davinciucberkeley-collab/DillonVTOL/cad/README.md

# CAD and simulation

Everything here is generated from `analysis/results.json` and `cad/hardware.json`. After changing the sizing or the hardware spec, re-run the build and the CAD follows. Nothing is modelled by hand.

## Files

| File | Purpose |
|---|---|
| `params.mjs` | Converts the sizing results and `hardware.json` into build parameters, fastener definitions, the fastener schedule, every component placement (position + rotation matrix) and the exploded layout → `params.txt` |
| `hardware.json` | Machine-readable twin of `docs/research/hardware-spec.md`: fasteners, nuts, washers, inserts, fits, general tolerances (same IDs as the spec and the drawings) |
| `BuildVtol.cs` | SOLIDWORKS API builder: 75 unique part files (`verification.txt` 2026-11-01), the 397-component `VTOL_Concept.SLDASM` (STEP, EASM), `VTOL_Exploded.SLDASM`, interference detection and mass roll-up → `verification.txt` |
| `build.ps1` | Runs `params.mjs`, then compiles and runs the builder, mesh export, drawings and renders (needs SOLIDWORKS 2025 + .NET Framework 4 `csc`) |
| `Drawings.cs` | Builds drawing DBF-DRW-001 rev G (nine ANSI B sheets, see below) with driven dimensions, tolerances and fits from `params.txt` (note text included: every size that follows the sizing is read from `params.txt`); zoned layout with a self-check of overlaps (`drawings/layout-check.txt`); exports `.SLDDRW`, a vector PDF and sheet PNGs to `drawings/`. `Drawings.exe model drawings params.txt 2,3` builds only the listed sheets as `probe_*` files for layout iteration |
| `Shared.cs` | Compiled into `BuildVtol.exe`, `Drawings.exe`, `Sim.exe` and `Thermal.exe`: `ParamsFile`, the one C# reader of `params.txt`, and `Geom`, the one C# implementation of the NACA 4-digit section and the pod profile (constants read back from `params.txt`, see "Single sources" below) |
| `SharedTest.cs` | Parity test of `Shared.cs` against the inline code it replaced (bit-exact sections, pod radii and parsed parameters; no SOLIDWORKS). `build.ps1` compiles and runs it before every build; by hand: `csc /nologo /out:%TEMP%\SharedTest.exe cad\Shared.cs cad\SharedTest.cs && %TEMP%\SharedTest.exe cad\params.txt` |
| `ExportMesh.cs` | Exports each part as a binary STL (metres, part frame) plus colour and description → `mesh/`; `review/mesh.mjs` packs them (one pre-rotated mesh per part orientation) for the interactive viewer in the review page |
| `Snap.cs` | Saves iso/top/side/front PNGs of the assembly → `images/` |
| `BuildFigs.cs` | Step figures for the build manual: per figure in `docs/build/figs.txt`, shows the parts a step fits (orange, with their fasteners in blue) among the parts already built, renders and crops → `docs/build/img/*.jpg` (assembly closed unsaved) |
| `Sim.cs` | SOLIDWORKS Simulation studies → `sim/results.txt`, plots, and `sim/*.SLDPRT` with the studies saved inside (re-run 2026-11-02 on the 2026-11-01 sizing, see below) |
| `ListDocs.cs` | Lists open SOLIDWORKS documents; `ListDocs.exe close` closes files under this folder, `close untitled` also discards unsaved new documents |
| `Inspect.cs` | Lists a part's feature tree, bodies, volume and box (debugging aid) |
| `TlbImp.cs`, `Probe.cs` | Tools used to inspect the Flow Simulation API and add-in availability |
| `model/` | Generated parts, `VTOL_Concept.SLDASM`, `.STEP`, `.EASM`, `VTOL_Exploded.SLDASM` |
| `verification.txt` | Interference report, component counts, cosmetic-thread count, mass roll-up (generated by each build) |

## Model content (CAD built 2026-11-01 21:38 from the 2026-11-01 sizing, `verification.txt`; hardware spec of 2026-10-21 with the 2026-11-01 BOM changes)

- **Sizing inputs (aero):** `analysis/sizing.mjs` uses the aerodynamic build-up in `analysis/aero/aero_results.json`: CL_max 1.115 (critical-section, trimmed; `analysis/results.json` base.CLmax, aero_results CL_max_3D.adopted), clean CD0 0.0266 (faired legs, base.CD0_clean), rotor-unit CdA 0.00222 m² (C0 params.CdA_rotor), boom CdA 0.00171 m² (base.CdA_boom) and a pod neutral-point shift of −4.93 % MAC (aero_results neutral_point.pod_shift_pct_MAC). Result (`analysis/results.json` generated 2026-11-01, C0 sized; sizing calibrated to the CAD mass roll-up): MTOW 7.44 kg (sized.m 7.4380), wing 0.774 m² (chord 322.3 mm, AR 7.45), hover 1132 W / 51.0 A, cruise at 18 m/s 296 W by the sizing (sized.P_cruise) and 258 W by the aero build-up (aero_results drag.cruise.P_elec_W), 12.0 min of cruise available (sized.t_cruise_avail_min), static margin 10.2 % by the sizing (NP 38.2 % MAC, cg.pct.np) and 10.4 % by AVL with the pod (NP 38.40 % MAC, aero_results neutral_point) at the 28 % MAC CG. **No payload and no ballast** (DESIGN-BASIS R12, revised 2026-11-01): the lengthened pod nose (`params.txt` fusL 1.000, podProfile noseX 0.6) puts the CG at 28 % MAC with the battery at x = +0.255 m (cg.xb 0.2550, `params.txt` battX); battery ± 30 mm gives 26.97–29.03 % MAC (cg.pctFwd / pctAft). History: rev D (2026-10-25) was chord 284.2 mm, MTOW 6.55 kg with a 0.5 kg ballast rule; rev C was chord 266.6 mm, MTOW 6.45 kg. GA sheet note 4 (`Drawings.cs`) prints the no-payload, no-ballast rule (R12); the title block reads rev F, 2026-11-03 (`Drawings.cs` REV, DATE).
- **Wing:** NACA 2415 panels, chord from the sizing. A 26 % chord aileron (2 % hinge gap) runs along the outer 55 % of span. The 25.4 mm spar socket sits 0.8 m deep in a Ø26.0 hot-wired channel at 30 % chord (FT05 hole, `params.txt` sparChanD; bonded). Pockets are cut for every bonded hardpoint: spar collar (front clamp inserts), rear hardpoint plate (80 % chord), aileron servo tray, root tongue, and (left) the pitot clamp; the ailerons carry a horn-hardpoint pocket.
- **Wing root and joiner:** the saddle carries the root section across the pod and has two 6 mm side tabs screwed to the pod (4 × M3 × 12 into inserts). The 0.76 m joiner is a **slip fit** in the saddle and the sockets (FT01/FT06): it slides out so the pod transport piece stays inside the R4 envelope, and with both panels bolted on it is captured between two printed stop discs bonded 300 mm inside the sockets. Each panel is held by one M5 × 25 button screw (F09; `params.txt` wingBoltL 0.025; DESIGN-BASIS rev 2026-11-01) through a printed bolt pillar in the saddle and a root tongue bonded into the panel, into an M5 nylock (J10). The pillar is the full section height at 70 % chord (29.5 mm, `params.txt` pillarH); `params.mjs` searches the ISO 7380 M5 length and the head spot-face depth so that the screw end stands 3.5 mm past the nylock with the nut pocket at or below the tongue-slot floor: spot-face Ø10.3 × 2.0 (pillarSpot), pocket 8.2 AF × 11.0 from the lower surface (pillarNutDepth) under an 11.3 mm slot floor (pillarSlotFloor); screw end 2.5 mm inside the lower surface *(calc: 29.5 − 2.0 − 25)*.
- **Tail:** NACA 0009 stabiliser seated on the tail-clamp tops (span = boom spacing + 50 mm to cover the fin-shoe flanges), separate 30 % chord elevator (4 mm from each fin), lofted fins (65 % tip chord) **with 30 % chord rudders** hinged with the same 2 % gap as the ailerons (BOM servos S5/S6; rudder sizing follows the elevator and aileron chord ratios, hardware-spec.md C6). Fins sit in printed root shoes whose flanges are screwed through crush sleeves in the stabiliser into the tail clamps (J09): four screws remove the tail.
- **Booms:** 6061-T6 1.000 × 0.035 in front booms (1046.0 mm, `params.txt` segF; `verification.txt` 2026-11-02 09:52 prints the same 1046.0) butt against the rear stubs (485.9 mm) at the rear motor centre, inside the rear motor mount, over a printed splice plug with two M3 × 40 cross-bolts (J04). The front and rear lengths are generated by `analysis/sizing.mjs geometry()` (no overlap).
- **Printed clamps (all 46 mm wide, bore 25.6, 1.2 mm split gap):** motor mounts (PA6-CF) split into an upper half with the 4.5 mm motor floor and a lower cap, so the motor screws go in from inside the bore; front and rear boom clamps (lower halves bolt through the upper halves into the wing hardpoint inserts); gear clamps with a blind leg socket and a leg cross-bolt; tail clamps. Every counterbore, insert hole and nut pocket is at the spec's size.
- **Propulsion:** X4110S motors with their real bolt patterns (base 4 × M3 on Ø25, max depth 3.3; hub 4 × M3 on Ø12), lift props with 4 mm bore and 2 × 3.2 holes on 12 mm, prop holding plates, the pusher's bolt-on M6 adapter, prop washer and bullet nut; PA6-CF pusher cup in the pod tail ring with four radial screws. The spinner of rev A is gone (the bullet nut is the real part).
- **Controls:** five EMAX ES3005HV servos on one printed L-tray design (aileron servos in wing pockets, elevator and rudder servos on the stabiliser top), kit nylon horns with backplates or bonded hardpoints, and 2-56 pushrods cut to the CAD lengths (ailerons 56 mm, elevator 56 mm, rudders 88 mm; `params.txt` rodAileron 56.0 / rodElevator 55.6 / rodRudder 88.4). Since 2026-11-03 the left rudder servo sits 19 mm (2 × shaft offset) aft of the right one so both rudder rods are the same 88.4 mm part (the right rod used to be built at the left rod's 107 mm and ran past its horn pin), and each clevis fork is turned to straddle its horn (`params.mjs` alongX).
- **Gear:** four 205 mm legs in the gear-clamp sockets with dome feet, each with a printed 3:1 teardrop fairing (chord 81.6, 170 mm long, vase-mode wall, taped at the clamp; aero drag build-up; `params.txt` fairChord / fairLen). Pusher prop ground clearance 44.8 mm (`verification.txt`).
- **Pod:** solid foam body 1.000 × 0.160 m (`params.txt` fusL, fusR; nose at x +0.60, lengthened 0.15 m in the 2026-11-01 iteration so the CG reaches 28 % MAC without ballast, DESIGN-BASIS rev 2026-11-01) with the wing-root slot, battery bay and tray, avionics bay with the FC tray and the CoreWing envelope, canopy pocket with a 2 mm hatch flange (2 screws) and front tongue, and the tail ring bore.
- **Disc clearance:** rear lift discs clear the pusher disc by 106.1 mm (`params.txt` discClear; `verification.txt` prints 105.0 mm from the parameters before the 22:15 update); `params.mjs` throws below 20 mm.

## Fastener modelling

Every screw, nut, washer and heat-set insert in `hardware.json` is a part generated at the vendor's maximum dimensions (`params.mjs` `fast=` lines → `BuildVtol.FastenerPart`): ISO 4762 socket heads with hex sockets, ISO 7380 button heads, the kit's M2 × 14 pan heads (head EST), DIN 985 nylocks (hex + collar), DIN 934 M2 nuts, DIN 125 washers, ruthex RX-M3x5.7 inserts (knurl shown as two bands), the motor-supplied M3 × 8 adapter screws (F13, length EST) and the M6 bullet nut. Each instance is placed at its joint by a rigid transform (rows of the 3 × 3 matrix in the `comp=` line are the images of the part axes), with holes in the parent parts at the spec's clearance/insert diameters (printed model value = ISO 273 normal + 0.2). Cosmetic threads (InsertCosmeticThread3) are on the shank of every screw, the bores of the nuts and the insert and the M6 adapter (17 of the 18 fastener part files; the washer has none). Two spec values changed because the model showed they cannot be built: F05 is M3 × 30 (its nut and head must clear the leg tube in the gear clamp) and the motor counterbores are Ø7.5 (the Ø7.0 washer does not fit Ø6.5); both are recorded in `hardware.json` and in the spec's CAD implementation notes. Counts per aircraft: 139 screws (F01 20, F02 36, F03 16, F04 8, F05 4, F06 4, F07 11, F08 4, F09 2, F10 20, F11 10, F13 4), 40 nuts (N01 8, N02 2, N03 30, N04 1), 28 washers, 67 inserts — the same as hardware-spec.md §6. Heat-set inserts sit in Ø4.0 holes with their 4.6 OD, so interference detection reports them as intended press fits (FT08); they are listed separately in `verification.txt`. Last run (`verification.txt`, 2026-11-03 14:38; rev G adds the battery access well, a 225 mm battery bay for the ± 30 mm CG slide, a 220 mm tray and moves the FC tray to x +0.4075, `docs/research/team-crosscheck.md` X1): 397 components, 263 interferences of which 189 are the insert press fits (1.42 cm³) and 74 are model artefacts totalling 244.0 mm³ (horn screws and backplates through surfaces drilled on assembly, nylock-pocket corners, screw tips, foam pockets cut to fit, numerical slivers on coincident faces; the largest is 18.3 mm³, Elevator × F11 horn screw). The 31 unexplained clashes of 2026-11-02 (393 mm³: canopy × pod, rudder clevis × horn, spar tube × foam, clamp × spar collar) were fixed on 2026-11-03: pod hatch slots lengthened to the canopy's 30 mm flange and tongue and the canopy dome made a true half-ellipse; rudder clevis and servo as in Controls; the spar channel cut at FT05 Ø26.0; component positions written at 6 decimals and the clamp tops taken from the rounded params so bonded faces coincide (`analysis/validation/checks_struct.json` MFG-INTF). One cut warning remains (tail ring radial hole bottom removed nothing). History: 2026-11-01 304 interferences (115 others, 0.65 cm³). Modelled mass 6.683 kg including the 0.82 kg pack (fasteners 229.1 g, printed parts 1418.6 g, tubes 1692.2 g, foam 1221.6 g without skins, vendor masses 2122.0 g) against the sizing MTOW 7.44 kg (`analysis/results.json` 2026-11-01 sized.m; the 7.408 kg printed in `verification.txt` is from an earlier sizing pass), which also carries wiring, ESCs, skins and avionics; there is no payload allowance (R12).

Mass: `verification.txt` rolls up every part as volume × density (6061 from the SOLIDWORKS library; A2 stainless, brass, PETG, PA6-CF and nylon densities EST; XPS 32 kg/m³ from the sizing) or the vendor mass (motors, battery, servos, props, FC). `analysis/sizing.mjs` does not track fastener mass as an item (it sits inside the clamp and mount allowances), so the fastener total is reported there for the team rather than added to the MTOW.

## Drawing set DBF-DRW-001 rev G (`drawings/`)

| Sheet | Content |
|---|---|
| 1 | General arrangement (1:20, isometric 1:30): span, length, height, boom pitch, motor spacing, prop diameters; revision table (A–F), breakdown and ground-clearance notes (note 4: no payload, no ballast, R12) |
| 2 | Exploded assembly (`VTOL_Exploded.SLDASM`, 1:20) with 24 balloons, one per major part type in two tidy columns; item numbers are those of sheet 3 (fasteners and small hardpoints are not ballooned) |
| 3 | Parts list: parts-only SOLIDWORKS BOM (75 items, fasteners one line per type with quantities) in three columns, 2.5 mm text, descriptions shortened to the first clause |
| 4 | Wing panel, saddle and wing-bolt pillar: spar socket, joiner bore with the FT06 slip-fit tolerance, M5 hole and nut pocket |
| 5 | Motor mount upper half and cap, splice plug: bore 25.6 ±0.2, floor 4.50 ±0.15, Ø25 pattern position Ø0.2, counterbores, insert holes, splice bolts |
| 6 | Boom clamps, gear clamp and tail clamp halves (six section + side pairs, front/rear boom lower on one pair) with hole callouts |
| 7 | Tube cut list with ISO 2768-m tolerances and cross-hole positions, landing leg, leg fairing, and the gear-clamp leg socket (FT03) with the F05 cross-bolt |
| 8 | Fastener schedule (ID, standard, size, qty, order, joints, torque, threadlocker, vendor) and torque / threadlocker / insert notes |
| 9 | Printed hardpoints and trays: fin shoe, spar collar, rear hardpoint, pusher cup, servo tray, root tongue |

Every sheet carries a general-tolerance table (bottom left) from `hardware.json general_tolerances` (printed parts ±0.5 % min ±0.5; controlled bores and insert holes per the fit table; hole position Ø0.4, motor pattern Ø0.2; cut tubes ISO 2768-m), a numbered notes block (2.5 mm text), and the release note with the current revision (first-article checks M1–M7 of the hardware spec apply). Rev C (2026-10-23) corrected the layout and ballooning of rev B: fixed view zones per sheet, dimensions stacked outside the geometry 8 mm apart with hole callouts as separate notes beyond the dimension (no extension line through text), view titles under the last dimension row, title-block text at 2.0 mm, nothing over the title block; `layout-check.txt` logs every registered item and any overlap. Rev D (2026-10-25) follows the R11 wing re-size (chord 266.6, S 0.640 m²) and reads every sizing-dependent size from `params.txt`, including the note text (aileron span, spar socket, boom station, root thickness, bolt-pillar bore and pitch, nut-pocket depth, joiner length and stop station, tube cut lengths and stock use, fairing chord and length, gear socket and leg cross-hole stations, fin-shoe floor and walls). Rev E (2026-10-25) follows the 11.75 m/s design-stall re-size (chord 284.2, S 0.682 m²; CAD rev D): the bolt-pillar spot-face depth is now read from `params.txt` (pillarSpot), sheet 4 views moved for the larger chord (saddle section 5 mm left and 7 mm down, bolt pillar 5 mm down, inside the border), the spar-station label moved onto the dimension value line and the aileron-span text moved off the spar-socket extension line (`Dim(..., along)`). Rev F (2026-11-03): the CAD clash fixes above (spar channel now dimensioned Ø26.0 ±0.5 FT05 on the root section), a hot-wired foam row in the general-tolerance table (±0.5 EST, `hardware.json` general_tolerances.hot_wired_foam; six rows at 2.2 mm text), joiner-bore coaxiality Ø0.4 to the spar sockets (sheet 4 note 7, EST from the FT01 + FT06 nominal clearances), front boom ±1.2 (ISO 2768-m over 1000 mm), and the 23 layout overlaps cleared (sheet 1 revision table and side elevation moved; sheet 4 sections at 1:2.5 and saddle plan at 1:10; sheet 7 landing leg at 1:5 above the gear socket; sheet 9 fin shoe at 1:2): `layout-check.txt` reports 0.

## Simulations (`sim/results.txt`)

| Study | Model | Result vs hand calc |
|---|---|---|
| Boom static | Arm 488.0 mm cantilevered at the spar clamp, tip block = lift-unit mass 0.3255 kg, full thrust 30.7 N | 38.6 MPa (1.5 mm mesh; 35.4 at the standard mesh) vs 37.0 MPa hand (+4.5 %); 3.16 vs 3.35 mm (−5.8 %); RF 7.8 on yield |
| Boom modal | Same, first bending mode | 27.73 vs 25.85 Hz (+7.2 %; hand includes 0.236 m_boom; rigid root) |
| Spar + joiner static | Half-span, fixed at the centreline, joiner idealised with OD = socket ID, 189.6 N uniform load scaled to the Schrenk root moment 91.0 N·m at 4.5 g (`params.txt` feaWingForce = feaRootMomentTarget / 0.48 m; rev 2026-11-02, was the elliptic 83.6 N·m) | 191.2 MPa (2 mm mesh; 181.2 at the standard mesh) vs 194.7 MPa hand (−1.8 %); tip 28.7 mm; FEA RF 1.52, the hand calc on the true joiner governs (RF 1.41 = 275 / 194.7) |
| Motor thermal | Steady state, 56.6 W heat (EST, `params.txt` thermQ), h = 44.6 W/m²K (EST, thermH), **35 °C ambient** (the `Sim.cs` input, `params.txt` thermAmbK 308.15 K, not the 25 °C design ambient of DESIGN-BASIS R21) | `motor_T_steady` 185.7 vs 185.1 °C hand: a steady-state upper bound that a 60–90 s hover never reaches. The design-ambient transients are in `sim/thermal/results.txt` (2026-11-02, 25 °C): lift motor 59 °C after 60 s hover, 73 °C after 90 s, mission peak 75 °C (limit 80 °C EST) |

Last run: `sim/results.txt` generated 2026-11-02 13:19 (`Sim.exe params.txt sim`) on the 2026-11-02 inputs in `params.txt` (MTOW 7.44 kg; boom arm 488.0 mm, tip force 30.7 N, tip mass 0.3255 kg, `analysis/results.json` C0 struct.Lb / Tmax / mTip; root moment 91.0 N·m Schrenk, struct.Mroot; heat 56.6 W, thermQ). Every geometric and load input is read from `params.txt`; the studies build their own simplified parts and do not open `model/`. Every FEA–hand pair above is within 15 % (largest: boom f1 +7.2 % *(calc from `sim/results.txt`)*; `analysis/verify.py` not re-run for this note, —). History: the 2026-11-02 01:10 run (elliptic root moment 83.6 N·m) gave spar 175.5 MPa, tip 26.3 mm; the 2026-10-25 run (CAD rev D, MTOW 6.55 kg, arm 462.0 mm) gave boom 36.8 MPa, f1 34.4 Hz, spar 155 MPa, motor 143.9 °C.

**Not run:**
- **Transient thermal in `Sim.cs`.** The transient studies now run in `Thermal.cs` (`sim/thermal/results.txt`, 2026-11-02: 18 saved steps; motor-only 90 s 88.4 °C FEA vs 88.2 °C lumped at the `Sim.cs` 35 °C inputs; lift unit, pod and pusher at the 25 °C design ambient).
- **Flow Simulation (CFD).** The add-in would not load on this licence (only the base SOLIDWORKS serial is listed).

Material for all structural studies: SOLIDWORKS library `6061-T6 (SS)` (E 69 GPa, yield 275 MPa). Results are from the SOLIDWORKS Educational edition, and the plots carry its watermark.

## Single sources (code review 2026-10-25, "one geometry described in several places")

The wing/tail section family and the fuselage-pod profile used to be re-typed in six places (two different trailing-edge coefficients, `cad/params.mjs`, `BuildVtol.cs`, `Drawings.cs`, `analysis/aero/common.py`, `docs/build/templates/make_templates.py`) and `params.txt` was parsed by six different readers. They are now defined once and read through one module per language; the refactor changed no output (all regenerated outputs byte-identical, see `SharedTest.cs` and the parity notes in `analysis/README.md`).

| What | Single source | Readers |
|---|---|---|
| Section family: NACA 24xx camber (`m` 0.02, `p` 0.4; `t` = sizing `tc`), NACA 0009 tail, TE coefficients `teCad` −0.1015 / `teAero` −0.1036, pod profile (`noseX` 0.6, `L` 1.0, `R` 0.08, `tailR` 0.03, `noseA` 0.22, `parallelTo` 0.65; `params.txt` podProfile, fusL) and the reference formulas | `analysis/geometry.mjs` (a leaf module: imported by `analysis/sizing.mjs`, `analysis/tradestudy.mjs` and `cad/params.mjs`; the sizing never reads `params.txt`, which is generated from it) | — |
| The same constants as data | `params.txt` keys `foilWing`, `foilTail`, `foilTE`, `podProfile` (text records `label\|name=value...`, written by `params.mjs`; `fusL`, `fusR`, `tailR`, `tc` stay numeric keys) | `analysis/geom.py` (Python: `read_params`, `naca4_surfaces`/`naca4_outline`, `pod_radius`; used by `analysis/aero/common.py` and so every aero script, and by `make_templates.py`), `cad/Shared.cs` (C#: `ParamsFile.Load`, `Geom.WingSection`/`TailSection`/`Naca`/`NacaYt`/`NacaYc`/`PodRadius`; used by `BuildVtol.cs`, `Drawings.cs`, `Sim.cs`, `Thermal.cs`) |
| `params.txt` parsing rules | documented in `analysis/geom.py` and `cad/Shared.cs` (trim; blank lines ignored; a line without `=` or a repeated key is an error; `comp=`/`xcomp=` are records, everything else a scalar) | the two readers above; `review/build.mjs` keeps its own numeric-only reader and skips the text records |

**Trailing edge.** Two coefficients remain in use on purpose: the CAD, drawings and `params.txt` stations use the original open-TE polynomial (−0.1015, TE thickness 0.0021 c = 0.7 mm at the 322.3 mm chord *(calc)* — the better model of a hot-wired XPS core with a tape skin), while the aero package (SU2 meshes, NeuralFoil) and the hot-wire templates use the closed-TE value (−0.1036; a closed contour for meshing and a clean wire exit). Forward of 70 % chord the two differ by < 0.05 mm. Unifying them would change either the CAD coordinates or the aero/template outputs, so both are named at the single source (`FOIL.teCad`, `FOIL.teAero`) and the choice per consumer is explicit. Recommendation for the next template revision: move `make_templates.py` onto `teCad` so the templates match the drawn section (changes the SVG/CSV by ≤ 0.7 mm at the TE only).

`Sim.cs` and `Thermal.cs` are built by hand with `Shared.cs` on the command line, e.g. `csc /nologo /platform:x64 /out:cad\Sim.exe /r:"<redist>\SolidWorks.Interop.sldworks.dll" /r:"<redist>\SolidWorks.Interop.swconst.dll" /r:cad\SolidWorks.Interop.cosworks.dll cad\Sim.cs cad\Shared.cs`.
