davinciucberkeley-collab/DillonVTOL/analysis/aero/plots/aircraft_polar.png

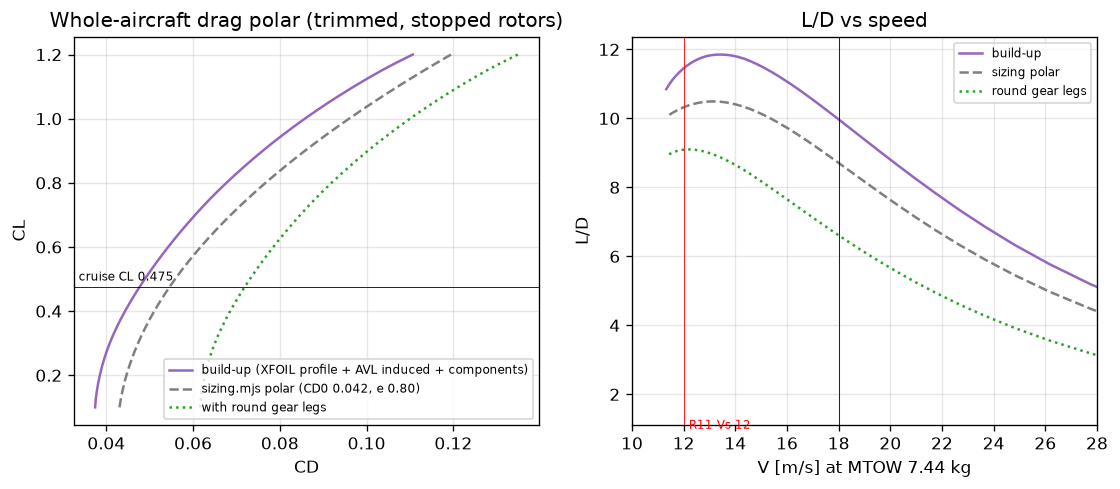
analysis/aero/plots/aircraft_polar.png
