davinciucberkeley-collab/DillonVTOL/analysis/aero/plots/cg_np.png

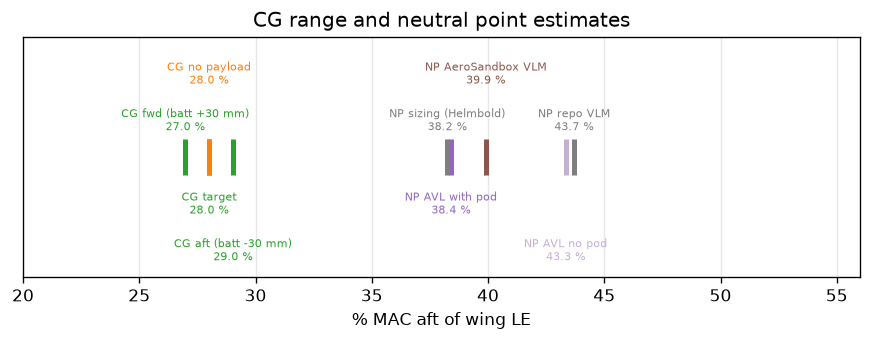
analysis/aero/plots/cg_np.png
