davinciucberkeley-collab/DillonVTOL/analysis/aero/plots/cp_distributions.png

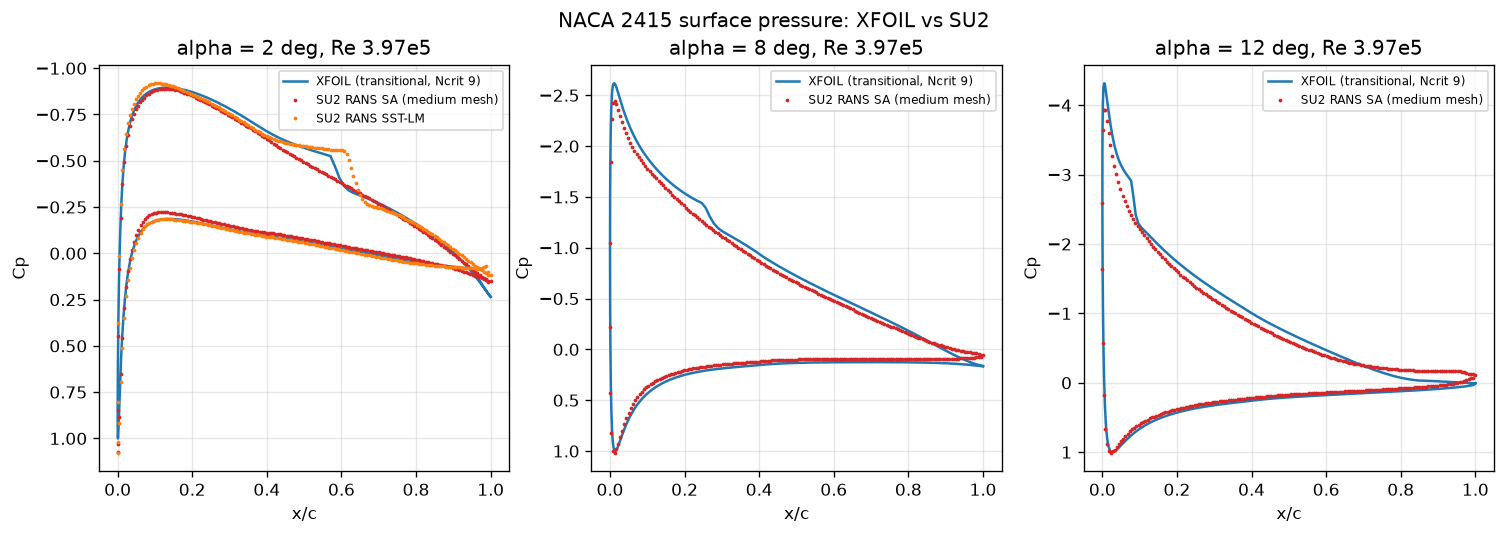
analysis/aero/plots/cp_distributions.png
