davinciucberkeley-collab/DillonVTOL/analysis/aero/plots/drag_breakdown.png

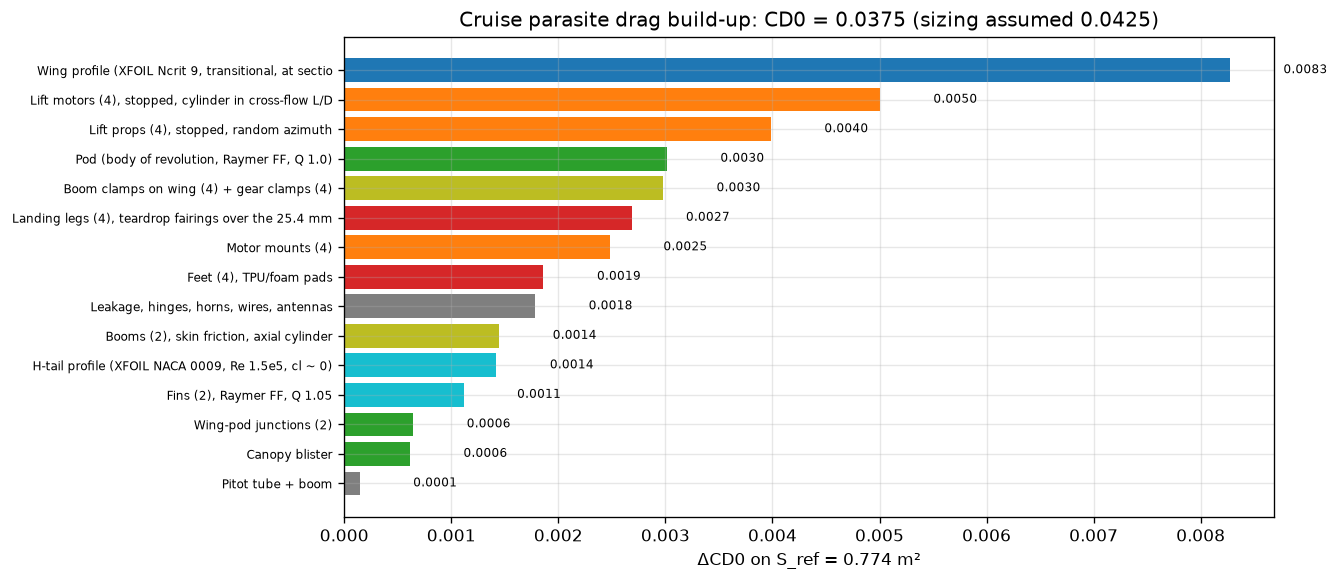
analysis/aero/plots/drag_breakdown.png
