davinciucberkeley-collab/DillonVTOL/analysis/aero/plots/drag_pie.png

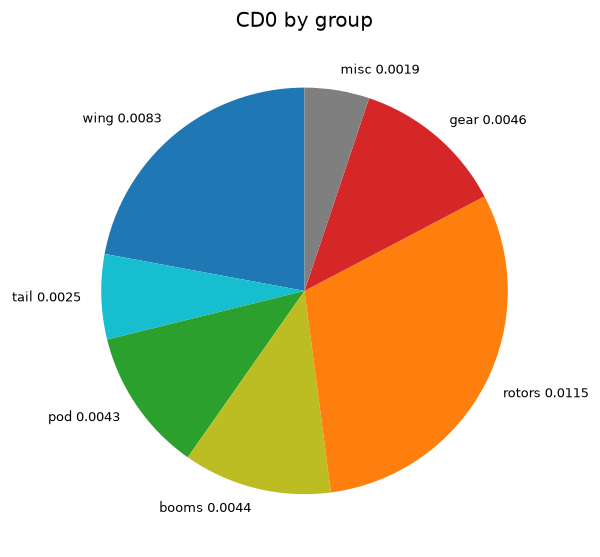
analysis/aero/plots/drag_pie.png
