davinciucberkeley-collab/DillonVTOL/analysis/aero/plots/flow_0.png

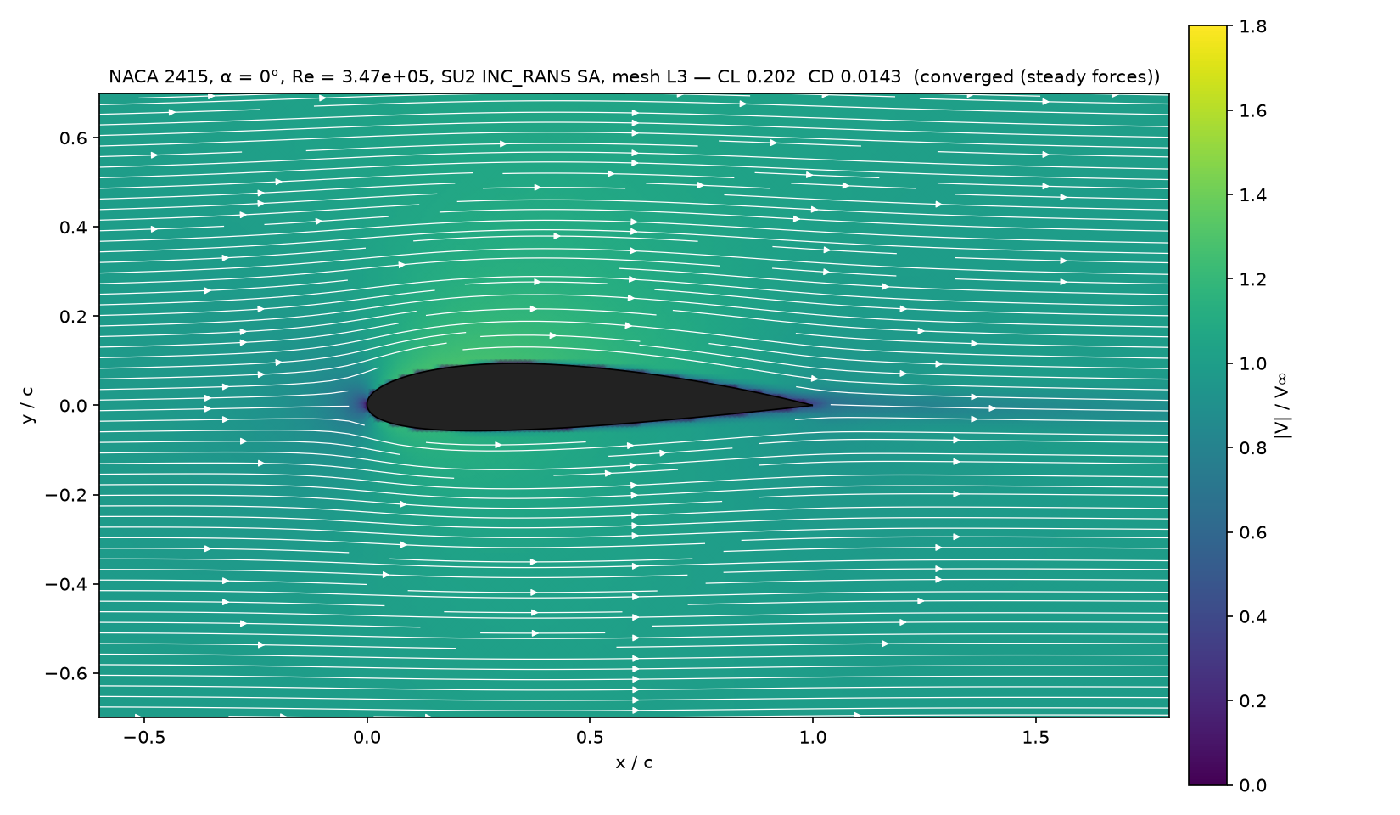
analysis/aero/plots/flow_0.png
