davinciucberkeley-collab/DillonVTOL/analysis/aero/plots/flow_3d.png

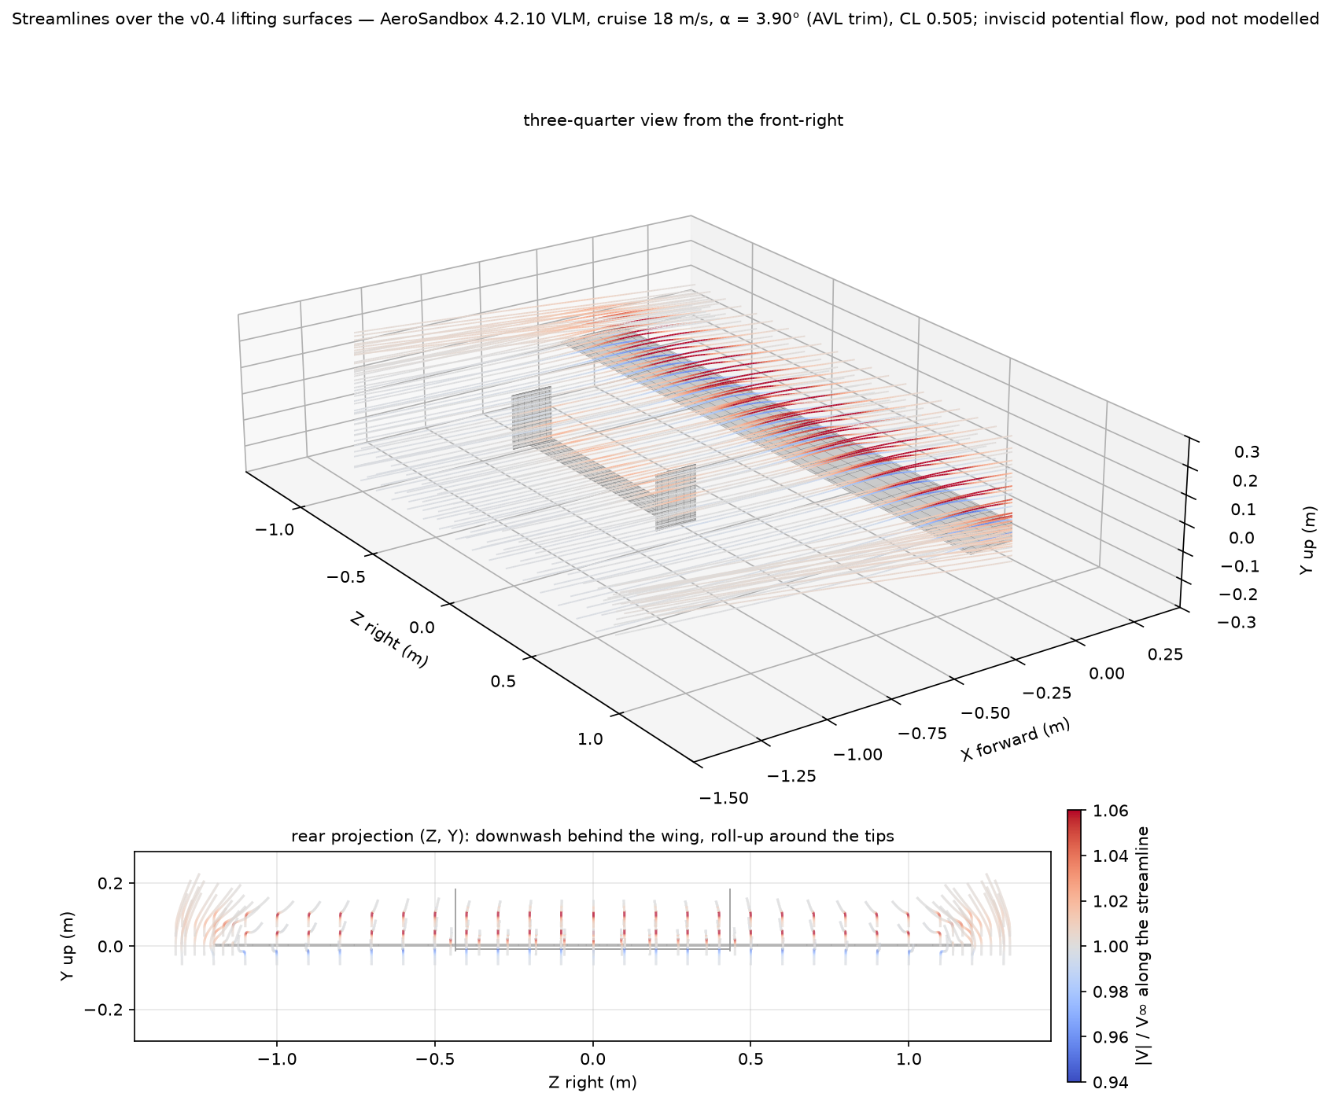
analysis/aero/plots/flow_3d.png
