davinciucberkeley-collab/DillonVTOL/analysis/aero/plots/flow_8.png

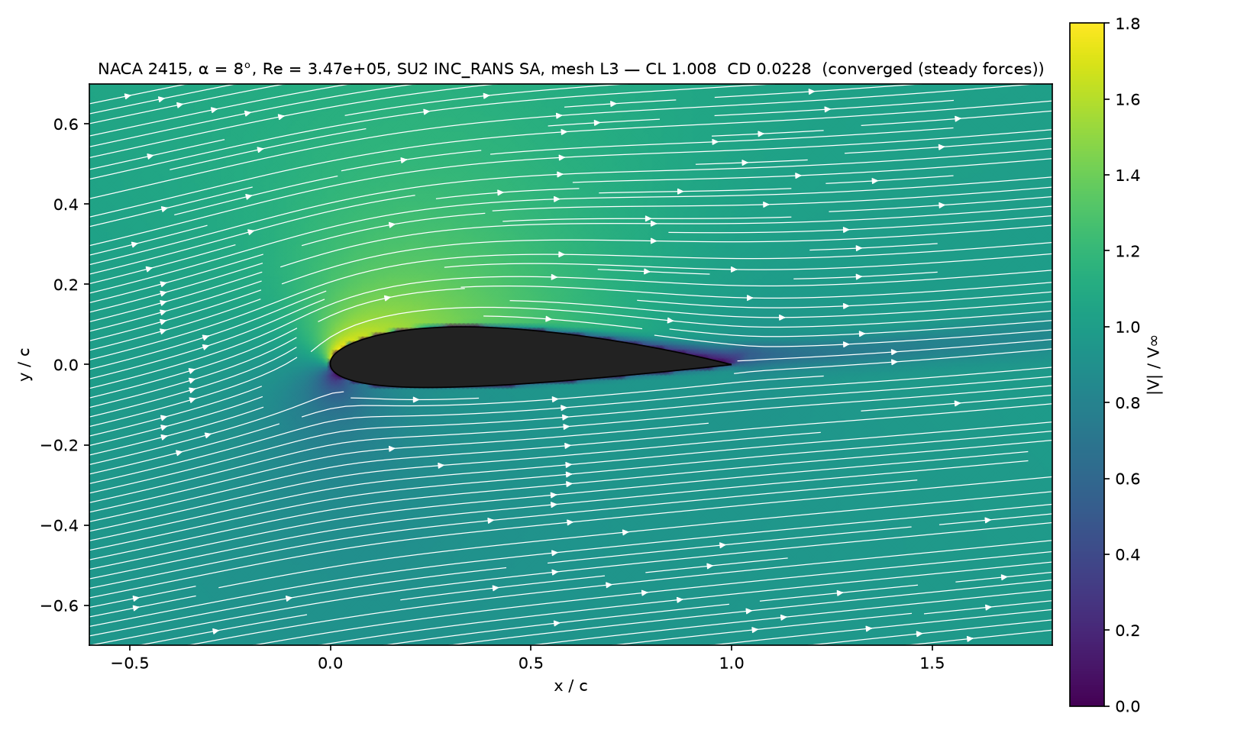
analysis/aero/plots/flow_8.png
