davinciucberkeley-collab/DillonVTOL/analysis/aero/plots/flow_15.png

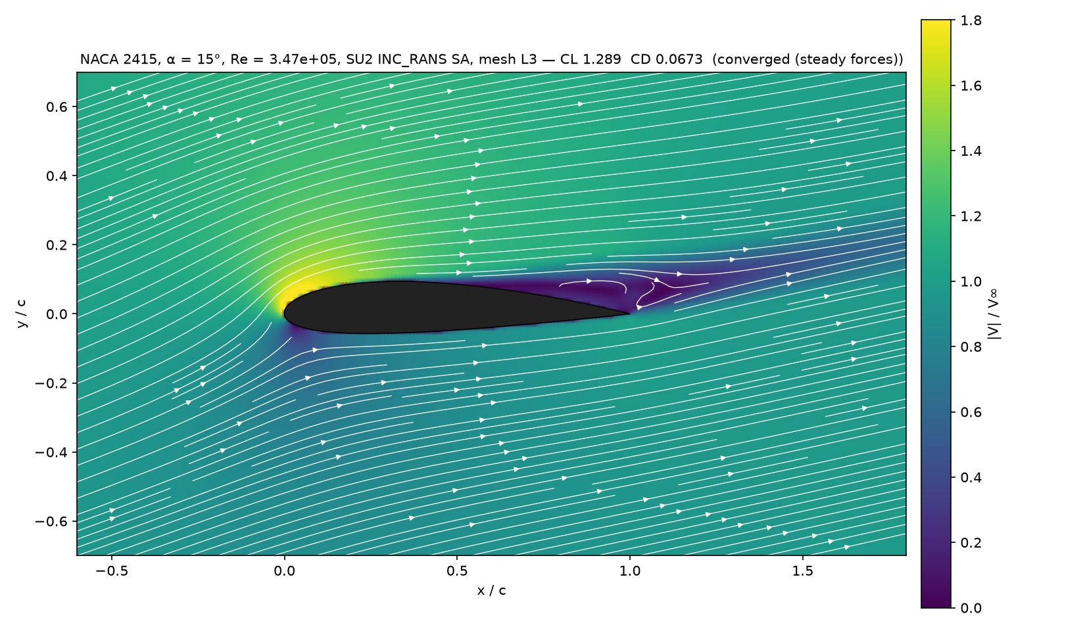
analysis/aero/plots/flow_15.png
