davinciucberkeley-collab/DillonVTOL/analysis/aero/plots/flow_cp_8.png

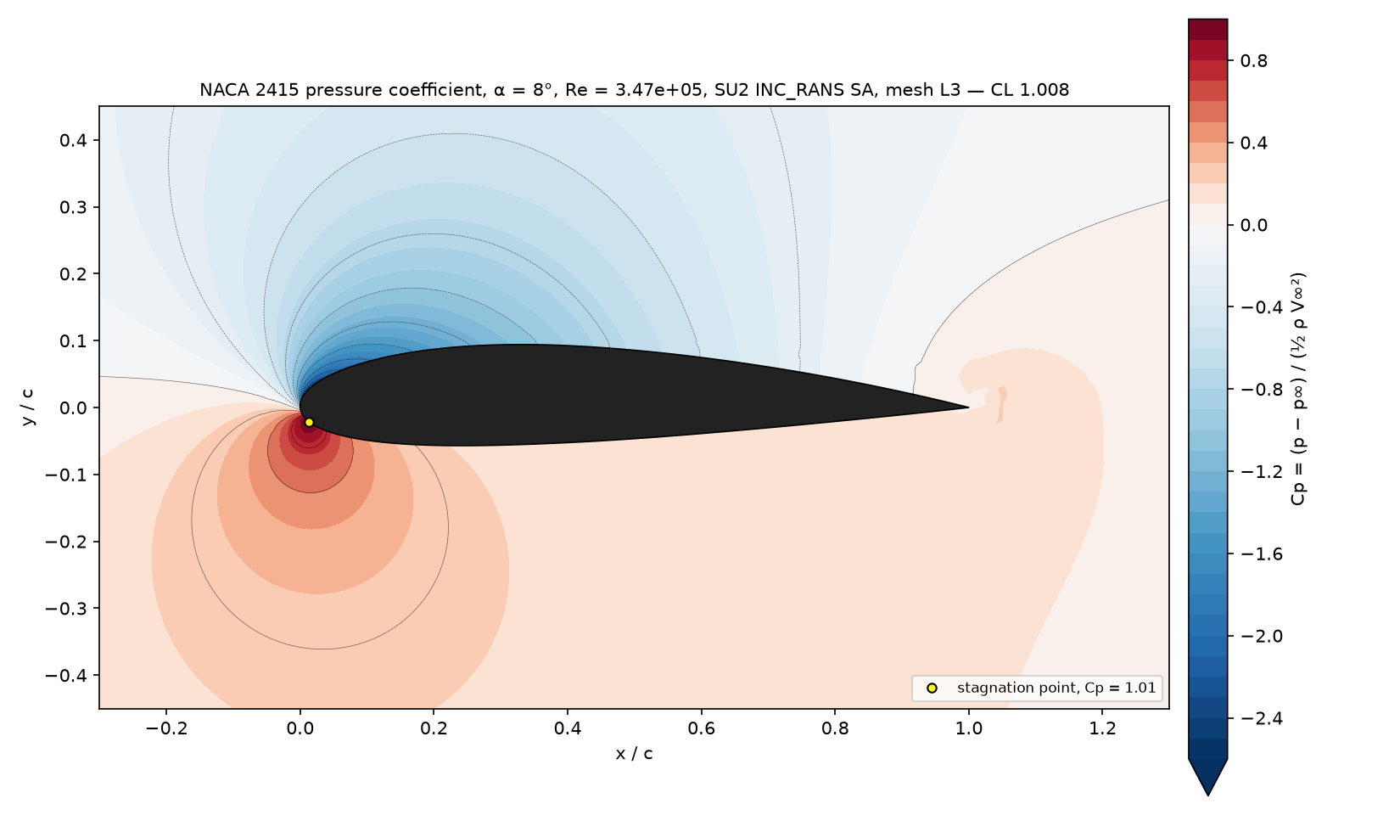
analysis/aero/plots/flow_cp_8.png
