davinciucberkeley-collab/DillonVTOL/analysis/aero/plots/section_polars.png

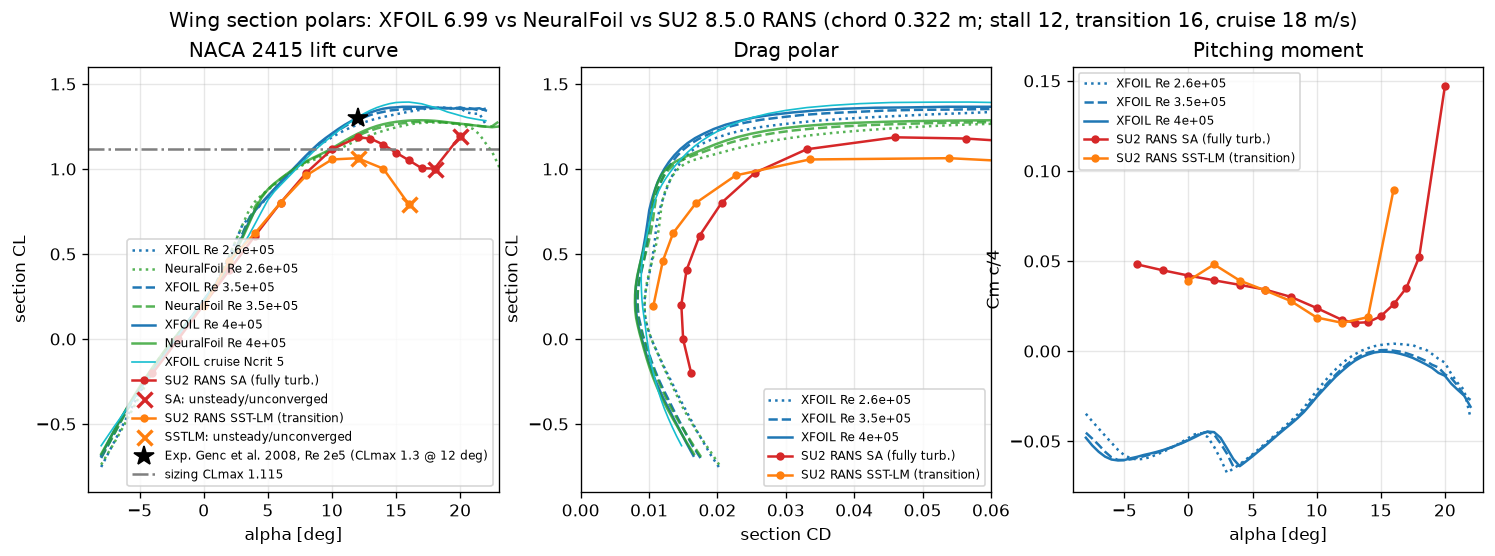
analysis/aero/plots/section_polars.png
