davinciucberkeley-collab/DillonVTOL/analysis/aero/plots/span_loading.png

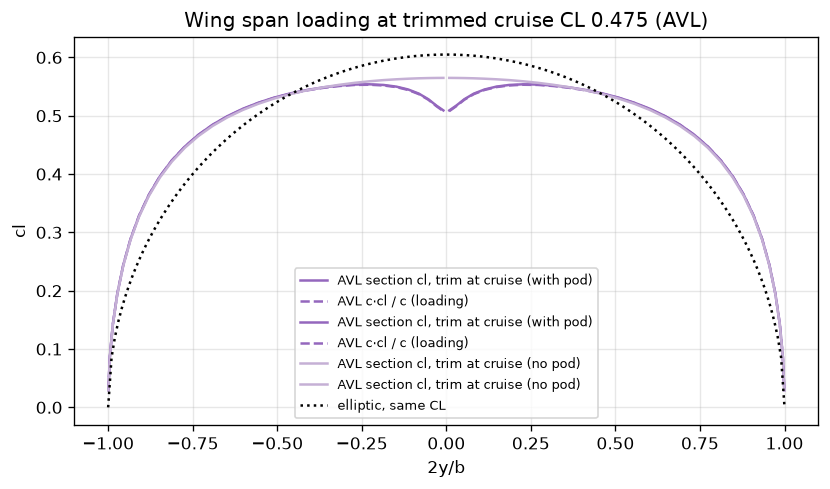
analysis/aero/plots/span_loading.png
