davinciucberkeley-collab/DillonVTOL/analysis/aero/plots/stability.png

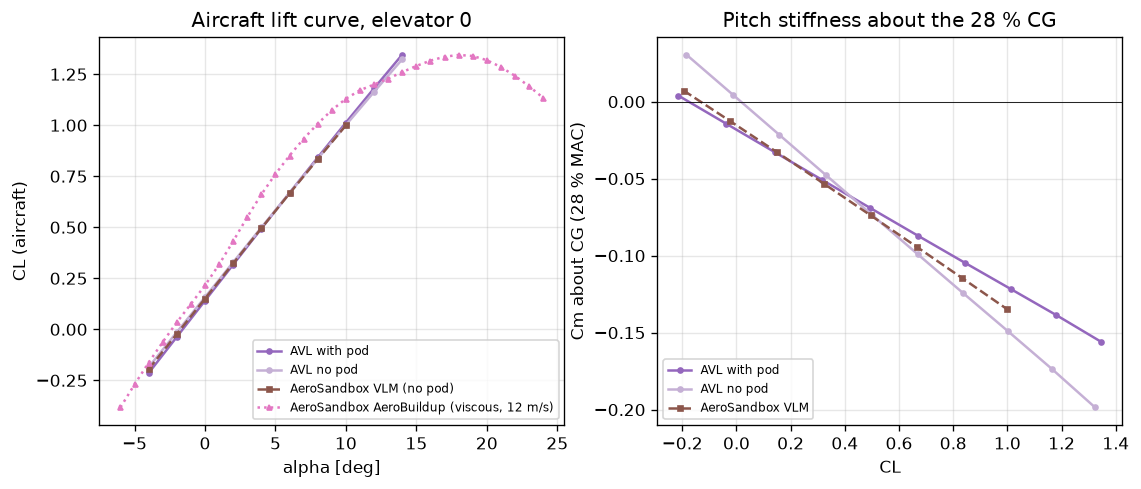
analysis/aero/plots/stability.png
