davinciucberkeley-collab/DillonVTOL/analysis/aero/plots/su2_convergence.png

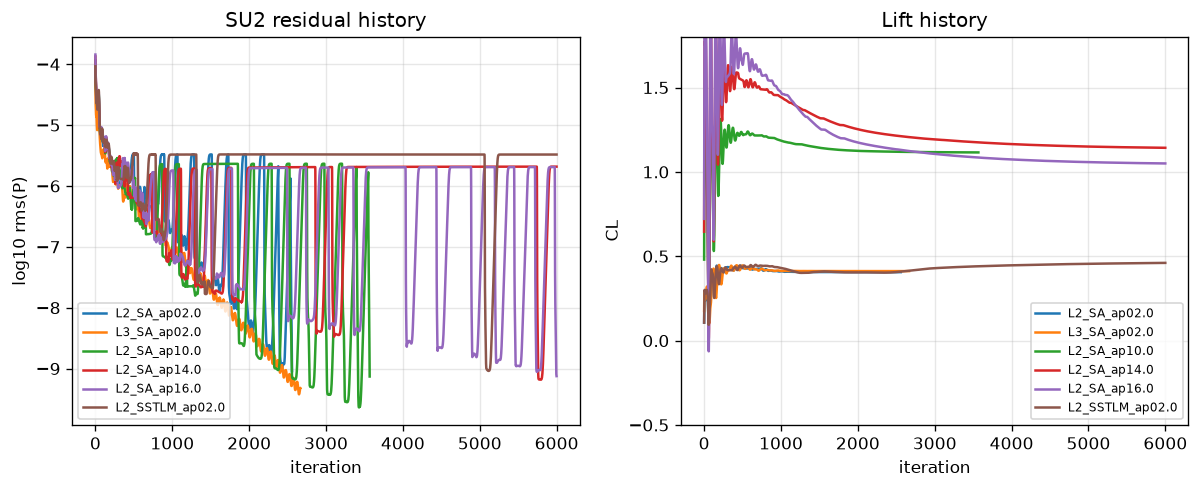
analysis/aero/plots/su2_convergence.png
