davinciucberkeley-collab/DillonVTOL/analysis/thermal/img/lift_unit_mission.png

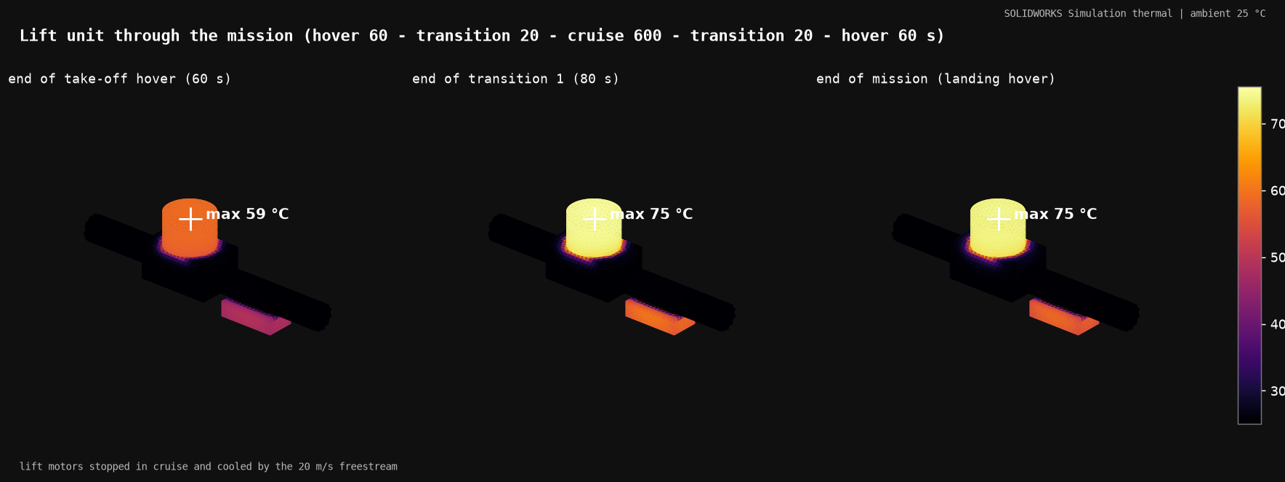
analysis/thermal/img/lift_unit_mission.png
