davinciucberkeley-collab/DillonVTOL/analysis/thermal/img/lift_unit_steady.png

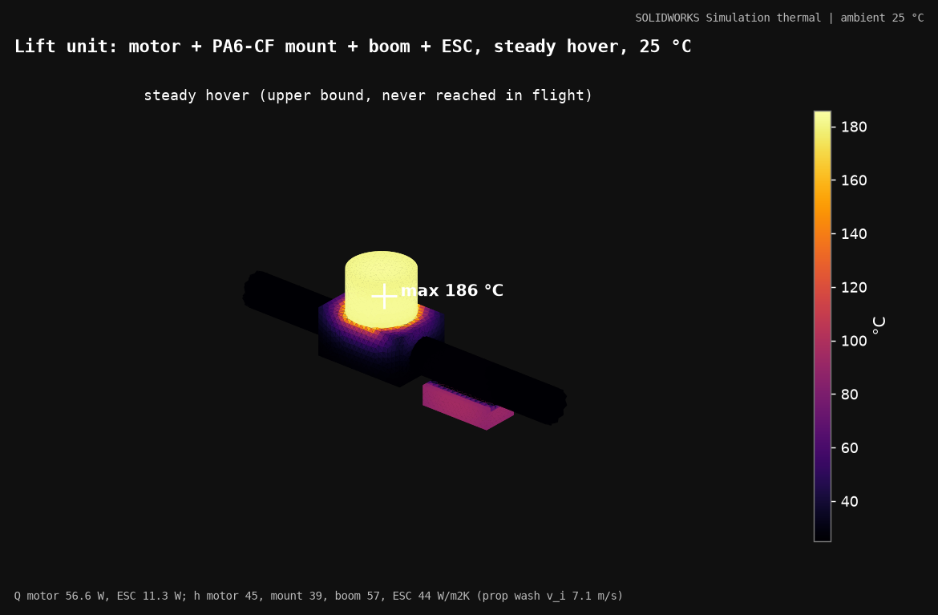
analysis/thermal/img/lift_unit_steady.png
