davinciucberkeley-collab/DillonVTOL/analysis/thermal/img/pod_end_cruise.png

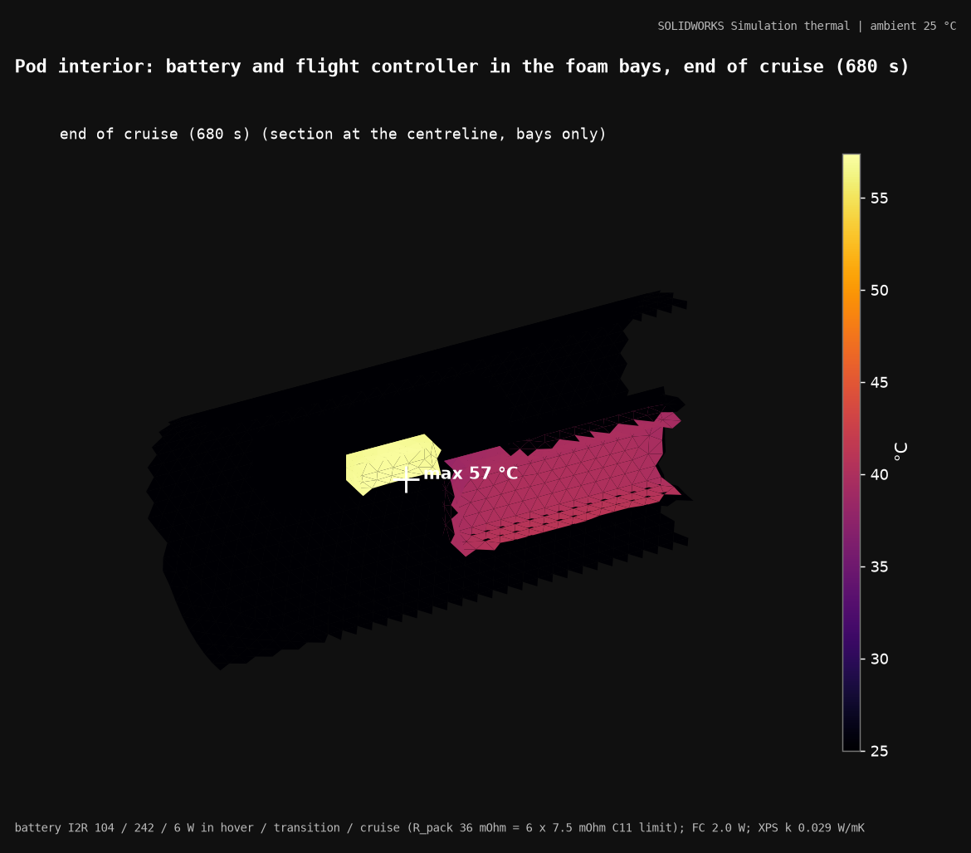
analysis/thermal/img/pod_end_cruise.png
