davinciucberkeley-collab/DillonVTOL/analysis/thermal/img/pusher_cruise.png

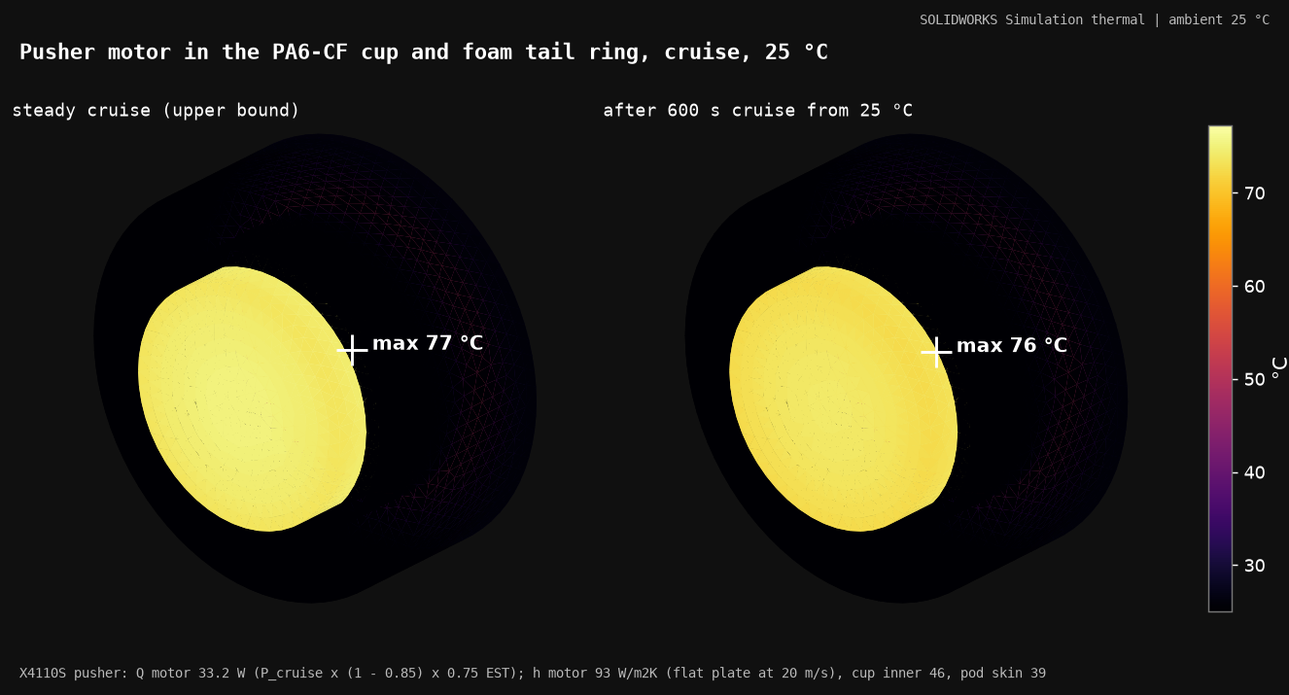
analysis/thermal/img/pusher_cruise.png
