davinciucberkeley-collab/DillonVTOL/cad/drawings/DBF-DRW-001_sheet3.png

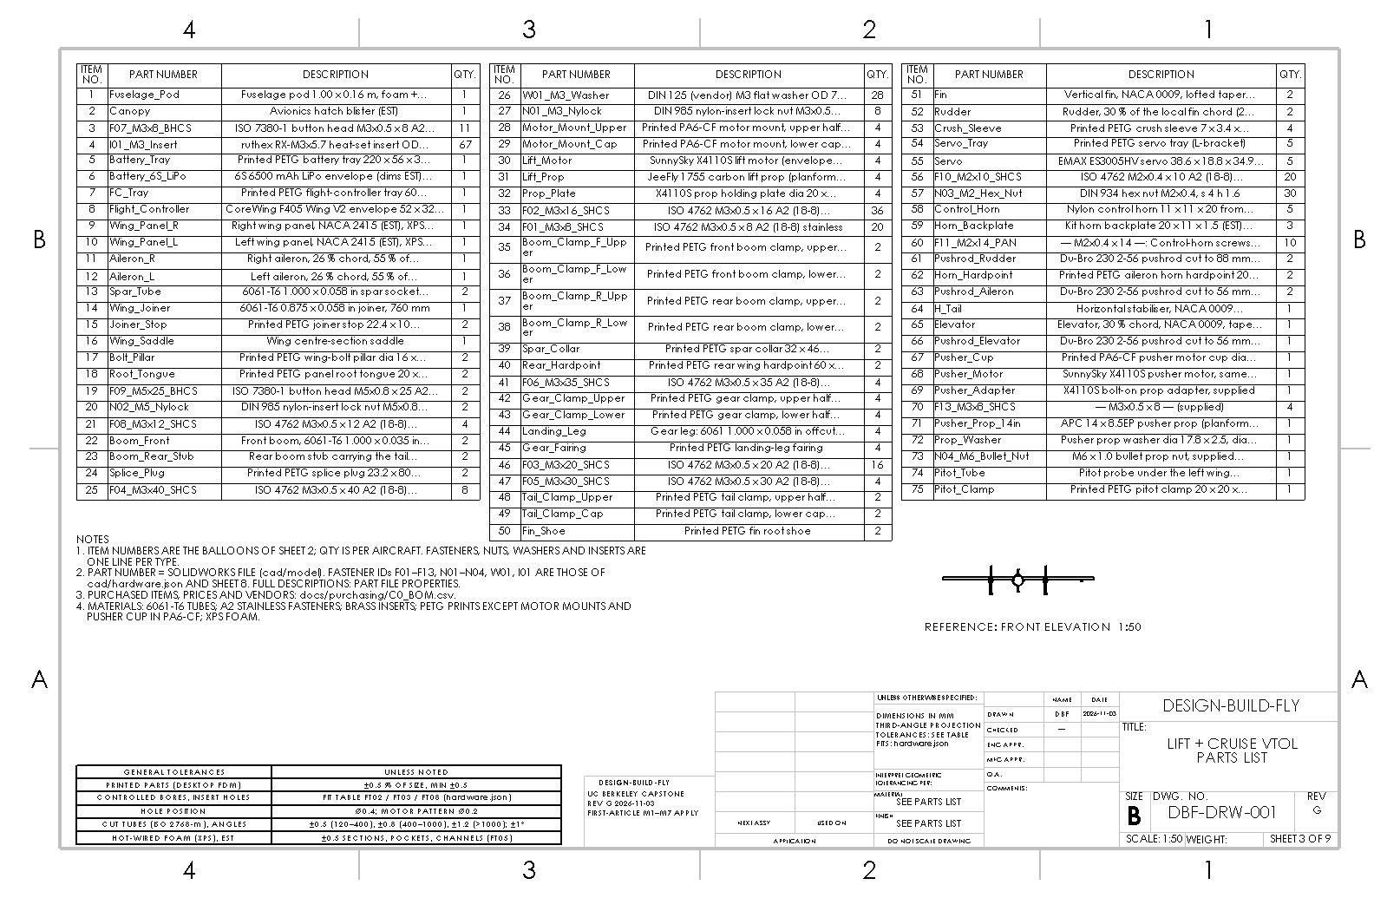
cad/drawings/DBF-DRW-001_sheet3.png
