davinciucberkeley-collab/DillonVTOL/cad/drawings/DBF-DRW-001_sheet9.png

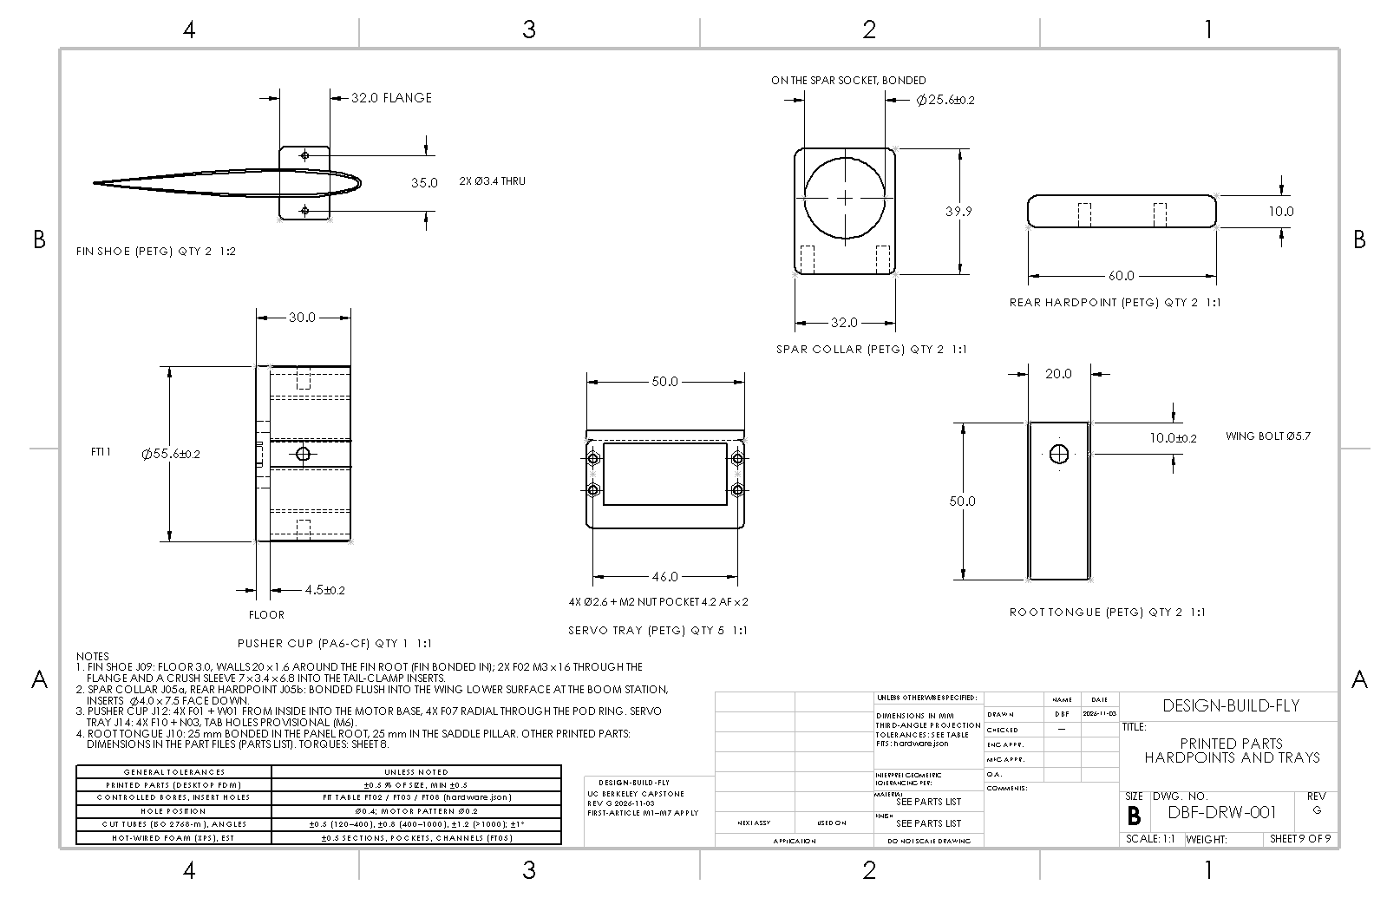
cad/drawings/DBF-DRW-001_sheet9.png
