davinciucberkeley-collab/DillonVTOL/cad/images/VTOL_Concept_front.png

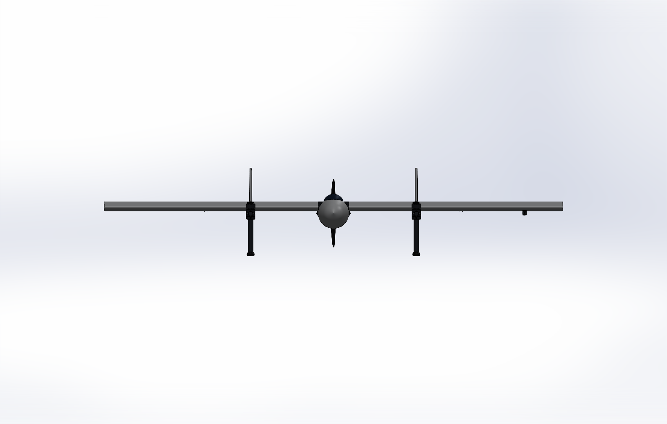
cad/images/VTOL_Concept_front.png
