davinciucberkeley-collab/DillonVTOL/cad/images/VTOL_Concept_iso.png

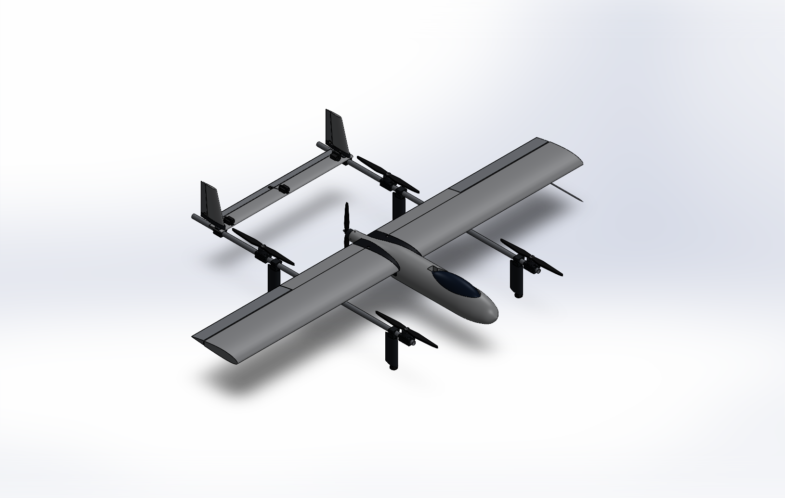
cad/images/VTOL_Concept_iso.png
