davinciucberkeley-collab/DillonVTOL/cad/images/VTOL_Concept_side.png

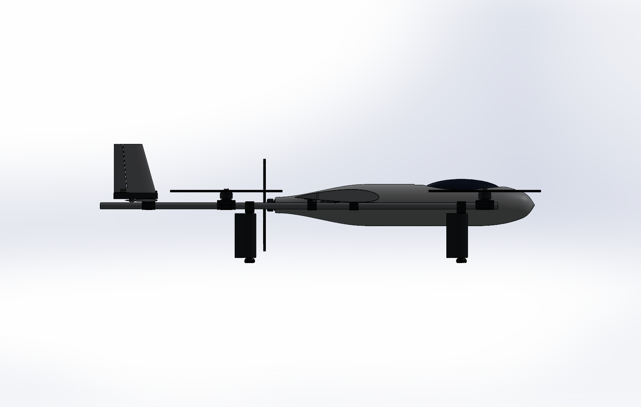
cad/images/VTOL_Concept_side.png
