davinciucberkeley-collab/DillonVTOL/cad/images/VTOL_Concept_top.png

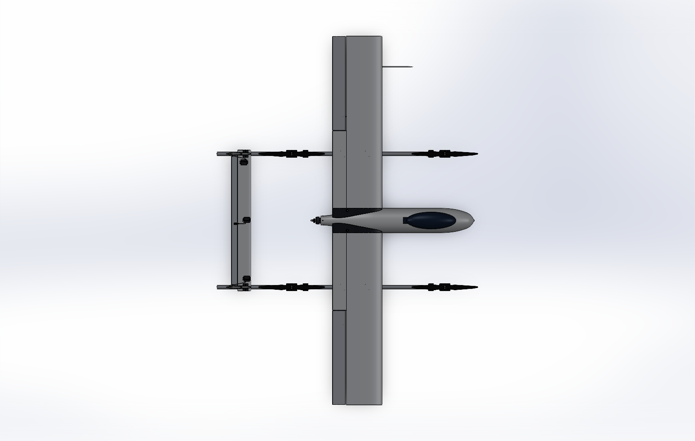
cad/images/VTOL_Concept_top.png
