davinciucberkeley-collab/DillonVTOL/cad/sim/FEA_Boom_vonMises.png

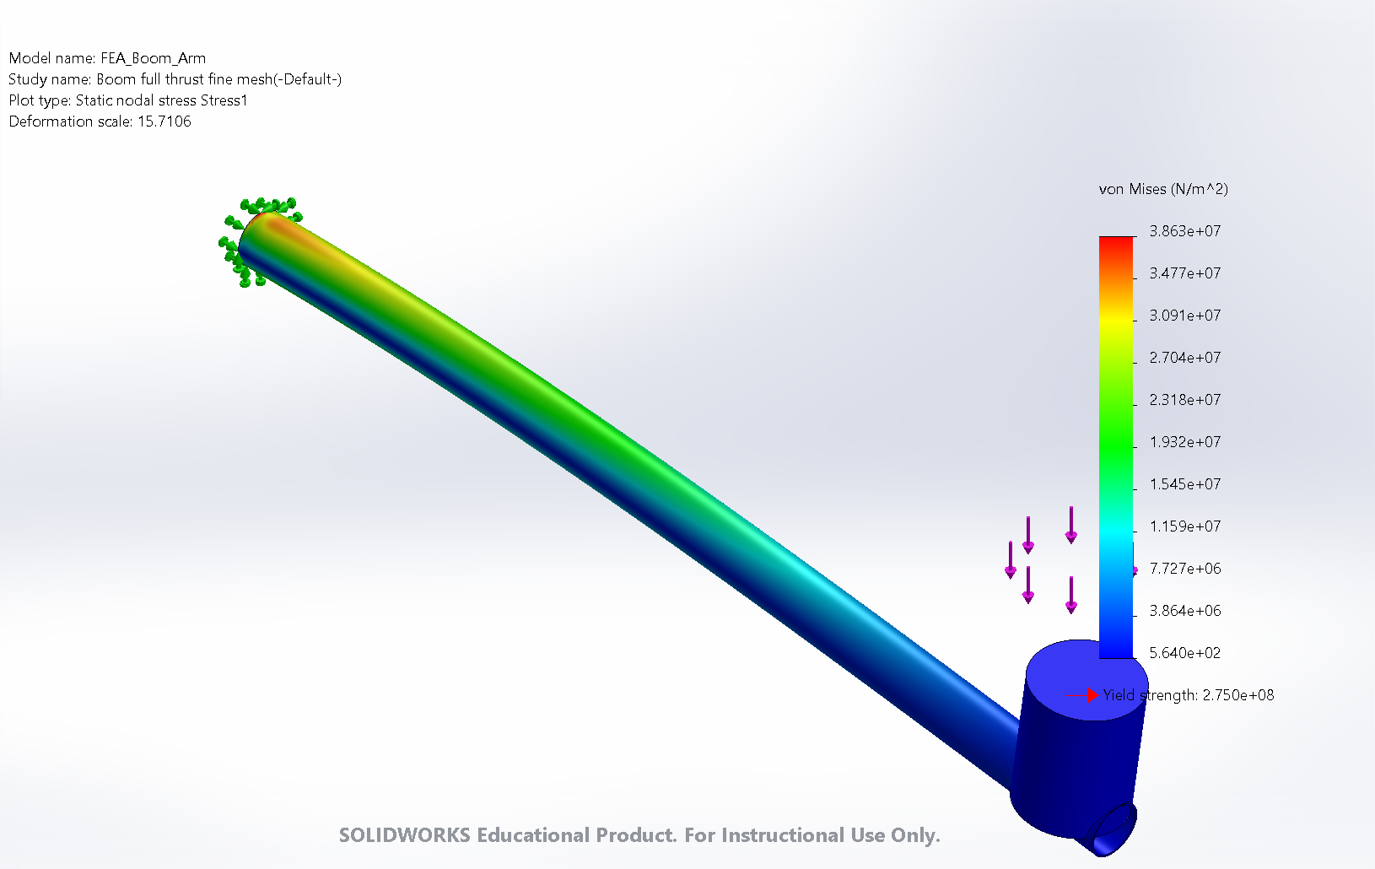
cad/sim/FEA_Boom_vonMises.png
