davinciucberkeley-collab/DillonVTOL/cad/sim/FEA_Spar_vonMises.png

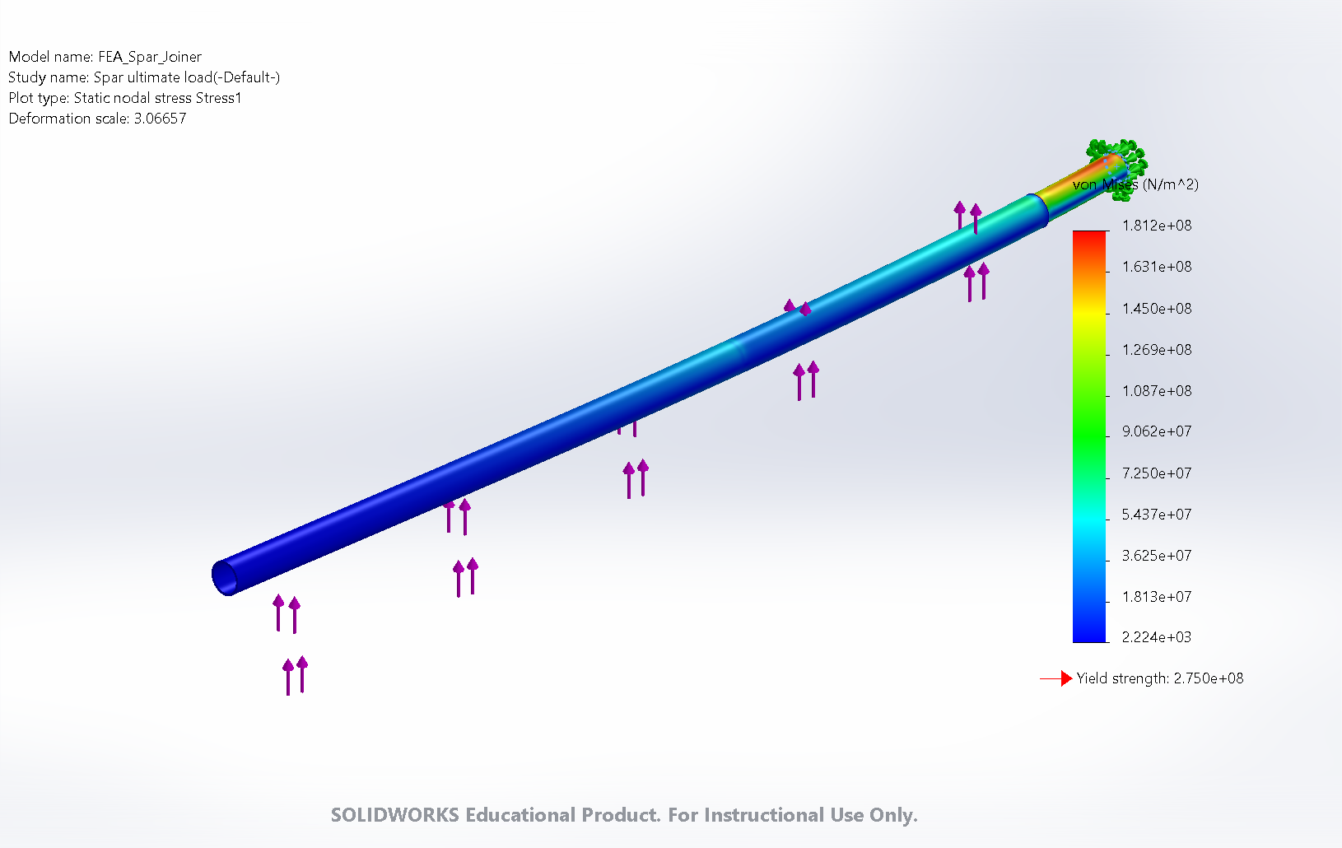
cad/sim/FEA_Spar_vonMises.png
