davinciucberkeley-collab/DillonVTOL/cad/sim/THERM_Motor_steady.png

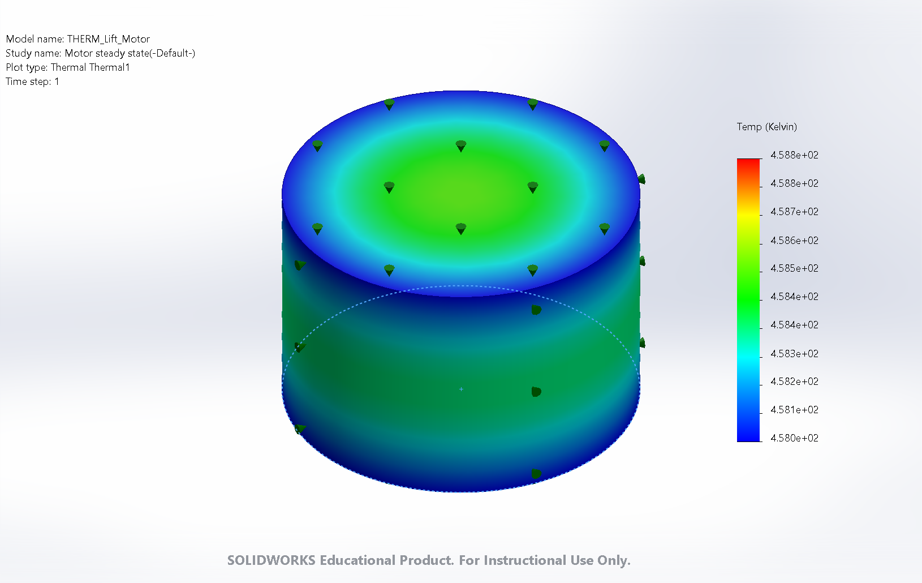
cad/sim/THERM_Motor_steady.png
