davinciucberkeley-collab/DillonVTOL/cad/sim/thermal/THERM_Lift_Unit_steady.png

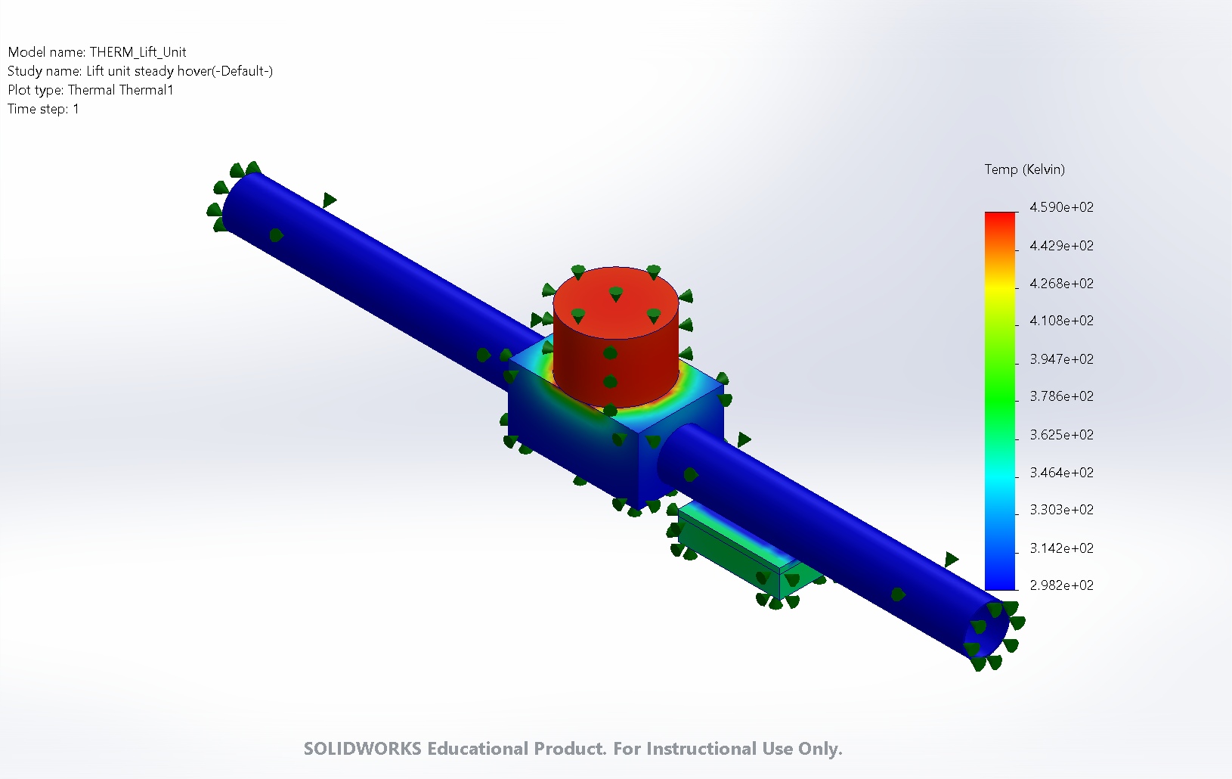
cad/sim/thermal/THERM_Lift_Unit_steady.png
