davinciucberkeley-collab/DillonVTOL/cad/sim/thermal/THERM_Pod_mission.png

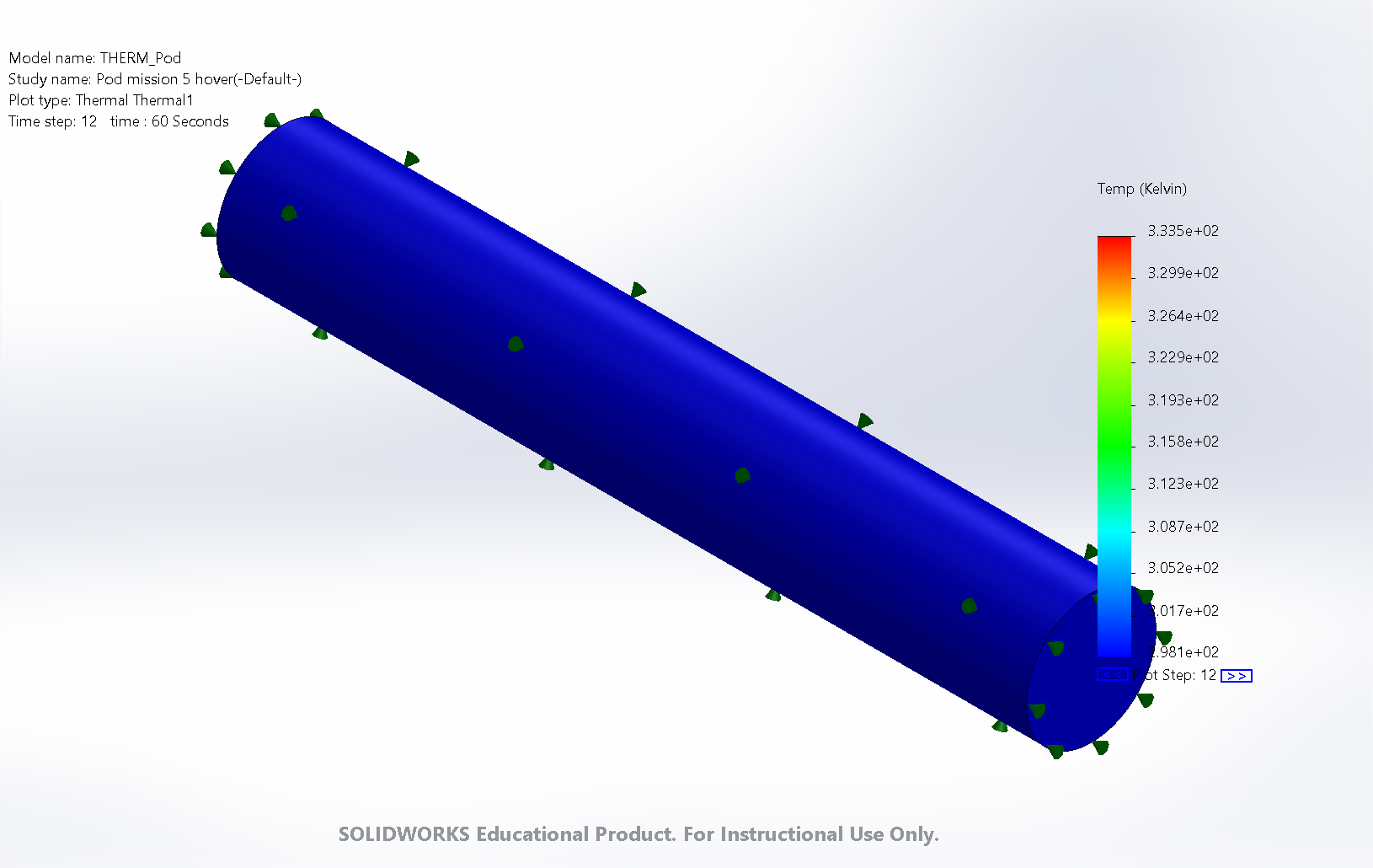
cad/sim/thermal/THERM_Pod_mission.png
