davinciucberkeley-collab/DillonVTOL/cad/sim/thermal/THERM_Pusher_steady.png

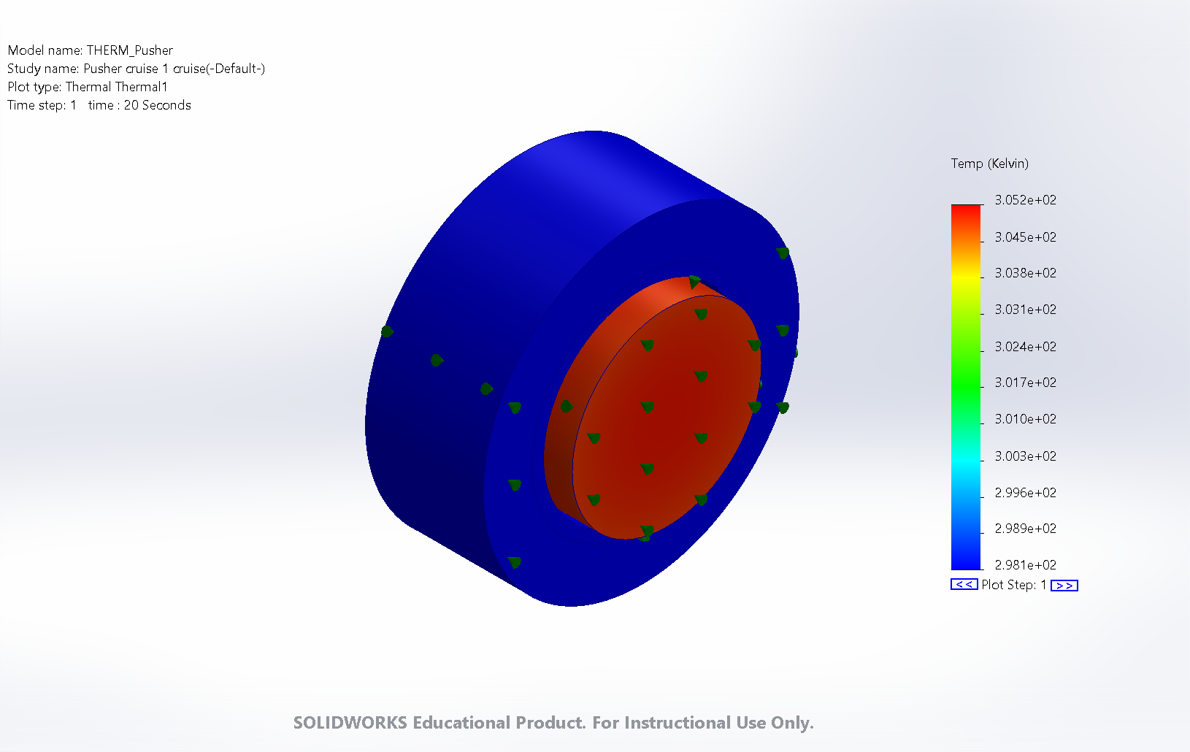
cad/sim/thermal/THERM_Pusher_steady.png
