davinciucberkeley-collab/DillonVTOL/docs/purchasing/C0_BOM.csv

Vendor | Category | Item | Qty | Unit USD | Ext USD | Source (research file §) | Note | Ordered (Y/N) | Order date | Actual USD
— | Airframe | Amass AS150U connector set (1 male + 1 female), Neu Racing | 2 | 17.26 | 34.52 | neuracing.us/product/as150u (checked 2026-11-01) | aircraft male + 2 pack females; anti-spark contact to be confirmed on receipt (M-item)
— | Airframe | Polymaker PA6-CF20 500 g (motor mounts: HDT 173 °C) | 1 | 39.99 | 39.99 | AM §2d | PETG too close to motor heat (sec. 12)
— | Avionics | CoreWing F405 Wing APP V2, unsoldered pins (12 out, 90 A sensor, 8 A servo BEC) | 1 | 67.18 | 67.18 | ReadyMadeRC one order (free shipping under the 5 % rule; docs/research/bom-savings.md consolidation, checked 2026-11-01) | same board as the soldered version (unavailable): output map unchanged; backorder Nov 2026; in-stock fallback Holybro Kakute H743-Wing $107.42 (remap)
— | Avionics | RMRC GPS + compass SAM-M10Q-5883 | 1 | 24.99 | 24.99 | ReadyMadeRC one order (free shipping under the 5 % rule; docs/research/bom-savings.md consolidation, checked 2026-11-01) | u-blox M10 + 5883 compass, replaces the HGLRC M100 to keep one order
— | Avionics | NewBeeDrone BeeID v1.1 Remote ID (FAA DoC RID000001995) | 1 | 39.99 | 39.99 | ReadyMadeRC one order (free shipping under the 5 % rule; docs/research/bom-savings.md consolidation, checked 2026-11-01) | out of stock at RaceDayQuads; only 2 left at RMRC
— | Avionics | RadioMaster Pocket Crush ELRS | 1 | 76.99 | 76.99 | ReadyMadeRC one order (free shipping under the 5 % rule; docs/research/bom-savings.md consolidation, checked 2026-11-01) | US stock instead of radiomasterrc.com (CN, $30 shipping)
— | Avionics | RadioMaster RP3 V2 ELRS receiver | 1 | 22.96 | 22.96 | ReadyMadeRC one order (free shipping under the 5 % rule; docs/research/bom-savings.md consolidation, checked 2026-11-01) | backorder at RMRC; in stock at ProgressiveRC $21.99
— | Avionics | RMRC digital airspeed sensor MS4525DO + pitot | 1 | 59.99 | 59.99 | ReadyMadeRC one order (free shipping under the 5 % rule; docs/research/bom-savings.md consolidation, checked 2026-11-01) | replaces the Holybro MS5525DSO (ships CN, $37.47 shipping); ArduPilot ARSPD_TYPE 1
— | Controls | EMAX ES3005HV servo | 5 | 19.99 | 99.95 | ReadyMadeRC one order (free shipping under the 5 % rule; docs/research/bom-savings.md consolidation, checked 2026-11-01) | 2 ailerons, elevator, 2 rudders
Amazon | Airframe | Scotch heavy-duty packing tape, 6 rolls (skin) | 1 | 19.98 | 19.98 | BF §2 amazon.com
Amazon | Airframe | 10 AWG silicone wire 5 ft red + 5 ft black (B0D968WN4W) | 1 | 8.98 | 8.98 | BF §3a item 2 amazon.com
Amazon | Airframe | BNTECHGO 12 AWG silicone wire 10+10 ft (B01ABOPMEI) | 1 | 14.98 | 14.98 | BF §3a item 3 amazon.com
Amazon | Airframe | 300 mm servo extension leads, 10 (B0FYCJLY1V) | 1 | 6.99 | 6.99 | BF §3a item 4 amazon.com
Amazon | Airframe | Nylon control horns 12 sets, M2x14 screws (B0B58ZSC8J) | 1 | 8.98 | 8.98 | BF §3a item 7 amazon.com | HS J17
Amazon | Airframe | Du-Bro 230 Kwik-Link 2-56 pushrods, 5 (B0006O8TAI) | 1 | 12.48 | 12.48 | BF §3a item 8 amazon.com
Amazon | Airframe | Heat-shrink kit 2:1, 900 pcs (B0BG6V4HV4) | 1 | 6.99 | 6.99 | BF §3a item 10 amazon.com
Amazon | Airframe | Zip ties 4/6/8/12 in, 200 (B0CSXGZXM8) | 1 | 3.99 | 3.99 | BF §3a item 11 amazon.com
Amazon | Airframe | ZORZA UBEC 5 V 5 A, 2 pcs (B0CQ1R55BV) | 1 | 9.99 | 9.99 | BF §3a item 12 amazon.com
Amazon | Airframe | Gorilla 5-min epoxy 0.85 oz (B001Z3C3AG) | 1 | 5.97 | 5.97 | BF §3a item 13 amazon.com
Amazon | Airframe | ruthex RX-M3x5.7 heat-set inserts, 100 (B08BCRZZS3) | 1 | 9.99 | 9.99 | HS §2c amazon.com | replaces generic M3 inserts
Amazon | Airframe | Loctite 242 threadlocker 6 ml (B000I1RSNS) | 1 | 7.03 | 7.03 | HS §2d amazon.com | metal-to-metal threads only
Amazon | Airframe | 300 mm servo extension leads, 10 (B0FYCJLY1V), 2 more packs for the 11.8 m harness | 2 | 6.99 | 13.98 | BF §3a item 4 amazon.com | BUILD-MANUAL G2: price of 2026-10-13
Amazon | Airframe | ELEGOO PETG 1 kg (clamps, pod frames, gear clamps) | 2 | 12.99 | 25.98 | BF §5
Amazon | Airframe | BNTECHGO 12 AWG silicone wire, 2nd pack (ESC feeds) | 1 | 14.98 | 14.98 | BF §3a item 3 amazon.com
Amazon | Airframe | 14 AWG silicone wire (pusher / BEC feeds) | 1 | 9.99 | 9.99 | BF §3b amazon.com
Amazon | Airframe | XT60H connectors 12 pairs (one per ESC at the boom disconnects) | 1 | 6.99 | 6.99 | BF §3b amazon.com | one per ESC: Amass XT60H 30 A continuous vs ~12 A hover / 28 A peak per lift ESC (propulsion-margin-data.md F9-F10)
Amazon | Airframe | 300 mm servo extension leads, 2nd pack | 1 | 6.99 | 6.99 | BF §3a item 4 amazon.com
Amazon | Airframe | Foam-safe glue 4 oz | 1 | 12.99 | 12.99 | BF §3b amazon.com
Amazon | Airframe | ShareGoo LiPo battery straps (10) | 1 | 7.99 | 7.99 | BF §3b amazon.com
Amazon | Airframe | Hot-wire cutter: NICE-POWER 0-30 V 0-10 A bench supply (B0CRSS744F) + Ni80 24 AWG nichrome 50 ft (B0CP9V3DBX) | 1 | 41.73 | 41.73 | amazon.com (docs/research/bom-savings.md, checked 2026-11-01) | borrow if a makerspace has one
Amazon | Energy | Ovonic 6S 6500 100C — 2-pack listing (2 packs) | 1 | 138.99 | 138.99 | BE §1 amazon.com | second pack per R7; EC5 leads: re-terminate to AS150U
Amazon | Energy | HTRC C150 charger (150 W, ~6 A on 6S) | 1 | 56.99 | 56.99 | BE §2 amazon.com/dp/B0H4QLJYHY
Amazon | Lift propulsion | JeeFly 1755 carbon prop (pair) | 2 | 18.60 | 37.20 | BL props amazon.com/dp/B0FJ21V736 | $4.99 delivery, likely CN
Amazon | Lift propulsion | LANRC BLHeli_S 45A ESC (4-pack) | 2 | 30.00 | 60.00 | amazon.com/dp/B0D2HS4Y4J (docs/research/bom-savings.md, checked 2026-11-01) | 4 lift + pusher + 3 spare; $1.50 delivery per pack in the shipping allowance
Amazon | Spares | JeeFly 1755 spare pair (amazon.com) | 1 | 18.60 | 18.60 | BL
Amazon | Test & safety | Tenergy LiPo bag | 1 | 8.99 | 8.99 | BE §3
Amazon | Test & safety | Watt meter 150 A / 60 V | 1 | 12.99 | 12.99 | BE §3
Amazon | Test & safety | IR thermometer | 1 | 8.98 | 8.98 | BE §3
Amazon | Test & safety | 20 kg load cell + HX711 kit (thrust stand) | 1 | 8.98 | 8.98 | BE §4
Amazon | Test & safety | Arduino Nano clone (thrust stand) | 1 | 8.99 | 8.99 | BE §4
APC Propellers | Cruise propulsion | APC 14x8.5EP pusher prop | 3 | 6.79 | 20.37 | PB 1c
Bolt Depot | Airframe | A2 metric fasteners per HS §6 (14 lines: M2/M3/M5 screws, nylocks, nuts, washers) | 1 | 22.38 | 22.38 | HS §6 boltdepot.com (BD-9 M5 x 25, BD-5 M3 x 30, rev 2026-11-02) | replaces Mywish kit B0CQWYFTXC
Harbor Freight | Test & safety | Harbor Freight 0.50 cal ammo can (pack storage) | 1 | 19.99 | 19.99 | BE §3
Home Depot | Airframe | FOAMULAR NGX F-250 2 in x 4 x 8 ft (wing cores) | 1 | 59.97 | 59.97 | BF §2 homedepot.com
Home Depot | Airframe | FOAMULAR 150 1 in x 4 x 8 ft (tail, pod) | 1 | 30.97 | 30.97 | BF §2 homedepot.com
OnlineMetals | Airframe | 6061-T6 tube 1.000 x 0.035 in x 72 in (booms) | 2 | 26.20 | 52.40 | BF §1 onlinemetals.com | cut list 1.046 + 0.4859 + 1.046 + 0.4859 m
OnlineMetals | Airframe | 6061-T6 tube 1.000 x 0.058 in x 96 in (spar sockets + gear legs) | 1 | 53.97 | 53.97 | BF §1 | 2 x 0.8 m sockets + 4 x 0.205 m legs + kerf
OnlineMetals | Airframe | 6061-T6 tube 0.875 x 0.058 in x 36 in (joiner) | 1 | 18.45 | 18.45 | BF §1 | 0.76 m joiner, 0.30 m engagement per side; 0.23 mm clearance
SunnySky USA | Cruise propulsion | SunnySky X4110S 400KV (pusher) | 1 | 46.99 | 46.99 | BL A3 | same motor as lift: one spare covers both
SunnySky USA | Lift propulsion | SunnySky X4110S 400KV | 4 | 46.99 | 187.96 | BL A3 sunnyskyusa.com
Goods subtotal |  |  |  |  | 1598.69
Sales/use tax 10.25 % (Berkeley, CDTFA 2026-10-01) |  |  |  |  | 163.87
Shipping allowance (estimate) |  |  |  |  | 91.99
Committed spend |  |  |  |  | 1854.55
Crash reserve left under $2,000 |  |  |  |  | 145.45
Fee outside the hardware cap: FAA registration |  |  |  |  | 5.00
Fee outside the hardware cap: AMA Full membership (1 pilot; $2.5M liability covers UC $1M rule) |  |  |  |  | 89.00
Prices checked 2026-10-13; re-check before ordering. Generated by analysis/export_bom.mjs from analysis/results.json.
