davinciucberkeley-collab/DillonVTOL/docs/build/cut-list.csv

id | part | qty | material | stock | stock_len_mm | cut_len_mm | tol_mm | width_mm | thick_mm | holes | hole_dia_mm | hole_from_end_mm | hole_tol_mm | notes | source
T01 | Boom front | 2 | 6061-T6 tube 1.000 x 0.035 in | OnlineMetals pid 1211 72 in | 1828.8 | 1046.0 | 0.8 | — | — | 2 cross holes through both walls on the horizontal neutral axis (splice F04) | 3.4 | 18.0 from the AFT end | 0.3 | One front boom + one stub from each 72 in tube: 1046.0 + 485.9 + 1.5 kerf = 1533.4 mm (calc); 295.4 mm offcut for coupons and the thrust-stand arm (calc: 1828.8 - 1533.4). cad/verification.txt (2026-11-02 09:52) prints 1046.0, matching params.txt segF 1046.0. Length = x1 - xRear (results.json geo; sizing.mjs geometry); DBF-DRW-001 rev E sheet 7 | cad/params.txt segF; cad/verification.txt; C0_BOM.csv
T02 | Boom rear stub | 2 | 6061-T6 tube 1.000 x 0.035 in | same tube as T01 | — | 485.9 | 0.8 | — | — | 2 cross holes as T01 (splice F04) | 3.4 | 18.0 from the FORWARD end | 0.3 | Butts against the front boom inside the rear motor mount over the splice plug (J04); sheet 7 | cad/params.txt segR; hardware-spec.md J04
T03 | Spar socket | 2 | 6061-T6 tube 1.000 x 0.058 in | OnlineMetals pid 4342 96 in | 2438.4 | 800.0 | 0.8 | — | — | none | — | — | — | 2 x 800 + 4 x 205 = 2420 mm + 5 kerfs x 1.5 = 2427.5 < 2438.4 (calc): 11 mm total slack, cut the legs last | cad/params.txt sparLen; C0_BOM.csv
T04 | Landing leg | 4 | 6061-T6 tube 1.000 x 0.058 in | same tube as T03 | — | 205.0 | 0.5 | — | — | 1 cross hole through both walls (F05 M3 x 30) | 3.4 | per DBF-DRW-001 rev E sheet 7 (7.0 from the TOP end: socket 14.0 deep less 2.0 wall above the bore then 21.7 - 12.7 - 2.0 = 7.0 calc from hardware-spec J07; confirm on the sheet) | 0.3 | Drill through the gear clamp as the jig with the leg seated (WP8 8.7); printed teardrop fairing P25 slips over the leg | hardware-spec.md J07/FT03; cad/hardware.json F05; cad/params.txt legLen
T05 | Wing joiner | 1 | 6061-T6 tube 0.875 x 0.058 in | OnlineMetals pid 6891 36 in | 914.4 | 760.0 | 0.8 | — | — | none | — | — | — | SLIP FIT, not bonded (FT06 rev B): captured between the two joiner stops 300 mm inside each socket. 154 mm offcut = FT01 fit coupon. Chamfer both ends 1 x 45 deg | cad/params.txt joinLen; hardware-spec.md CAD implementation notes J11/FT06
F01 | Wing core block | 2 | XPS FOAMULAR NGX F-250 2 in | Home Depot 52DDNGX 4 x 8 ft x 2 in | 2438 x 1219 | 1140 | 2 | 342.3 | 50.8 | hot-wire NACA 2415 + spar channel dia 26.0 at 30 % c (96.70 mm aft of LE; +6.04 above the chord line) | 26.0 | root end 0 to 800 along span | 0.5 | Block oversize 10 mm each end and 10 mm at LE/TE for the wire lead-in; finished panel 1120 x 322.3 x 48.4 (params chord 0.322333, thick30 48.36); block width 342.3 = 322.3 + 2 x 10 (calc); 2 strips x 342.3 = 684.6 < 1219 sheet (calc; at most 3 strips fit); pockets afterwards for the spar collar, rear hardpoint, servo tray, root tongue, (L) pitot clamp | cad/params.txt panelLen chord sparX sparY; hardware-spec.md FT05; cad/mesh/meta.json Wing_Panel
F02 | Wing saddle block | 1 | XPS FOAMULAR NGX F-250 2 in | offcut of F01 sheet | — | 160 | 1 | 342.3 | 50.8 | hot-wire NACA 2415; joiner bore dia 22.455 through (drill; slip fit FT06); 2 pillar bores dia 16.2 at 70 % c z +-65; 2 tongue slots | 22.455 | — | 0.2 | CAD Wing_Saddle 320.8 x 70.2 x 172 (cad/mesh/Wing_Saddle.STL bbox 2026-11-01) incl. the 6 mm side tabs (printed, P13); sheet 4 | cad/mesh/meta.json Wing_Saddle; hardware-spec.md CAD notes J11
F03 | Stabiliser blank | 1 | XPS FOAMULAR NGX F-150 1 in | Home Depot 20WENGX 4 x 8 ft x 1 in | 2438 x 1219 | 935 | 2 | 145 | 25.4 | hot-wire NACA 0009 chord 125.02; cut at 68 % c; 4 x dia 7.2 holes for the crush sleeves at z +-416.2 and +-451.2 (x -888.0) | 7.2 | — | 0.3 | Finished 917.4 span x 125.02 chord x 11.3 thick (params hSpan hC tailT); blank width 145 = 125.0 + 2 x 10 (calc); elevator F04 from the same blank | cad/params.txt hSpan hC tailT; comp Crush_Sleeve
F04 | Elevator | 1 | XPS F-150 (from F03) | — | — | 845.8 | 1 | 37.5 | 6.9 | hot-wire 70-100 % c of the NACA 0009; horn through-bolt M2 x 14 (F11) + kit backplate at z +21 on the TOP surface | 2.4 | — | — | 6.9 mm thick at the hinge (calc: 0.0551 x 125.0); chord 37.5 (calc: 0.3 x 125.02); 4 mm gap to each fin (CAD README) | cad/params.txt elevSpan; cad/mesh/meta.json Elevator
F05 | Fin blank | 2 | XPS FOAMULAR NGX F-150 1 in | same sheet as F03 | — | 220 | 2 | 180 | 25.4 | hot-wire NACA 0009 root 166.38 / tip 108.15 chord; cut at 68 % c (rudder hinge 70 %) | — | — | — | Finished height 208.0 (params vH); blank 220 x 180 = height and root chord + 10 lead-in, rounded up (calc, EST); root 21 mm sits in the printed shoe; tip chord 65 % of root; TE straight, LE swept (BuildVtol.cs Fin) | cad/params.txt vC vH; cad/mesh/meta.json Fin
F06 | Rudder | 2 | XPS F-150 (from F05) | — | — | 186.0 | 1 | 48.1 root / 32.4 tip | 8.8 root | hot-wire 70-100 % c; horn through-bolt M2 x 14 (F11) + kit backplate on the inboard face at 29 mm above the fin root | 2.4 | — | — | Rudder from 22 mm above the fin root (clears the shoe wall) to the tip; 30 % of the local chord, 2 % gap (calc: height 208.0 - 22; local chord at 22 mm 160.2 = 166.38 - 58.23 x 22 / 207.98; thickness 0.0550 x 160.2) | cad/mesh/meta.json Rudder; hardware-spec.md CAD notes C6
F07 | Pod core laminate | 1 | XPS FOAMULAR NGX F-150 1 in | same sheet as F03 | — | 1000 | 3 | 170 | 7 x 25.4 = 177.8 stacked | hot-wire 8-sided body of revolution to the pod profile then sand round; battery bay around x +0.255 (tray 165 x 56) with a 15 x 30 EST ram-air inlet from the nose and a 15 x 30 EST exit slot at the bay's aft end (BUILD-MANUAL 8.2a; thermal.md 6.4 item 1); avionics bay floor at y -20 from x +0.30 to +0.45 for the FC tray at x +0.375; wing-root slot 322 x 71; canopy pocket x +0.158 to +0.480; tail ring bore dia 56 x 30 | 56.0 | — | 0.2 | Pod 1000 long x 160 dia (params fusL fusR; nose at x +0.60); the CAD pod is one solid; frames/rails printed (P20) are this manual's method EST | cad/params.txt fusL fusR battX bayX0 bayX1 canopyX0 canopyX1 tailR; cad/mesh/meta.json Fuselage_Pod
F08 | Canopy blister core | 1 | XPS F-150 1 in (2 layers) | same sheet as F03 | — | 352 | 3 | 110 | 50.8 | hand-shaped blister 352 x 55 x 110 (cad/mesh/Canopy.STL bbox 351.5 x 55.0 x 110.0 of 2026-11-01) hollowed to a 4 mm wall EST | — | — | — | Printed 2 mm rear flange + front tongue P22 (J13) | cad/mesh Canopy.STL bbox; hardware-spec.md CAD notes J13
W01 | Skin tape wing | 2 panels | Scotch Heavy Duty packing tape 1.88 in | B000087KUA 6 rolls x 54.6 yd | 49.9 m/roll | ~1400 strips | — | 47.8 | — | — | — | — | — | Chordwise strips 25 % overlap (EST): 1120 / (47.8 x 0.75) = 32 strips per face per panel, 2 faces x 2 panels = 128 strips x 0.60 m = 77 m (calc); hinges are the same tape (hardware-spec 7, hinge tape dropped from the BOM) | budget-airframe.md 2a; C0_BOM.csv
