davinciucberkeley-collab/DillonVTOL/cad/mesh/Fuselage_Pod.STL

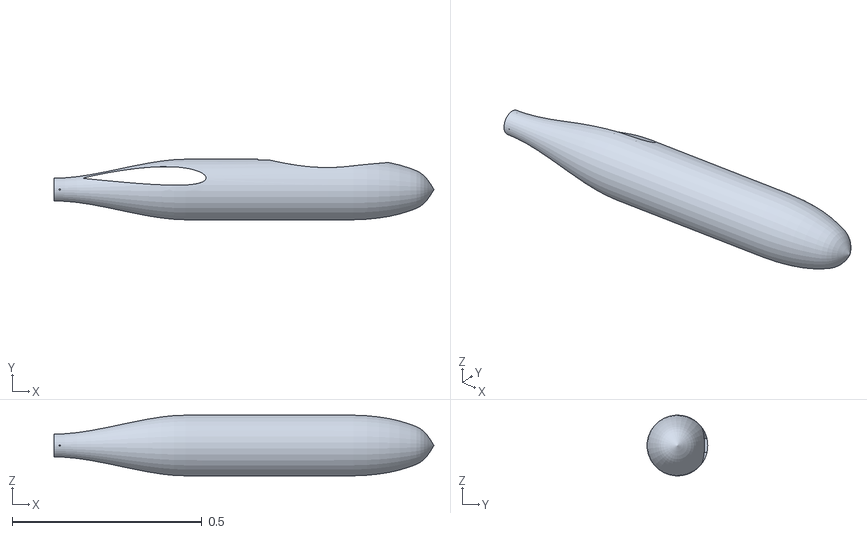
[picture p43: CAD file, 2026-11-04]
cad/mesh/Fuselage_Pod.STL
1.00 x 0.16 x 0.16
