davinciucberkeley-collab/DillonVTOL/cad/model/FC_Tray.SLDPRT

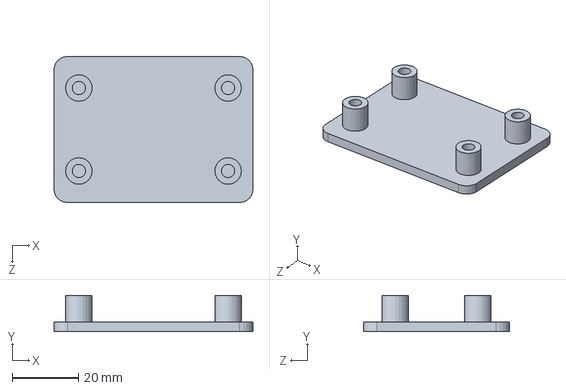
[picture p44: CAD file, 2026-11-04]
cad/model/FC_Tray.SLDPRT
60.0 x 11.0 x 44.0 mm
