davinciucberkeley-collab/DillonVTOL/cad/sim/THERM_Lift_Motor.SLDPRT

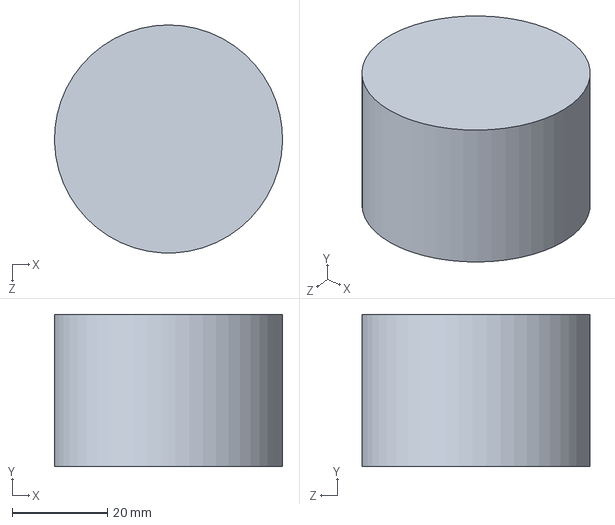
[picture p45: CAD file, 2026-11-03]
cad/sim/THERM_Lift_Motor.SLDPRT
48.0 x 32.0 x 48.0 mm
