davinciucberkeley-collab/DillonVTOL/cad/sim/thermal/THERM_Pusher.SLDPRT

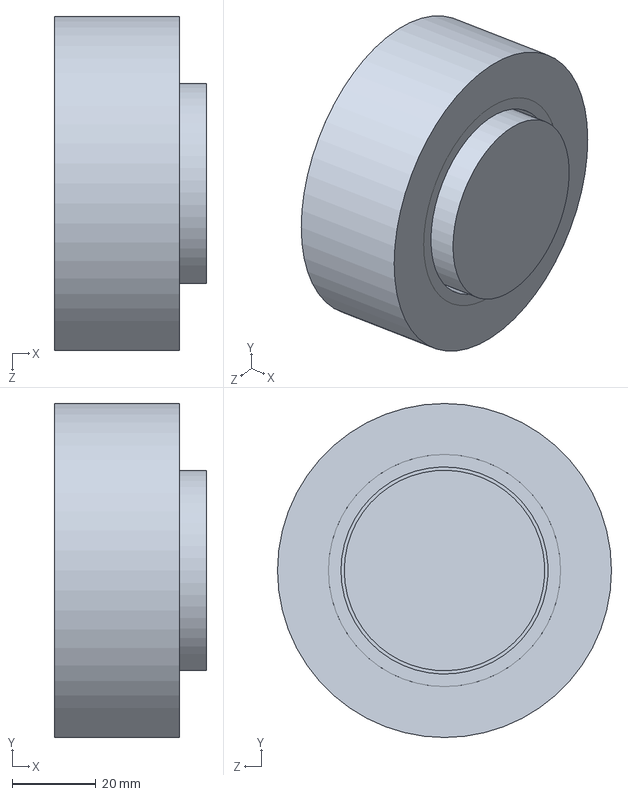
[picture p46: CAD file, 2026-11-02]
cad/sim/thermal/THERM_Pusher.SLDPRT
36.5 x 80.0 x 80.0 mm
