davinciucberkeley-collab/DillonVTOL/cad/mesh/Battery_Tray.STL

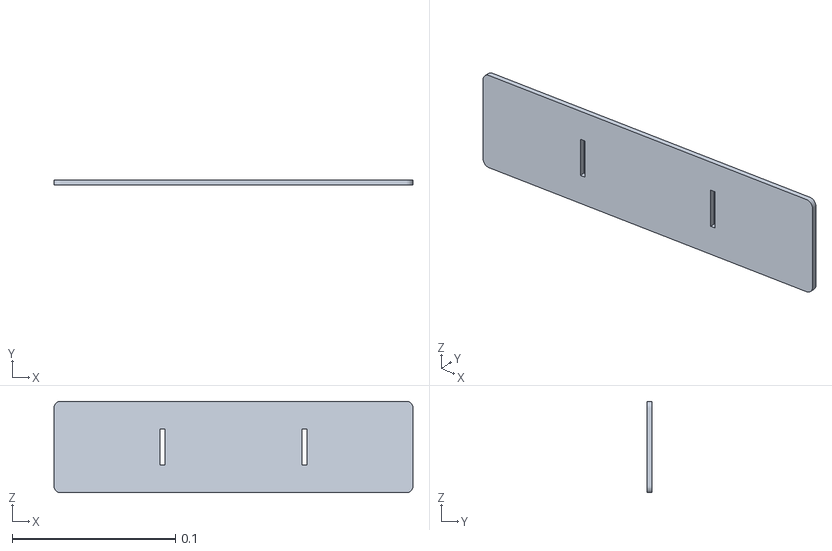
[picture p47: CAD file, 2026-11-04]
cad/mesh/Battery_Tray.STL
0.22 x 0.003 x 0.056
