davinciucberkeley-collab/DillonVTOL/cad/model/Pushrod_Rudder.SLDPRT

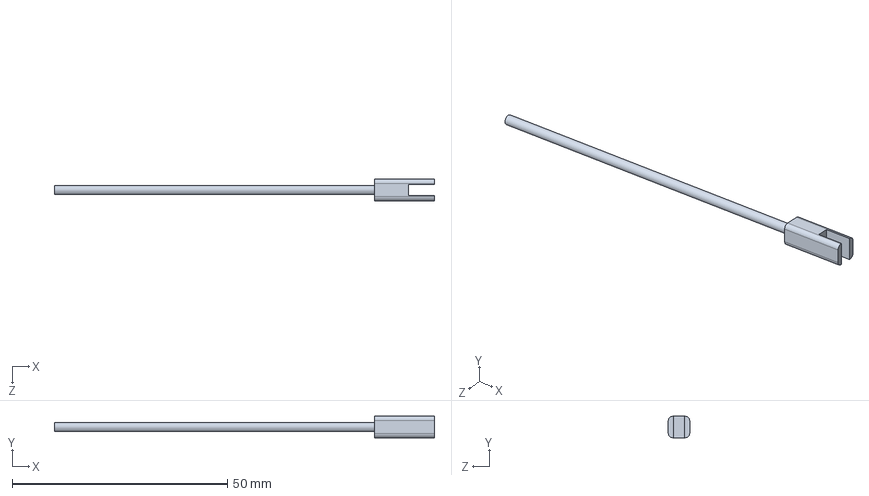
[picture p48: CAD file, 2026-11-04]
cad/model/Pushrod_Rudder.SLDPRT
88.4 x 5.00 x 5.00 mm
