davinciucberkeley-collab/DillonVTOL/cad/sim/FEA_Boom_Arm.SLDPRT

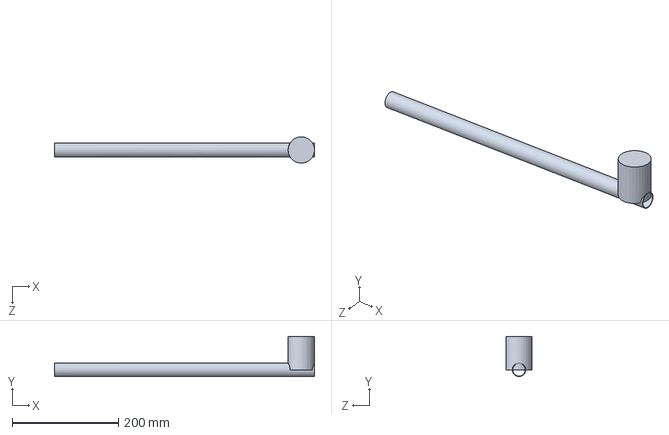
[picture p49: CAD file, 2026-11-03]
cad/sim/FEA_Boom_Arm.SLDPRT
488.3 x 75.4 x 49.5 mm
