davinciucberkeley-collab/DillonVTOL/cad/sim/thermal/THERM_Pod.SLDPRT

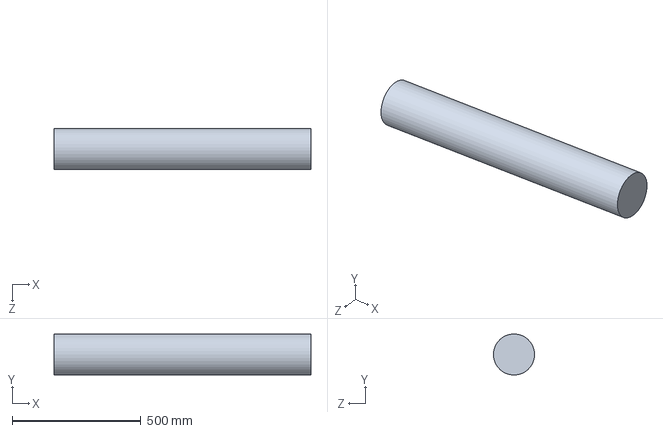
[picture p50: CAD file, 2026-11-02]
cad/sim/thermal/THERM_Pod.SLDPRT
1000.0 x 159.5 x 160.0 mm
