davinciucberkeley-collab/DillonVTOL/cad/mesh/Boom_Clamp_R_Upper.STL

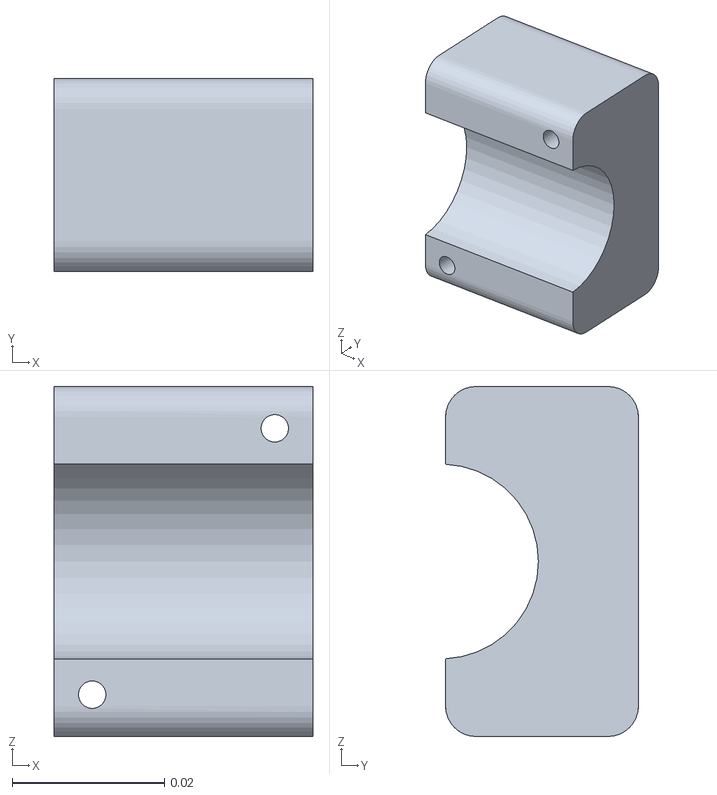
[picture p51: CAD file, 2026-11-03]
cad/mesh/Boom_Clamp_R_Upper.STL
0.034 x 0.0254 x 0.046
