davinciucberkeley-collab/DillonVTOL/cad/model/Pusher_Motor.SLDPRT

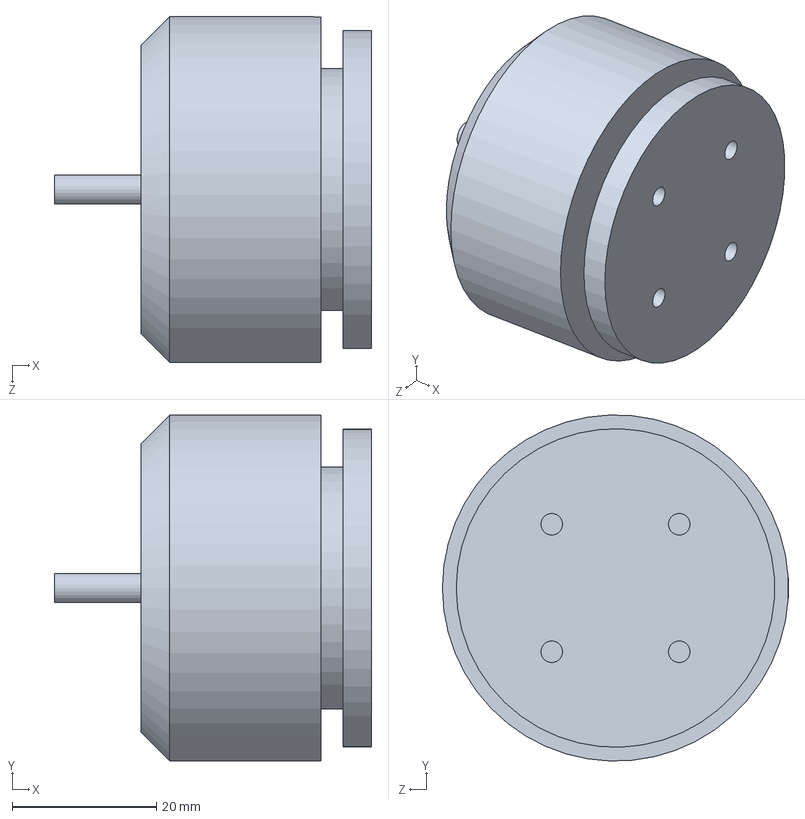
[picture p52: CAD file, 2026-11-04]
cad/model/Pusher_Motor.SLDPRT
44.0 x 48.0 x 48.0 mm
