davinciucberkeley-collab/DillonVTOL/cad/sim/FEA_Spar_Joiner.SLDPRT

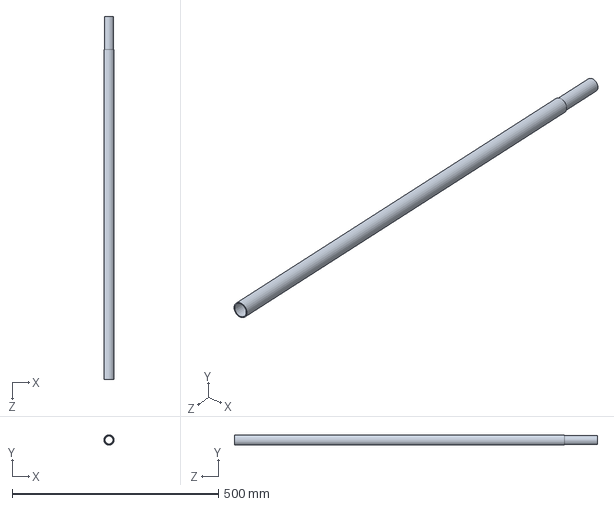
[picture p53: CAD file, 2026-11-03]
cad/sim/FEA_Spar_Joiner.SLDPRT
25.4 x 25.2 x 880.0 mm
