davinciucberkeley-collab/DillonVTOL/cad/sim/thermal/THERM_Lift_Unit.SLDPRT

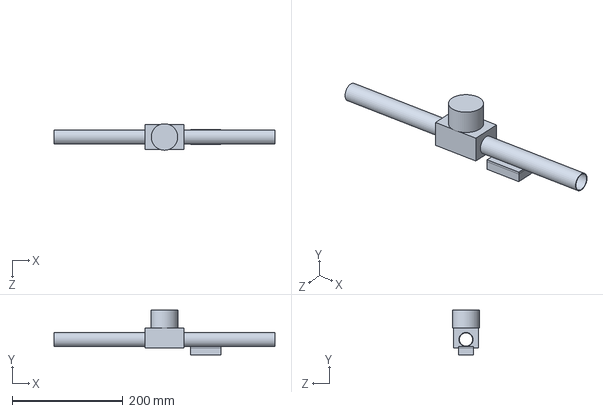
[picture p54: CAD file, 2026-11-02]
cad/sim/thermal/THERM_Lift_Unit.SLDPRT
400.0 x 80.7 x 48.0 mm
