davinciucberkeley-collab/DillonVTOL/cad/mesh/Pushrod_Rudder.STL

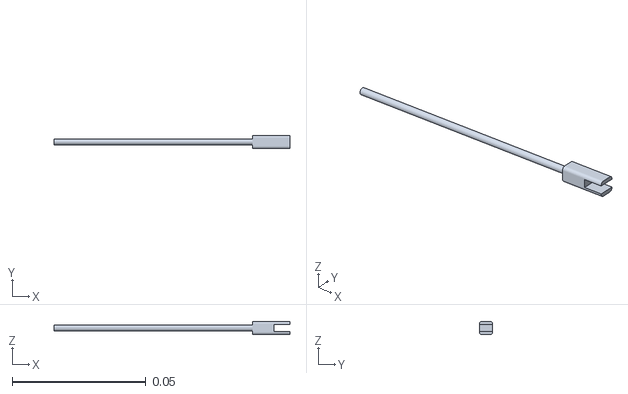
[picture p55: CAD file, 2026-11-03]
cad/mesh/Pushrod_Rudder.STL
0.0884 x 0.005 x 0.005
