davinciucberkeley-collab/DillonVTOL/cad/model/Fin_Shoe.SLDPRT

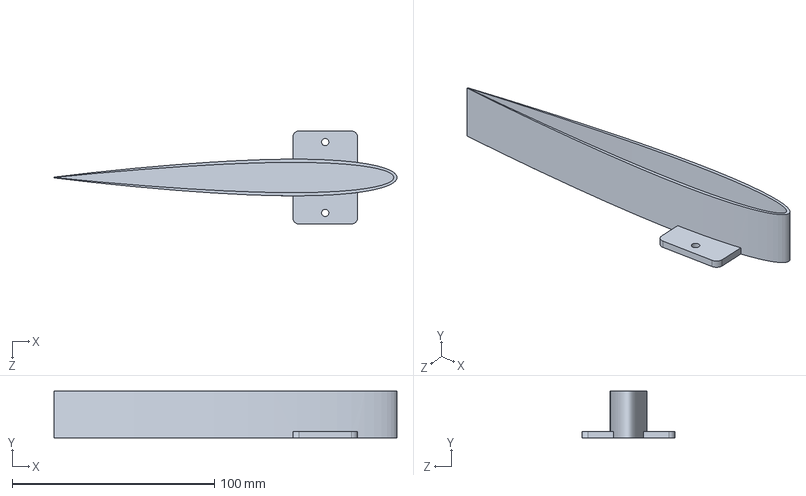
[picture p56: CAD file, 2026-11-04]
cad/model/Fin_Shoe.SLDPRT
169.6 x 23.0 x 46.0 mm
