davinciucberkeley-collab/DillonVTOL/cad/mesh/Wing_Panel_L.STL

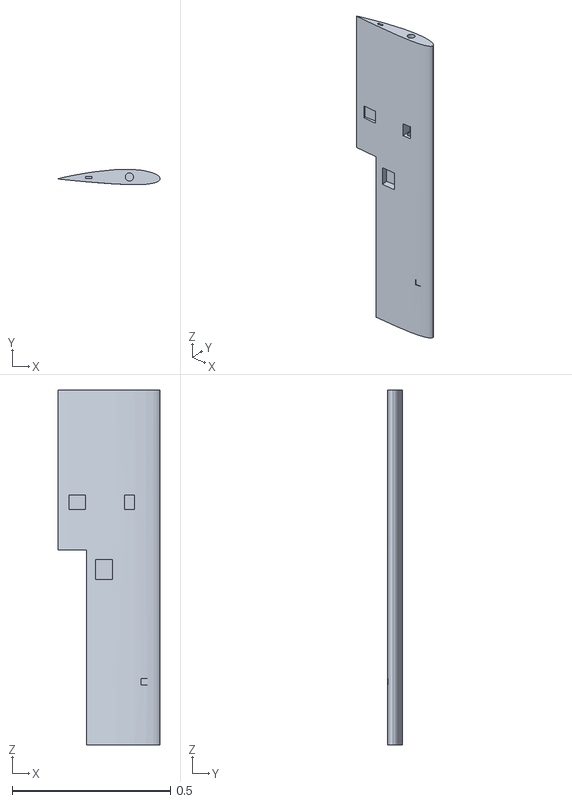
[picture p57: CAD file, 2026-11-03]
cad/mesh/Wing_Panel_L.STL
0.322 x 0.0486 x 1.12
