davinciucberkeley-collab/DillonVTOL/cad/mesh/Canopy.STL

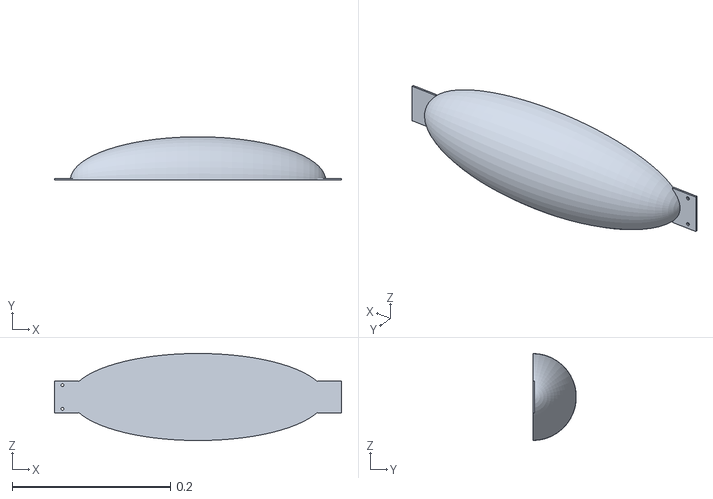
[picture p59: CAD file, 2026-11-03]
cad/mesh/Canopy.STL
0.363 x 0.0548 x 0.11
