davinciucberkeley-collab/DillonVTOL/cad/model/Tail_Clamp_Cap.SLDPRT

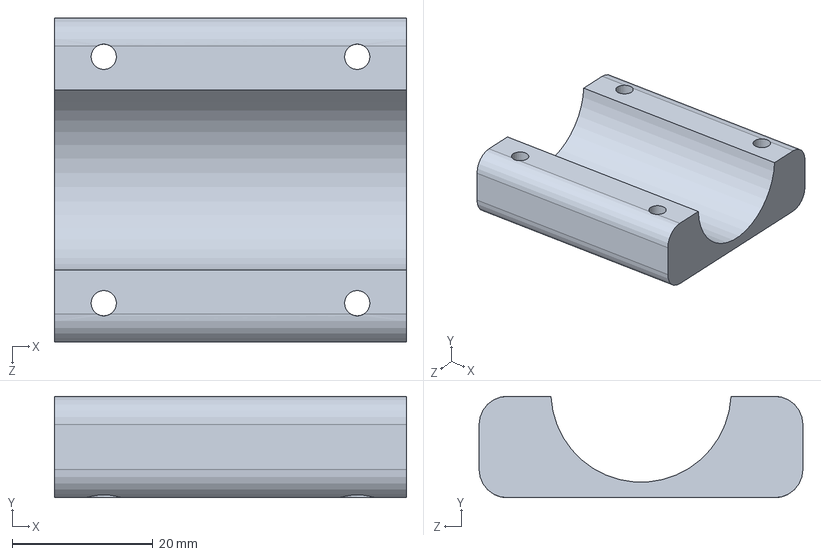
[picture p60: CAD file, 2026-11-04]
cad/model/Tail_Clamp_Cap.SLDPRT
50.0 x 14.4 x 46.0 mm
