davinciucberkeley-collab/DillonVTOL/cad/mesh/Spar_Collar.STL

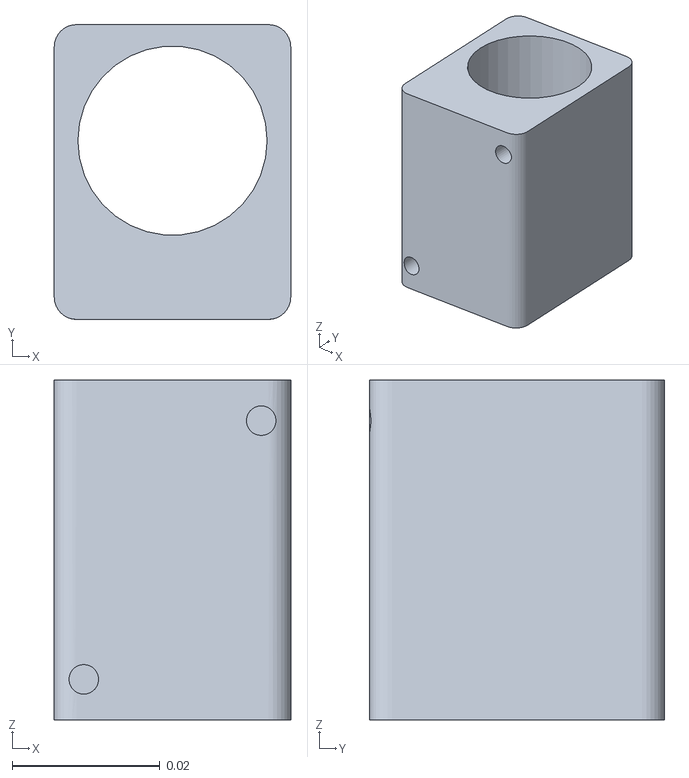
[picture p62: CAD file, 2026-11-03]
cad/mesh/Spar_Collar.STL
0.032 x 0.0399 x 0.046
