davinciucberkeley-collab/DillonVTOL/cad/model/Horn_Backplate.SLDPRT

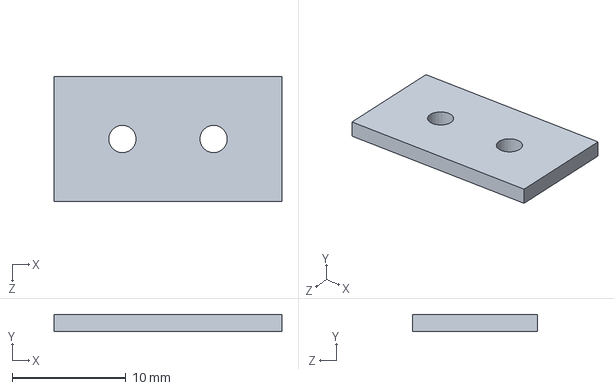
[picture p63: CAD file, 2026-11-04]
cad/model/Horn_Backplate.SLDPRT
20.0 x 1.50 x 11.0 mm
