davinciucberkeley-collab/DillonVTOL/cad/mesh/Pushrod_Aileron.STL

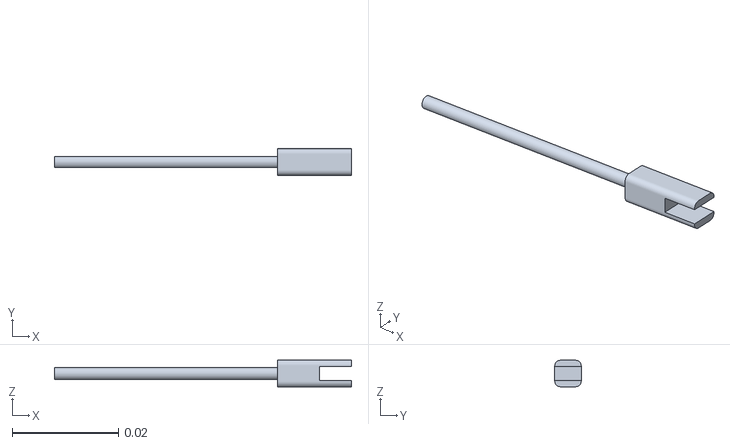
[picture p64: CAD file, 2026-11-03]
cad/mesh/Pushrod_Aileron.STL
0.056 x 0.005 x 0.005
