davinciucberkeley-collab/DillonVTOL/cad/model/Pushrod_Aileron.SLDPRT

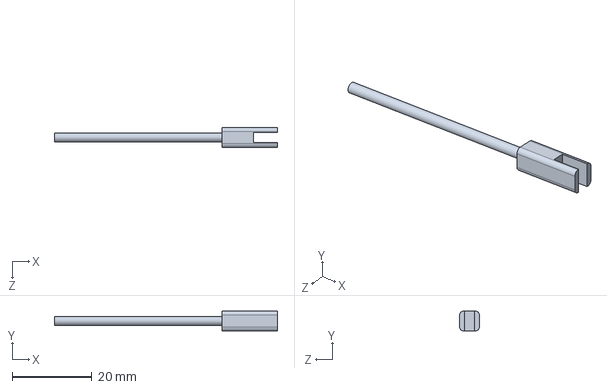
[picture p65: CAD file, 2026-11-04]
cad/model/Pushrod_Aileron.SLDPRT
56.0 x 5.00 x 5.00 mm
