davinciucberkeley-collab/DillonVTOL/cad/mesh/H_Tail.STL

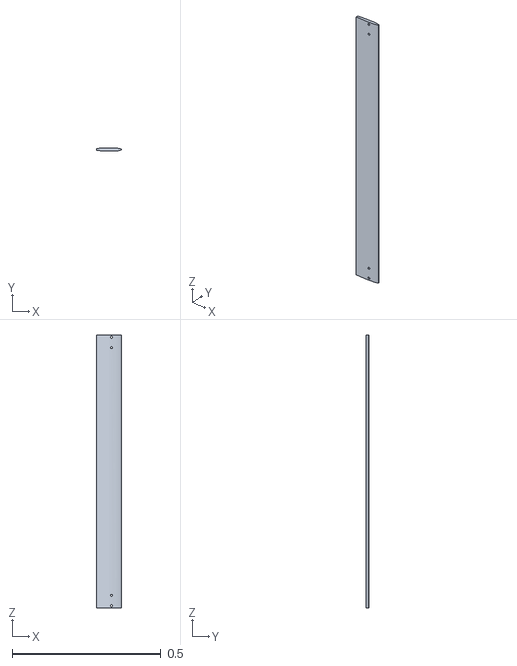
[picture p66: CAD file, 2026-11-03]
cad/mesh/H_Tail.STL
0.085 x 0.0113 x 0.917
