davinciucberkeley-collab/DillonVTOL/cad/model/Lift_Prop.SLDPRT

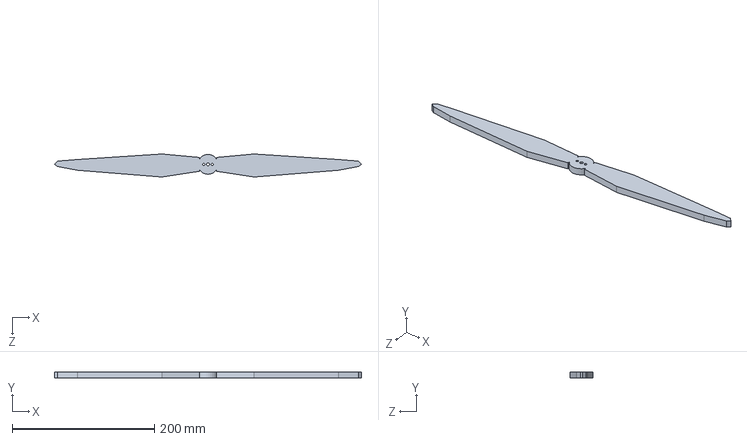
[picture p67: CAD file, 2026-11-04]
cad/model/Lift_Prop.SLDPRT
431.8 x 8.00 x 32.4 mm
