davinciucberkeley-collab/DillonVTOL/cad/mesh/Fin_Shoe.STL

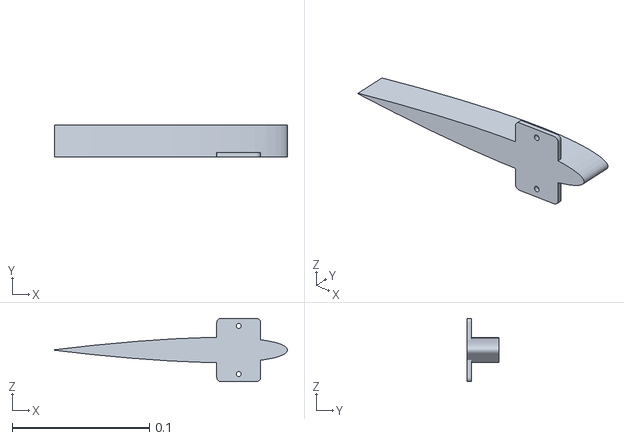
[picture p68: CAD file, 2026-11-03]
cad/mesh/Fin_Shoe.STL
0.17 x 0.023 x 0.046
