davinciucberkeley-collab/DillonVTOL/cad/mesh/Fin.STL

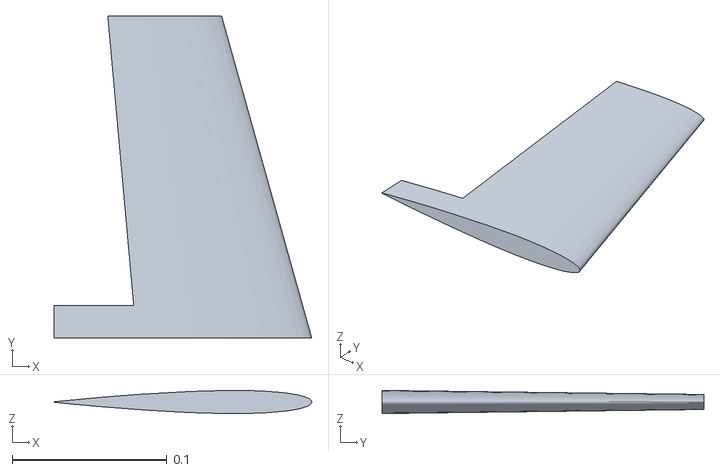
[picture p70: CAD file, 2026-11-03]
cad/mesh/Fin.STL
0.166 x 0.208 x 0.015
