davinciucberkeley-collab/DillonVTOL/cad/model/I01_M3_Insert.SLDPRT

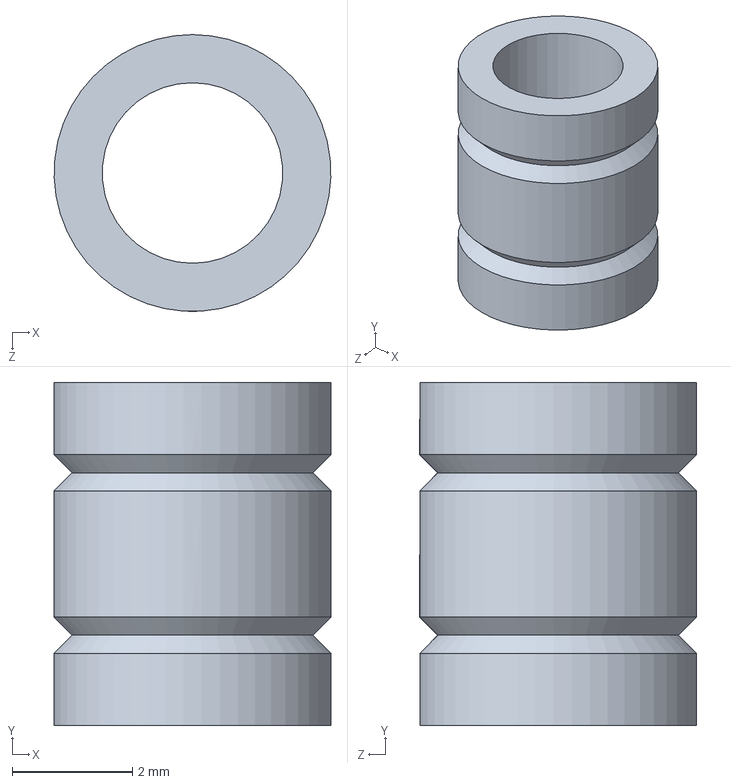
[picture p71: CAD file, 2026-11-04]
cad/model/I01_M3_Insert.SLDPRT
4.60 x 5.70 x 4.60 mm
