davinciucberkeley-collab/DillonVTOL/cad/mesh/Boom_Front.STL

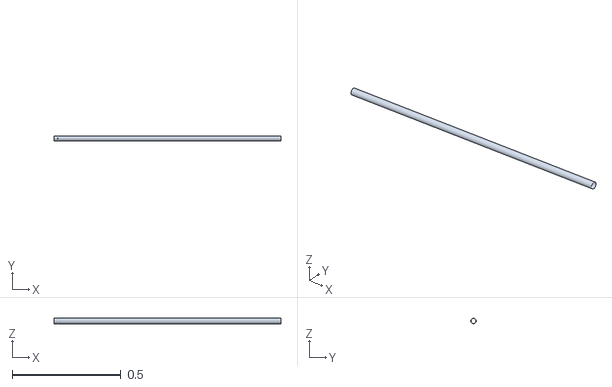
[picture p72: CAD file, 2026-11-03]
cad/mesh/Boom_Front.STL
1.05 x 0.0253 x 0.0254
