davinciucberkeley-collab/DillonVTOL/cad/mesh/Aileron_R.STL

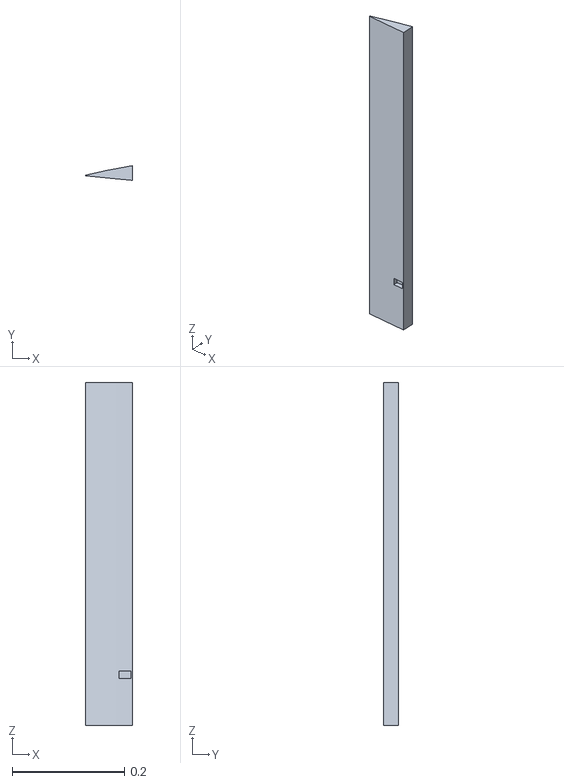
[picture p73: CAD file, 2026-11-03]
cad/mesh/Aileron_R.STL
0.0838 x 0.0263 x 0.612
