davinciucberkeley-collab/DillonVTOL/cad/model/Crush_Sleeve.SLDPRT

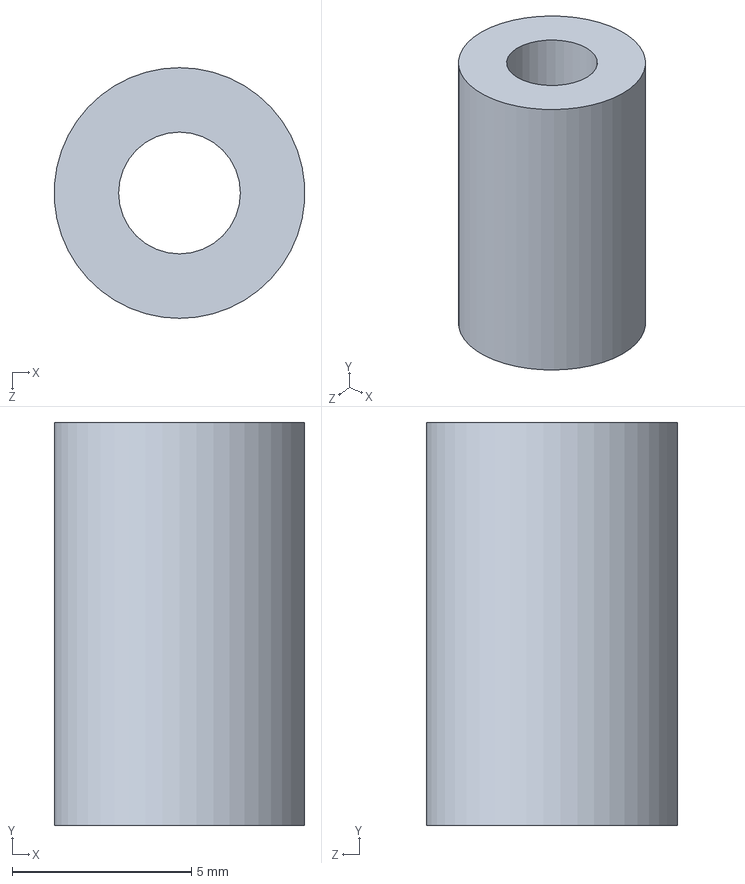
[picture p74: CAD file, 2026-11-04]
cad/model/Crush_Sleeve.SLDPRT
6.98 x 11.3 x 7.00 mm
