davinciucberkeley-collab/DillonVTOL/cad/mesh/Rudder.STL

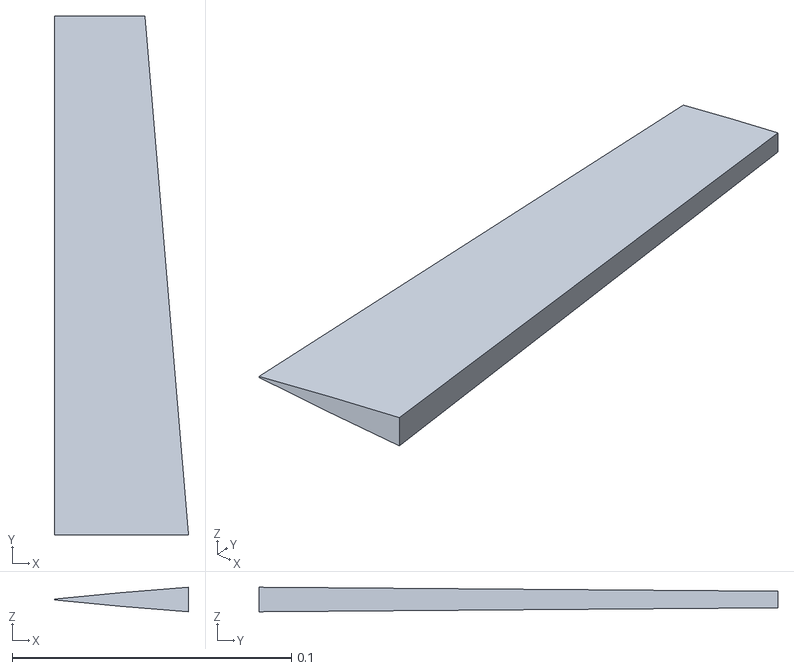
[picture p75: CAD file, 2026-11-03]
cad/mesh/Rudder.STL
0.0481 x 0.186 x 0.0088
