davinciucberkeley-collab/DillonVTOL/cad/mesh/Crush_Sleeve.STL

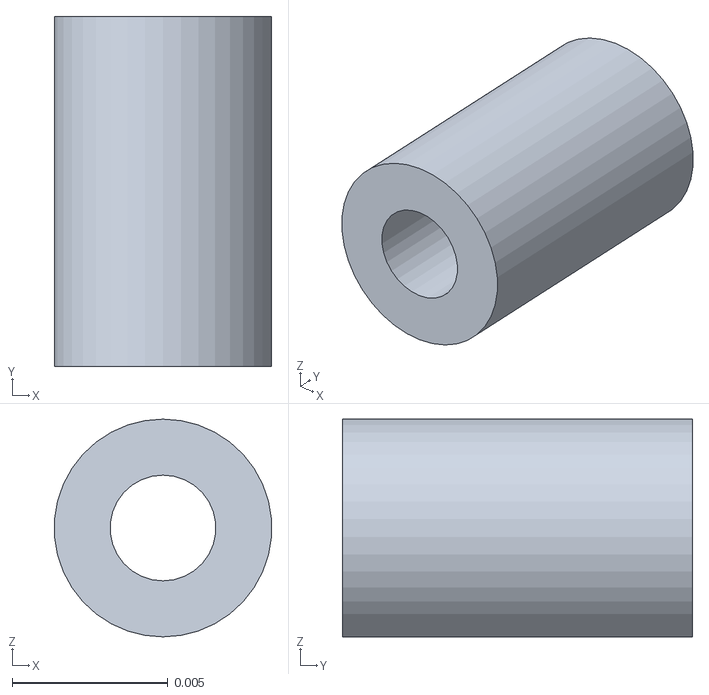
[picture p76: CAD file, 2026-11-03]
cad/mesh/Crush_Sleeve.STL
0.00698 x 0.0113 x 0.007
