davinciucberkeley-collab/DillonVTOL/cad/model/Wing_Panel_R.SLDPRT

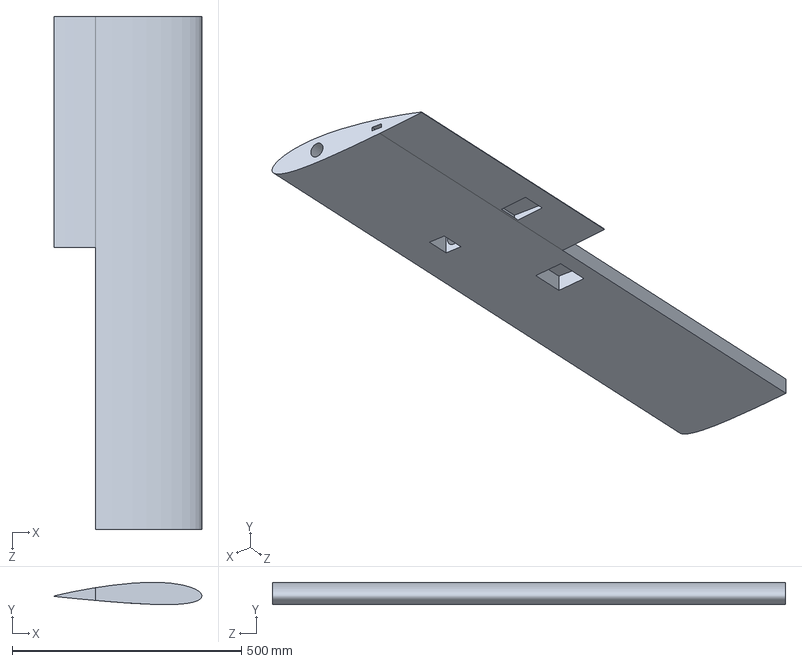
[picture p77: CAD file, 2026-11-04]
cad/model/Wing_Panel_R.SLDPRT
322.4 x 48.5 x 1120.0 mm
