davinciucberkeley-collab/DillonVTOL/cad/mesh/Elevator.STL

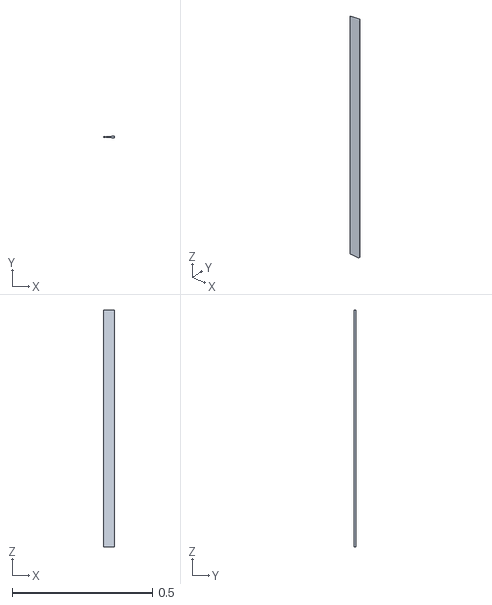
[picture p78: CAD file, 2026-11-03]
cad/mesh/Elevator.STL
0.0375 x 0.00687 x 0.846
