davinciucberkeley-collab/DillonVTOL/cad/model/N01_M3_Nylock.SLDPRT

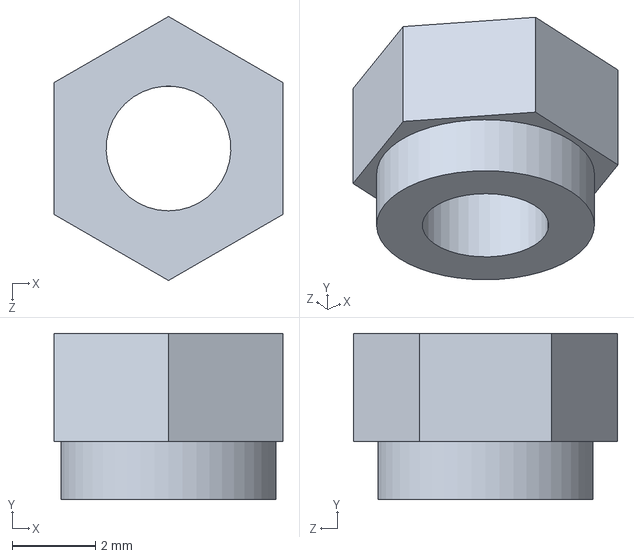
[picture p79: CAD file, 2026-11-04]
cad/model/N01_M3_Nylock.SLDPRT
5.50 x 4.00 x 6.35 mm
