davinciucberkeley-collab/DillonVTOL/cad/mesh/Wing_Saddle.STL

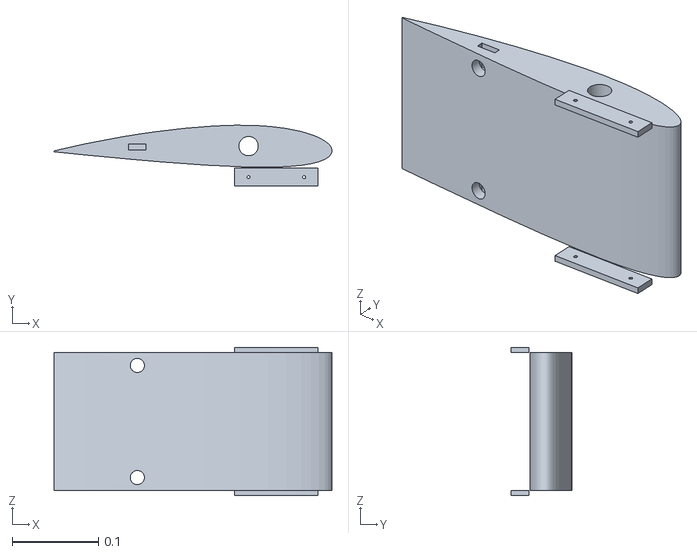
[picture p80: CAD file, 2026-11-03]
cad/mesh/Wing_Saddle.STL
0.322 x 0.0703 x 0.172
