davinciucberkeley-collab/DillonVTOL/cad/model/Battery_6S_LiPo.SLDPRT

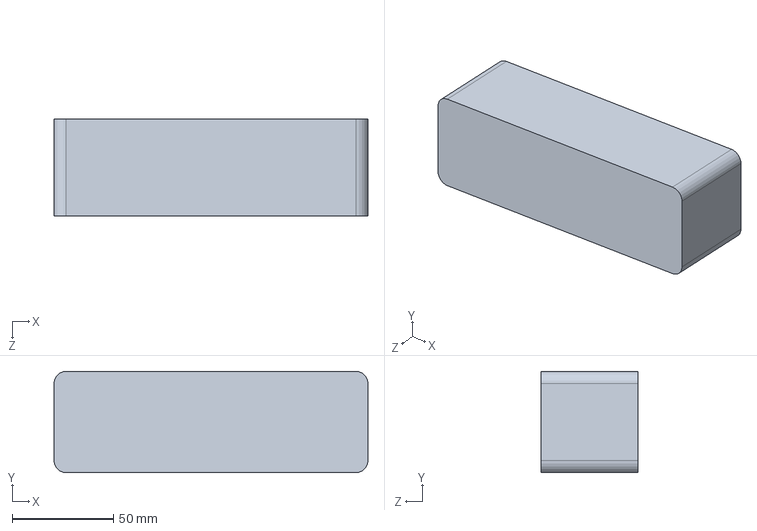
[picture p81: CAD file, 2026-11-04]
cad/model/Battery_6S_LiPo.SLDPRT
155.0 x 50.0 x 48.0 mm
