davinciucberkeley-collab/DillonVTOL/cad/model/Rear_Hardpoint.SLDPRT

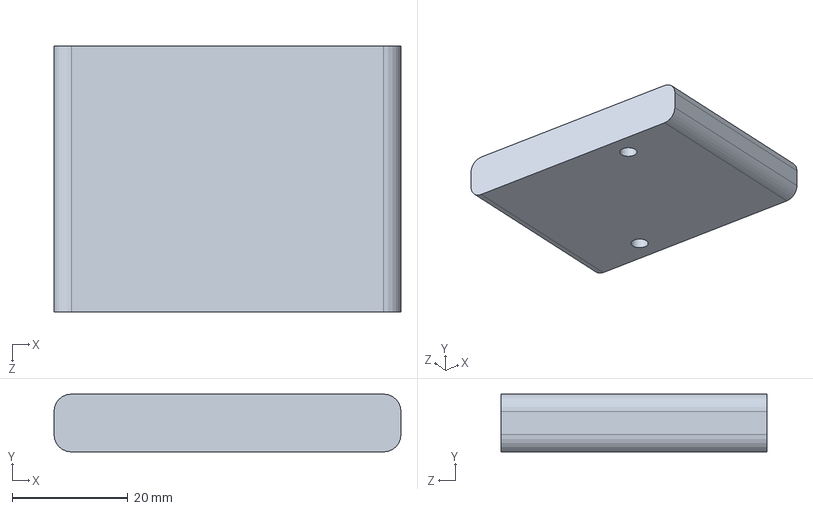
[picture p82: CAD file, 2026-11-04]
cad/model/Rear_Hardpoint.SLDPRT
60.0 x 10.0 x 46.0 mm
