davinciucberkeley-collab/DillonVTOL/cad/model/Tail_Clamp_Upper.SLDPRT

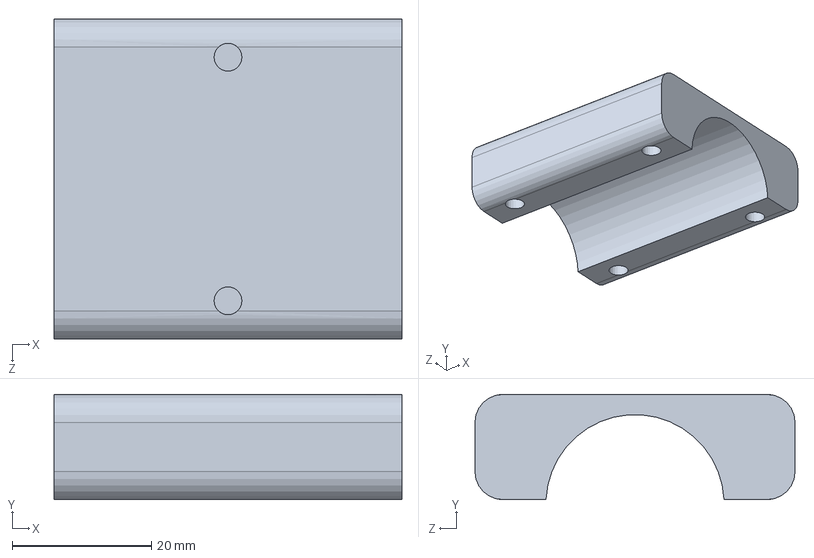
[picture p83: CAD file, 2026-11-04]
cad/model/Tail_Clamp_Upper.SLDPRT
50.0 x 15.1 x 46.0 mm
