davinciucberkeley-collab/DillonVTOL/cad/model/Motor_Mount_Cap.SLDPRT

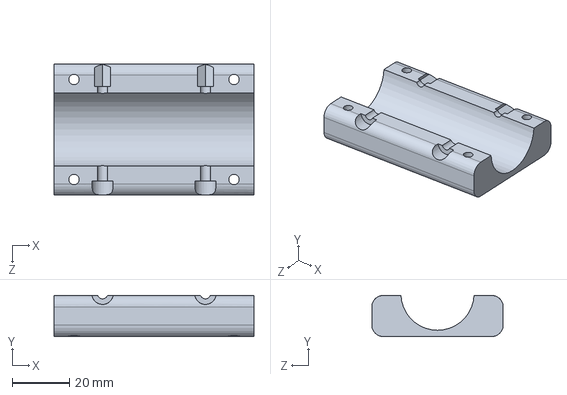
[picture p84: CAD file, 2026-11-04]
cad/model/Motor_Mount_Cap.SLDPRT
70.0 x 14.4 x 46.0 mm
