davinciucberkeley-collab/DillonVTOL/cad/mesh/Part5.STL

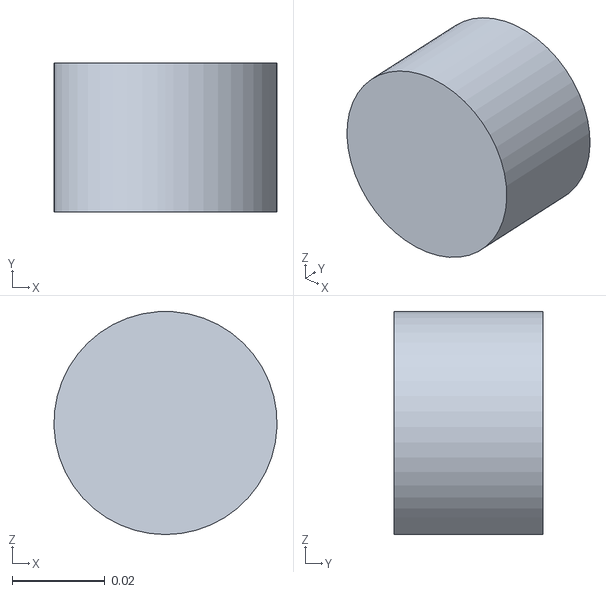
[picture p85: CAD file, 2026-11-02]
cad/mesh/Part5.STL
0.048 x 0.032 x 0.048
