davinciucberkeley-collab/DillonVTOL/cad/model/F05_M3x30_SHCS.SLDPRT

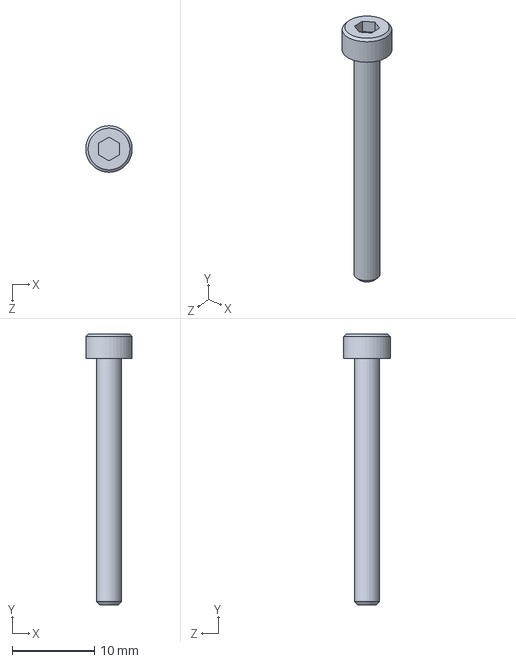
[picture p86: CAD file, 2026-11-04]
cad/model/F05_M3x30_SHCS.SLDPRT
5.66 x 33.0 x 5.68 mm
