davinciucberkeley-collab/DillonVTOL/cad/model/Servo_Tray.SLDPRT

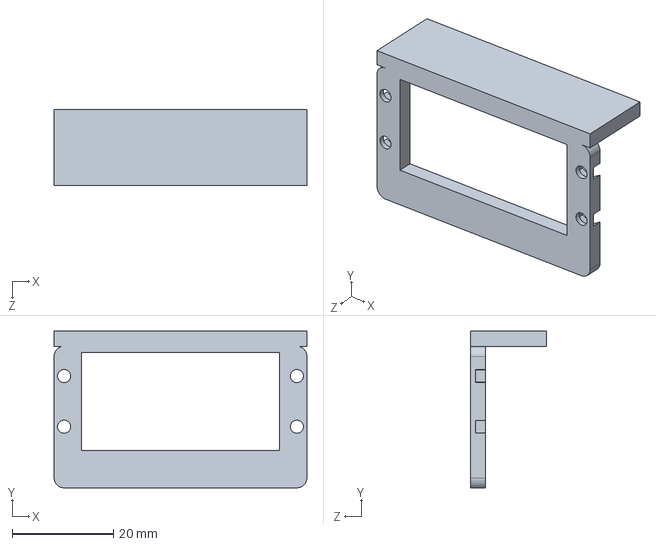
[picture p87: CAD file, 2026-11-04]
cad/model/Servo_Tray.SLDPRT
50.0 x 31.0 x 15.0 mm
