davinciucberkeley-collab/DillonVTOL/cad/mesh/Boom_Clamp_F_Upper.STL

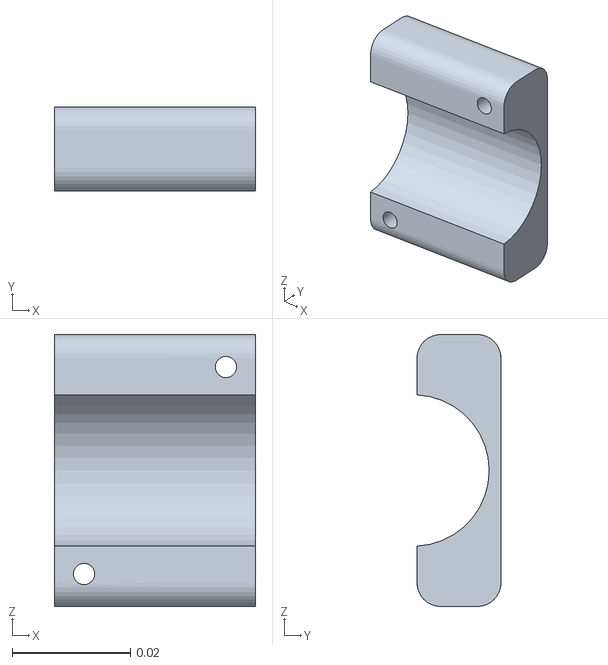
[picture p88: CAD file, 2026-11-02]
cad/mesh/Boom_Clamp_F_Upper.STL
0.034 x 0.0142 x 0.046
