davinciucberkeley-collab/DillonVTOL/cad/model/Aileron_R.SLDPRT

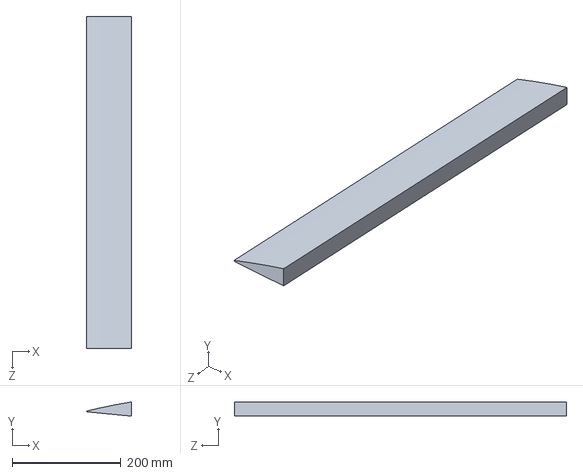
[picture p89: CAD file, 2026-11-04]
cad/model/Aileron_R.SLDPRT
83.8 x 26.3 x 612.0 mm
