davinciucberkeley-collab/DillonVTOL/cad/mesh/F09_M5x25_BHCS.STL

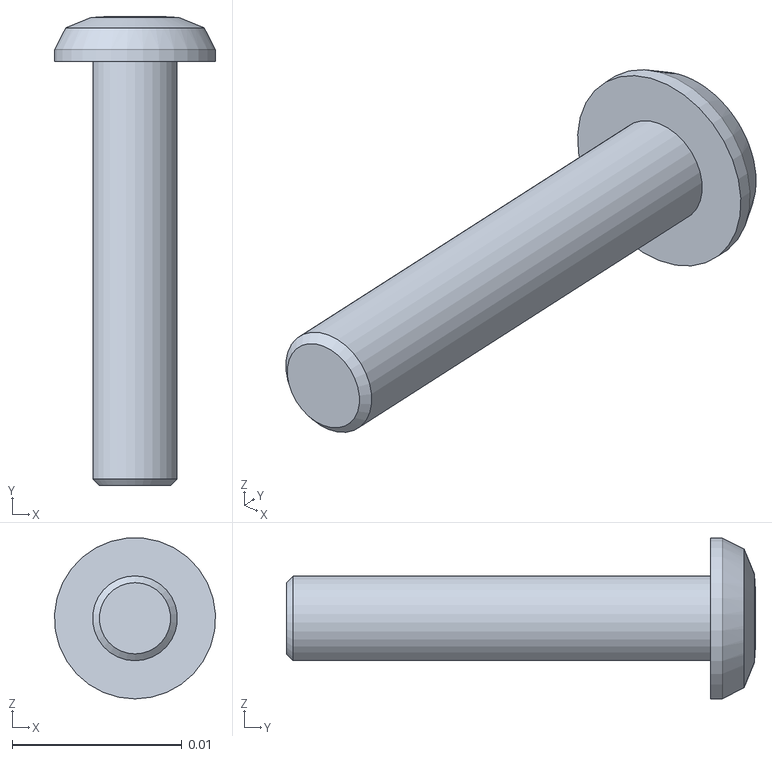
[picture p90: CAD file, 2026-11-02]
cad/mesh/F09_M5x25_BHCS.STL
0.00949 x 0.0277 x 0.00948
