davinciucberkeley-collab/DillonVTOL/cad/model/Root_Tongue.SLDPRT

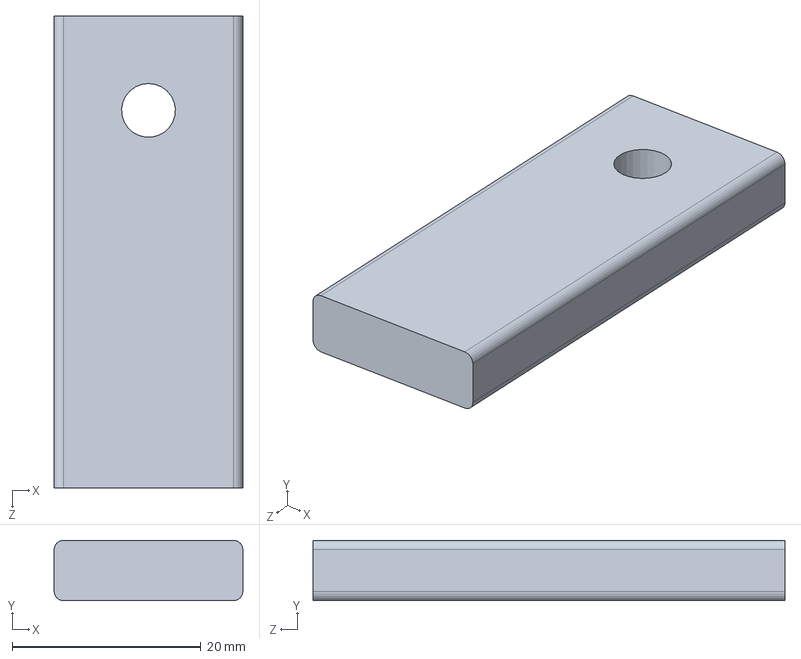
[picture p91: CAD file, 2026-11-04]
cad/model/Root_Tongue.SLDPRT
20.0 x 6.40 x 50.0 mm
