davinciucberkeley-collab/DillonVTOL/cad/model/Landing_Leg.SLDPRT

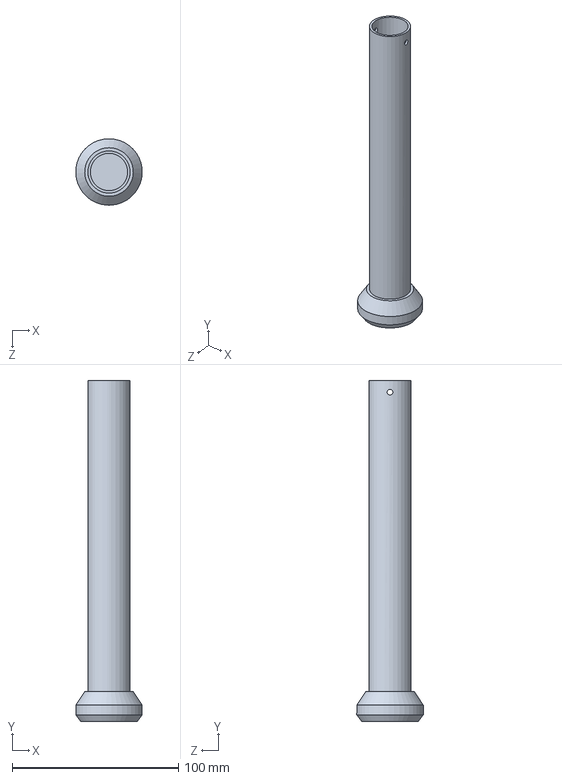
[picture p92: CAD file, 2026-11-04]
cad/model/Landing_Leg.SLDPRT
40.0 x 205.0 x 40.0 mm
