davinciucberkeley-collab/DillonVTOL/cad/model/Control_Horn.SLDPRT

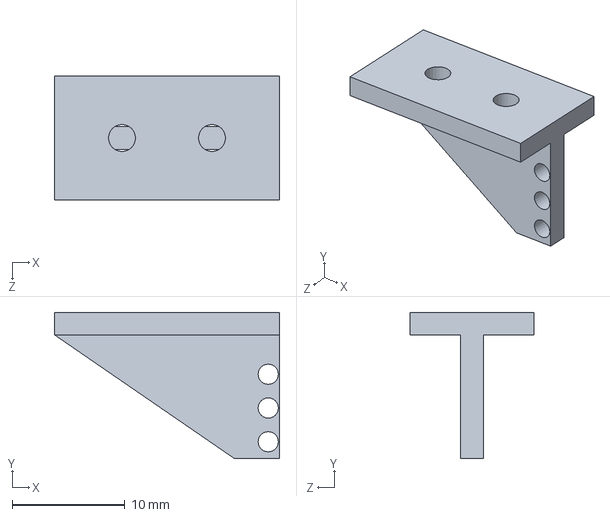
[picture p93: CAD file, 2026-11-04]
cad/model/Control_Horn.SLDPRT
20.0 x 13.0 x 11.0 mm
