davinciucberkeley-collab/DillonVTOL/cad/model/F09_M5x25_BHCS.SLDPRT

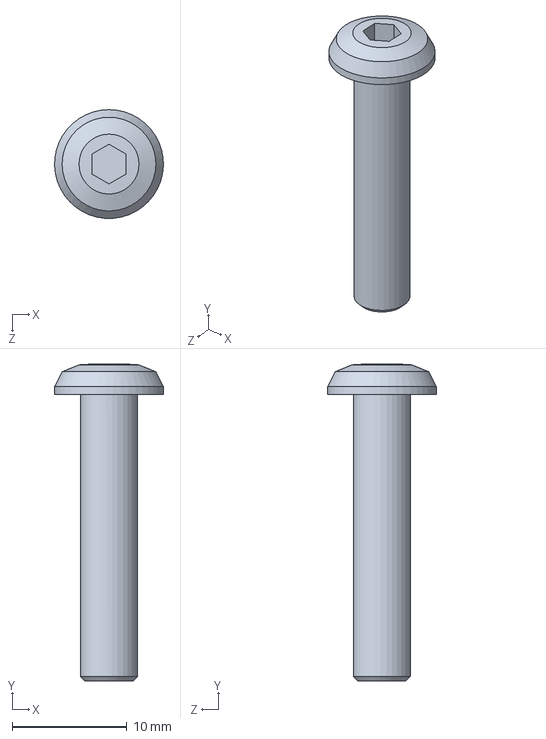
[picture p94: CAD file, 2026-11-04]
cad/model/F09_M5x25_BHCS.SLDPRT
9.49 x 27.7 x 9.49 mm
