davinciucberkeley-collab/DillonVTOL/cad/model/Gear_Fairing.SLDPRT

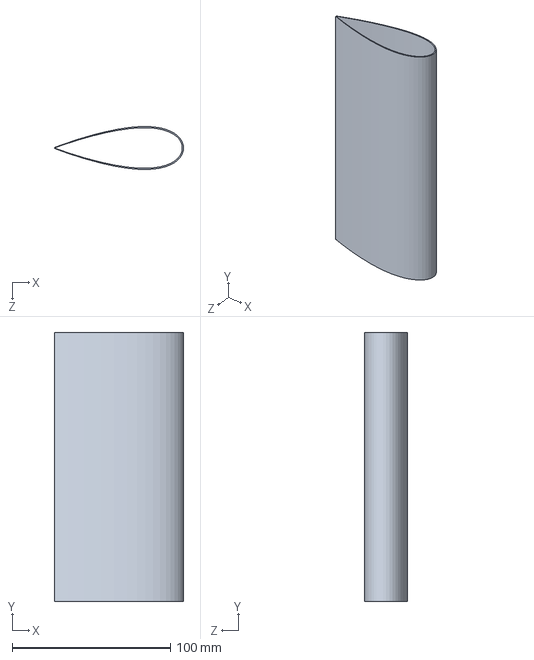
[picture p95: CAD file, 2026-11-04]
cad/model/Gear_Fairing.SLDPRT
81.6 x 170.0 x 27.2 mm
