davinciucberkeley-collab/DillonVTOL/cad/model/F11_M2x14_PAN.SLDPRT

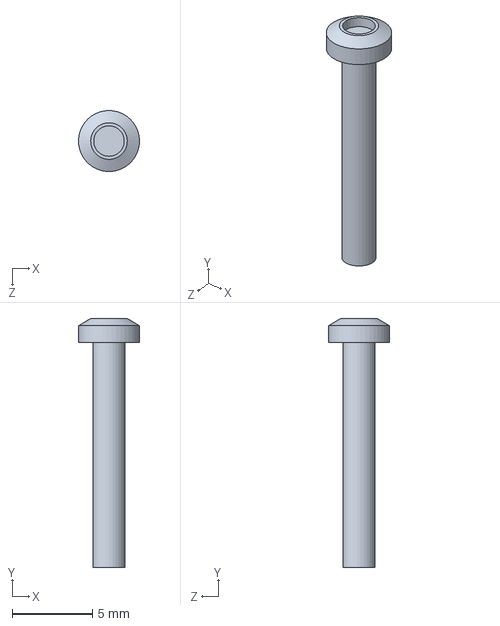
[picture p96: CAD file, 2026-11-04]
cad/model/F11_M2x14_PAN.SLDPRT
3.80 x 15.5 x 3.79 mm
