davinciucberkeley-collab/DillonVTOL/cad/model/Flight_Controller.SLDPRT

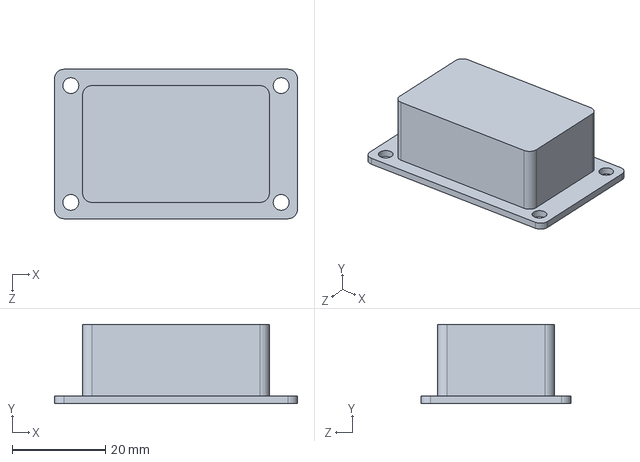
[picture p97: CAD file, 2026-11-04]
cad/model/Flight_Controller.SLDPRT
52.0 x 17.0 x 32.0 mm
