davinciucberkeley-collab/DillonVTOL/cad/model/Pusher_Cup.SLDPRT

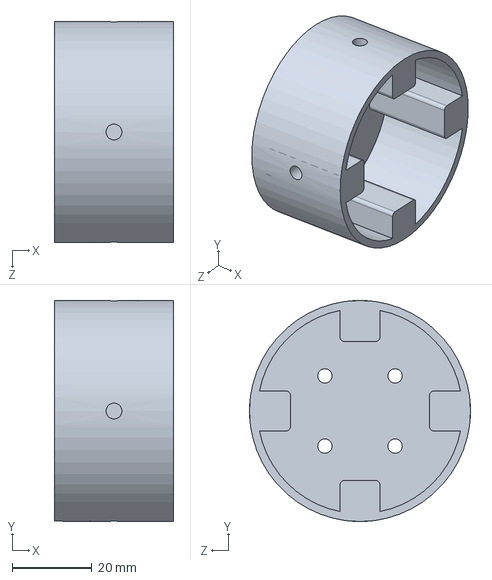
[picture p98: CAD file, 2026-11-04]
cad/model/Pusher_Cup.SLDPRT
30.0 x 55.6 x 55.6 mm
