davinciucberkeley-collab/DillonVTOL/cad/model/Boom_Clamp_F_Lower.SLDPRT

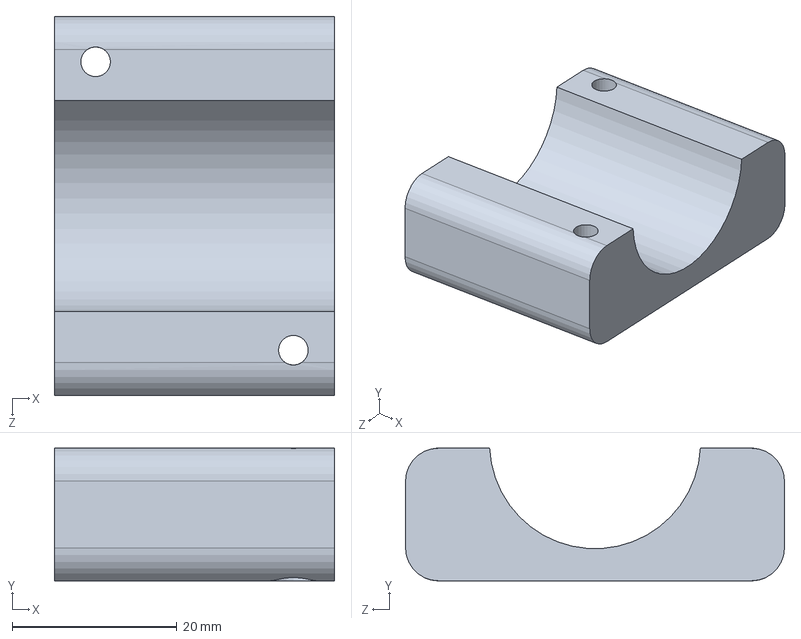
[picture p99: CAD file, 2026-11-04]
cad/model/Boom_Clamp_F_Lower.SLDPRT
34.0 x 16.1 x 46.0 mm
