davinciucberkeley-collab/DillonVTOL/cad/model/Pitot_Clamp.SLDPRT

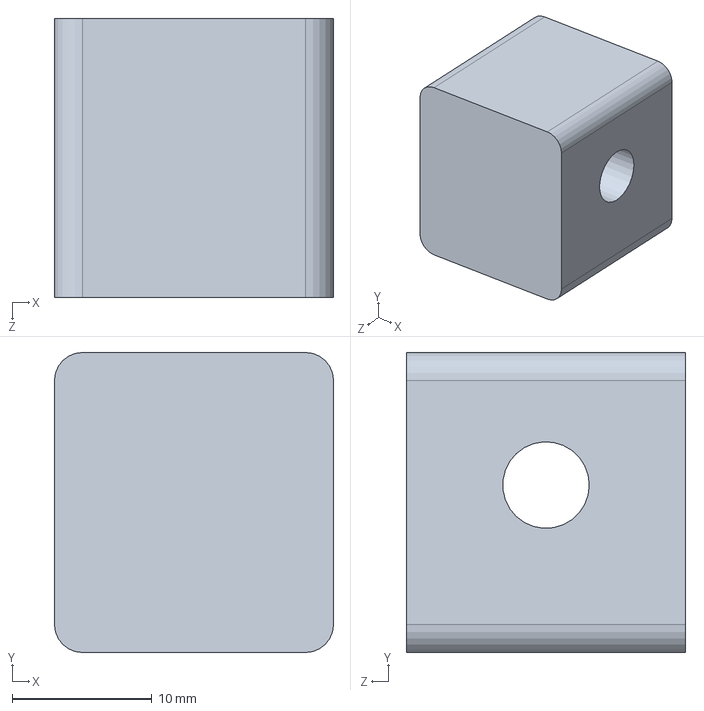
[picture p100: CAD file, 2026-11-04]
cad/model/Pitot_Clamp.SLDPRT
20.0 x 21.5 x 20.0 mm
