davinciucberkeley-collab/DillonVTOL/cad/model/F01_M3x8_SHCS.SLDPRT

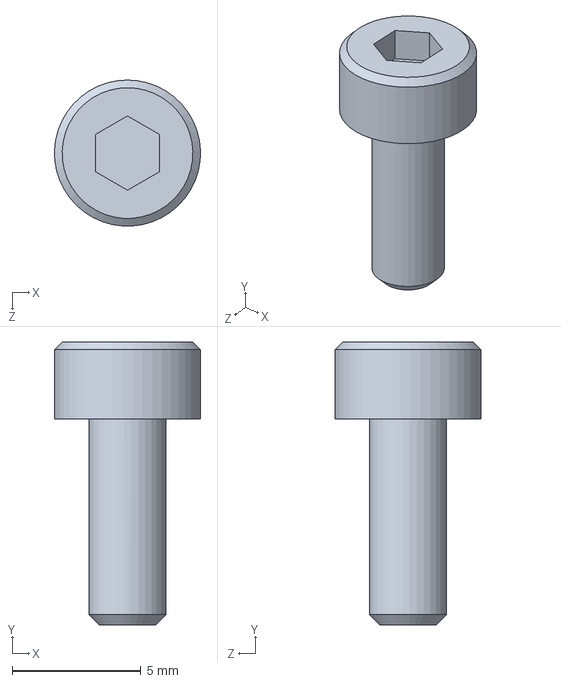
[picture p101: CAD file, 2026-11-04]
cad/model/F01_M3x8_SHCS.SLDPRT
5.68 x 11.0 x 5.67 mm
