davinciucberkeley-collab/DillonVTOL/cad/model/Joiner_Stop.SLDPRT

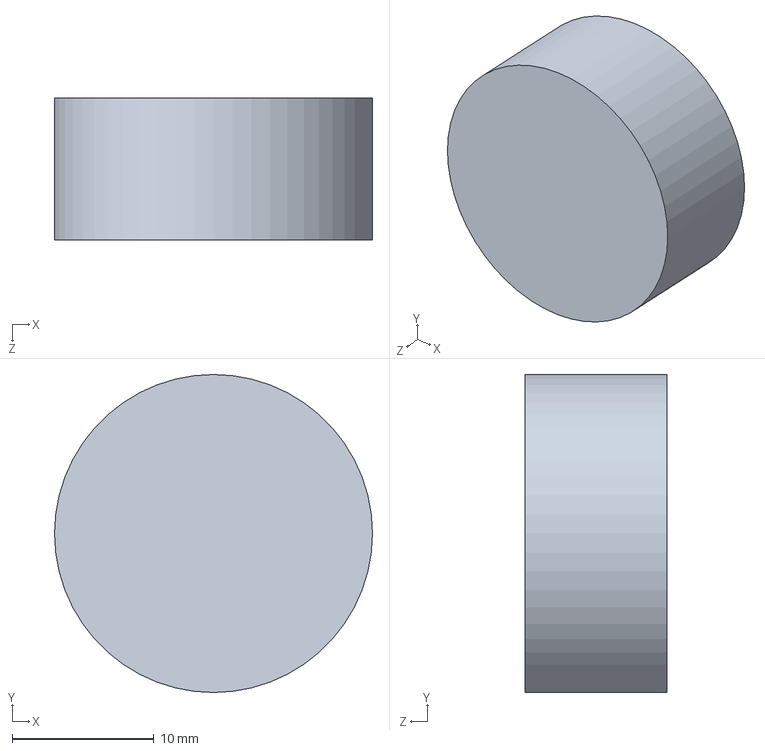
[picture p102: CAD file, 2026-11-04]
cad/model/Joiner_Stop.SLDPRT
22.4 x 22.4 x 10.0 mm
