davinciucberkeley-collab/DillonVTOL/cad/model/Pusher_Adapter.SLDPRT

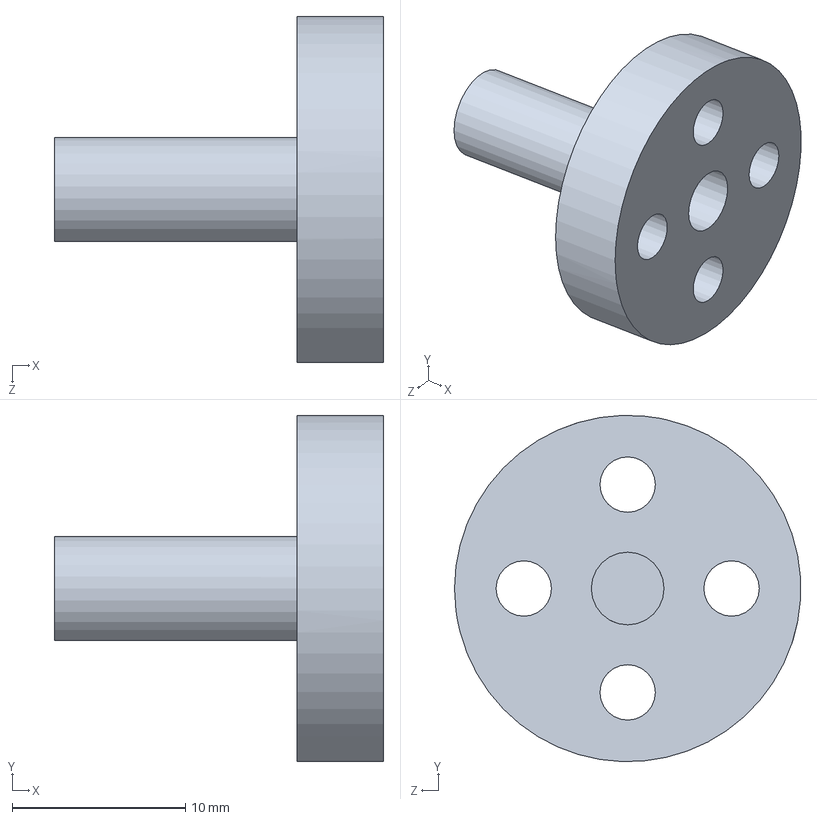
[picture p103: CAD file, 2026-11-04]
cad/model/Pusher_Adapter.SLDPRT
19.0 x 20.0 x 20.0 mm
