davinciucberkeley-collab/DillonVTOL/cad/model/F06_M3x35_SHCS.SLDPRT

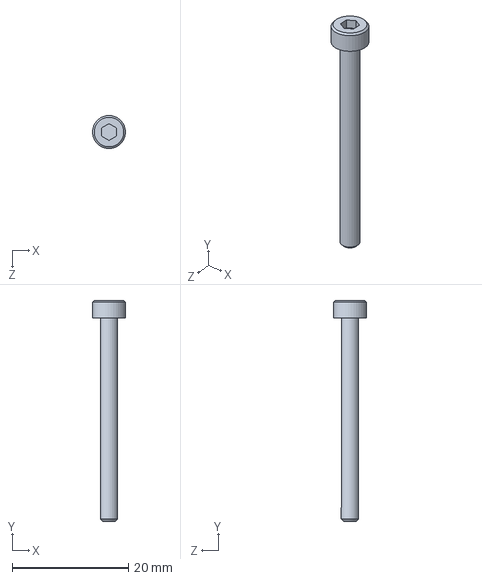
[picture p105: CAD file, 2026-11-04]
cad/model/F06_M3x35_SHCS.SLDPRT
5.67 x 38.0 x 5.67 mm
