davinciucberkeley-collab/DillonVTOL/cad/model/Pitot_Tube.SLDPRT

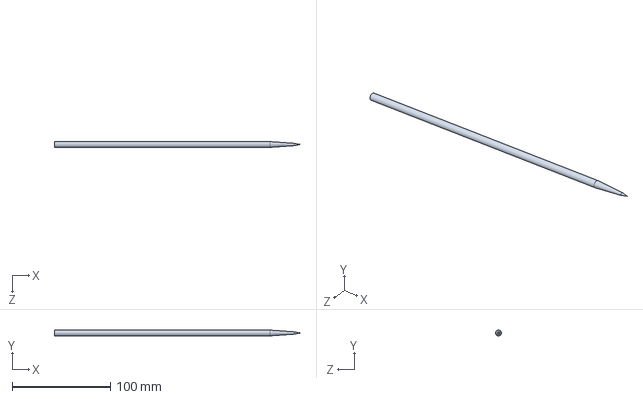
[picture p106: CAD file, 2026-11-04]
cad/model/Pitot_Tube.SLDPRT
250.0 x 5.99 x 5.98 mm
