davinciucberkeley-collab/DillonVTOL/cad/model/F04_M3x40_SHCS.SLDPRT

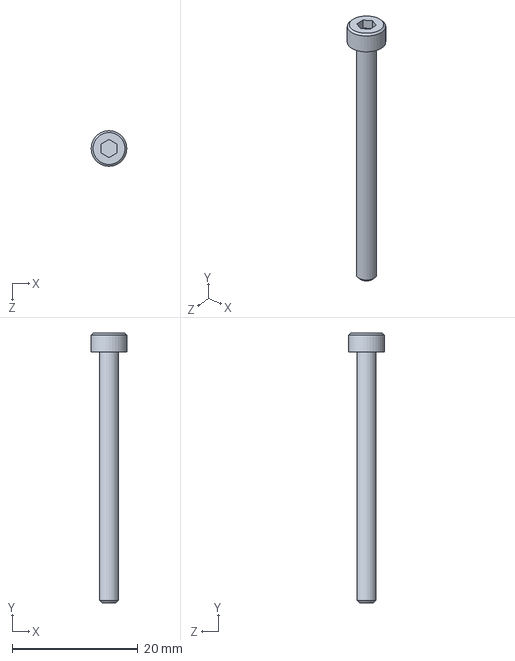
[picture p107: CAD file, 2026-11-04]
cad/model/F04_M3x40_SHCS.SLDPRT
5.68 x 43.0 x 5.68 mm
