davinciucberkeley-collab/DillonVTOL/cad/model/F03_M3x20_SHCS.SLDPRT

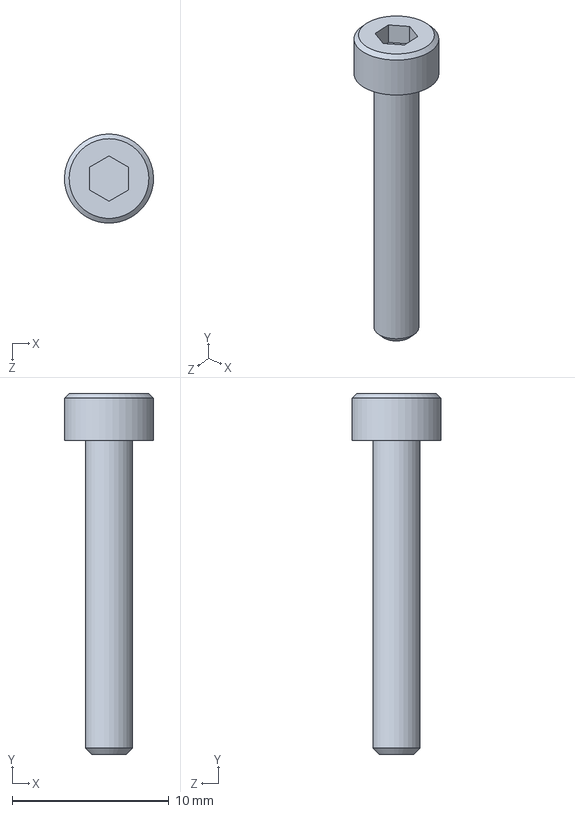
[picture p108: CAD file, 2026-11-04]
cad/model/F03_M3x20_SHCS.SLDPRT
5.68 x 23.0 x 5.67 mm
