davinciucberkeley-collab/DillonVTOL/cad/model/Fin.SLDPRT

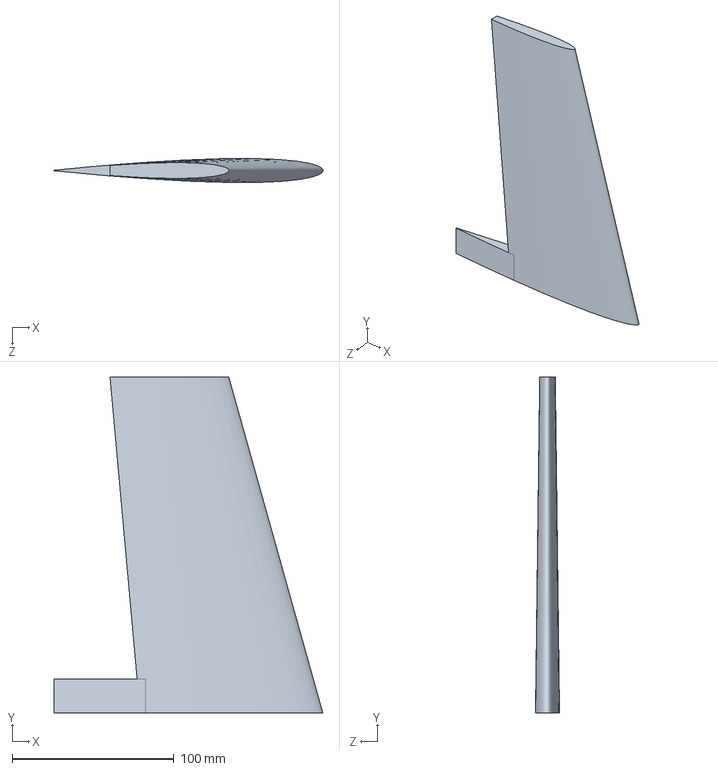
[picture p109: CAD file, 2026-11-04]
cad/model/Fin.SLDPRT
166.4 x 208.0 x 14.9 mm
