davinciucberkeley-collab/DillonVTOL/cad/model/F10_M2x10_SHCS.SLDPRT

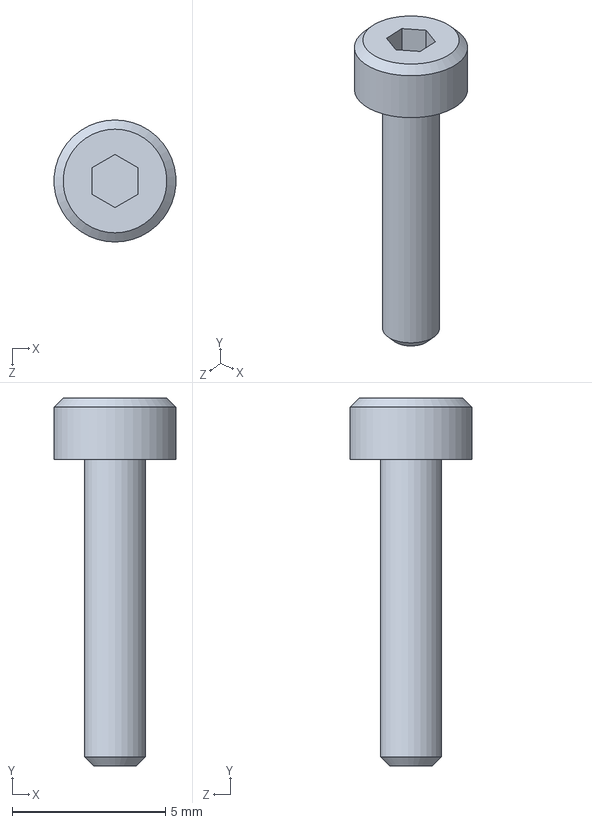
[picture p110: CAD file, 2026-11-04]
cad/model/F10_M2x10_SHCS.SLDPRT
3.97 x 12.0 x 3.98 mm
