davinciucberkeley-collab/DillonVTOL/cad/model/F07_M3x8_BHCS.SLDPRT

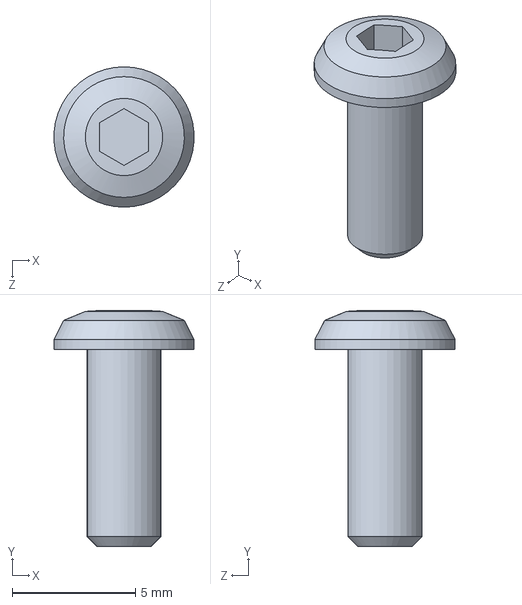
[picture p111: CAD file, 2026-11-04]
cad/model/F07_M3x8_BHCS.SLDPRT
5.69 x 9.59 x 5.70 mm
