davinciucberkeley-collab/DillonVTOL/cad/model/Boom_Clamp_F_Upper.SLDPRT

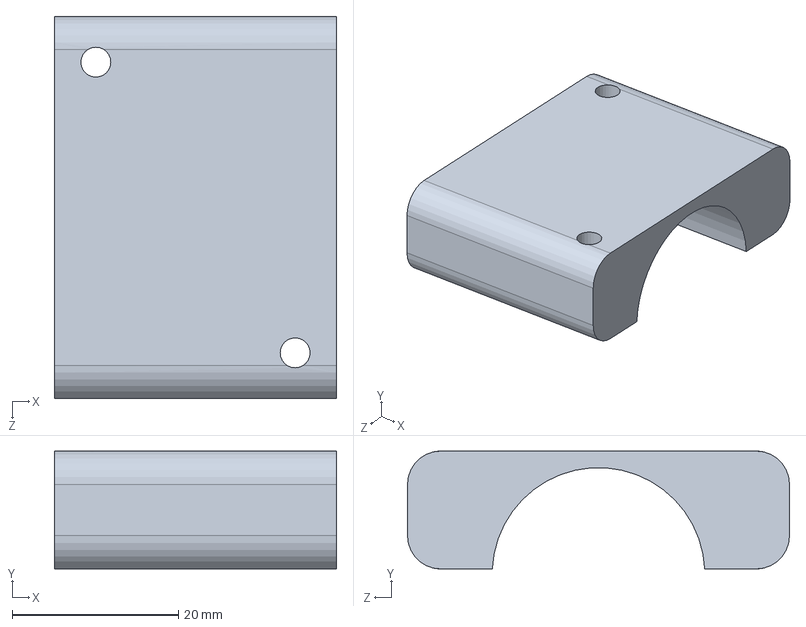
[picture p112: CAD file, 2026-11-04]
cad/model/Boom_Clamp_F_Upper.SLDPRT
34.0 x 14.2 x 46.0 mm
