davinciucberkeley-collab/DillonVTOL/cad/model/Canopy.SLDPRT

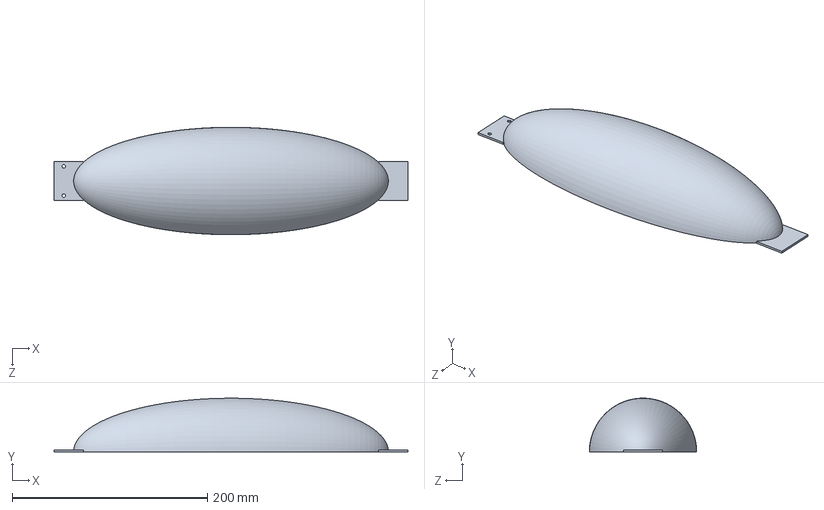
[picture p113: CAD file, 2026-11-04]
cad/model/Canopy.SLDPRT
362.5 x 54.9 x 110.0 mm
