davinciucberkeley-collab/DillonVTOL/cad/model/Pusher_Prop_14in.SLDPRT

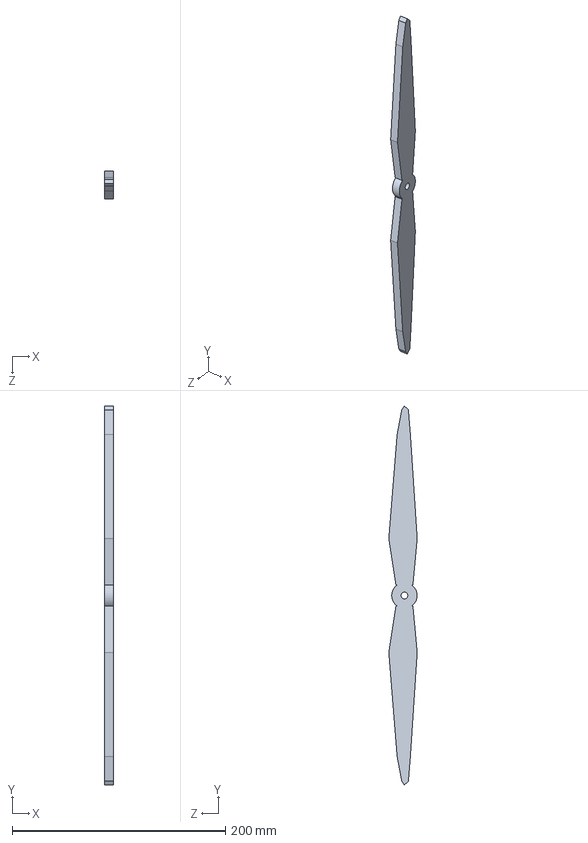
[picture p114: CAD file, 2026-11-04]
cad/model/Pusher_Prop_14in.SLDPRT
8.00 x 355.6 x 26.7 mm
