davinciucberkeley-collab/DillonVTOL/cad/model/Elevator.SLDPRT

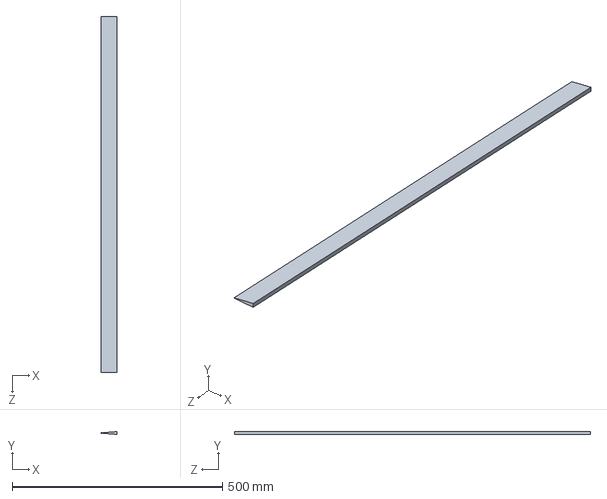
[picture p115: CAD file, 2026-11-04]
cad/model/Elevator.SLDPRT
37.5 x 6.87 x 845.8 mm
