davinciucberkeley-collab/DillonVTOL/cad/model/Boom_Front.SLDPRT

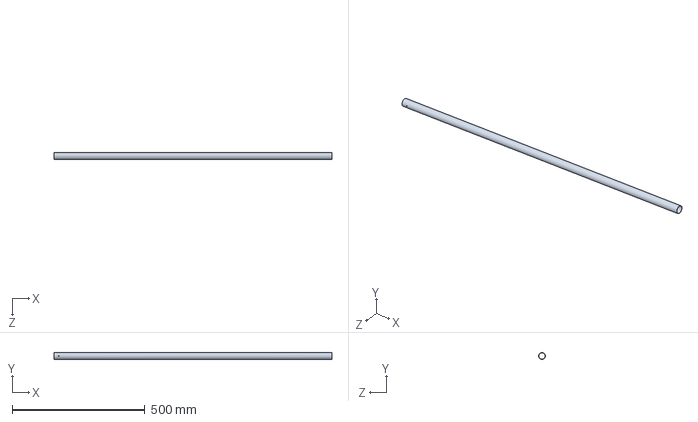
[picture p116: CAD file, 2026-11-04]
cad/model/Boom_Front.SLDPRT
1046.0 x 25.3 x 25.4 mm
