davinciucberkeley-collab/DillonVTOL/cad/model/Fuselage_Pod.SLDPRT

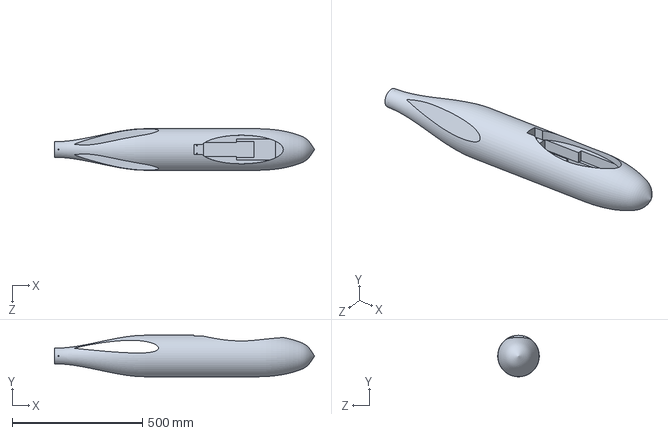
[picture p117: CAD file, 2026-11-04]
cad/model/Fuselage_Pod.SLDPRT
1000.0 x 159.9 x 160.0 mm
