davinciucberkeley-collab/DillonVTOL/cad/model/Prop_Plate.SLDPRT

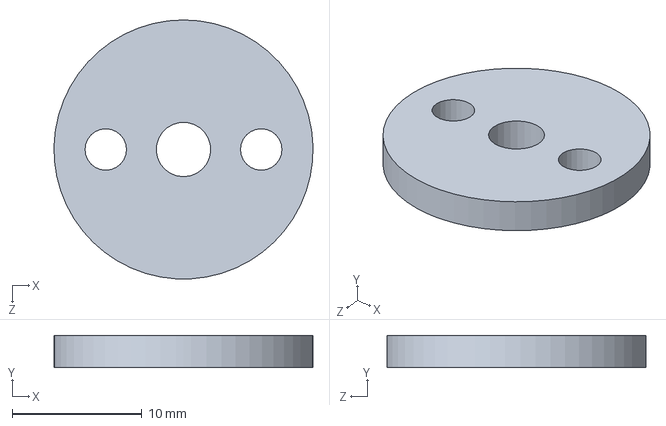
[picture p118: CAD file, 2026-11-04]
cad/model/Prop_Plate.SLDPRT
20.0 x 2.50 x 20.0 mm
