davinciucberkeley-collab/DillonVTOL/cad/model/Spar_Tube.SLDPRT

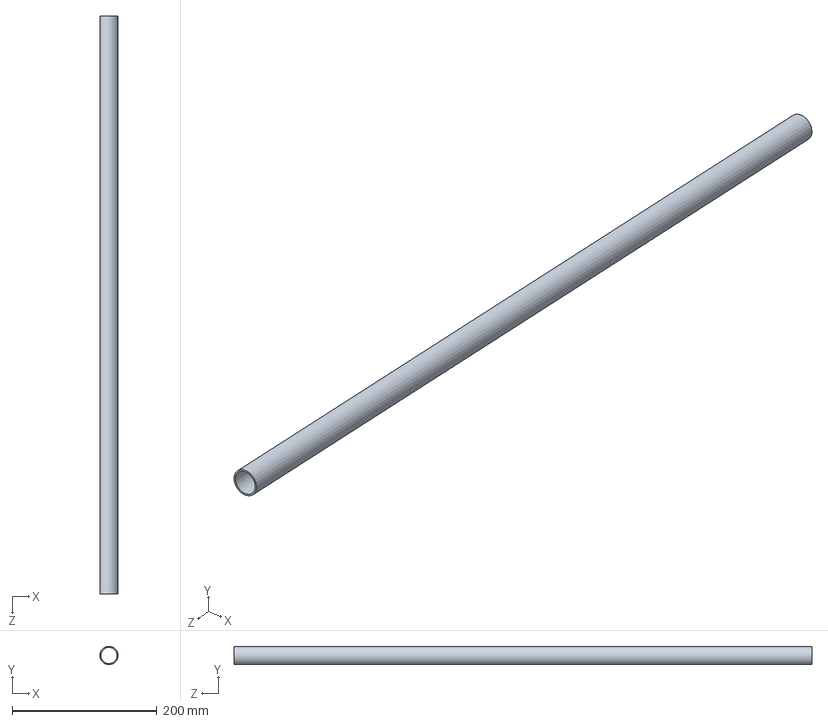
[picture p119: CAD file, 2026-11-04]
cad/model/Spar_Tube.SLDPRT
25.4 x 25.4 x 800.0 mm
