davinciucberkeley-collab/DillonVTOL/cad/model/Gear_Clamp_Lower.SLDPRT

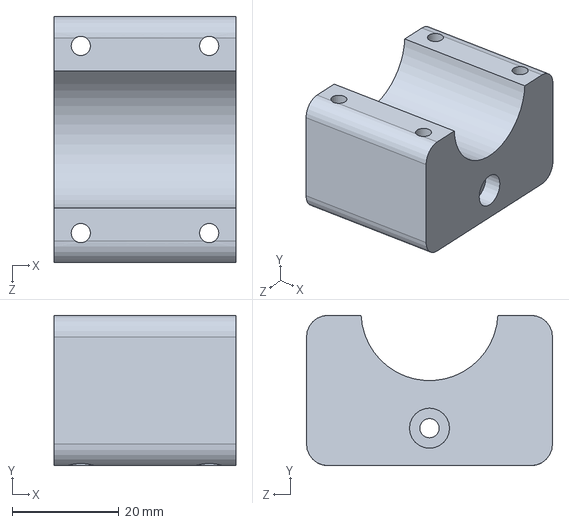
[picture p120: CAD file, 2026-11-04]
cad/model/Gear_Clamp_Lower.SLDPRT
34.0 x 28.1 x 46.0 mm
