davinciucberkeley-collab/DillonVTOL/cad/model/Horn_Hardpoint.SLDPRT

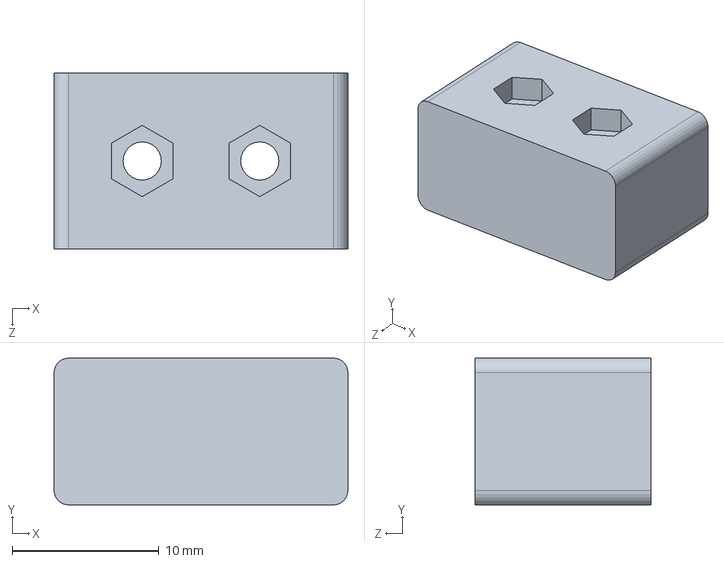
[picture p121: CAD file, 2026-11-04]
cad/model/Horn_Hardpoint.SLDPRT
20.0 x 10.0 x 12.0 mm
