davinciucberkeley-collab/DillonVTOL/cad/model/Splice_Plug.SLDPRT

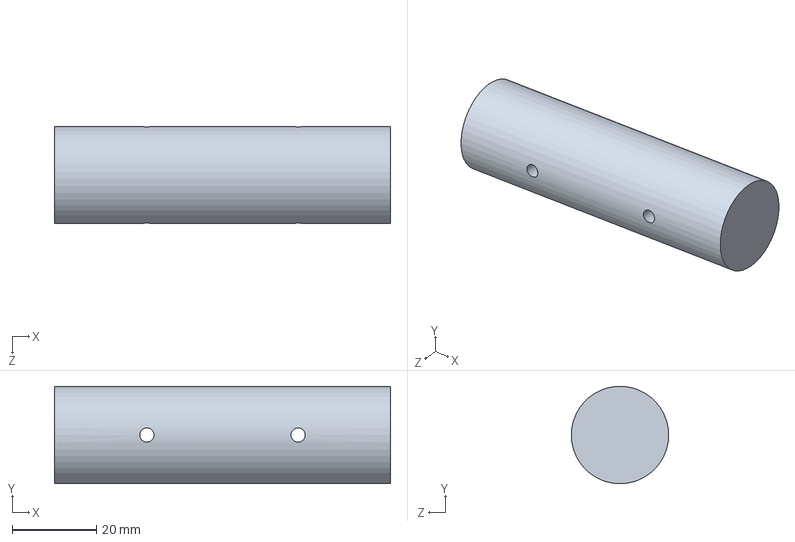
[picture p122: CAD file, 2026-11-04]
cad/model/Splice_Plug.SLDPRT
80.0 x 23.1 x 23.2 mm
