davinciucberkeley-collab/DillonVTOL/cad/model/N02_M5_Nylock.SLDPRT

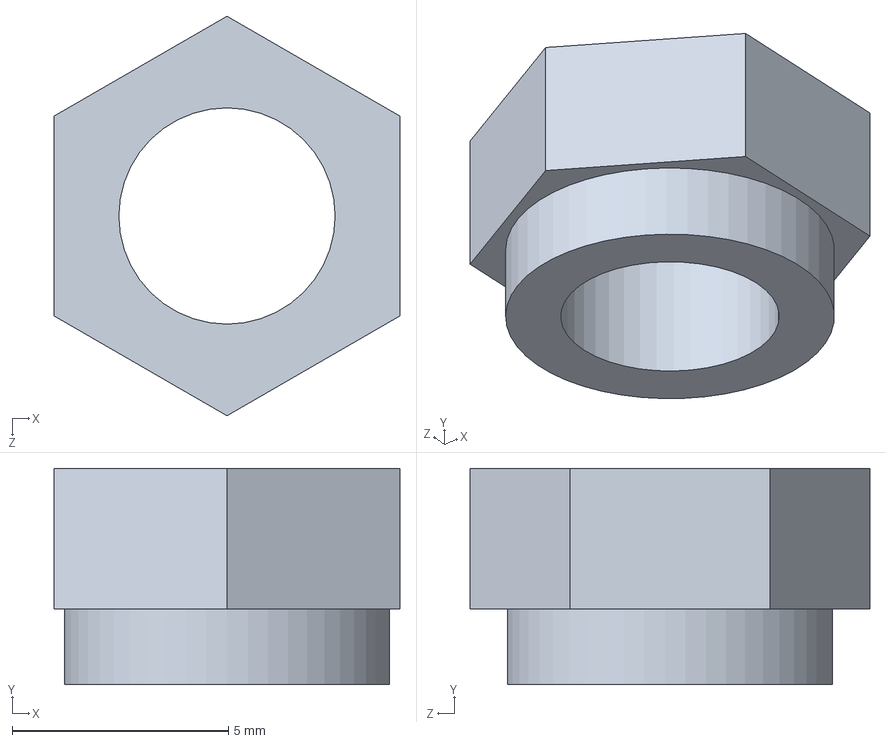
[picture p123: CAD file, 2026-11-04]
cad/model/N02_M5_Nylock.SLDPRT
8.00 x 5.00 x 9.24 mm
