davinciucberkeley-collab/DillonVTOL/cad/model/H_Tail.SLDPRT

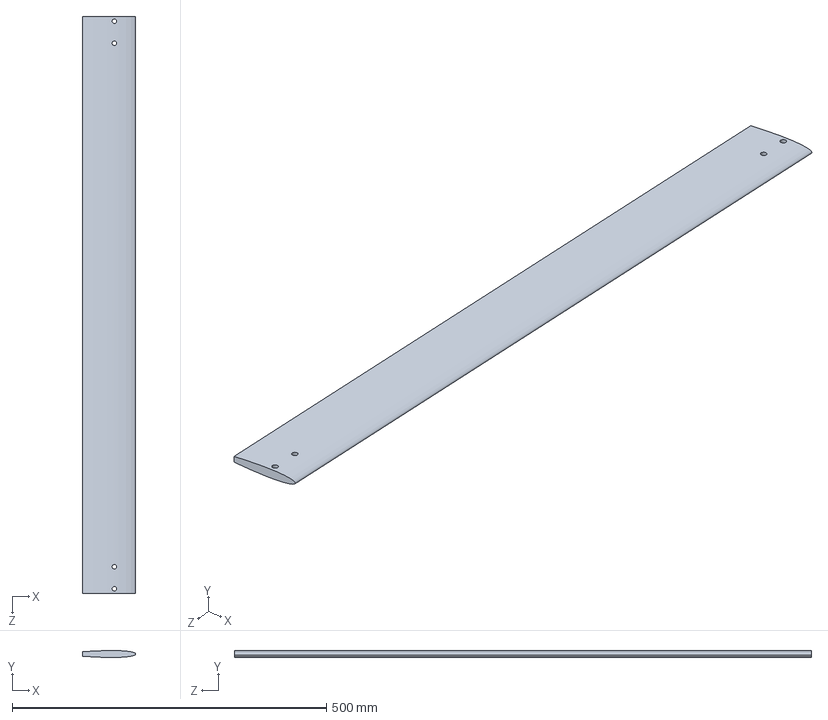
[picture p124: CAD file, 2026-11-04]
cad/model/H_Tail.SLDPRT
85.0 x 11.3 x 917.4 mm
