davinciucberkeley-collab/DillonVTOL/cad/model/Servo.SLDPRT

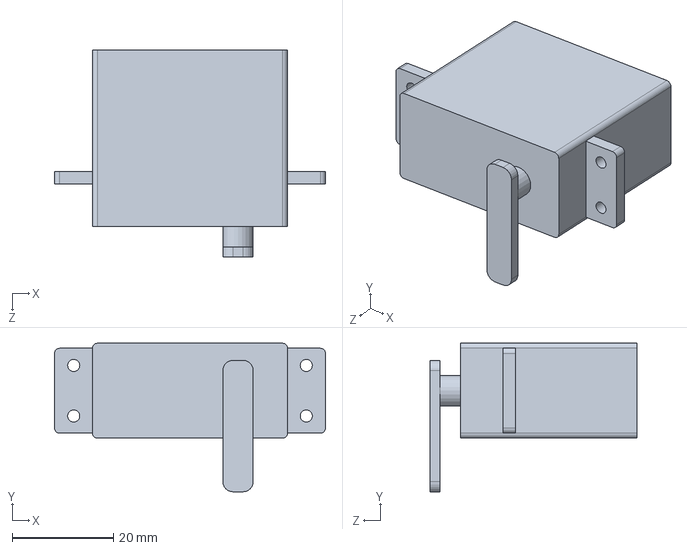
[picture p125: CAD file, 2026-11-04]
cad/model/Servo.SLDPRT
53.6 x 29.4 x 40.9 mm
