davinciucberkeley-collab/DillonVTOL/cad/model/Spar_Collar.SLDPRT

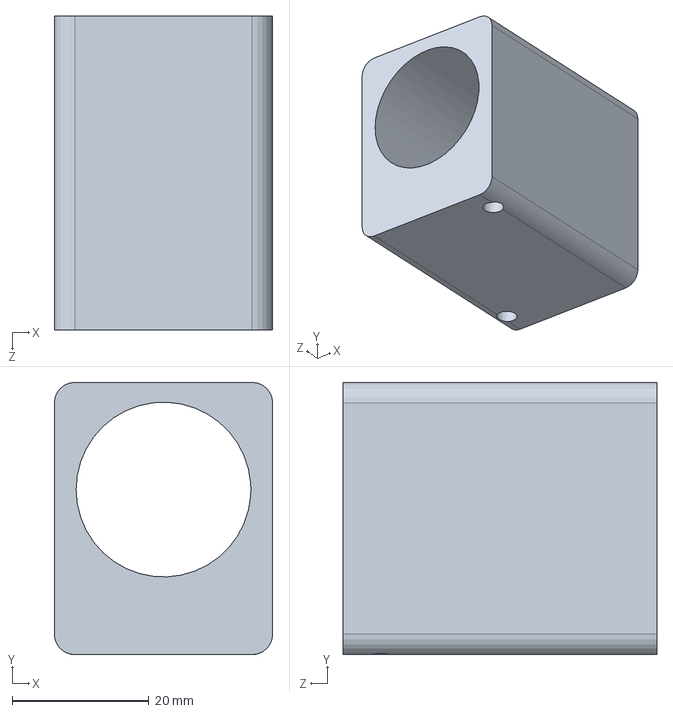
[picture p126: CAD file, 2026-11-04]
cad/model/Spar_Collar.SLDPRT
32.0 x 39.9 x 46.0 mm
