davinciucberkeley-collab/DillonVTOL/cad/model/Boom_Clamp_R_Upper.SLDPRT

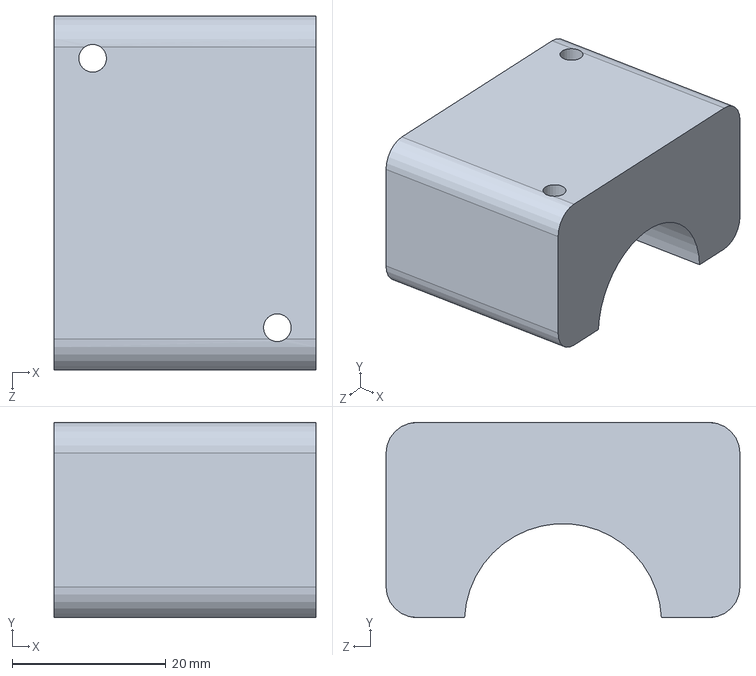
[picture p127: CAD file, 2026-11-04]
cad/model/Boom_Clamp_R_Upper.SLDPRT
34.0 x 25.4 x 46.0 mm
