davinciucberkeley-collab/DillonVTOL/cad/model/F02_M3x16_SHCS.SLDPRT

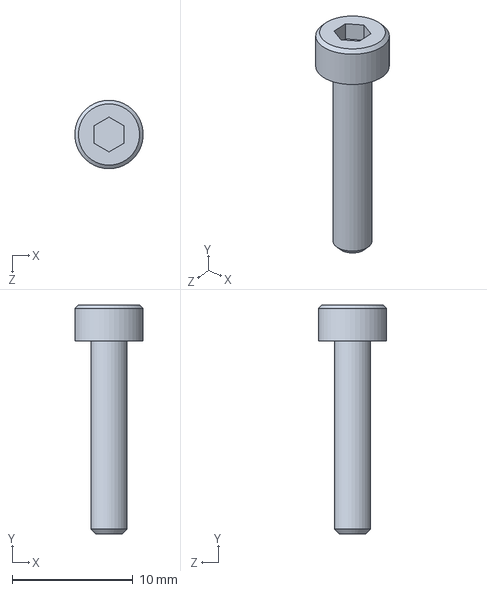
[picture p128: CAD file, 2026-11-04]
cad/model/F02_M3x16_SHCS.SLDPRT
5.66 x 19.0 x 5.68 mm
