davinciucberkeley-collab/DillonVTOL/cad/model/Wing_Saddle.SLDPRT

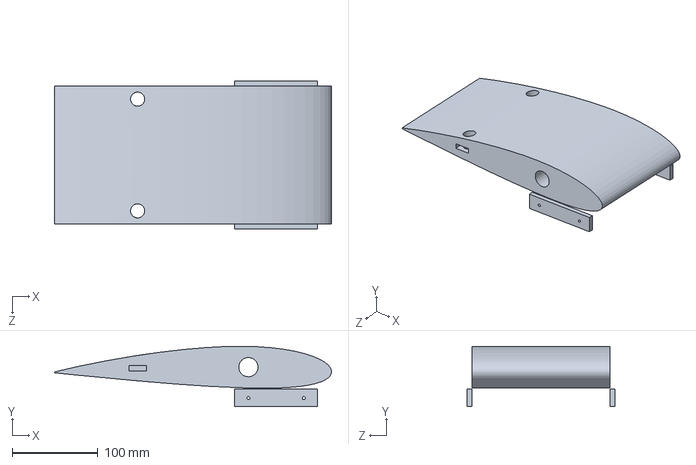
[picture p129: CAD file, 2026-11-04]
cad/model/Wing_Saddle.SLDPRT
322.3 x 70.3 x 172.0 mm
