davinciucberkeley-collab/DillonVTOL/cad/model/Rudder.SLDPRT

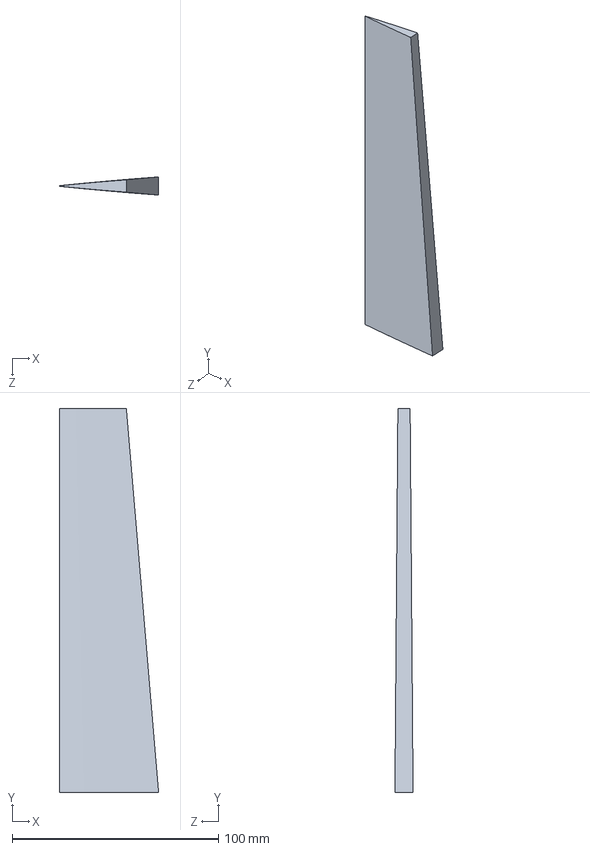
[picture p130: CAD file, 2026-11-04]
cad/model/Rudder.SLDPRT
48.1 x 186.0 x 8.80 mm
