davinciucberkeley-collab/DillonVTOL/cad/model/Motor_Mount_Upper.SLDPRT

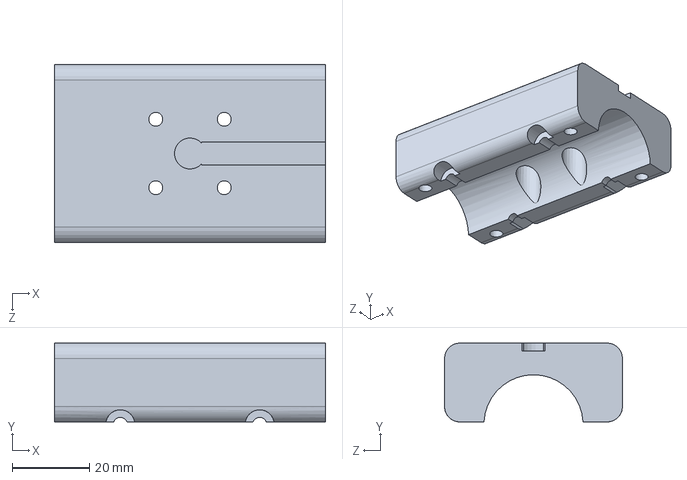
[picture p131: CAD file, 2026-11-04]
cad/model/Motor_Mount_Upper.SLDPRT
70.0 x 20.4 x 46.0 mm
