davinciucberkeley-collab/DillonVTOL/cad/model/F08_M3x12_SHCS.SLDPRT

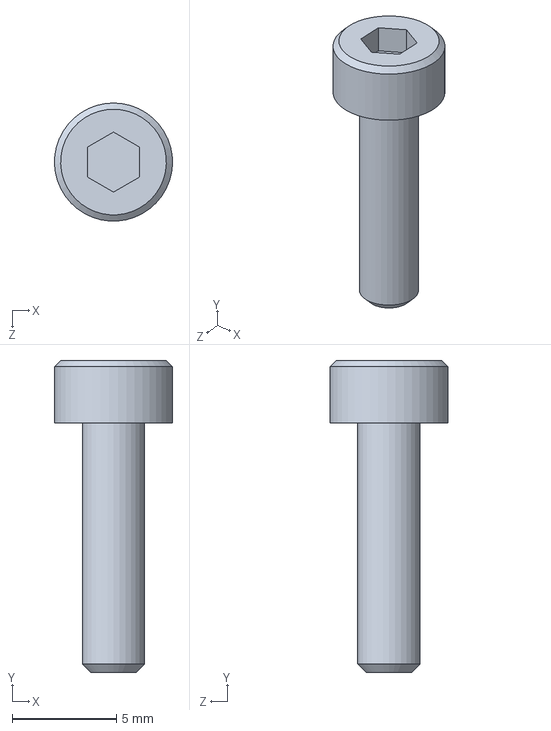
[picture p133: CAD file, 2026-11-04]
cad/model/F08_M3x12_SHCS.SLDPRT
5.68 x 15.0 x 5.67 mm
