davinciucberkeley-collab/DillonVTOL/review/build-manual.html

Skip to content

← Design review DBF-RPT-001DBF-MAN-001 Full document

# Build manual, C0 lift + cruise VTOL

DBF-MAN-001Contents

Section

Field | Value
Document | DBF-MAN-001

Revision

B, 2026-10-21 (Rev A same day; Rev B folds in design v0.4 / drawing DBF-DRW-001 rev B: wing 0.632 m², chord 263 mm; booms 960.8 + 485.9 mm; slip-fit joiner with stops; leg fairings; rudders; F05 M3 × 30; Ø7.5 motor counterbores; BOM v0.4; firmware output map; ballast rule). 2026-10-25: values re-based on the R11 wing re-size, chord 266.6 mm, MTOW 6.45 kg (wing 0.640 m², front boom 965.7 mm; CAD model rev C, drawing DBF-DRW-001 rev D). 2026-10-25: re-based on the 11.75 m/s design stall target, chord 284.2 mm, MTOW 6.55 kg, CAD model rev D, drawing DBF-DRW-001 rev E (docs/research/stall-margin.md; wing 0.682 m², front boom 991.0 mm; thermal build steps from docs/research/thermal.md §6.4 added in WP2 2.7, WP7 7.8, WP8 8.2a/8.3 and WP10 10.1); the Rev B history in §8 keeps its old numbers. 2026-10-26: 27 step figures added to §4, rendered from the CAD model (cad/BuildFigs.cs, docs/build/figs.txt, docs/build/img/); print list P03 no longer calls for vent slots (step 2.7). 2026-11-02: re-based on the frozen 2026-11-01 design (analysis/results.json generated 2026-11-01: MTOW 7.44 kg, chord 322.3 mm, wing 0.774 m²; front boom 1046.0 mm, pod 1.000 m; no payload and no ballast, DESIGN-BASIS R12 revised 2026-11-01; BOM rev 2026-11-01 parts: LANRC BLHeli_S 45A ESCs, RMRC SAM-M10Q-5883 GPS, RMRC MS4525DO airspeed, Amass AS150U battery plug, M5 × 25 wing bolts; 25 °C design ambient, DESIGN-BASIS R21; thermal re-run 2026-11-02, cad/sim/thermal/results.txt). 2026-11-03: CAD clash fixes and drawing rev F (rudder rods 88 mm, left rudder servo 19 mm aft, pod hatch slots 30 mm, joiner coaxiality check in 4.7; cad/verification.txt 0 unexplained interferences). 2026-11-03 (later): team cross-check with DBF-VTOL, drawing rev G (battery access well, 225 mm bay and 220 mm tray for the ± 30 mm CG slide, FC tray at x +0.4075; servo stall current, per-motor current cap, clamp re-torque; §8.2 items 18–21, docs/research/team-crosscheck.md). Dated history entries keep their old numbers.
Design baseline | C0 4-lift twin boom, 2026-11-01 sizing (analysis/results.json, cad/README.md "Model content"; CAD rebuilt 2026-11-03 with the clash fixes, cad/verification.txt: 0 unexplained interferences), hardware rev B (cad/hardware.json, docs/research/hardware-spec.md incl. "CAD implementation notes (rev B)"), drawing set DBF-DRW-001 rev F, 9 sheets (cad/drawings/, regenerated 2026-11-03 from the current params.txt; GA note 4 reads no payload, no ballast, R12; cad/drawings/layout-check.txt 0 overlaps), aero inputs docs/research/aerodynamics.md, firmware package firmware/ (README.md, vtol_c0.param).
Scope | Everything from opening the boxes to a flight-ready aircraft on the bench: receiving, printing, tube work, foam cores, skins and control surfaces, tail, booms, pod, electrical, avionics, firmware hand-off, weight and balance, final inspection, transport breakdown. Flight testing is in review §[flighttest] and firmware/checklists.md and is not repeated.
Companion files | docs/build/cut-list.csv, docs/build/print-list.csv, docs/build/wiring.csv, docs/build/templates/*.svg (1:1 hot-wire templates from docs/build/templates/make_templates.py, which reads cad/params.txt), cad/hardware.json (fastener IDs F01–F13, N01–N04, W01, I01, fits FT01–FT11), cad/verification.txt (part masses).
Drawing sheets (rev G) | 1 general arrangement (breakdown notes; note 4 no payload, no ballast, R12) · 2 exploded assembly · 3 parts list · 4 wing panel, saddle, wing-bolt pillar · 5 motor mount and boom splice · 6 boom, gear and tail clamps · 7 tube cut list, landing leg, leg fairing · 8 fastener schedule and torques · 9 printed hardpoints and trays (cad/README.md "Drawing set").
Conventions | Every number cites a repo file, a formula (calc) or a URL with the date checked. EST = engineering estimate. — = not published / not yet measured. Fastener IDs from cad/hardware.json. Aircraft frame: X forward from the wing leading edge, Y up, Z right (cad/params.txt); "aft of the LE" = −X. Part-local clamp frame: boom axis = local x, split plane = local y 0. Torques in N·m. Time estimates are for the people stated unless marked "machine".
Step format | Bold "N.N Title." then the fields Parts / Fasteners / Tools / Procedure / Check / Time. Procedure actions are separated by "; ".
Prepared by | Manufacturing engineer (student capstone team, UC Berkeley)

## 1. Safety

Read before the first work session. Initial the WP1 traveler to confirm.

### 1.1 LiPo batteries (Ovonic 6S 6500 mAh, 144 Wh each; analysis/results.json packs)

- Charge only inside the LiPo bag (BOM "Tenergy LiPo bag"), inside the Harbor Freight ammo can with its gasket slit so a venting cell cannot pressurise the can (practice noted in docs/research/budget-energy-test.md §3, "confirm against EH&S"), never unattended, on a non-flammable surface, with the IR thermometer at hand. Charger: HTRC C150 at ≤ 6 A (150 W / 25.2 V = 5.95 A (calc), budget-energy-test §2).
- Storage: 3.80–3.85 V per cell. Never store full.
- Inspect before every charge and every flight: swelling, dents, cut insulation, warm after rest. Any of these: isolate outdoors in the ammo can, do not use. A crashed pack goes outdoors for 30 min before it is touched (review §[flighttest]).
- The Amass AS150U battery plug is the physical disconnect (R20, rev 2026-11-01: 70 A continuous / 140 A for 1 min on 10 AWG; the XT90-S it replaces is rated 40 A continuous, below the hover current): it is the last connector made and the first broken, always with props clear.
- Firmware floor voltages: BATT_CRT_VOLT 19.8 (3.3 V/cell), BATT_LOW_VOLT 21.0 (firmware/vtol_c0.param). Do not bench-run a pack below 21.0 V.
- Never solder on a pack lead with the other lead bare: tape the free lead. Re-terminate one wire at a time (WP9 9.2).

### 1.2 Props and motors

- No prop on any motor during any bench test that is not on the thrust stand or the tie-down (firmware/README.md §7: motor test props OFF). Prop-on tests (T2–T6) only on the stand or with the airframe tied down, everyone behind the plane of the disc, eye protection on.
- Before every powered test: Motor Emergency Stop on CH7 (RC7_OPTION 31) tested, arming switch CH5 known, transmitter in hand.
- Lift props are 17 in (431.8 mm, cad/params.txt liftProp) carbon: treat the disc edge as a blade. Cover prop tips with foam when the aircraft is handled in the shop.
- Max thread depth into the X4110S base is 3.3 mm (SunnySky drawing, hardware-spec §1). A longer screw reaches the windings. Measure every motor screw (hardware-spec M4; WP7 7.1).

### 1.3 Hot-wire foam cutting (XPS FOAMULAR)

- Cut only XPS or EPS. Never polyiso (R-Matte) or any foil-faced board: toxic fumes and melt (Harvard GSD FabLab SOP, fablab.gsd.harvard.edu/health-and-safety/standard-operating-procedure-sop/hot-wire-foam-cutting-eps-and-xps, checked 2026-10-21).
- Local exhaust (snorkel) within 150 mm of the wire, or outdoors with the wind across the table. Styrene fumes from heated XPS are the hazard (same SOP). Without exhaust, wear an organic-vapour respirator.
- Safety glasses and heat-resistant gloves. Keep the wire at the minimum power that cuts; switch off between cuts.
- Bench supply with current limit; no mains-voltage wire bows. Bow and supply are the BOM's $40 EST allowance (C0_BOM "Hot-wire bow").

### 1.4 3D printing PA6-CF (Polymaker Fiberon PA6-CF20)

- Prints at 280–300 °C with the fan off (TDS v1.1, fiberon.polymaker.com/wp-content/uploads/TDS_FIBERON-PA6-CF20_V1.1_EN.pdf, read 2026-10-21). Nylon fumes: ventilated room.
- Hardened-steel nozzle mandatory: brass lasts about 9 h on this filament (TDS). Carbon-fibre dust when sanding or drilling PA6-CF: dust mask, vacuum, no compressed air.
- Dry 100 °C / 10 h before printing and keep the spool under 20 % RH (TDS). The motor mount is the hottest, highest-load printed part on the aircraft: a wet spool prints it weak.
- Hot end at 300 °C and the insert iron at ≈ 300 °C: burns. Insert installation only on a heat-proof mat.

### 1.5 Soldering

- 10 AWG battery leads and the AS150U need a ≥ 60 W iron with a chisel tip (makerspace, §2.1). Fume extraction or a fan; wash hands after.
- Never solder a connector while the other half is on a live pack. Heat-shrink every joint before the next one.
- Tin, then join: a cold joint on an 82.1 A transition lead (analysis/results.json C0.sized.I_trans 82.1 A, EST, 20 s) is a fire.

### 1.6 Hand and power tools

- Deburr every tube end immediately (WP3). Drill press: no gloves, clamp the work (printed clamp as the jig), eye protection. Carbon prop balancing and sanding: mask.

### 1.7 Adhesives

- Gorilla 5-min epoxy (kit item 13): gloves, ventilation, 5 min pot life; small joints only on XPS (exotherm melts foam). Foam-safe glue (BOM 4 oz) for every foam bond. Loctite 242 only on metal-to-metal threads (F01 motor screws, F12 prop screws, F13 adapter screws); it cracks PA6-CF and PETG (Henkel TDS, hardware-spec §2d). Never on nylocks.

## 2. Tools, machines, consumables, shop setup, roles

### 2.1 Tools and machines

"On hand" per R6 is an FDM printer and hand tools only (docs/DESIGN-BASIS.md R6). Everything else is makerspace (assumed) at $0 with the fallback shown. Nothing in this table is added to the BOM.

# | Tool / machine | Needed for | Status | $0 fallback

K1 | FDM printer, 0.4 mm nozzle, 300 °C hot end. Bed for the saddle root plate P13 (322.3 mm long = cad/params.txt chord 0.322333; footprint 320.8 × 70.2 mm, cad/mesh/Wing_Saddle.STL bounding box, 2026-11-01): flat needs ≥ 324 × 200 mm (calc: c + 1.4 = 323.7 mm, docs/research/stall-margin.md §2 P13 rule); diagonal needs a bed ≥ 279 × 279 mm (calc: (c + 70.2)/√2 + 1.4 = 279.0 mm, same rule). Fairing P25 is 170 mm tall | WP2 | on hand (R6); model and bed size — (M8) | bed too small for either: print P13 in two halves split across the chord with a 20 mm half-lap (each half 171.2 mm long (calc: 322.3 / 2 + 10), the lap at 46–54 % c, clear of the joiner bore at 30 % c and the tab holes at 10 % and 30 % c; lap 3 mm deep in the 6 mm plate, EST); bond the lap with 5-min epoxy on the flat table, profile against the wing_saddle template, before 5.6; print P25 lying on its side with supports
K2 | Hardened-steel 0.4 mm nozzle | PA6-CF (TDS) | makerspace (assumed) or team-owned (—) | none; brass fails in ≈ 9 h (TDS). If none: print the mounts in PETG and measure the motor case temperature (budget-airframe M3: PETG fails above ≈ 60 °C)
K3 | Filament dryer or oven that holds 100 °C | PA6-CF drying 100 °C/10 h, anneal 100 °C/16 h (TDS) | makerspace (assumed) | kitchen oven at its lowest setting with an oven thermometer
K4 | Soldering station ≥ 60 W, chisel tip 3–5 mm, + conical tip for inserts | WP2 inserts, WP9 | makerspace (assumed) | no $0 fallback exists
K5 | Drill press with vice, bits Ø2.5 / 3.4 / 4.0 / 5.7 / 7.2 mm, Ø22.6 (or step bit) | WP3 cross holes, WP2 counterbores, saddle bore, stabiliser sleeve holes | makerspace (assumed) | hand drill through the printed jig P28 or the clamp itself
K6 | Hacksaw 32 TPI or tube cutter for 25.4 mm | WP3 | hand tool | —
K7 | Mitre box or square-cut jig | tube end squareness 0.5 mm (hardware-spec 5c) | makerspace (assumed) | printed saddle jig (square face on P28)
K8 | Digital calipers 150 mm, 0.01 mm | every "Check" | hand tool (confirm) | —
K9 | Steel rule 1 m, tape 3 m, square, scriber | WP3, WP4, WP12 | hand tool | —
K10 | Kitchen scale 5 kg × 1 g and a luggage/spring scale 20 kg | WP1, WP12, proof loads | on hand (assumed) | borrow
K11 | Torque screwdriver 0.2–2 N·m | all torqued joints | makerspace (assumed) | hanging mass: T = m g L; 0.5 N·m = 0.85 kg at 60 mm, 0.6 = 1.02 kg, 0.8 = 1.36 kg, 1.0 = 1.70 kg at 60 mm (calc, hardware-spec §2d)
K12 | Hex keys 1.5 / 2.0 / 2.5 / 3.0 mm (long-arm), 5.5 mm and 8 mm nut spinners, 10 mm spanner (bullet nut AF EST) | F10 / F07 / F01–F08, F13 / F09; N01 / N02 / N04 | hand tool | —
K13 | Hot-wire bow 1.3 m with 0.5 mm nichrome, bench supply | WP4, WP6, WP8 | BOM line "Hot-wire cutter": NICE-POWER 0–30 V / 0–10 A supply + Ni80 24 AWG (0.51 mm) nichrome 50 ft, $41.73 (C0_BOM.csv; docs/research/bom-savings.md, checked 2026-11-01); bow frame from shop stock (—) | makerspace bow
K14 | Multimeter | WP9, WP10 | hand tool (confirm) | —
K15 | Watt meter 150 A / 60 V, IR thermometer, 20 kg load cell + HX711 + Nano (thrust stand) | T1–T6, calibration | BOM "Test & safety" lines | —
K16 | Heat gun or lighter for heat shrink; the heat gun also shrinks the tape skin | WP5, WP9 | hand tool | soldering-iron barrel (slow)
K17 | Sanding block, 120 / 240 / 400 grit, 600 mm sanding board for foam | WP4–WP8, joiner lapping | hand tool; grit from the makerspace (assumed) | —
K18 | Laptop with Mission Planner, STM32CubeProgrammer, ESC-Configurator (browser), ExpressLRS Configurator; USB-C cable | WP11 (firmware/README.md §1) | team laptop | —
K19 | Phone spectrum app (boom frequency, review M5.2) and a phone Remote ID app | WP7, WP10 | phone | —

### 2.2 Consumables (all in the BOM unless marked Gap; docs/purchasing/C0_BOM.csv rev 2026-11-01, committed $1,854.17, reserve $145.83)

Item | BOM line / research | Used in
ELEGOO PETG 1 kg × 2 | C0_BOM | WP2: ≈ 1.0 kg EST (print-list sum, incl. 4 fairings)
Polymaker PA6-CF20 500 g | C0_BOM | WP2: ≈ 0.40 kg EST (P01–P03 + coupon; cad/verification.txt masses). Tight: no spare motor mount from one spool.
ruthex RX-M3x5.7 × 100 (67 needed) | C0_BOM (replaces generic inserts) | WP2
Bolt Depot A2 fasteners (14 lines, hardware-spec §6; BD-5 is now M3 × 30, Bolt Depot 6385, $0.10 EST, hardware-spec CAD notes J07) | C0_BOM "A2 metric fasteners per HS §6" | WP5–WP10
Loctite 242, 6 ml | C0_BOM | F01, F12, F13 only
Gorilla 5-min epoxy 0.85 oz | C0_BOM | dome feet, joiner stops (tube side), prop balance
Foam-safe glue 4 oz | C0_BOM | all foam bonds, spar sockets (38.8 cm³ bond line, hardware-spec J20)
Scotch heavy-duty packing tape 6 rolls | C0_BOM | skins and all control-surface hinges (hinge tape removed from BOM v0.4; hardware-spec §7)
10 / 12 / 14 AWG silicone wire; Amass AS150U × 2 sets (aircraft male + 2 pack females, Neu Racing); XT60H × 12 pr (one per ESC at the boom disconnects); heat shrink; zip ties; 300 mm servo leads × 40 (4 packs: lines "300 mm servo extension leads" ×1, "2nd pack" ×1, "2 more packs" ×2) | C0_BOM | WP9 (needs ≈ 11.8 m = 39 leads (calc, WP9 9.8))
Nylon horns 12 sets + M2 × 14 screws + backplates; Du-Bro 230 pushrods × 5 (no spares in v0.4) | C0_BOM | WP5, WP6 — cut each rod once, to the CAD length
EMAX ES3005HV × 5 (no spare in v0.4) | C0_BOM | WP5, WP6
LiPo straps × 10 | C0_BOM | WP8
FOAMULAR NGX F-250 2 in (wing, saddle) and F-150 1 in (tail, pod, canopy) | C0_BOM | WP4, WP6, WP8
Sandpaper, masking tape, paint pen, isopropyl, template backing (ply/aluminium or printed P29) | Gap (§6 G1) | WP3–WP8

### 2.3 Shop setup

- One 2.4 × 0.9 m flat table (wing panel 1.12 m, stabiliser 0.92 m): a door on trestles; check flat with the 1 m rule, gap ≤ 1 mm.
- Hot-wire station: outdoors or by the snorkel, foam block on two 50 mm risers, bow hung level, supply switch within the operator's reach.
- Printer on a hard surface away from drafts (PA6-CF fan off), dryer beside it.
- Battery corner: ammo can on concrete or tile, extinguisher (makerspace), nothing flammable within 1 m.
- Fastener organiser: 14 bins labelled BD-1…BD-14 with the F-IDs they serve (hardware-spec §6; drawing sheet 8).

### 2.4 Team roles (4 people; names —)

Role | Owns | Work packages
Structures lead | tubes, clamps, foam, skins, proof loads | WP3, WP4, WP5, WP6, WP7, WP12
Print lead | all printing, coupons, inserts, print log | WP2 (parallel with WP3–WP6)
Electrical / avionics lead | harness, avionics, firmware hand-off, thrust stand | WP9, WP10, WP11
Integration lead + safety officer | receiving, pod, final inspection, transport, batteries, travelers | WP1, WP8, WP13, WP14

Every traveler is signed by the person who did the work and counter-signed by a second person who repeated the Check.

### 2.5 Open items the build depends on

ID | Item | Blocks
M1 | Tube OD/ID/wall on receipt; joiner fit FT01 (now also FT06, same band) | WP3, WP5
M2 | Hole and bore coupon in PETG and PA6-CF | all of WP2
M3 | Insert torque-out and PA6-CF floor crush | torque values F02–F08
M4 | Motor screw tip ≤ 3.2 mm proud of the floor | WP7, WP8
M5 | JeeFly 1755 hub thickness → F12 length; APC hub 11.2 mm measured by APC (0.44 in, apcprop.com 14x8-5ep, checked 2026-10-21; CAD uses 8 EST) | WP7, WP8
M6 | ES3005HV tab hole size/spacing (CAD 46 × 10 EST); CoreWing hole pattern (CAD 45 × 25 EST) | P17, P18
M7 | Splice and clamp slip test (2 kg on 0.25 m) | WP7 sign-off
M8 | Printer: model —; hot end rated 300 °C? bed ≥ 324 × 200 mm (P13 flat) or ≥ 279 × 279 mm (P13 diagonal), else the K1 two-halves lap-joint split? hardened nozzle available? | WP2
M9 | Airspeed sensor (closed by the BOM rev 2026-11-01). The RMRC MS4525DO sits at I²C 0x28, clear of the board barometer at 0x76 on the only bus, so no address-strap step is needed; firmware/vtol_c0.param already sets ARSPD_TYPE 1 (docs/research/bom-savings.md). On arrival only confirm the part is the MS4525DO and that it is found at boot (WP10 10.5). | WP10, WP11
M10 | Pitot tube OD (CAD 6.0 EST) and the kit's tubing length (RMRC kit) | P19, A05
M11 | Car load space (R4): measure the actual car against the longest pieces, the 1.53 m boom units (31 mm over the 1.5 m R4 estimate, §8.2 item 13), the 1.12 m wing panels and the 1.00 m pod; the joiner always travels loose (WP14) | WP14

## 3. Build sequence and schedule

WP1 receive ──► WP2 print (parallel, ~170 h machine) ──┐
      │                                                 │
      ├─► WP3 tubes ─► WP7 booms + motors ──────────────┤
      │                                                 ├─► WP9 electrical ─► WP10 avionics ─► WP11 firmware
      ├─► WP4 cores ─► WP5 skins + surfaces ─► WP8 pod ─┤        (bench: T1–T6 thrust stand, review Test plan)
      │                                                 │
      └─► WP6 tail ─────────────────────────────────────┘
                                   WP12 CG + W&B ───► WP13 final inspection ─► WP14 transport drill ─► F1 (review Flight test)

WP | Title | Labour EST (person-h) | Machine EST (h) | Depends on
1 | Receiving inspection and measurements | 6 | — | parts delivered
2 | 3D printing, inserts, coupons | 15 | 171 (+15 optional template backs) | M8
3 | Tube cutting and drilling | 8 | — | WP1 M1; P02/P07/P28 printed
4 | Foam wing cores, spar sockets, joiner stops, hardpoint pockets | 15 | — | templates; WP3 sockets
5 | Wing skin, ailerons (tape hinges), servos, saddle, wing bolts, pitot clamp | 22 | — | WP4; P11–P19, P26
6 | Tail: stabiliser, elevator, fins, rudders, shoes, tail servos | 13 | — | WP4 hot-wire station; P08–P10, P17
7 | Booms, motor mounts, motors, props, gear clamps, splice | 15 | 16 anneal | WP2 P01–P04, WP3
8 | Pod, saddle-to-pod, battery/FC trays, pusher, legs + fairings | 17 | — | WP2 P20–P25, WP5 saddle
9 | Electrical harness | 16 | — | WP7, WP8
10 | Avionics install | 9 | — | WP9
11 | Firmware and configuration (firmware/README.md) | 10 + SITL | — | WP10
12 | CG and weight-and-balance record | 4 | — | WP11
13 | Final inspection and proof loads | 6 | — | WP12
14 | Transport breakdown / assembly drill (R5 ≤ 15 min) | 4 | — | WP13
| Total | 160 person-h EST | ≈ 171 h machine EST

The critical path is the printer (≈ 7 days continuous; in practice 3–4 weeks of evenings) and the PA6-CF dry/anneal cycles (26 h per batch). Print order: P27 coupons → P28 jig → P02/P07 caps (drill jigs) → P01/P03 PA6-CF → P25 fairings and the rest. Review §[schedule] plans design freeze 2026-12-04 and first hover 2027-03-13.

## 4. Work packages

Figures in this section are renders of the CAD model (cad/model/VTOL_Concept.SLDASM; the jpg figures were re-rendered from the 2026-11-01 build, the svg step sketches are older and illustrative), not photographs: the aircraft is not built yet. In each, orange marks the parts that step fits, blue their screws, nuts and inserts, and the other parts shown were fitted in earlier steps; translucent parts are drawn see-through so the parts inside them show. They are generated by cad/BuildFigs.cs from the list in docs/build/figs.txt; replace them with build photos as the work is done.

Figure 4.0. The finished aircraft, for orientation: wing, pod and pusher forward, twin booms with four lift units, tail on the boom stubs (Blender render of the CAD meshes, docs/figures/render_scenes.py).

Figure 4.0. The finished aircraft, for orientation: wing, pod and pusher forward, twin booms with four lift units, tail on the boom stubs (Blender render of the CAD meshes, docs/figures/render_scenes.py).

1. WP1: Receiving inspection and measurements
2. WP2: 3D printing
3. WP3: Tube cutting and drilling
4. WP4: Foam wing cores, spar sockets, joiner stops, hardpoint pockets
5. WP5: Wing skin, ailerons, servos, saddle, wing bolts, pitot clamp
6. WP6: Tail: stabiliser, elevator, fins, rudders, shoes, tail servos
7. WP7: Booms, motor mounts, lift motors, props, gear clamps, splice
8. WP8: Pod, saddle-to-pod, battery and FC trays, pusher, landing legs and fairings
9. WP9: Electrical
10. WP10: Avionics install
11. WP11: Firmware and configuration
12. WP12: CG and the weight-and-balance record
13. WP13: Final inspection and proof loads
14. WP14: Transport breakdown and field assembly (R4, R5)

### WP1: Receiving inspection and measurements

Owner: integration lead. Purpose: find wrong parts and bad fits before anything is cut or printed. Record every value on the WP1 traveler.

#### WP1.1 Unpack and count against the BOM

Parts

every BOM line (docs/purchasing/C0_BOM.csv rev 2026-11-01, 51 goods lines).

Fasteners

Bolt Depot order checked against drawing sheet 8 / hardware-spec §6: 139 screws (F01 20, F02 36, F03 16, F04 8, F05 4 M3 × 30, F06 4, F07 11, F08 4, F09 2, F10 20, F11 10 in the horn kit, F13 4 in the motor box), 40 nuts (N01 8, N02 2, N03 30, N04 1), 28 washers, 67 inserts (cad/hardware.json).

Tools

BOM printout, pen.

Procedure

1. open every box
2. tick each line
3. fill "Actual USD" from the invoices
4. sum

Check

every line present, quantity matches; running total ≤ $2,000 incl. tax and shipping (R6; BOM committed $1,854.17).

Time

1 person × 1 h.

Figure 1.1. Unpack and count against the BOM: render from the CAD model (tools and shop items illustrative).

#### WP1.2 Photograph and label

Parts

motors, ESCs, servos, packs.

Tools

phone, masking tape, marker.

Procedure

1. label motors M1–M4 and P (pusher
2. no spare motor is bought, DESIGN-BASIS assumption 4)
3. ESCs 1–5 and the 3 spares
4. servos AL, AR, E, RL, RR
5. packs A/B

Check

every item labelled; photos filed.

Time

1 × 0.3 h.

#### WP1.3 Measure the tubes (hardware-spec M1)

Parts

2 × 1.000 × 0.035 in × 72 in, 1 × 1.000 × 0.058 in × 96 in, 1 × 0.875 × 0.058 in × 36 in.

Tools

calipers, kitchen scale, 1 m rule.

Procedure

1. OD at 3 points per tube
2. wall at both ends
3. weigh
4. roll on the flat table

Check

OD 25.40 ± 0.10 (1.000 in) and 22.23 ± 0.10 (0.875 in); wall 0.89 ± 0.05 (0.035 in), 1.47 ± 0.05 (0.058 in) (hardware-spec §5a); mass within +10 % of 185 / 299 / 259 g/m (budget-airframe §1a); no gap > 1 mm over 1 m. Reject outside these.

Time

1 × 0.5 h.

Figure 1.3. Measure the tubes: render from the CAD model (tools and shop items illustrative).

#### WP1.4 Joiner fit FT01 / FT06 (slip fit)

Parts

joiner tube, 96 in socket tube (uncut).

Tools

hands, 0.1 mm tape for shimming.

Procedure

slide the joiner 300 mm into the socket tube by hand; waggle the tip.

Check

enters by hand; tip movement at 1 m from the socket end ≤ 5 mm (budget-airframe M4). Tight → note "lap" (WP3 3.6). Loose → note "one wrap of packing tape" (hardware-spec FT01). The same band applies to the saddle bores (FT06 rev B).

Time

1 × 0.2 h.

Figure 1.4. Joiner fit FT01 / FT06 (slip fit): render from the CAD model (tools and shop items illustrative).

#### WP1.5 Motors

Parts

5 × SunnySky X4110S 400KV (4 lift + pusher; C0_BOM.csv).

Tools

calipers, scale, multimeter.

Procedure

1. weigh
2. slide a 1755 prop on the shaft
3. measure the base and hub patterns
4. spin the bell
5. measure phase resistances
6. list and measure the box contents (prop plates, M6 adapter, washer, bullet nut, screws: lengths of the 4 adapter screws = F13, CAD assumes 8 mm EST)

Check

mass 165 ± 10 g (sunnyskyusa.com X4110S page, checked 2026-10-21); shaft Ø4.00 (0/−0.03), prop slides by hand (FT09); base 4 × M3 on Ø25 ± 0.2, hub 4 × M3 on Ø12; bell free; phase resistances equal within 10 %; adapter + washer + bullet nut present (N04).

Time

1 × 0.5 h.

Figure 1.5. Motors: render from the CAD model (tools and shop items illustrative).

#### WP1.6 Props (M5)

Parts

3 pairs JeeFly 1755, 3 × APC 14 × 8.5EP.

Tools

calipers, scale.

Procedure

1. measure the 1755 hub thickness t and holes
2. weigh each blade
3. measure the APC hub and pick the adapter ring for Ø6

Check

F12 length = 2.5 + t + 5.0 rounded to 12/16/20, engagement 4.5–8.0 mm (hardware-spec M5); 1755 centre Ø4.0 and 2 × Ø3 on 12 mm; blade pairs within 2 g; APC hub 11.2 mm, Ø20.3, bore 6.35, LPAR06E rings included (apcprop.com, checked 2026-10-21).

Time

1 × 0.3 h.

Figure 1.6. Props (M5): render from the CAD model (tools and shop items illustrative).

#### WP1.7 ESCs, servos, avionics (M6, M9, M10)

Parts

8 × LANRC BLHeli_S 45A (45 A cont / 55 A 10 s, DShot600; docs/research/bom-savings.md), 5 × ES3005HV, CoreWing F405 Wing V2 (+ its 470 µF capacitor and BLE/WiFi module), RMRC SAM-M10Q-5883 GPS/compass, BeeID, RP3 V2, RMRC MS4525DO airspeed + pitot kit, Pocket Crush, 2 × Amass AS150U sets.

Tools

calipers, scale, phone camera.

Procedure

1. record ESC size and mass (—)
2. servo tab hole Ø and spacing (CAD 46 × 10 EST) and whether screws are supplied
3. CoreWing hole pattern (RMRC "30 × 30, custom", checked 2026-10-21
4. CAD 45 × 25 EST) and photograph both board faces
5. pitot tube OD and length, tubing length
6. confirm the airspeed board is the MS4525DO (I²C 0x28, ARSPD_TYPE 1
7. no strap step)
8. pack dimensions and mass (CAD 155 × 50 × 48 EST
9. 820 g per Amazon)

Check

values recorded on the traveler; they go into P17, P18, P19, P21 before printing.

Time

2 × 1 h.

Figure 1.7. ESCs, servos, avionics (M6, M9, M10): render from the CAD model (tools and shop items illustrative).

#### WP1.8 Battery intake

Parts

2 × Ovonic 6S 6500.

Tools

charger, multimeter.

Procedure

1. read every cell
2. inspect
3. set storage charge
4. log

Check

cells 3.75–3.90 V, spread ≤ 0.05 V; no swelling; EC5 connector present (re-terminated to AS150U in WP9 9.2).

Time

1 × 0.5 h + charger time.

Figure 1.8. Battery intake: render from the CAD model (tools and shop items illustrative).

#### WP1.9 Foam and tape

Procedure

inspect every sheet and roll; measure the sheet thickness at four corners.

Check

FOAMULAR sheets flat, thickness 50.8 ± 1.5 and 25.4 ± 1.0 mm; tape 6 × 1.88 in × 54.6 yd (Amazon B000087KUA, checked 2026-10-21).

Time

1 × 0.2 h.

Figure 1.9. Foam and tape: render from the CAD model (tools and shop items illustrative).

WP1 traveler

# | Step | Result / value | Pass | Done by | Checked by | Date

1.1 | BOM count; 139 screws / 40 nuts / 28 washers / 67 inserts; spend $ ___ ≤ 2,000 | | ☐
1.3 | Tube OD / wall / g·m⁻¹ (4 tubes) | | ☐
1.4 | Joiner play ___ mm at 1 m (≤ 5) | | ☐
1.5 | Motor mass ___ g, PCD ___ mm, shaft fit; F13 length ___ | | ☐
1.6 | 1755 hub t ___ mm → F12 length ___ ; APC ring ___ | | ☐
1.7 | Servo tabs ___ ; FC pattern ___ ; pitot OD ___ ; tubing ___ m; airspeed = MS4525DO ☐; pack ___ × ___ × ___ mm, ___ g | | ☐
1.8 | Pack cell voltages, storage set | | ☐
1.9 | Foam / tape | | ☐
— | Safety section read and initialled by all four | | ☐

### WP2: 3D printing

Owner: print lead. Full list: docs/build/print-list.csv (29 part types, 75 printed pieces + optional template backs). Drawing sheets 5 (motor mount, splice plug), 6 (clamps), 7 (fairing), 9 (hardpoints, trays). Settings:

Material | Nozzle | Hot end °C | Bed °C | Fan | Layer | Walls | Infill | Drying | Post | Source
ELEGOO PETG (BOM) | 0.4 brass | 250 ± 10 | 80 ± 10 | 50 % | 0.2 | 4 (clamps); 100 % walls (small hardpoints, pillars, tongues, stops) | 40 % gyroid clamps; 100 % hardpoints; vase mode fairings | 65 °C / 4 h if stringing (EST) | none | Prusament PETG TDS v1.1 as the PETG reference (ELEGOO publishes no TDS): nozzle 250 ± 10, bed 80 ± 10, fan 50 %, density 1.27, HDT 68 °C; PDF read 2026-10-21
Polymaker Fiberon PA6-CF20 (BOM) | 0.4 hardened steel | 280–300 | 40–50 | off | 0.2 | 5 | 100 % | 100 °C / 10 h, RH < 20 % | anneal 100 °C / 16 h | Fiberon PA6-CF20 TDS v1.1 (read 2026-10-21): density 1.17, HDT 173 °C at 1.8 MPa, up to 300 mm/s, brass nozzle life ≈ 9 h

Mass EST = CAD volume (cad/verification.txt, PETG 1.27 / PA6-CF 1.23 g/cm³) × fill factor; print time EST = volume ÷ 10 cm³/h (PETG) or ÷ 7 cm³/h (PA6-CF) — rates EST for a 0.4 mm nozzle at 0.2 mm layers. Totals EST: PETG ≈ 1.0 kg / 98 h; PA6-CF ≈ 0.40 kg / 47 h + 26 h dry/anneal.

#### WP2.1 Printer check (M8)

Tools

printer, thermometer.

Procedure

1. hold 295 °C for 10 min
2. bed to 80 °C
3. measure the usable bed
4. fit the hardened nozzle for PA6-CF runs and log its hours

Check

no thermal-runaway fault; usable bed recorded; P13 plan chosen: flat (bed ≥ 324 × 200 mm), diagonal (bed ≥ 279 × 279 mm) or the K1 two-halves 20 mm lap-joint split; P25 standing (≥ 170 mm height) or on its side.

Time

1 × 1 h.

Figure 2.1. Printer check (M8): render from the CAD model (tools and shop items illustrative).

#### WP2.2 Coupons P27 — first article (hardware-spec M2)

Parts

P27 in PETG, then in PA6-CF.

Tools

calipers, an M3 screw shank and an insert as pins, a 25.4 tube offcut.

Procedure

1. print
2. measure every hole and ring
3. choose the modelled values that give the target as-printed sizes
4. record the offset per material
5. apply it to every file before slicing

Check

as-printed M3 clearance 3.4 ± 0.1, insert hole 4.0 ± 0.1, bore 25.6 ± 0.1 (FT07, FT08, FT02).

Time

1 × 1.5 h + 3 h machine.

Figure 2.2. Coupons P27 — first article: render from the CAD model (tools and shop items illustrative).

#### WP2.3 Insert and crush test (M3)

Parts

3 × I01 per material in P27; M3 × 8 + W01; a 4.5 mm PA6-CF pad over an aluminium nut on the tube offcut.

Tools

soldering iron with conical tip at print temperature + 10–20 °C (CNC Kitchen, cnckitchen.com/blog/how-to-use-our-threaded-insert-removal-tool, checked 2026-10-21): PETG ≈ 260–270 °C, PA6-CF ≈ 300 °C (EST); hanging-mass torque rig.

Procedure

1. push each insert in square until 0.1–0.3 mm below the surface
2. hold 3 s
3. lift out
4. cool 60 s
5. torque each to spin-out
6. torque the M3 × 8 through the floor pad to 0.6 N·m
7. re-check after 24 h

Check

torque-out ≥ 1.0 N·m on all three per material (2 × the 0.5 N·m working torque); floor screw turns ≤ 30° on re-torque. Fail → halve the working torque or use the longer ruthex insert (§6 G4).

Time

1 × 1 h + 24 h wait.

Figure 2.3. Insert and crush test (M3): render from the CAD model (tools and shop items illustrative).

#### WP2.4 Print the jigs and caps first

Parts

P28 drill guide; P02 × 4 (rear caps carry the splice grooves); P07 × 4.

Tools

calipers, tube offcut.

Procedure

1. print
2. test every bore on the offcut
3. measure counterbore depths

Check

bores 25.6 ± 0.1 (slip, no rock); counterbores per print-list ± 0.2 (gear clamp: Ø6.5 × 15.3, F05 Ø7.5 × 4.0 and nut pocket 5.7 AF × 4.3).

Time

0.5 h labour; machine P28 1.8 h, P02 16 h, P07 16 h.

Figure 2.4. Print the jigs and caps first: render from the CAD model (tools and shop items illustrative).

#### WP2.5 PA6-CF batch: P01 × 4, P03 × 1

Parts

Fiberon PA6-CF20, dried.

Tools

dryer/oven, hardened nozzle, calipers.

Procedure

1. dry 100 °C/10 h
2. print one P01 and stop if the floor or bore is out
3. print the rest
4. anneal all together 100 °C/16 h (TDS)
5. re-measure after annealing (TDS shrinkage ≈ 0.2–0.3 %: a 25.60 bore becomes ≈ 25.53 (calc) — set the model so the post-anneal bore is 25.6 ± 0.1)

Check

floor 4.50 ± 0.15 (cad/hardware.json general_tolerances motor_floor_thickness 4.35–4.65); bore 25.6 ± 0.1 post-anneal; no layer gaps on the floor.

Time

2 h labour; machine 30 h print + 26 h dry/anneal.

Figure 2.5. PA6-CF batch: P01 × 4, P03 × 1: render from the CAD model (tools and shop items illustrative).

#### WP2.6 PETG batch

Parts

everything else in print-list order of need: P04, P05, P06, P08, P09, P10, P11, P12, P13, P14, P15, P16, P26, P25 (fairings, vase mode, standing), P20–P24; P17/P18/P19 only after M6/M10 are measured.

Procedure

1. slice with the coupon offset
2. print
3. measure the critical features
4. log

Check

controlled bores/insert holes ± 0.1, clearance holes ± 0.2, uncontrolled ± 0.5 % / ± 0.5 mm (hardware-spec 5c; every drawing sheet carries the same block); fairing P25: inner cavity slides over the Ø25.4 leg by hand with ≤ 0.5 mm play, wall 0.8 ± 0.2, no holes in the vase wall.

Time

4 h labour over the run; machine ≈ 80 h.

Figure 2.6. Where every printed part goes: motor mounts, clamps, trays, hardpoints, shoes and fairings in orange, everything else translucent. The print list gives material and settings for each.

Figure 2.6. Where every printed part goes: motor mounts, clamps, trays, hardpoints, shoes and fairings in orange, everything else translucent. The print list gives material and settings for each.

#### WP2.7 Drill the motor patterns and counterbores

Parts

P01 × 4, P03.

Tools

drill press, Ø3.4 bit, Ø7.5 counterbore or end mill, a motor as the jig (PCD Ø25, position Ø0.2 to the bore axis).

Procedure

1. print the four holes at Ø2.8 as pilots
2. set the motor on the plate with its shaft through the centre relief
3. mark through the base holes with a transfer punch
4. drill Ø3.4 from the plate side
5. counterbore Ø7.5 from the bore side to leave exactly the 4.5 mm floor (rev B: the Ø7.0 W01 washer needs Ø7.5, hardware-spec CAD notes J01)

Check

M3 × 8 + W01 drops through each hole and the washer sits flat in the counterbore; screw tip stands 2.8–3.2 mm proud of the floor (M4).

P03

no slots at build (2026-10-25, docs/research/thermal.md §6.3–6.4 item 6). The cup sits fully inside the Ø56 × 30 tail-ring bore, so wall slots would vent into foam, and the thermal model already credits the can with the free-stream film on every exposed face, so venting cannot lower the prediction: 76 °C after 600 s of cruise from the 25 °C design ambient (2026-11-02 run, cad/sim/thermal/results.txt pusher_endcruise_Motor; R21), 4 K under the 80 °C EST limit; that number is set by the estimated 33.2 W motor loss (analysis/thermal/thermal_results.json inputs_summary). Measure first (TEST-PLAN G03 tied-down 3 min at cruise throttle and the IR check after F08): if the can rises 25 K or more above ambient after a 120 s leg (≥ 45 °C on a 20 °C day; thresholds from the 2026-10-25 model, not re-derived in the 2026-11-02 run, EST), reduce the loss (prop/throttle match, ESC timing) and fit an aluminium spider floor as a conduction path; at a rise of 17 K or less (≤ 37 °C on a 20 °C day, loss ≤ 20 W EST), leave the cup closed.

Time

1 × 1.5 h (+ 0.5 h for the P03 slots).

Figure 2.7. Drill the motor patterns and counterbores: render from the CAD model (tools and shop items illustrative).

#### WP2.8 Install all 67 inserts (I01)

Parts

per print-list "inserts_I01_each": motor mounts 16, tail clamps 12 (4 split + 2 top per side), gear clamps 16, spar collars 4, rear hardpoints 4, pusher cup 4, pod rails 6 (4 saddle tabs + 2 hatch), pitot clamp 1, FC tray 4 = 67 (cad/hardware.json inserts qty_breakdown).

Tools

iron per 2.3, heat-proof mat, flat block.

Procedure

1. install
2. press flush
3. cool
4. run an M3 screw through each

Check

each insert flush to −0.3 mm; square (an M3 × 16 screwed in leans ≤ 1 mm at 16 mm); no melted plastic in the thread.

Time

2 × 2 h.

Figure 2.8. Install all 67 inserts (I01): render from the CAD model (tools and shop items illustrative).

#### WP2.9 Print log

Procedure

record per part the date, material lot, dryer hours, nozzle, measured critical dimensions, offset used.

Check

every printed piece has a log line before it leaves the print bench.

Time

continuous.

WP2 traveler

# | Step | Value | Pass | Done | Checked | Date

2.1 | Hot end 295 °C / bed size ___ / hardened nozzle | | ☐
2.2 | Offsets: PETG M3 ___ / insert ___ / bore ___ ; PA6-CF ___ / ___ / ___ | | ☐
2.3 | Torque-out PETG ___ ___ ___ ; PA6-CF ___ ___ ___ N·m (≥ 1.0); crush ___° (≤ 30) | | ☐
2.5 | P01 floors ___ ___ ___ ___ (4.35–4.65); bores post-anneal ___ | | ☐
2.6 | Fairings ×4 slide on the leg; wall 0.8 ± 0.2 | | ☐
2.7 | Screw tip proud ___ mm × 20 (2.8–3.2); washers seat in Ø7.5 | | ☐
2.8 | 67 inserts flush and square | | ☐
— | PA6-CF used ___ g of 500; PETG used ___ g of 2000 | | ☐

### WP3: Tube cutting and drilling

Owner: structures lead. Cut list: docs/build/cut-list.csv (T01–T05); drawing sheet 7. Tolerances: length ± 0.8 mm (400–1000 mm; also applied to the 1046.0 mm front boom, which is above that band; ISO 2768-m allows ± 1.2 mm over 1000–2000 mm (amesweb.info ISO 2768 table, checked 2026-11-02), and cutting to the tighter ± 0.8 is kept as the shop target) and ± 0.5 mm (legs), end squareness 0.5 mm, cross-hole position ± 0.3 mm (ISO 2768-m, hardware-spec 5c).

#### WP3.1 Lay out the 72 in boom tubes

Parts

2 × 1.000 × 0.035 in × 72 in.

Tools

1 m rule, square, scriber, masking tape.

Procedure

1. square and deburr one end
2. mark 1046.0 (front boom, cad/params.txt segF), 1.5 kerf, 485.9 (stub, segR) → 1533.4 total
3. 295.4 mm remains per tube (calc: 1828.8 − 1533.4) as coupon stock (review M5.5 boom deflection
4. thrust-stand arm)

Check

marks ± 0.3 mm; both tubes identical to ± 0.5.

Time

1 × 0.3 h.

Figure 3.1. Lay out the 72 in boom tubes: render from the CAD model (tools and shop items illustrative).

#### WP3.2 Cut T01 and T02 (4 cuts)

Tools

hacksaw 32 TPI in the mitre box (K7) or tube cutter; file; deburring tool.

Procedure

1. rotate the tube a quarter turn every 10 strokes
2. file the end flat
3. deburr inside and out
4. wipe

Check

1046.0 ± 0.8 and 485.9 ± 0.8; squareness gap ≤ 0.5 mm against the square; the splice plug P04 enters each butt end by hand.

Time

1 × 1 h.

Figure 3.2. Cut T01 and T02 (4 cuts): render from the CAD model (tools and shop items illustrative).

#### WP3.3 Cut the 96 in socket tube: T03 × 2 then T04 × 4

Procedure

cut 800, 800, then 205 × 4, each from the fresh end; only 11 mm of slack (calc) so re-square no more than 0.5 mm.

Check

800 ± 0.8; 205 ± 0.5; total consumed ≤ 2438 mm.

Time

1 × 1.2 h.

Figure 3.3. Cut the 96 in socket tube: T03 × 2 then T04 × 4: render from the CAD model (tools and shop items illustrative).

#### WP3.4 Cut T05 joiner 760 mm

Procedure

1. cut
2. chamfer both ends 1 × 45° with a file
3. keep the 154 mm offcut as the FT01 coupon

Check

760 ± 0.8; enters a socket by hand (slip fit; it is never bonded).

Time

1 × 0.3 h.

Figure 3.4. How each stock tube is cut, with a 1.5 mm kerf per cut; lengths from the cut list.

#### WP3.5 Mark the station lines on both front booms and stubs (permanent)

Parts

2 front booms, 2 stubs.

Tools

rule, scriber, paint pen, two V-blocks.

Procedure

1. from the front end of each front boom (x = +0.45773 m, analysis/results.json geo booms x1) scribe (calc: x1 − x): front motor-mount centre 50.0 (xFront 0.40773)
2. front gear clamp 140.0 (x +0.31773 = xFront − 0.09, cad/params.txt comp Gear_Clamp_Upper)
3. front wing clamp 554.4 (x −0.09670, cad/params.txt sparX)
4. rear wing clamp 715.6 (x −0.25787 = −0.8 c, comp Boom_Clamp_R_Upper)
5. rear gear clamp 956.0 (x −0.49823 = xRear + 0.09)
6. aft end 1046.0 = rear motor centre / splice (xRear −0.58823). On each stub from its forward (butt) end: tail clamp centre 299.8 (x −0.88803, cad/params.txt xTC), fin LE 265.9 (xFinLE −0.85413), aft end 485.9. Scribe a straight top generator line along each tube (tube in the V-blocks, rule along it): the clocking reference for every clamp

Check

stations ± 0.5 mm; clamp spacing 715.6 − 554.4 = 161.2 = 0.5 c (calc: 0.5 × 322.3); top line straight within 0.5 mm.

Time

1 × 0.8 h.

Figure 3.5. Mark the station lines on both front booms and stubs (permanent): render from the CAD model (tools and shop items illustrative).

#### WP3.6 Lap the joiner if 1.4 was tight

Tools

400 grit wrapped on the joiner.

Procedure

1. rotate in the socket
2. wipe
3. re-test

Check

enters 300 mm by hand; tip play ≤ 5 mm at 1 m (FT01).

Time

1 × 0.5 h if needed.

Figure 3.6. Lap the joiner if 1.4 was tight: render from the CAD model (tools and shop items illustrative).

#### WP3.7 Splice cross-holes Ø3.4 (F04) — drilled in situ in WP7 7.6

Procedure

only if the rear cap is not printed yet: use P28 with its 18.0 mm stop on the front boom aft end and the stub forward end, horizontal plane relative to the top line, through both walls.

Check

18.0 ± 0.3 from the end; on the horizontal centreline ± 0.3 (drill shank through the tube lies parallel to the table with the top line up).

Time

1 × 0.5 h.

Figure 3.7. Splice cross-holes Ø3.4 (F04) — drilled in situ in WP7 7.6: render from the CAD model (tools and shop items illustrative).

#### WP3.8 Leg cross-holes Ø3.4 (F05) × 4 — drilled in WP8 8.7 through the gear clamp as the jig

Procedure

if drilled now: P28 second guide at the sheet-7 distance (7.0 mm from the top end (calc, hardware-spec J07); confirm on the sheet).

Check

± 0.3 from the top end; square to the axis.

Time

1 × 0.4 h.

Figure 3.8. Leg cross-holes Ø3.4 (F05) × 4 — drilled in WP8 8.7 through the gear clamp as the jig: render from the CAD model (tools and shop items illustrative).

#### WP3.9 Deburr, clean, weigh

Procedure

1. deburr
2. wipe with isopropyl
3. weigh

Check

no burr catches a fingernail; masses logged for the W&B (expected (calc 185/299/259 g·m⁻¹): front boom 193.4 g (cad/verification.txt 192.9), stub 89.9, socket 239, leg 61, joiner 197).

Time

1 × 0.3 h.

Figure 3.9. The finished tubes in place: front booms and stubs, spar sockets, joiner and landing legs.

Figure 3.9. The finished tubes in place: front booms and stubs, spar sockets, joiner and landing legs.

WP3 traveler

# | Item | Measured | Spec | Pass | Done | Checked | Date

3.2 | Front boom L/R | | 1046.0 ± 0.8 | ☐
3.2 | Stub L/R | | 485.9 ± 0.8 | ☐
3.3 | Sockets ×2 | | 800 ± 0.8 | ☐
3.3 | Legs ×4 | | 205 ± 0.5 | ☐
3.4 | Joiner | | 760 ± 0.8 | ☐
3.5 | Stations and top line scribed; clamp spacing | | ± 0.5; 161.2 | ☐
3.9 | Masses g: boom __ __ stub __ __ socket __ __ leg __ __ __ __ joiner __ | | | ☐

### WP4: Foam wing cores, spar sockets, joiner stops, hardpoint pockets

Owner: structures lead, 2 people at the bow. Section NACA 2415, chord 322.333 mm, panel 1120 mm, constant chord (cad/params.txt); spar socket Ø25.4 × 800 bored from the root at 30 % c on the camber line (sparX 96.70 mm aft of the LE, sparY +6.04 mm), leaving ≈ 11.5 mm of foam above and below (calc: upper +30.23, lower −18.14 at 30 % c from cad/params.txt yL30 + thick30; tube ± 12.7 about +6.04). Drawing sheet 4.

#### WP4.1 Make the templates

Parts

docs/build/templates/wing_root_naca2415.svg, wing_tip_naca2415.svg (generated from cad/params.txt; sheets are 300 mm wide, so print the _A and _B half sheets on Letter/A4 at 100 % and join at the red crosses, or the full sheet on Tabloid/Legal), backing (3 mm ply / 1.5 mm Al, §6 G1, or printed P29).

Tools

printer, rule, knife, 240/400 grit, candle wax.

Procedure

1. print at 100 % (no "fit to page")
2. measure the check line
3. glue to the backing
4. cut to the black line
5. sand
6. wax
7. make two root and two tip templates

Check

100 mm check line 100.0 ± 0.3 and the 10 mm bar 10.0 ± 0.1; profile within 0.3 mm of the printed line; LE radius smooth.

Time

2 × 2 h.

Figure 4.1. Make the templates: render from the CAD model (tools and shop items illustrative).

#### WP4.2 Set up the bow

Parts

1.3 m bow, 0.4–0.5 mm nichrome, bench supply (K13).

Procedure

1. tension the wire
2. start at 1.0 A and raise in 0.2 A steps on scrap until it cuts at ≈ 5 mm/s with no drag (typical 1.5–2.5 A on 0.5 mm wire EST
3. the WebSearch of 2026-10-21 found only the "minimum heat that cuts, constant feed" rule, Harvard SOP)

Check

wire sag < 2 mm at temperature over 1.3 m; kerf on scrap measured (expect 0.5–1.0 mm EST).

Time

2 × 1 h.

Figure 4.2. Set up the bow: render from the CAD model (tools and shop items illustrative).

#### WP4.3 Test cut and kerf

Parts

300 mm scrap of the 2 in sheet.

Procedure

cut a 100 mm square against the template's check line; measure.

Check

if the core comes out > 0.3 mm under, re-run make_templates.py --kerf <measured/2> and re-make the templates, or accept (0.5 mm on a 48.3 mm section is 1.0 %).

Time

2 × 0.5 h.

Figure 4.3. Test cut and kerf: render from the CAD model (tools and shop items illustrative).

#### WP4.4 Cut the core blocks F01 × 2 and F02 × 1

Parts

FOAMULAR NGX F-250 2 in sheet (Home Depot 52DDNGX).

Tools

straight edge, hand saw or long knife.

Procedure

1. on the 2438 × 1219 sheet cut two 1140 × 342.3 × 50.8 panel blocks end to end along the length (2280, 158 spare) in one 342.3 mm strip (342.3 = chord 322.3 + 2 × 10 lead-in (calc, cut-list F01))
2. the 160 × 342.3 saddle block and test scrap from a second strip (2 strips × 342.3 = 684.6 < 1219 ✓
3. at most 3 strips fit, 1026.9 mm (calc): measure the sheet width first (1.9) and cut the strips with the knife, not a saw)
4. mark the extrusion skin so both panels are cut in the same orientation

Check

block faces square ± 1 mm.

Time

1 × 0.5 h.

Figure 4.4. Cut the core blocks F01 × 2 and F02 × 1: render from the CAD model (tools and shop items illustrative).

#### WP4.5 Pin the templates and cut the panels (2 people)

Parts

F01 blocks, templates.

Procedure

1. pin root and tip templates on the block ends with the chord lines parallel to the block edge and the LE circles both 20 mm from the block front face (0° twist: the panel is a straight extrusion, cad/params.mjs)
2. enter at the TE lead-in
3. trace lower surface → LE → upper surface → TE lead-out, both operators calling stations 0…10
4. feed ≈ 5 mm/s EST, never stop inside the foam
5. then cut the 72 % line (fixed panel) and the aileron blank along 74–100 % (2 % = 6.4 mm hinge gap (calc: 0.02 × 322.3), cad/BuildVtol.cs Aileron)

Check

chord 322.3 ± 1.0 root and tip; thickness at 30 % c 48.4 ± 0.7 (cad/params.txt thick30 48.36); span 1120 ± 2 after trimming; twist ≤ 1 mm tip-TE rise on the table; no steps > 0.3 mm (sand with the 600 mm board, 240 grit, chordwise only).

Time

2 × 2 h for both panels and the saddle block.

Figure 4.5. Pin the templates and cut the panels (2 people): render from the CAD model (tools and shop items illustrative).

#### WP4.6 Cut the spar channel (FT05, Ø26.0 ± 0.5 × 800 from the root)

Parts

600 mm of 1.000 in tube offcut (not a flight tube) or a Ø26 nichrome loop.

Tools

heat gun, template circle as the guide.

Procedure

1. heat the tube offcut to ≈ 150 °C EST
2. push in from the root along the camber line at 30 % c in 100 mm bites, re-heating
3. or run a Ø26 wire loop on the bow from the root face to 800 mm, exiting through a slit (CAD README: "socket channel cut with a heated tube")

Check

Ø26.0 ± 0.5 (the flight socket slides in by hand with ≤ 0.5 mm radial play, no force); centred 96.6 ± 1.0 mm aft of the LE and 6.0 ± 1.0 above the chord line at both ends (sparX, sparY); depth 800 ± 3; blind end.

Time

2 × 1.5 h for both panels.

Figure 4.6. Cut the spar channel: render from the CAD model (tools and shop items illustrative).

#### WP4.7 Bond the joiner stops P26 and the spar sockets T03 (J20, J11/FT06 rev B)

Parts

2 × T03 sockets, 2 × P26 stop discs (Ø22.4 × 10 PETG), foam-safe glue, 5-min epoxy.

Tools

300 mm rule, a 1.000 in offcut as a pusher.

Procedure

1. abrade the socket OD and the inside of the socket at 300 mm
2. bond a P26 disc inside each socket with its root-facing face exactly 300 mm from the socket's root end (epoxy, pushed to a 300 mm mark on the offcut
3. this face is what the slip-fit joiner butts against, hardware-spec CAD notes J11)
4. cure
5. then coat the socket OD and the channel with foam-safe glue
6. push the socket home with a twist, root end flush with the root face
7. wipe
8. weight the panel flat on its lower surface
9. cure 24 h (glue label —)

Check

stop face 300 ± 1 mm from the root face (depth gauge); joiner enters 300 mm and bottoms on the stop; with both panels on the saddle, the joiner slides through both sockets and the saddle bores by hand (coaxiality Ø0.4, drawing sheet 4 note 7, EST); socket flush with the root face ± 0.5; panel flat (≤ 1 mm tip rise).

Time

2 × 1 h + 24 h cure.

Figure 4.7. Spar sockets T03 bonded in both panels with the P26 joiner stops inside them; the T05 joiner (carried loose) is shown for position. Panels drawn translucent.

Figure 4.7. Spar sockets T03 bonded in both panels with the P26 joiner stops inside them; the T05 joiner (carried loose) is shown for position. Panels drawn translucent.

#### WP4.8 Spar collar P11 and rear hardpoint P12 (C5; sheet 9)

Parts

P11 × 2, P12 × 2, foam-safe glue, epoxy (tube side only).

Tools

knife, scriber, calipers.

Procedure

1. at the boom station 353.7 mm from the panel root face *(calc: yIn 0.4337 − fusR 0.08
2. params zBoomPanel)* cut the lower-surface foam away over the socket, 46 mm wide along the span, down to the tube
3. bond P11 around the socket (epoxy on the abraded tube, foam-safe glue on the foam) with its two insert bosses on the diagonal beside the tube (rev B: never over the tube) flush with the lower surface
4. cut a 60 × 46 × 10 pocket flush in the lower surface centred at 80 % c (257.9 mm aft of the LE, cad/params.txt comp Rear_Hardpoint x −0.25787) at the same station and bond P12 flush with its inserts on the matching diagonal

Check

insert faces flush with the lower surface ± 0.3; the clamp uppers P05/P06 seat without rock; boss pairs 161.2 ± 0.5 mm apart along the chord (calc: 0.5 c = 0.5 × 322.3); a boom laid on both clamp tops is parallel to the root face ± 0.5 over 300 mm.

Time

2 × 1.5 h for both panels + cure.

Figure 4.8. Left panel at the boom station, 353.7 mm from the root face: spar collar P11 bonded around the socket, rear hardpoint P12 aft of it. Panel drawn translucent.

Figure 4.8. Left panel at the boom station, 353.7 mm from the root face: spar collar P11 bonded around the socket, rear hardpoint P12 aft of it. Panel drawn translucent.

#### WP4.9 Root tongue P15, servo pocket, horn pocket, harness channel, (left) pitot pocket

Parts

P15 × 2, foam-safe glue.

Procedure

1. cut a 20 × 6.4 × 25 pocket in the root face at 70 % c (225.36 mm aft of the LE, cad/params.txt boltX) centred on the section mid-height (14.7 mm below the upper surface *(calc: upper +19.6, lower −9.9, mid +4.8
2. cad/params.txt yU70, yL70, yMid70)*)
3. bond P15 so 25 mm projects inboard
4. cut the aileron-servo pocket in the lower surface at 55 % c (177.1 mm aft of the LE, params xServo), 556.5 mm from the root face (params zServoPanel), sized for the P17 L-tray with the servo on its side and the arm through the lower surface
5. cut the horn-hardpoint pocket 20 × 12 × 10 in the aileron lower surface at 596.4 mm from the root (zHornPanel) at 75–83 % c (hornHpX 241.5 mm aft of the LE)
6. cut the 6 × 6 harness channel in the lower surface from the root face to the boom station, and a 10 × 6 XT60H pocket at the root
7. left panel only: the pitot-clamp pocket 20 × 20 × 21.5 at 50 mm aft of the LE at the tip (params pitotX
8. tube centre 9.5 mm below the lower surface)

Check

tongue hole at 70 % c ± 0.5, perpendicular to the root face; pockets positioned ± 1 mm; the M5 × 20 passes through the tongue freely.

Time

1 × 1.5 h.

Figure 4.9. Left panel (translucent): root tongue P15 at 70 % c, aileron servo tray P17 at 55 % c and the horn hardpoint P16.

Figure 4.9. Left panel (translucent): root tongue P15 at 70 % c, aileron servo tray P17 at 55 % c and the horn hardpoint P16.

WP4 traveler

# | Item | L panel | R panel | Spec | Pass | Done | Checked | Date

4.1 | Template 100 mm line | | | 100.0 ± 0.3 | ☐
4.3 | Kerf ___ mm; templates offset ___ | | | — | ☐
4.5 | Chord root / tip | | | 322.3 ± 1.0 | ☐
4.5 | Thickness at 30 % c | | | 48.3 ± 0.7 | ☐
4.5 | Span / twist | | | 1120 ± 2 / ≤ 1 mm | ☐
4.6 | Channel aft of LE / above chord | | | 96.6 ± 1 / 6.0 ± 1 | ☐
4.7 | Stop face from root; socket flush; joiner bottoms on the stop | | | 300 ± 1; ± 0.5; yes | ☐
4.8 | Hardpoint spacing | | | 161.2 ± 0.5 | ☐
4.9 | Tongue at 70 % c; pockets | | | 225.4 ± 0.5; ± 1 | ☐
— | Core mass bare g (expect 32 kg/m³ × 10.45 L = 334 g (calc: cad/verification.txt Wing_Panel_L 10,449 cm³, 334.4 g)) | | | log | ☐

### WP5: Wing skin, ailerons, servos, saddle, wing bolts, pitot clamp

Owner: structures lead. Skin: Scotch heavy-duty packing tape, chordwise strips at 25 % overlap (budget-airframe §2a). Hinges are the tape skin itself (BOM v0.4 dropped the hinge tape; hardware-spec §7).

#### WP5.1 Prepare the surface

Parts

panels, foam-safe glue + foam dust as filler (G6, $0).

Procedure

1. fill dents
2. sand 240 chordwise
3. vacuum
4. wipe

Check

no step > 0.3 mm.

Time

1 × 0.5 h per panel.

Figure 5.1. Prepare the surface: render from the CAD model (tools and shop items illustrative).

#### WP5.2 Tape-skin test panel (review M5.4, budget-airframe M2)

Parts

0.25 × 0.25 m scrap, tape.

Procedure

1. weigh bare
2. skin both faces at 25 % overlap
3. weigh

Check

added mass ≤ 0.1 kg/m² per side; > 0.15 kg/m² total → re-run the sizing (R2, R10). Record.

Time

1 × 0.5 h.

Figure 5.2. Tape-skin test panel: render from the CAD model (tools and shop items illustrative).

#### WP5.3 Skin the panels

Parts

tape, plastic card, heat gun.

Procedure

1. per face, start at the TE
2. lay each 47.8 mm strip chordwise TE → LE and 30 mm onto the other face, 25 % overlap (12 mm), taut not stretched
3. rub down
4. upper face first, then lower so the lower strips' LE wrap lies on top
5. close with one spanwise strip along the TE and one along the LE
6. warm with the heat gun (hand-warm, moving) to shrink wrinkles
7. mask the hardpoints, root face and tongue, pockets, channel and the aileron hinge line

Check

no wrinkle > 1 mm; no bubble > 10 mm; no lifted LE edge; chord/thickness unchanged within +0.5 mm; mass per panel logged.

Time

2 × 2 h per panel.

Figure 5.3. Skin the panels: render from the CAD model (tools and shop items illustrative).

#### WP5.4 Ailerons with tape hinges (J17)

Parts

aileron blanks (74–100 % c, chord 83.8 (calc: 0.26 × 322.3), 612 mm long, 4 mm tip clearance, cad/BuildVtol.cs Aileron), P16 horn hardpoints, 2 horn sets (kit item 7).

Fasteners

F11 M2 × 14 × 2 per horn into N03 nuts captive in the P16 pockets, 0.15 N·m EST (snug).

Tools

knife, tape, straight edge.

Procedure

1. bond P16 flush into the aileron lower surface pocket (4.9) so the horn's first hole is over the hinge line
2. skin the aileron as 5.3 but leave the hinge-side edges bare
3. hinge: lay the aileron against the panel's 72 % cut face with the 6.4 mm gap (2 % c) set by a spacer, upper surfaces flush
4. run one continuous strip of packing tape along the upper surface across the gap, 20 mm onto each part, rubbed down hard
5. fold the aileron fully down (upper surfaces touching) and run the second strip along the lower surface across the gap so the two strips pull against each other
6. cut the tape at the tip and root
7. fit the horn

Check

aileron moves ± 25° EST (end points set in WP11) with no binding and returns from both stops; hinge line straight (aileron edge parallel to the panel TE ± 1 mm); gap 6.4 ± 1 mm along the span; horn perpendicular ± 2°; the hinge tape has no wrinkle along the fold.

Time

2 × 1.5 h for both.

Figure 5.4. Ailerons hinged on the 72 % cut face of each panel (tape hinges, 6.4 mm gap).

Figure 5.4. Ailerons hinged on the 72 % cut face of each panel (tape hinges, 6.4 mm gap).

#### WP5.5 Aileron servos (J14)

Parts

2 × ES3005HV (AL, AR), 2 × P17 trays (printed after M6), 2 × Du-Bro 230 pushrods.

Fasteners

F10 ISO 4762 M2 × 10 × 4 + N03 × 4 per servo, 0.15 N·m EST; servo-arm screw (supplied).

Tools

1.5 mm hex, Z-bend pliers, side cutters.

Procedure

1. bond the tray foot into the 55 % c pocket (556.5 mm from the root) with the servo on its side and the arm through the lower surface
2. screw the servo in
3. cut the pushrod to 56 mm overall (cad/mesh/meta.json Pushrod_Aileron 56
4. cad/params.txt rodAileron 55.9
5. cad/README.md controls
6. pivot-to-pivot —), Kwik-Link at the horn, Z-bend at the arm
7. centre the servo electrically before fitting the arm

Check

pushrod perpendicular to the horn and the arm at neutral ± 5°; servo neutral = aileron neutral ± 1 mm at the TE; no buzz at the stops; servo lead reaches the root channel with 50 mm slack.

Time

2 × 1 h for both.

Figure 5.5. Left aileron drive: ES3005HV servo on its P17 tray, 56 mm pushrod and horn on the P16 hardpoint. Panel drawn translucent.

Figure 5.5. Left aileron drive: ES3005HV servo on its P17 tray, 56 mm pushrod and horn on the P16 hardpoint. Panel drawn translucent.

#### WP5.6 Centre-section saddle (Wing_Saddle, J10/J11, FT06 slip fit; sheet 4)

Parts

F02 saddle block, 2 × P13 root plates with the 6 mm side tabs, 2 × P14 bolt pillars, joiner T05, foam-safe glue.

Tools

Ø22.6 drill (step bit), rule, flat table.

Procedure

1. drill the saddle block Ø22.5 through at the spar station using the P13 bores as guides from both faces
2. bond P13 to each face with the profiles aligned on the flat table (LE marks on a straight edge, lower surfaces down)
3. cut two Ø16.2 pillar bores at 70 % c, z ± 65 (params boltZ) and bond P14 with the slots facing outboard
4. cut the tongue slots
5. tape-skin the block
6. do not bond the joiner: slide it through and dry-assemble both panels
7. lap or shim the saddle bores so the joiner is a hand-push slip fit (FT06, same band as FT01: drill 22.6 if tight)

Check

with both panels on and the joiner through, root faces touch the saddle faces with ≤ 0.5 mm gap; dihedral 0 ± 0.5° (tips at equal height ± 5 mm over 2.4 m on the table); incidence equal within 0.5°; M5 × 25 passes freely through pillar and tongue; the joiner slides out by hand with the wing bolts removed and cannot be pulled out with them fitted (captured between the stops, 300 + 160 + 300 = 760 (calc)).

Time

2 × 2.5 h + cure.

Figure 5.6. Centre-section saddle with the two P14 bolt pillars, between the panel roots on the T05 joiner.

Figure 5.6. Centre-section saddle with the two P14 bolt pillars, between the panel roots on the T05 joiner.

#### WP5.7 Wing bolts (J10)

Fasteners

F09 ISO 7380 M5 × 25 button (cad/params.txt fast_F09, wingBoltL 0.025; DESIGN-BASIS rev 2026-11-01) + N02 M5 nylock, 1 per side, 0.5 N·m EST (rev 2026-11-02, was 1.0: 13 MPa under the head instead of 27 MPa on PETG, STR-13; the bolt works in shear, the nylock keeps it).

Tools

3 mm hex, 8 mm spinner.

Procedure

1. fit
2. torque
3. paint witness

Check

head seats in the Ø10.3 × 2.0 spot-face (cad/params.txt pillarSpot 0.002; the 2.75 mm button head stands 0.75 mm proud, near-flush (calc)); nut in the 8.2 AF × 11.1 pocket from the lower surface (cad/params.txt pillarNutDepth 0.0111); screw end 3.6 mm past the nut, so the nylon insert is fully engaged (≥ 2 threads past the nylock, DESIGN-BASIS rev 2026-11-01), and 2.5 mm inside the lower surface (calc: pillar 29.5 (pillarH) − 2.0 − 25 = 2.5; nut outer face 29.5 − 11.1 + 5.0 = 23.4 below the top vs screw end 27.0); nylock drags ≥ 1 turn before seating (replace after 5 cycles EST).

Time

1 × 0.2 h.

Figure 5.7. Wing bolts: render from the CAD model (tools and shop items illustrative).

#### WP5.8 Pitot clamp P19 (J16) — after M10

Parts

P19, pitot tube (RMRC kit).

Fasteners

F07 ISO 7380 M3 × 8 pinch screw into I01, 0.4 N·m EST.

Procedure

bond P19 into the left-tip pocket (50 mm aft of the LE = 15.5 % c (calc: 50 / 322.3), tube centre 9.5 below the lower surface); pitot tube forward, tubing into the channel with a disconnect loop at the root.

Check

tube parallel to the chord line ± 1° both planes; tip ≥ 1 chord ahead of the LE EST (pitotL 0.25).

Time

1 × 0.5 h.

Figure 5.8. Pitot clamp P19 and the pitot tube at the left tip, tube forward. Panel drawn translucent.

Figure 5.8. Pitot clamp P19 and the pitot tube at the left tip, tube forward. Panel drawn translucent.

WP5 traveler

# | Item | L | R | Spec | Pass | Done | Checked | Date

5.2 | Skin areal mass | | | ≤ 0.1 kg/m² per side | ☐
5.3 | Skinned panel mass g | | | log | ☐
5.4 | Aileron travel / gap / binding | | | ± 25° / 6.4 ± 1 / free | ☐
5.5 | Servo neutral = aileron neutral | | | ± 1 mm | ☐
5.6 | Dihedral; root gap; joiner captured with bolts, free without | | | ≤ 5 mm; ≤ 0.5; yes | ☐
5.7 | M5 torque 1.0; witness | | | yes | ☐
5.8 | Pitot alignment | | | ± 1° | ☐

### WP6: Tail: stabiliser, elevator, fins, rudders, shoes, tail servos

Owner: structures lead. Stabiliser NACA 0009, chord 125.02 (cad/params.txt hC), span 917.4 (boom spacing + 50 mm for the shoe flanges), 11.3 thick (cad/params.txt tailT); elevator 70–100 % c (37.5 (calc: 0.3 × 125.02)), span 845.8 (4 mm from each fin); fins NACA 0009 root 166.38 (vC) / tip 108.15 (calc: 0.65 × 166.38), height 208.0 (vH); rudders 30 % of the local chord from 22 mm above the fin root to the tip, 2 % gap (cad/params.txt; cad/mesh/meta.json; hardware-spec CAD notes). Templates tail_naca0009.svg, fin_root_naca0009.svg, fin_tip_naca0009.svg. Sheets 6 (tail clamp), 9 (fin shoe).

#### WP6.1 Templates

Procedure

as 4.1 (these sheets fit Letter directly).

Check

100 mm line 100.0 ± 0.3.

Time

1 × 1.5 h.

Figure 6.1. Templates: render from the CAD model (tools and shop items illustrative).

#### WP6.2 Cut the stabiliser and elevator from F-150 1 in

Parts

block 935 × 145 × 25.4 (calc: chord 125.0 + 2 × 10 = 145.0 lead-in).

Procedure

1. cut the full section at the lowest heat that cuts, ≈ 3 mm/s EST (11.3 mm section, cad/params.txt tailT)
2. split at 68 % (stab) and 70 % (elevator)
3. drill the 4 × Ø7.2 crush-sleeve holes at z ± 416.2 and ± 451.2, 33.9 mm aft of the stabiliser LE (comp Crush_Sleeve x −0.88803 vs stab LE −0.85413 (calc))

Check

chord 125.0 ± 0.5; thickness 11.3 ± 0.3; stab span 917.4 ± 1; elevator span 845.8 ± 1; TE straight ± 0.5; sleeve holes ± 0.5.

Time

2 × 1 h.

Figure 6.2. Stabiliser and elevator with the four P10 crush sleeves at z ± 416.2 and ± 451.2 mm.

Figure 6.2. Stabiliser and elevator with the four P10 crush sleeves at z ± 416.2 and ± 451.2 mm.

#### WP6.3 Cut the fins and rudders

Parts

2 blocks 220 × 180 × 25.4 (calc: height 208.0 and root chord 166.4 + 10 lead-in, rounded up; EST).

Procedure

1. pin the root template on one end and the tip template on the other with the tip LE 58.2 mm aft of the root LE (calc: 0.35 × 166.38) and the TEs on one line (swept LE, straight TE, cad/BuildVtol.cs Fin)
2. both operators count stations as the wire tilts
3. split each fin at the 68 % line → rudder (70–100 %), and cut the rudder root 22 mm above the fin root so it clears the shoe wall

Check

root 166.4 ± 0.5, tip 108.1 ± 0.5, height 208.0 ± 1; rudder height 186.0 ± 1 (calc: 208.0 − 22), root chord 48.1 ± 0.5 (calc: 0.3 × local chord 160.2 at 22 mm = 166.38 − 58.23 × 22 / 207.98).

Time

2 × 1.5 h.

Figure 6.3. Fins, rudders and P09 root shoes added to the stabiliser.

Figure 6.3. Fins, rudders and P09 root shoes added to the stabiliser.

#### WP6.4 Skin

Procedure

tape as 5.3 (stabiliser spanwise strips, fins chordwise); mask hinge lines and the shoe root.

Check

no wrinkle > 1 mm; tail mass logged (sizing m_tail 0.177 kg, analysis/results.json sized.m_tail; the tail servos are booked under "Servos (5)" in cg.items).

Time

2 × 1.5 h.

Figure 6.4. Skin: render from the CAD model (tools and shop items illustrative).

#### WP6.5 Tape-hinge the elevator and rudders

Procedure

as 5.4 with a 2.5 mm gap (2 % of 125.0) for the elevator and 2 % of the local chord (3.2 root → 2.2 tip (calc: 0.02 × 160.2, 0.02 × 108.1)) for the rudders: upper/outboard strip first, surface folded fully, then the opposing strip.

Check

elevator ± 25°, rudders ± 25° free (EST travel), spring back, no binding at the shoe wall or the fins.

Time

1 × 1 h.

Figure 6.5. Tape-hinge the elevator and rudders: render from the CAD model (tools and shop items illustrative).

#### WP6.6 Horns (J17)

Parts

3 horns + kit backplates (20 × 11 × 1.5 EST).

Fasteners

F11 M2 × 14 × 2 per horn + N03 × 2, 0.15 N·m EST.

Procedure

elevator horn on the top surface at z +21 mm (comp Control_Horn x −0.94265, z 0.0211), through-bolted to the backplate below (6.9 mm section (calc: NACA 0009 at 70 % c, 0.0551 × 125.0)); rudder horns on the inboard face of each rudder 29 mm above the fin root (comp y +0.0267 vs fin root −0.0022 (calc)), through-bolted to the backplate outboard.

Check

horns perpendicular ± 2°; first hole over the hinge line ± 1 mm.

Time

1 × 1 h.

Figure 6.6. Horns: render from the CAD model (tools and shop items illustrative).

#### WP6.7 Fin root shoes P09 (J09)

Parts

2 fins, 2 × P09, foam-safe glue.

Procedure

1. bond each fin root 21 mm deep into the shoe pocket, LE forward, square to the flange
2. the flange (32 × 46) is centred 33.9 mm behind the fin LE (20.4 % of the 166.3 mm root chord (calc)
3. xTC − xFinLE) over the tail clamp

Check

fin to flange 90 ± 0.5°; shoes mirror each other.

Time

1 × 1 h + cure.

Figure 6.7. Fin root shoes P09: render from the CAD model (tools and shop items illustrative).

#### WP6.8 Tail servos (E, RL, RR) on the stabiliser top

Parts

3 × ES3005HV, 3 × P17 trays, 3 × Du-Bro 230 pushrods (the last three of the five: no spares).

Fasteners

F10 M2 × 10 × 4 + N03 × 4 per servo, 0.15 N·m EST.

Procedure

1. bond the tray feet on the stabiliser top, foot down, arm up: elevator servo at z −21 mm, rudder servos at z ± 361 mm, the right one at x −0.880 and the left one 19 mm further aft at x −0.899 (cad/params.txt comp Servo
2. the two servos are not mirror images, so this puts both arms at the same station)
3. cut the elevator rod to 55 mm overall (inclination not re-checked since rev B, hardware-spec J14) and both rudder rods to 88 mm (cad/params.txt rodElevator 55.6 / rodRudder 88.4
4. was 107 mm before 2026-11-03, MFG-02
5. pivot-to-pivot —)
6. fit each Kwik-Link with its fork straddling the horn upright
7. Kwik-Links at the horns, Z-bends at the arms

Check

as 5.5 (perpendicular ± 5°, neutral ± 1 mm at the TE); the elevator rod clears the stabiliser skin by ≥ 2 mm through its travel.

Time

2 × 1.5 h.

Figure 6.8. Tail servos on the stabiliser top: elevator servo at z −21 mm with its 55 mm rod, rudder servos at z ± 361 mm (left one 19 mm aft) with 88 mm rods; horns with their backplates (6.6).

Figure 6.8. Tail servos on the stabiliser top: elevator servo at z −21 mm with its 55 mm rod, rudder servos at z ± 361 mm (left one 19 mm aft) with 88 mm rods; horns with their backplates (6.6).

#### WP6.9 Dry-fit on the tail clamps P08 and the stubs

Parts

2 × P08 sets, stabiliser, fins, 4 × P10 crush sleeves.

Fasteners

F02 ISO 4762 M3 × 16 × 4 per clamp (0.5 N·m EST) and F02 × 2 per side through shoe → sleeve → stab → tail-clamp top inserts (e = 16 − 9.8 = 6.2, hardware-spec J09), 0.5 N·m EST.

Procedure

1. clamp P08 on each stub at 299.8 mm from the butt, flat top up (clocked to the top line)
2. sleeves in the stabiliser
3. stabiliser on the clamp tops
4. shoes on
5. screws

Check

stabiliser perpendicular to the stubs ± 0.5° (equal diagonals from the butt ends to the tips ± 2 mm); fins parallel ± 0.5°; elevator clears each fin 4 ± 1.5 mm; the whole tail unit comes off with these 4 screws (R4).

Time

2 × 1 h.

Figure 6.9a. Right tail clamp P08 on the boom stub, 299.8 mm from the butt, carrying the stabiliser and fin shoe.

Figure 6.9a. Right tail clamp P08 on the boom stub, 299.8 mm from the butt, carrying the stabiliser and fin shoe.

Figure 6.9b. The complete tail unit as it comes off the booms for transport: stabiliser, elevator, fins, rudders, servos and the tail clamps.

Figure 6.9b. The complete tail unit as it comes off the booms for transport: stabiliser, elevator, fins, rudders, servos and the tail clamps.

WP6 traveler

# | Item | Measured | Spec | Pass | Done | Checked | Date

6.2 | Stab chord / thickness / span; sleeve holes | | 125.0 ± 0.5 / 11.3 ± 0.3 / 917.4 ± 1; ± 0.5 | ☐
6.3 | Fin root / tip / height ×2; rudder height | | 166.4 / 108.1 ± 0.5 / 208.0 ± 1; 186.0 ± 1 | ☐
6.5 | Surface travel, free | | ± 25° | ☐
6.7 | Fin squareness ×2 | | 90 ± 0.5° | ☐
6.9 | Diagonals; elevator-fin gap | | ± 2 mm; 4 ± 1.5 | ☐
— | Tail unit mass g (incl. 3 servos, shoes) | | log (sizing 177 without servos + 3 × 43.2 servos (calc: sized.m_tail; cad/verification.txt Servo)) | ☐

### WP7: Booms, motor mounts, lift motors, props, gear clamps, splice

Owner: structures lead + electrical lead (ESC placement). Joints J01–J04, J06; sheets 5 and 6.

#### WP7.1 Fit the motors to the upper mount halves (J01)

Parts

4 × P01 (annealed, drilled), 4 × X4110S.

Fasteners

F01 ISO 4762 M3 × 8 × 4 + W01 washer × 4 per motor, from inside the bore (Ø7.5 counterbores, C1), 0.6 N·m EST, one drop of Loctite 242 on the last 2–3 threads, kept off the PA6-CF.

Tools

2.5 mm long-arm hex, torque driver or hanging mass (1.02 kg at 60 mm), 0.05 mm feeler.

Procedure

1. orient the wire exit on the 45° line toward the wire slot
2. insert the four screws + washers from the bore side
3. hand-start all
4. torque in a cross pattern
5. paint witness marks

Check

(M4) before Loctite, screw tip 2.8–3.2 mm proud of the floor with the motor off; after torque, 0.05 mm feeler does not enter under the base; bell free; wires not pinched.

Time

1 × 0.5 h per motor (2 h).

Figure 7.1. X4110S on the upper mount half P01: four F01 screws with W01 washers from inside the bore, hidden inside the mount in this view.

Figure 7.1. X4110S on the upper mount half P01: four F01 screws with W01 washers from inside the bore, hidden inside the mount in this view.

#### WP7.2 Prop plates and props (J03) — dry fit now, final fit at WP13

Parts

4 × prop plates (motor box), 4 × JeeFly 1755.

Fasteners

F12 (length from M5: M3 × 12 or 16 from the F08/F02 stock, or the motor-supplied screws if they fit), 2 per prop on the Ø12 hub circle, 0.8 N·m, Loctite 242 on the tip.

Procedure

1. CCW props on M1 (front-right) and M2 (rear-left), CW on M3 (front-left) and M4 (rear-right) (ArduPilot Quad X, ardupilot.org/plane/docs/quadplane-frame-setup.html, checked 2026-10-21
2. firmware/README.md §7)
3. balance each pair on a shaft between two glasses, tape to the light blade

Check

engagement 4.5–8.0 mm (calc from M5); tip runout ≤ 2 mm spun by hand; no preferred rest position.

Time

1 × 1 h for four.

Figure 7.2. Prop plate and JeeFly 1755 prop on the motor. Direction per motor: CCW on M1 and M2, CW on M3 and M4.

Figure 7.2. Prop plate and JeeFly 1755 prop on the motor. Direction per motor: CCW on M1 and M2, CW on M3 and M4.

#### WP7.3 Gear clamps P07 on the booms (J06)

Parts

4 × P07 sets.

Fasteners

F03 ISO 4762 M3 × 20 × 4 per clamp into I01, 0.5 N·m EST, cross pattern, witness.

Procedure

front at 140.0 and rear at 956.0 mm from the front end (3.5), socket down, clocked to the top line.

Check

split gap 0.4–0.8 mm each side (1.2 total, FT02); cannot be rotated by hand; socket axis vertical ± 1°.

Time

1 × 0.3 h per clamp (1.2 h).

Figure 7.3. Right boom: gear clamps P07 at 140.0 mm and 956.0 mm from the front end, socket down.

Figure 7.3. Right boom: gear clamps P07 at 140.0 mm and 956.0 mm from the front end, socket down.

#### WP7.4 Front motor mounts on the front booms (J02)

Parts

2 × P01 (with motors) + 2 × P02.

Fasteners

F02 ISO 4762 M3 × 16 × 4 per mount from the cap into the upper-half inserts, 0.5 N·m EST, witness.

Procedure

mount centre at 50.0 mm from the front end, motor up, shaft vertical (clocked to the top line).

Check

gap 0.4–0.8 each side; shaft vertical ± 0.5°; no rotation under 2 kg on a 0.25 m lever (M7, 4.9 N·m); witness unbroken.

Time

1 × 0.4 h per side.

Figure 7.4. Front motor mount: cap P02 under the upper half, four F02 screws into the inserts, mount centre 50.0 mm from the front end.

Figure 7.4. Front motor mount: cap P02 under the upper half, four F02 screws into the inserts, mount centre 50.0 mm from the front end.

#### WP7.5 Rear motor mounts and the splice (J02/J04)

Parts

2 × P01 + P02 (rear), 2 × P04 splice plugs, front booms, stubs.

Fasteners

F02 × 4 per mount, 0.5 N·m EST.

Procedure

1. slide the plug 40 mm into the front boom's aft end (mark its mid-line)
2. slide the stub on until the tubes butt
3. align both top lines
4. set the upper mount over the joint centred on the butt (35 mm each side)
5. fit the cap

Check

butt gap ≤ 0.3 mm (feeler); top lines aligned ± 0.5; the tail-clamp station lands at 1046.0 + 299.8 = 1345.8 mm from the front end ± 1 (calc).

Time

2 × 0.5 h per side.

Figure 7.5. Rear motor mounts and the splice: render from the CAD model (tools and shop items illustrative).

#### WP7.6 Drill and fit the splice cross-bolts (F04)

Parts

assembled rear mounts.

Fasteners

F04 ISO 4762 M3 × 40 + W01 under the head + N01 nylock in the 5.7 AF × 8.0 pocket, 2 per mount (x ± 18 from the butt), 0.5 N·m EST; screw end 3.5 mm past the nut, 0.5 mm inside the block face (calc, J04).

Tools

drill press or hand drill, Ø3.4 bit, the mount's half-grooves as the jig (split plane = boom neutral axis).

Procedure

1. drill in one pass through cap → boom wall → plug → boom wall → upper half from the counterbore side
2. one hole 18 mm forward of the butt (front boom), one 18 mm aft (stub)
3. fit the bolts

Check

holes 18.0 ± 0.3 from the butt; no slip under the M7 test at the mount and at the tail clamp; nylock did not turn by hand before torque (else replace).

Time

1 × 0.5 h per side.

Figure 7.6. Rear mount over the splice: plug P04 inside both tubes (front boom drawn translucent), stub butted to the front boom, cap fitted and the two F04 cross-bolts 18 mm either side of the butt.

Figure 7.6. Rear mount over the splice: plug P04 inside both tubes (front boom drawn translucent), stub butted to the front boom, cap fitted and the two F04 cross-bolts 18 mm either side of the butt.

#### WP7.7 Boom natural frequency (review M5.2)

Tools

vice, P05 pair, phone spectrum app.

Procedure

1. clamp at the front wing-clamp station (554.4)
2. tap the front motor
3. record

Check

first bending mode within ± 25 % of the hand calc 25.9 Hz (cad/params.txt feaHandFn 25.88; FEA 27.75 Hz, cad/sim/results.txt boom_f1, 2026-11-02) and not within ± 15 % of the hover rotor frequency (EST 70–90 Hz; set after T2) or twice it.

Time

1 × 0.5 h.

Figure 7.7. Boom natural frequency: render from the CAD model (tools and shop items illustrative).

#### WP7.8 ESC placement and foam pads (J15)

Parts

4 × LANRC BLHeli_S 45A (heat-shrunk), 3 mm foam pads (F-150 offcut), 2 zip ties each (kit item 11).

Procedure

1. ESCs go in the prop wash on the boom side or top face, not the underside (docs/research/thermal.md §6.4 item 4: the model's 43 W/m²K prop-wash film assumes the ESC sees the wash
2. under the boom it sits in the boom's wake). Front ESC on the outboard side (or top) face between the front gear clamp and the front wing clamp, 180–240 mm from the tip, inside the 216 mm disc radius of the front rotor *(calc: liftProp 431.8 / 2
3. rotor at 50.0)*
4. rear ESC likewise between the rear wing clamp and the rear gear clamp, 835–895 mm EST (rear rotor at 1046.0, disc from 830.1 mm
5. rear gear clamp front face at 933.0 mm (calc: 956.0 − 23))
6. heat-shrink face to the flow, on its 3 mm foam pad (the pad isolates it from the warm mount
7. the boom stays near ambient, thermal.md §6.1)
8. label FR/RL/FL/RR
9. extend the motor leads with 14 AWG if the supplied leads (length —) do not reach

Check

ESC on the side/top face inside the disc radius and not in the wake of a clamp or mount; not touching a clamp or mount; leads not in tension; zip ties over the shrink. Expected in service (cad/sim/thermal/results.txt, 2026-11-02, 25 °C design ambient, DESIGN-BASIS R21; ESC loss 11.3 W EST at hover, analysis/thermal/thermal_results.json): 50 °C after a 60 s hover, 60 °C after 90 s, mission peak 62 °C; limit 70 °C EST. No full mission above 25 °C ambient, measured at the field before each flight (R21).

Time

1 × 0.5 h.

Figure 7.8. ESC placement and foam pads: render from the CAD model (tools and shop items illustrative).

#### WP7.9 Weigh each boom assembly

Procedure

weigh each complete boom unit on the kitchen scale; log.

Check

within +10 % of the sum of its parts (EST 2 × 165 motors + 2 × 88.7 mounts + 192.9 + 89.8 tubes + 2 × 52.4 gear clamps + 42.4 plug + 2 × 25 ESCs (EST) ≈ 0.99 kg (calc), cad/verification.txt 2026-11-01).

Time

1 × 0.2 h.

Figure 7.9. A complete boom assembly as weighed in 7.9: both lift units, props, gear clamps and the splice.

Figure 7.9. A complete boom assembly as weighed in 7.9: both lift units, props, gear clamps and the splice.

WP7 traveler

# | Item | L boom | R boom | Spec | Pass | Done | Checked | Date

7.1 | Motor screw tip (×8 per boom); F01 0.6, Loctite, witness | | | 2.8–3.2 mm; yes | ☐
7.3 | Gear clamp gaps / torque 0.5 | | | 0.4–0.8 | ☐
7.4 | Front mount shaft vertical | | | ± 0.5° | ☐
7.5 | Butt gap; tail station from front end | | | ≤ 0.3; 1345.2 ± 1 | ☐
7.6 | Splice holes from butt; M7 slip test | | | 18.0 ± 0.3; no slip | ☐
7.7 | Boom f1 | | | 25.9 Hz ± 25 % | ☐
7.9 | Boom assembly mass g | | | log | ☐

### WP8: Pod, saddle-to-pod, battery and FC trays, pusher, landing legs and fairings

Owner: integration lead. The CAD pod is one solid body 1000 × 160 (cad/params.txt fusL, fusR; nose at x +0.60, tail ring at x −0.40) with the wing-root slot, battery bay, avionics bay, canopy pocket and the Ø56 × 30 tail-ring bore (cad/mesh/meta.json Fuselage_Pod); frames and rails are not modelled — the construction below is this manual's method, EST, consistent with hardware-spec J11–J13, J18, FT11 and the CAD notes.

#### WP8.1 Pod core F07

Parts

7 layers of F-150 1 in, 1000 × 170 (178 mm stack (calc: 160 / 25.4 = 6.3)), foam-safe glue.

Tools

bow, two pod-profile end templates (radius every 50 mm sliced from cad/mesh/Fuselage_Pod.STL), 600 mm sanding board.

Procedure

1. cut the battery bay (225 × 60, x +0.1425 to +0.3675 centred at x +0.255, cad/params.txt battX
2. pack 155 × 50 × 48 with ± 30 mm of CG slide
3. rev 2026-11-03, was 165 long) and the avionics bay (floor at y −20 from x +0.30 to +0.45, bayX0 / bayX1, for the FC tray at x +0.4075, ahead of the battery bay) out of the middle layers before lamination
4. cut the battery access well 165 × 52 (x +0.1725 to +0.3375, z ± 26) from the bay ceiling (y −20) up to the canopy pocket floor (y +15), so the pack lifts out through the hatch (cad/BuildVtol.cs "battery access well", rev 2026-11-03, §8.2 item 18)
5. laminate
6. hot-wire to an octagon on the templates
7. sand round
8. cut the wing-root slot for the saddle (322 × 71 at the LE station
9. cad/mesh/Wing_Saddle.STL 320.8 × 70.2, chord 322.3) and the canopy pocket (x +0.158 to +0.480, canopyX0 / canopyX1) with its two hatch slots, each 30 mm long × 40 mm wide to take the canopy's 30 mm rear flange and front tongue: rear slot x +0.1375 to +0.1675, front slot x +0.470 to +0.500, 2.2 mm deep (cad/BuildVtol.cs "hatch flange slot" / "hatch tongue slot"
10. widened from 25 mm on 2026-11-03, MFG-02)
11. bore the tail ring seat Ø56 × 30 (params tailR)

Check

diameter 160 ± 2 at the parallel section; length 1000 ± 3; bays within ± 1 mm of the stations above.

Time

2 × 4 h + cure.

Figure 8.1. Pod core: 1000 × 160 mm with the wing-root slot, battery and avionics bays, canopy pocket and the Ø56 × 30 tail-ring bore.

Figure 8.1. Pod core: 1000 × 160 mm with the wing-root slot, battery and avionics bays, canopy pocket and the Ø56 × 30 tail-ring bore.

#### WP8.2 Printed frames and rails P20

Parts

P20 set (nose ring, 3 mid frames, 2 side rails with inserts, tail ring).

Procedure

1. bond the frames into slots cut across the laminate
2. bond the two side rails at the saddle station with their 2 × I01 each at −0.10 c and −0.30 c, horizontal, matching the P13 tab holes
3. bond the tail ring (bore Ø56.0 ± 0.2, FT11) on the pod axis
4. bond the 2 hatch inserts at the canopy pocket rear

Check

tail ring axis on the pod axis ± 1 mm (sight through); rail insert faces vertical and level with each other ± 0.3 so the saddle tabs seat flat.

Time

2 × 2 h + cure.

Figure 8.2. Printed frames and rails P20: render from the CAD model (tools and shop items illustrative).

#### WP8.2a Battery-bay ventilation and FC standoffs (thermal; docs/research/thermal.md §6.4 items 1 and 5; review §[simulation] "Heat dissipation across the aircraft")

Why

the XPS bay is effectively adiabatic (k 0.029 W/mK). In the 2026-11-02 run a pack at the 6.0 mΩ/cell acceptance limit (TEST-PLAN C11) in the sealed bay ends a 25 °C mission (DESIGN-BASIS R21) at 53 °C, 7 K under the 60 °C limit (cad/sim/thermal/results.txt pod_mission_max_Battery; rise 28.2 K = 4.7 K per mΩ/cell). The inlet and exit stay as margin for sun load and a warm start; their benefit was not re-modelled at 25 °C (—). The FC board reaches 60 °C in the model (pod_mission_max_FC, 2.0 W EST; limit 85 °C, STM32F405 rating).

Parts

pod core (8.1, before skinning), knife, the 1.000 in tube offcut heated as in 4.6 or a hot-wire loop; 4 × FC standoffs Ø7 × 5.0 with a Ø3.4 hole (print with P18, PETG); 4 × M3 × 12 (F08 stock: BD-2 orders 12 for 4 used, hardware-spec §6).

Procedure

(1) Inlet: cut a 15 × 30 mm EST ram-air channel from the nose (x +0.60) straight aft at pack height to the front face of the battery bay (pack front at x +0.3325 (calc: battX 0.255 + 0.155 / 2)). (2) Exit: cut a 15 × 30 mm EST slot through the pod underside at the aft end of the bay (pack rear at x +0.1775 (calc: 0.255 − 0.0775)). (3) Wrap the tape skin (8.3) into both openings, never over them. (4) FC standoffs: fit the 4 spacers between P18 and the board so the FC sits 5 mm off the tray (bay height 35 mm, cad/params.txt bayY0/bayY1: tray 3 + standoff 5 + board 17 = 25 mm (calc)); M3 × 12 through the board and spacer into the tray inserts (engagement 12 − 5 − 1.6 = 5.4 mm EST, board thickness EST).

Check

inlet and exit open end to end (a paper strip drawn into the inlet by a fan comes out at the exit); pack retention unchanged (5 kg push ≤ 1 mm, 8.5); no foam crumbs in the bay; FC 5 ± 0.5 mm off the tray and still level (10.1).

Time

1 × 1 h.

Figure 8.2a. Battery-bay ventilation and FC standoffs: render from the CAD model (tools and shop items illustrative).

#### WP8.3 Canopy blister F08 + hatch flange P22 (J13)

Parts

2 F-150 layers, P22.

Fasteners

F07 ISO 7380 M3 × 8 × 2 into the pod inserts, 0.4 N·m EST.

Procedure

1. shape the blister (352 × 55 × 110, cad/mesh/Canopy.STL bounding box 351.5 × 55.0 × 110.0, 2026-11-01)
2. hollow to a 4 mm wall EST for the FC, RX and BeeID
3. drill two Ø8 mm avionics-bay vents in the blister, one forward-facing at its front and one aft-facing at its rear (docs/research/thermal.md §6.4 item 5, EST), ≥ 30 mm from the GPS pad
4. bond P22 (2 mm rear flange + front tongue)
5. skin pod and blister with tape (spanwise strips around the body, 25 % overlap), cutting the tape clear of both vents and of the 8.2a battery-bay inlet and exit

Check

hatch removable in < 30 s; flush ± 1 mm; both Ø8 vents and the 8.2a openings open after skinning.

Time

2 × 2 h.

Figure 8.3. Canopy blister on the pod; the two Ø8 mm avionics vents are not modelled.

Figure 8.3. Canopy blister on the pod; the two Ø8 mm avionics vents are not modelled.

#### WP8.4 Saddle to pod (J11, side tabs)

Parts

completed saddle (5.6) without the joiner.

Fasteners

F08 ISO 4762 M3 × 12 × 2 per side, horizontal through the 6 mm side tabs into the rail inserts, e = 6.0, 0.5 N·m EST, witness.

Procedure

1. slide the saddle into the root slot
2. fit the 4 screws
3. dry-assemble both panels with the joiner

Check

wing incidence to the pod axis 0 ± 0.5° (the CAD places the chord line on the pod X axis; cad/params.mjs adds no incidence — confirm with the structures lead); wing centred ± 1 mm; the joiner slides through the saddle by hand.

Time

2 × 1 h.

Figure 8.4. Saddle in the pod root slot, held by its side tabs (wing panels not shown).

Figure 8.4. Saddle in the pod root slot, held by its side tabs (wing panels not shown).

#### WP8.5 Battery tray P21 and straps (J18)

Parts

P21, 2 × ShareGoo straps.

Procedure

1. bond P21 to the bay floor with the pack centre at x = +0.255 m (cad/params.txt battX 0.255
2. analysis/results.json cg.xb 0.2550) and ± 30 mm fore-aft marks
3. fit the straps through the 22 × 3 slots. No ballast and no payload station (DESIGN-BASIS R12, revised 2026-11-01): with the lengthened pod nose this pack position alone puts the CG at 28 % MAC (cg.pct.noPayload 28
4. static margin 10.4 % by AVL, analysis/aero/aero_results.json static_margin_pct.CG_28pct, and 10.2 % by the sizing, cg.SM_noPayload)

Check

pack cannot move > 1 mm under a 5 kg push; the AS150U pigtail reaches the hatch opening (else cut a 60 × 40 side door, EST); with the hatch off and the straps undone, the pack lifts out through the access well and goes back in, and slides to both ± 30 mm marks (§8.2 item 18).

Time

1 × 1 h.

Figure 8.5a. Side view: battery tray P21 with the 6S pack centred at x = +0.255 m. Pod and canopy drawn translucent.

Figure 8.5a. Side view: battery tray P21 with the 6S pack centred at x = +0.255 m. Pod and canopy drawn translucent.

Figure 8.5b. Inside the pod (translucent): battery tray and pack, flight-controller tray and the pusher cup at the tail.

Figure 8.5b. Inside the pod (translucent): battery tray and pack, flight-controller tray and the pusher cup at the tail.

#### WP8.6 Pusher motor cup P03, adapter and prop (J12, J03b)

Parts

P03, pusher X4110S, M6 adapter + prop washer + bullet nut (motor box), APC 14 × 8.5EP with the Ø6 ring, pusher ESC.

Fasteners

F01 × 4 + W01 (0.6 N·m EST, Loctite 242, M4 check) from inside the cup; F13 M3 × 8 (EST, motor-supplied) × 4 adapter to hub, 0.8 N·m, Loctite 242; F07 ISO 7380 M3 × 8 × 4 radial cup-to-ring, 0.4 N·m EST; N04 M6 bullet nut.

Procedure

1. solder the motor leads to the pusher ESC first (W07)
2. fit the motor into the cup
3. fit the adapter
4. push the cup into the tail ring (FT11) with the wire groove down
5. radial screws
6. prop on the adapter with the chosen ring, washer, bullet nut tightened with a 3 mm rod through its cross-hole until the prop cannot be slipped by hand (torque —, hardware-spec §2d)
7. EP prop facing aft

Check

shaft on the pod axis ± 1°; tip tracking ≤ 2 mm; pusher disc ground clearance 44.8 mm on the legs (cad/verification.txt 2026-11-01) ≥ 30 measured; disc clearance to the rear lift discs ≥ 20 mm (design 106.1, cad/params.txt discClear; cad/verification.txt 105.0, §8.2 item 12); P03 cup slots (2.7) clear of the tail-ring wall or matched by openings in it (§8.2 item 11); the prop blows aft at the WP11 pusher check.

Time

2 × 1.5 h.

Figure 8.6. Pusher: cup P03 in the tail ring, X4110S, M6 adapter, washer and the APC 14 × 8.5EP prop.

Figure 8.6. Pusher: cup P03 in the tail ring, X4110S, M6 adapter, washer and the APC 14 × 8.5EP prop.

#### WP8.7 Landing legs, fairings and feet (J07; sheet 7)

Parts

4 × T04 legs, 4 × P25 fairings, 4 × P23 feet, 5-min epoxy, tape.

Fasteners

F05 ISO 4762 M3 × 30 + W01 + N01 per leg, along local x, 0.5 N·m EST (rev B: head in the Ø7.5 × 4.0 counterbore, nut in the 5.7 AF × 4.3 pocket, both outside the leg tube).

Procedure

1. slide the fairing over the leg from the bottom (TE aft)
2. push the leg top into the blind socket (14 mm, FT03
3. ream if tight)
4. drill Ø3.4 through the clamp's holes and the leg in one pass (or align the pre-drilled hole)
5. fit F05
6. slide the fairing up against the gear clamp, clock its TE aft, tape its top to the clamp
7. bond the dome foot into the leg bottom (plug 15 mm)

Check

four feet touch the flat table with the booms level (sand a dome ≤ 1 mm EST to true); legs vertical ± 1°; fairing TE aft ± 3°, no rattle; pusher clearance 45 ± 5 mm; lift props 277 mm above the ground (calc: yProp +0.0241 − yGround −0.2526).

Time

1 × 2 h.

Figure 8.7. Landing legs T04 in the gear-clamp sockets with the P25 fairings, trailing edge aft.

Figure 8.7. Landing legs T04 in the gear-clamp sockets with the P25 fairings, trailing edge aft.

WP8 traveler

# | Item | Measured | Spec | Pass | Done | Checked | Date

8.1 | Pod diameter / length / bay stations | | 160 ± 2 / 1000 ± 3 / ± 1 | ☐
8.2 | Tail ring bore / rails level | | 56.0 ± 0.2 / ± 0.3 | ☐
8.4 | Wing incidence to pod / centred; joiner slides | | 0 ± 0.5° / ± 1 mm; yes | ☐
8.2a | Battery-bay inlet + exit open; FC on 5 mm standoffs; canopy Ø8 vents ×2 (8.3) | | open; 5 ± 0.5; open | ☐
8.5 | Pack centre at x +0.255; ± 30 mm marks; no ballast fitted (R12) | | ± 1 mm; yes | ☐
8.6 | Pusher axis / tracking / clearances | | ± 1° / ≤ 2 / ≥ 30 and ≥ 20 mm | ☐
8.7 | Legs vertical; feet touch; fairings TE aft | | ± 1°; ≤ 1 mm rock; ± 3° | ☐
— | Pod assembly mass g (no battery) | | sizing mFus 0.567 + saddle | ☐

### WP9: Electrical

Owner: electrical lead. Harness table: docs/build/wiring.csv (W01–W07 power, S01–S11 servos, M01–M05 DShot, A01–A08 avionics). Output map exactly firmware/vtol_c0.param §2 / firmware/README.md §4.4: S1/S2 ailerons L/R, S3 elevator, S4 rudder L, S5 Motor1 front-right CCW, S6 Motor2 rear-left CCW, S7 Motor3 front-left CW, S8 Motor4 rear-right CW (DShot150), S9 pusher (DShot150), S10 empty, S11 rudder R, S12/LED spare.

Power path: pack → Amass AS150U (R20) → CoreWing PDB (90 A cont, 215 A peak; ardupilot.org board page, checked 2026-10-21) with the included 470 µF capacitor → 4 × 12 AWG lift ESC feeds, one XT60H per lift ESC at the boom disconnect (C0_BOM.csv XT60H line) + 1 × 14 AWG pusher feed. Currents (analysis/results.json C0.sized, 2026-11-01): hover 51.0 A total at 22.2 V (I_hover) and 53.9 A at 21.0 V (I_hover_loaded), i.e. 12.7–13.5 A per lift ESC (calc: / 4); transition 82.1 A EST for 20 s (I_trans = P_trans 1723 W / 21.0 V), ≈ 20.5 A per lift ESC (calc); one X4110S max 27.7 A at 22.2 V (budget-lift A3). Q_M_BAT_CURR_MAX 85 caps the lift motors below the 90 A sensor; it sits only 3 A above the 82.1 A transition estimate (§8.2 item 16).

#### WP9.1 Harness lengths and labels

Procedure

cut every conductor per wiring.csv (+ 50 mm service loop); label both ends with masking tape before soldering.

Check

39 leads needed ≈ 11.8 m (calc: servos 2 × 1.0 + 3 × 1.6 = 6.8 m; DShot 4 × 1.0 + 0.5 = 4.5 m; GCS/RID short) vs 40 leads × 0.3 m = 12 m in BOM v0.4.

Time

1 × 1 h.

Figure 9.1. Wiring overview: battery power through the power board to five ESCs, signals from the flight controller. Circuit IDs match the wiring list.

#### WP9.2 Re-terminate the packs EC5 → AS150U (W01)

Parts

2 packs, 2 × AS150U female (BOM: "aircraft male + 2 pack females"; anti-spark contact to be confirmed on receipt, —), heat shrink.

Tools

60 W iron, chisel tip, tape.

Procedure

1. one lead at a time with the other taped
2. cut the EC5 off the red lead
3. strip 6 mm
4. slide shrink on
5. tin
6. fill the + cup
7. hold 3 s
8. cool
9. shrink
10. repeat for black

Check

polarity with the meter (red = +); joint pull 5 kg EST; no exposed copper.

Time

1 × 0.5 h.

Figure 9.2a. Re-terminate the packs EC5 → AS150U (W01): render from the CAD model (tools and shop items illustrative).

Figure 9.2b. Circuits for this step highlighted; W01: the packs re-terminated to AS150U.

#### WP9.3 Battery pigtail to the PDB (W02)

Parts

10 AWG × 120 mm red/black, AS150U male, 470 µF capacitor (FC box).

Procedure

1. pre-tin the BAT+/BAT− pads
2. solder the pigtail
3. solder the capacitor across the pads observing polarity (firmware/README.md §4.1)

Check

continuity; no bridge to adjacent pads; capacitor polarity; pull 5 kg EST.

Time

1 × 0.5 h.

Figure 9.3. Circuits for this step highlighted; W02: battery pigtail to the power board.

#### WP9.4 Lift ESC feeds (W03/W04)

Parts

4 × 12 AWG pairs 0.35 m (PDB → XT60H female at the root) and 4 × 0.75/0.80 m (XT60H male → ESC).

Procedure

1. solder
2. route W04 in the wing channel (4.9) then along the boom underside and up to the ESCs on the boom side/top face (7.8)
3. tape the channel
4. zip-tie to P24 anchors every 150 mm

Check

polarity at every XT60H (meter); channel closed, no bulge > 1 mm.

Time

2 × 2 h.

Figure 9.4. Circuits for this step highlighted; W03 + W04: the four lift ESC feeds.

#### WP9.5 Motor phase leads (W05/W07)

Procedure

1. solder each motor's 3 leads to its ESC pads (extend with 14 AWG if short)
2. shrink each
3. shrink the ESC. Direction is fixed in WP11 by swapping two leads or in ESC-Configurator

Check

no loose strand; leads clear of the bell through full travel.

Time

1 × 1.5 h for five.

Figure 9.5. Circuits for this step highlighted; W05 + W07: motor phase leads.

#### WP9.6 Pusher feed (W06)

Procedure

14 AWG × 0.55 m PDB → pusher ESC, direct solder.

Check

continuity and polarity with the meter; service loop present.

Time

1 × 0.3 h.

Figure 9.6. Circuits for this step highlighted; W06: pusher ESC feed.

#### WP9.7 DShot signal leads (M01–M05)

Parts

5 servo leads with the red wire removed at the ESC end (never an ESC BEC on the rail, firmware/README.md §4.1).

Procedure

1. S5 → FR, S6 → RL, S7 → FL, S8 → RR, S9 → pusher
2. label at the FC end
3. S10 stays empty

Check

labels match the map above.

Time

1 × 1 h.

Figure 9.7. Circuits for this step highlighted; M01 to M05: DShot signal leads to the five ESCs.

#### WP9.8 Servo leads (S01–S11)

Parts

300 mm extensions (chain 3–4 for the ailerons ≈ 1.0 m, 5 for the tail ≈ 1.6 m).

Procedure

1. S1 → AL, S2 → AR, S3 → E, S4 → RL, S11 → RR
2. field disconnects: one JR plug per wing root (ailerons), one at each tail clamp (E + RL left, RR right)
3. set the servo-rail jumper to 6 V

Check

every plug keyed/marked; rail 5.9–6.2 V at the first power-up.

Time

2 × 1.5 h.

Figure 9.8. Circuits for this step highlighted; S01 to S11: servo leads.

#### WP9.9 Avionics power and data (A01–A04, A08)

Procedure

1. GPS on the GPS connector (UART5 + I²C + 4V5
2. the connector pin order differs from the pads — use the board image)
3. RX on TX6/RX6 + 5 V (receiver TX → RX6)
4. BeeID on the 5 V pad + GND only (not the 4V5 rail)
5. airspeed (MS4525DO, I²C 0x28) on the I²C connector (WP10 10.5)
6. BLE/WiFi module on the extender connector

Check

with the pack through the watt meter and no props: idle ≤ 1.0 A EST; 5 V rail 4.9–5.3 V; servo rail 5.9–6.2 V.

Time

1 × 1 h.

Figure 9.9. Circuits for this step highlighted; A01 to A04, A08: avionics power and data.

#### WP9.10 First power-up (no props, AS150U through the watt meter)

Procedure

1. 5 s smoke test
2. then 2 min
3. IR thermometer on the PDB and each ESC
4. FC boots on USB + Mission Planner

Check

nothing above 40 °C at idle; pack voltage on the GCS within 0.1 V of the meter (else BATT_VOLT_MULT, WP11).

Time

2 × 0.5 h.

Figure 9.10. First power-up (no props, AS150U through the watt meter): render from the CAD model (tools and shop items illustrative).

#### WP9.11 Strain relief and chafe

Procedure

10 mm shrink sleeve where a wire crosses a tube edge or clamp; zip ties snug not crushing.

Check

2 kg tug on every joint EST; nothing moves.

Time

1 × 0.5 h.

WP9 traveler

# | Item | Result | Spec | Pass | Done | Checked | Date

9.2 | Pack A / B polarity, AS150U | | correct | ☐
9.3 | Capacitor fitted, polarity | | yes | ☐
9.4 | XT60H ×4 polarity | | correct | ☐
9.7 | S5…S9 → FR RL FL RR P; S10 empty | | correct | ☐
9.8 | S1 AL, S2 AR, S3 E, S4 RL, S11 RR; rail V | | correct; 5.9–6.2 | ☐
9.10 | Idle current A / hottest part °C | | ≤ 1.0 / ≤ 40 | ☐
— | Harness mass g (sizing mWiring 0.37 kg) | | log | ☐

### WP10: Avionics install

Owner: electrical lead. Positions from cad/params.txt: FC tray x +0.4075 (moved 32.5 mm forward on 2026-11-03 to sit ahead of the lengthened battery bay) at the avionics-bay floor y −20 (comp FC_Tray); canopy x +0.158 to +0.480; GPS on the canopy top; pitot under the left tip. firmware/README.md §4 and firmware/peripherals.md govern pad names.

#### WP10.1 FC tray P18 and vibration isolation (J15)

Parts

P18 (bosses at the measured pattern, M6), CoreWing F405 Wing V2.

Fasteners

F07 ISO 7380 M3 × 8 × 4 into the tray inserts, 0.4 N·m EST; fallback foam tape (G5).

Procedure

1. bond P18 to the bay floor
2. mount the FC arrow forward on the four 5 mm standoffs of 8.2a (M3 × 12
3. docs/research/thermal.md §6.4 item 5), level with the pod axis (AHRS_ORIENTATION 0)

Check

FC pitch/roll to the wing chord line ± 1° (level app vs the wing); no wire pulls on the board; the tray and screws clear the battery top (CAD notes J15: 7 mm).

Time

1 × 1 h.

Figure 10.1. Side view: FC tray P18 and the flight controller above the battery bay. Pod and canopy drawn translucent.

Figure 10.1. Side view: FC tray P18 and the flight controller above the battery bay. Pod and canopy drawn translucent.

#### WP10.2 GPS/compass (A01)

Procedure

on the P24 pad on the canopy top, arrow forward, ≥ 100 mm from any power wire EST.

Check

compass offsets < 400 after calibration (firmware/README.md §6.3); COMPASS_AUTO_ROT 2 finds the orientation.

Time

1 × 0.5 h.

Figure 10.2. Circuits for this step highlighted; A01: GPS and compass.

#### WP10.3 Receiver (A02)

Procedure

RP3 V2 inside the canopy, antennas 90° apart taped to the blister; receiver failsafe set to "no pulses" (firmware/README.md §8).

Check

LQ 100 % at 50 m line of sight on the bench.

Time

1 × 0.3 h.

Figure 10.3. Circuits for this step highlighted; A02: receiver.

#### WP10.4 Remote ID (A03)

Procedure

BeeID on foam tape inside the canopy, ≥ 50 mm from the GPS; 5 V + GND only.

Check

broadcasting on a phone Remote ID app with the serial number matching the FAA DoC lookup (budget-avionics §4.2).

Time

1 × 0.3 h.

Figure 10.4. Circuits for this step highlighted; A03: Remote ID.

#### WP10.5 Airspeed sensor install (A04/A05)

Parts

RMRC MS4525DO board, pitot tube, silicone tubing (kit; G3 if short).

Tools

multimeter.

Procedure

1. no address strap: the MS4525DO is at I²C 0x28, clear of the board barometer at 0x76 (firmware/vtol_c0.param ARSPD_TYPE 1 comment
2. docs/research/bom-savings.md)
3. mount the board near the FC on foam tape
4. connect to the I²C airspeed connector
5. run two tubes to the pitot tube via the wing channel with a push-on disconnect at the root
6. power the FC on USB with only the airspeed on I²C

Check

with ARSPD_TYPE 1, Mission Planner Messages reports the MS4525 airspeed sensor found at boot (exact message text —) and the barometer still reads altitude; blow gently into the pitot: airspeed rises; pinch test holds 30 s. No sensor found or baro misbehaving: do not fly; check the wiring and ARSPD_TYPE / ARSPD_BUS 0.

Time

1 × 1.5 h.

Figure 10.5. Airspeed sensor install (A04/A05): render from the CAD model (tools and shop items illustrative).

#### WP10.6 Battery

Procedure

1. pack on the tray centred at x +0.255 (8.5 marks), straps
2. no ballast (R12)
3. AS150U pigtail reachable

Check

pack cannot move > 1 mm under a 5 kg push; plug reachable with the hatch on.

Time

1 × 0.2 h.

Figure 10.6. Battery: render from the CAD model (tools and shop items illustrative).

#### WP10.7 Vibration pre-check

Procedure

1. hatch on, no props
2. lift motors at Q_M_SPIN_MIN for 20 s (WP11 motor test)
3. read Vibe in the GCS

Check

Vibe X/Y/Z < 15 m/s² EST at this stage; clipping 0.

Time

1 × 0.5 h.

WP10 traveler

# | Item | Result | Spec | Pass | Done | Checked | Date

10.1 | FC level to wing | | ± 1° | ☐
10.2 | Compass offsets | | < 400 | ☐
10.4 | RID serial matches DoC | | yes | ☐
10.5 | MS4525DO found at boot (ARSPD_TYPE 1); baro OK; leak 30 s | | all yes | ☐
10.7 | Vibe no-prop | | < 15 | ☐

### WP11: Firmware and configuration

Owner: electrical lead. Programming steps are in firmware/README.md (§1 tools, §3 DFU first flash, §5 parameter load, §6 calibrations, §7 motor/servo checks, §8 failsafes, §9 build-up) and firmware/peripherals.md, and are not duplicated here. Hardware hand-off conditions:

#### WP11.1 Flash and load

Procedure

1. ArduPlane 4.7.2 stable arduplane_with_bl.hex over DFU (firmware/README.md §3
2. the target is in the stable release, no longer beta)
3. load firmware/vtol_c0.param twice with a reboot between (Q_ENABLE)
4. validate with py firmware/tools/check_params.py firmware/vtol_c0.param --corewing --require-every-line-commented

Check

checker exit code 0; Compare Params shows every row matching.

Time

1 × 1 h.

#### WP11.2 Calibrations (README §6)

Procedure

1. accelerometer with "Calibrate Level" at the wing chord line
2. compass (Large Vehicle MagCal)
3. radio (CH5 arm, CH6 six modes, CH7 E-stop, CH8 QAssist, CH9 RTL)
4. BATT_VOLT_MULT against the meter
5. BATT_AMP_PERVLT against the watt meter at 10 A and 30 A
6. airspeed offset

Check

volts ± 0.05 V; current within 5 % (README 6.7; budget-energy-test M5 says 3 % for the meter itself); airspeed 0 ± 1 m/s still air.

Time

2 × 2 h.

#### WP11.3 Output direction tests — props OFF (README §7)

Procedure

1. Motor Test A = front-right (S5) CCW, B = rear-right (S8) CW, C = rear-left (S6) CCW, D = front-left (S7) CW
2. fix a wrong motor at the header, a wrong direction by swapping two phase leads or in ESC-Configurator
3. servo sense: right roll → right aileron up / left down
4. pull back → elevator TE up
5. right yaw → both rudders TE right
6. set SERVOn_REVERSED (never the RLL2SRV signs)
7. set SERVOn_MIN/MAX/TRIM so nothing binds
8. pusher stopped in Q modes, blows aft in FBWA

Check

all five motors and five surfaces correct; Q_M_SPIN_ARM / SPIN_MIN from the lowest clean spin-up (tethered, props on).

Time

2 × 1 h.

Figure 11.3. Output direction tests — props OFF (README §7): render from the CAD model (tools and shop items illustrative).

#### WP11.4 Thrust stand T1–T4 (review §8)

Parts

20 kg load cell + HX711 + Nano, watt meter, IR thermometer, one lift motor + ESC + prop on the 296 mm boom offcut (3.1) in a P05 pair.

Procedure

1. T1 calibrate 0–10 kg (≤ 2 % FS)
2. T2 thrust curve 5 steps per motor
3. T3 hover-duty heat 1.86 kg × 90 s × 3 (sized Tunit_g 1858.9
4. expected hover throttle ≈ 0.59 (calc: 1858.9 / 3130 g, C0 params.Tmax_g))
5. T4 pusher curve, then bench M1: pusher power at 100 % for ≤ 3 s and at 85 % for 10 s on a full pack (≥ 25.0 V) — THR_MAX 85 caps the pusher because the C0 SITL model gives ≈ 890 W at 100 % on 25.2 V vs the X4110S 615 W rating (firmware/vtol_c0.param THR_MAX comment
6. TEST-PLAN C09)

Check

T2 max ≥ 2.98 kgf (R13: 1.6 × 7.438 / 4 = 2.975 (calc, analysis/results.json sized.m), TEST-PLAN C07; recompute with the WP12 weighed take-off mass, ≥ 1.6 × m / 4; the maker's 3.13 kgf gives T/W 1.68, sized.TW); T3 can ≤ 80 °C EST (model 73 °C after 90 s from 25 °C, cad/sim/thermal/results.txt lift_hover90_Motor); M1 pusher power at 85 % on a full pack ≤ 615 W (else lower THR_MAX); T4 ≥ 1.5 kgf at 60 %; fit Q_M_THST_EXPO from T2 (README).

Time

2 × 4 h.

Figure 11.4. Thrust stand T1–T4: render from the CAD model (tools and shop items illustrative).

#### WP11.5 Failsafe bench checks (R20; README §8)

Procedure

1. TX off in QLOITER → QLAND message
2. BATT_LOW_VOLT raised above pack voltage → warning + RTL
3. arm attempt in FBWA → refused
4. CH7 → all motors stop
5. fence shows on the map

Check

all as the README table.

Time

1 × 1 h.

#### WP11.6 SITL rehearsal (review §[flighttest] F0; README §9.1)

Procedure

each pilot runs sitl/mission_test.py and flies the SITL by hand on the C0 airframe model (firmware/sitl/run_c0_sitl.ps1, firmware/sitl/README.md C0 section), including three back-transitions from 18 m/s to see the airbrake pitch-up; log on the traveler.

Check

all seven scenarios pass and every pilot recovers a failed transition (review M[flighttest].1).

Time

per pilot, —.

WP11 traveler

# | Item | Result | Spec | Pass | Done | Checked | Date

11.1 | check_params exit code; firmware hash | | 0; recorded | ☐
11.2 | Volt mult / amp per volt error | | ± 0.05 V / ≤ 5 % | ☐
11.3 | 5 motors direction, 5 surfaces sense, pusher aft | | all correct | ☐
11.4 | T2 max ×4 kgf; T3 can °C; T4 kgf at 60 % | | ≥ 2.97; ≤ 80; ≥ 1.5 | ☐
11.5 | RC failsafe; arm refused in FBWA; E-stop | | per README §8 | ☐
11.6 | SITL per pilot | | pass | ☐

### WP12: CG and the weight-and-balance record

Owner: structures lead. Target CG: 90.3 mm aft of the wing LE (analysis/results.json cg.target −0.0903 m = 28 % MAC (calc: 0.28 × 322.3 = 90.3)), acceptable 86.9–93.6 mm (26.97–29.03 % MAC: battery ± 30 mm sweep, cg.cgBattFwd −0.0869 / cg.cgBattAft −0.0936, cg.pctFwd / pctAft). No payload and no ballast (DESIGN-BASIS R12, revised 2026-11-01): the lengthened pod nose puts the CG at 28 % MAC with the pack centred at x = +0.255 m (cg.xb 0.2550; the bay allows up to +0.339, cg.xbMax). Static margin at the 28 % CG: 10.4 % by AVL with the pod (analysis/aero/aero_results.json static_margin_pct.CG_28pct, NP 38.40 % MAC) and 10.2 % by the sizing (cg.SM_noPayload, NP 38.2 % MAC). Any added mass (a payload, a sensor, ballast) is a design change and needs the sizing re-run (R12). Lateral CG on the centreline ± 5 mm EST.

#### WP12.1 Weigh every assembly

Tools

kitchen scale.

Procedure

weigh each piece of §5; sum.

Check

empty without battery ≤ 7.00 kg and take-off with the pack ≤ 7.82 kg (calc: R13 mass ceiling on the maker's 3.130 kgf per motor = 4 × 3.130 / 1.6 = 7.825 → 7.82 kg; − 0.82 kg pack (analysis/results.json pick.kg) = 7.00 kg; DESIGN-BASIS R13); sizing estimate 6.618 kg empty (calc: sized.m 7.438 − 0.82). Over the ceiling → hover T/W < 1.6 on the maker's table: do not fly; re-run analysis/sizing.mjs (review M3.1).

Time

2 × 1 h.

Figure 12.1. Weigh every assembly: render from the CAD model (tools and shop items illustrative).

#### WP12.2 Longitudinal CG

Parts

full aircraft, battery at its 8.5 marks, props, hatch (no ballast, R12).

Tools

tape marks at 90.3 mm aft of the LE on both lower surfaces at z ± 0.3 m, or two kitchen scales under the front and rear legs.

Procedure

balance on fingertips at the marks, moving in 5 mm steps; or x_cg = x_front − W_rear × L / (W_front + W_rear) with L = 0.816 m between leg stations (calc: 0.31773 − (−0.49823), cad/params.txt Gear_Clamp_Upper comps) and x_front = 0.318 m ahead of the LE.

Check

86.9–93.6 mm aft of the LE; adjust by sliding the battery (± 30 mm moves the CG ± 3.3 mm (calc: 0.82 / 7.438 × 30)); out of range at the stops → stop and report to the structures lead (move ESCs/avionics only with a re-run of analysis/results.json cg; no ballast, R12).

Time

2 × 1 h.

Figure 12.2. Weighing for the CG: the front legs and the rear legs each on a board across one kitchen scale.

#### WP12.3 Payload: none (R12)

Procedure

none for this build. A future sensor is a design change (DESIGN-BASIS R12): re-run the sizing, then repeat 12.1–12.2 with it fitted before flight.

Check

—.

Time

—.

#### WP12.4 Lateral balance

Procedure

1. hang from the pusher adapter and the nose
2. trim by moving the RX/BeeID
3. if still out, report to the structures lead (no trim mass is planned, R12)

Check

wings level ± 1° (tips within 20 mm of each other EST).

Time

2 × 0.3 h.

Figure 12.4. Lateral balance: render from the CAD model (tools and shop items illustrative).

#### WP12.5 Record

Procedure

1. fill the §5 form
2. sign
3. photograph the CG marks and the battery position marks

Check

form complete and counter-signed.

Time

1 × 0.3 h.

WP12 traveler: the §5 form.

### WP13: Final inspection and proof loads

Owner: integration lead with the structures lead; a second person repeats every check. References: review M5.1–M5.5, firmware/checklists.md, drawing sheet 1 notes.

# | Check | Acceptance | Pass | Init

13.1 | Wing proof load (review M5.1): wing inverted on supports at the pod width, sandbags to 3.0 × W = 3 × 72.9 N = 219 N ≈ 22.3 kg elliptically distributed, 30 s (analysis/results.json C0.sized.W 72.92 N) | no permanent set (tips return within 2 mm); tip deflection < 120 mm; no crack; joiner and stops intact (joiner still slides out afterwards with the bolts removed) | ☐
13.2 | Boom clamp proof (review M5.5): 1.5 × T_max = 1.5 × 30.7 N = 46 N ≈ 4.7 kg at the front motor station, rear free | no rotation > 1° (witness lines), no crack | ☐
13.3 | Splice and tail clamp slip (M7): 2 kg at 0.25 m | witness lines unbroken | ☐
13.4 | Gear drop (review M5.3): empty airframe 0.3 m onto grass | peak < 8 g in the FC log; fairings and feet intact | ☐
13.5 | Every torqued fastener: witness mark present; count 139 screws / 40 nuts / 28 washers (sheet 8) | all | ☐
13.6 | Motor screw tips (M4) after the proof loads | 2.8–3.2 mm; no stator contact marks | ☐
13.7 | Props: F12 0.8 N·m witness, pusher nut hand-slip test, tracking ≤ 2 mm, no chips, CW/CCW handedness per 7.2 | all | ☐
13.8 | Control surfaces: travel, sense, slop ≤ 1 mm at the TE, tape hinges intact with no lifted edge | all | ☐
13.9 | Harness: every connector seated, zip ties, nothing within 10 mm of a prop disc; S10 empty | all | ☐
13.10 | Pitot: unobstructed, leak test 30 s; MS4525DO found at boot (ARSPD_TYPE 1, I²C 0x28) | holds; yes | ☐
13.11 | GPS 3D fix, HDOP < 1.5 outdoors; compass heading ± 10° of a phone | yes | ☐
13.12 | RID broadcasting; registration number marked on the airframe (R18) | yes | ☐
13.13 | Battery: both packs charged, cells ± 0.02 V, labelled; LiPo bag + ammo can + extinguisher packed | yes | ☐
13.14 | Pack centred at x +0.255 on its marks; no ballast, no payload (R12); CG 86.9–93.6 mm aft of the LE; take-off mass ≤ 7.82 kg; W&B form signed | yes | ☐
13.15 | Leg fairings taped, TE aft; no contact with the props | yes | ☐
13.15a | Thermal provisions: battery-bay inlet and exit open (8.2a), canopy Ø8 vents open (8.3), FC on standoffs (10.1), lift ESCs on the boom side/top face in the prop wash (7.8); each pack's C11 resistance written on its label; a pack above 6.0 mΩ/cell fails acceptance and does not fly (TEST-PLAN C11); no full mission above 25 °C ambient, measured at the field before each flight (DESIGN-BASIS R21) | all | ☐
13.16 | Geofence and site parameters loaded (vtol_c0_hover_phase.param for hover sessions) | yes | ☐
13.17 | All 14 travelers complete and counter-signed | yes | ☐

Time: 3 × 2 h.

### WP14: Transport breakdown and field assembly (R4, R5)

Pieces (drawing sheet 1 breakdown note; cad/README.md wing root and joiner): the stubs stay on the front booms (the splice is a shop joint with nylocks); the tail unit comes off at the 4 fin-shoe screws (J09); the props and leg fairings stay on; the joiner slides out of the saddle (slip fit) so the pod piece is only 0.16 m wide.

Piece | Qty | Size m EST | Fits 1.5 × 0.5 × 0.4 m (R4, EST)?
Boom unit: front boom + stub, 2 motor mounts, 2 motors + props, 2 gear clamps + legs + fairings, 2 ESCs | 2 | 1.53 × 0.43 (prop) × 0.25 (leg) (calc: 1046.0 + 485.9 mm) | no: 32 mm over the 1.5 m estimate (calc); measure the real car (M11, §8.2 item 13)
Wing panel with aileron, servo, spar socket, hardpoints (left with pitot) | 2 | 1.12 × 0.32 × 0.05 (calc: panelLen, chord 322.3, 0.15 c) | yes
Joiner (0.76 m), always carried loose in its own sleeve, never left in a panel | 1 | 0.76 × 0.022 | yes (left in a panel it would make a 1.58 m piece (calc), over the R4 1.5 m estimate)
Tail unit: stabiliser + elevator + 2 fins/rudders/shoes + 3 servos | 1 | 0.92 × 0.21 × 0.17 (calc: hSpan 917.4, vH 208.0, vC 166.4) | width over 0.5: lies flat on a seat (as the review notes)
Pod + saddle + avionics + pusher + battery tray | 1 | 1.00 × 0.16 × 0.16 (fusL 1.000) | yes (rev B: joiner removed)
2 packs, charger, tools, ammo can | — | — | yes

#### WP14.1 Breakdown (shop → car), 2 people

Procedure

1. AS150U out
2. props covered
3. tail: unplug 3 servo leads at the tail clamps, 4 × F02 out, lift the tail unit off
4. booms: unplug 2 XT60H + 1 aileron lead per side, 4 × M3 clamp screws per boom (F06 × 2 + F04 × 2 on the diagonals), lift wing + pod off the booms
5. wing: 2 × M5 out, slide the panels off the joiner, slide the joiner out of the saddle, disconnect the pitot tubes at the left root
6. 14 screws into a labelled bag

Check

nothing left plugged; bag count 14.

Time

target 10 min (2 people).

Figure 14.1. Transport breakdown (exploded assembly, cad/model/VTOL_Exploded.SLDASM): tail unit, booms, wing panels and joiner, pod.

Figure 14.1. Transport breakdown (exploded assembly, cad/model/VTOL_Exploded.SLDASM): tail unit, booms, wing panels and joiner, pod.

#### WP14.2 Assembly (car → flight-ready), 2 people, stopwatch

Procedure

1. booms on the ground on their legs 0.867 m apart (yIn ± 0.4337), noses forward
2. slide the joiner through the saddle
3. slide the wing panels on until they bottom on the stops and the tongues enter the pillars
4. 2 × F09 M5 × 25 at 0.5 N·m (torque driver, or the 0.85 kg hanging mass at 60 mm
5. not "by feel")
6. lift wing + pod onto the booms, clamp uppers on the hardpoints, 8 × M3 (F06 × 4, F04 × 4) at 0.5 N·m with witness lines matching
7. tail unit on the tail clamps, 4 × F02 at 0.5 N·m through the fin shoes
8. plug 3 tail servo leads, 4 × XT60H, 2 aileron leads, pitot tubes
9. walk-around per WP13 13.7–13.10
10. CG touch check at the marks
11. battery in and strapped at its marks (no ballast, R12)
12. transmitter on
13. props clear
14. AS150U last

Check

total ≤ 15 min median over three timed runs (review M3.3; R5); every witness line matched; no connector open; pack on its marks.

Time

3 runs × 2 × 0.5 h.

Figure 14.2. Underside of the right wing at the boom: the front and rear boom clamps P05 and P06 made up at every field assembly, screws on the diagonals.

Figure 14.2. Underside of the right wing at the boom: the front and rear boom clamps P05 and P06 made up at every field assembly, screws on the diagonals.

Figure 14.2a. Field assembly, 1 of 4: both booms standing on their legs, 0.867 m apart, noses forward.

Figure 14.2a. Field assembly, 1 of 4: both booms standing on their legs, 0.867 m apart, noses forward.

Figure 14.2b. Field assembly, 2 of 4: wing and pod lowered onto the booms; boom clamps closed, joiner and wing bolts in.

Figure 14.2b. Field assembly, 2 of 4: wing and pod lowered onto the booms; boom clamps closed, joiner and wing bolts in.

Figure 14.2c. Field assembly, 3 of 4: the tail unit onto the boom stubs; servo leads plugged in at the tail clamps.

Figure 14.2c. Field assembly, 3 of 4: the tail unit onto the boom stubs; servo leads plugged in at the tail clamps.

Figure 14.2d. Field assembly, 4 of 4: props on last, after the pre-flight checks.

Figure 14.2d. Field assembly, 4 of 4: props on last, after the pre-flight checks.

WP14 traveler

Run | Date | Crew | Breakdown min | Assembly min | Screws 14/14 | Pack on marks ☐ | Pass (≤ 15) | Init
1 | | | | | ☐ | ☐ | ☐
2 | | | | | ☐ | ☐ | ☐
3 | | | | | ☐ | ☐ | ☐

## 5. Weight-and-balance form (DBF-MAN-001 / W&B, Rev B)

Reference masses and arms from analysis/results.json concepts.C0.cg.items (generated 2026-11-01; repo x forward from the LE; here arm = mm aft of the LE, positive). Moment = mass × arm; the sizing moments are (calc).

Item | Sizing mass kg | Sizing arm mm aft of LE | Sizing moment kg·mm | Measured mass kg | Measured arm mm | Moment kg·mm
Lift units, front (2 motors + ESCs + props + mounts) | 0.651 | −408 (ahead of LE) | −265.6
Lift units, rear | 0.651 | +588 | +382.8
Booms + clamps + stubs + splice | 0.745 | +308 | +229.5
Wing (2 panels + sockets + stops + saddle + skins + hardpoints) | 1.835 | +124 | +227.5
Tail unit (servos booked below) | 0.178 | +904 | +160.9
Fuselage pod (frames, skin, hatch, pusher cup, trays) | 0.567 | −164 | −93.0
Landing gear (4 legs, clamps, feet, fairings) | 0.517 | +92 | +47.6
Avionics (FC, GPS, RX, RID, airspeed) | 0.418 | −375 | −156.8
Fasteners and inserts | 0.164 | +267 | +43.8
Pusher set (motor, ESC, prop, adapter) | 0.257 | +418 | +107.4
Servos (5; sizing counts them at the tail-weighted mean) | 0.266 | +599 | +159.3
Wiring (EST) | 0.370 | +100 | +37.0
Empty, no battery (sum) | 6.619 (calc) | +133.0 (calc) | +880.4
Battery (placed for CG) | 0.820 | −255 | −209.1
Payload / ballast | none (R12, revised 2026-11-01) | — | — | — | — | —
Flight mass | 7.439 (calc; sized MTOW 7.4380; +0.001 kg from rounding the item masses) | | +671.3
CG = Σ moment / Σ mass | | 90.2 (calc: 671.3 / 7.439; target 28 % MAC = 90.3; arms rounded to whole mm)

Acceptance: CG 86.9–93.6 mm aft of the LE (26.97–29.03 % MAC, analysis/results.json cg.cgBattFwd / cgBattAft) with no ballast and no payload (R12); empty ≤ 7.00 kg and take-off ≤ 7.82 kg (calc: 4 × 3.130 / 1.6 = 7.825 → 7.82; − 0.82; DESIGN-BASIS R13); lateral within ± 5 mm. Joiner captured (bolts on). Signed: structures lead ______ date ______; second check ______.

## 6. Gaps: consumables not in the BOM (listed, not added; prices checked 2026-10-21 unless stated)

ID | Item | Why | Price / URL
G1 | Template backing: 3 mm plywood 300 × 600 mm or 1.5 mm aluminium; sandpaper 120/240/400; masking tape; paint pen; isopropyl | WP3–WP8 | Home Depot pages returned HTTP 403 today; $10–15 EST. $0 fallback: print P29 backs in PETG; makerspace sandpaper
G3 | Silicone pitot tubing 3 mm ID × 2.5 m, only if the RMRC kit's tubing (length —) is under 2.5 m | A05 run to the left tip | ≈ $7 EST (not priced live)
G4 | Longer ruthex M3 inserts, only if the M3 torque-out fails | WP2 2.3 | — (decide after the coupon)
G5 | Double-sided foam tape 3 mm (FC fallback, ESC pads, RX, BeeID, airspeed board) | J15, WP10 | ≈ $6 EST (not priced live)
G7 | Bow frame materials for the hot-wire cutter (the supply and the Ni80 24 AWG nichrome are now a BOM line, $41.73) | WP4 | shop stock, —

Former G2 (two more servo-lead packs) is in the BOM and removed from this list. Former G6 (0.5 kg ballast) is removed: no ballast since R12 was revised on 2026-11-01. BOM reserve is $145.83 (C0_BOM.csv rev 2026-11-01; R7 ≥ $100 met); G1, G3, G5 at EST prices ($10–15 + $7 + $6) would take it to ≈ $118–123 (calc).

## 7. Vendor link register (links checked 2026-10-21)

Item | URL | Result today
SunnySky X4110S (lift + pusher) | sunnyskyusa.com/collections/multirotor-motors/products/sunnysky-x4110s-motors | resolves; 165 g; KV 340/400; $46.99; box contents not listed
X4110S drawing (bolt pattern, 3.3 mm depth, adapter, bullet nut) | cdn.shopify.com/s/files/1/2024/0305/files/X4110S.jpg?v=1553581346 | cited from hardware-spec (image)
APC 14 × 8.5EP | apcprop.com/product/14x8-5ep | resolves; $6.79; hub 0.80 × 0.44 in, bore 1/4 in, LPAR06E rings included
EMAX ES3005HV | shop.emax-usa.com/products/es3005hv-high-voltage-servo | resolves; $19.99; dims/holes not listed
CoreWing F405 Wing V2 (ArduPilot) | ardupilot.org/plane/docs/common-CoreWingF405WingV2.html | resolves; 52 × 32 × 17 mm, 40 g; BEC 5/6/7.2 V 8 A; groups 1-2 / 3-4 / 5-7 / 8-10 / 11-12
CoreWing F405 Wing V2 (RMRC) | readymaderc.com/products/details/85786-speedybee-f405-wing-app-fixed-wing-flight-controller | resolves; $67.26; in stock; "30 × 30, custom"
ArduPlane stable firmware for the target | firmware.ardupilot.org/Plane/stable/CoreWingF405WingV2 | cited from firmware/README.md (checked there 2026-10-21)
RMRC SAM-M10Q-5883 GPS + compass (replaces the HGLRC M100-5883, BOM rev 2026-11-01) | ReadyMadeRC (readymaderc.com; product URL —) | $24.99, in stock (docs/research/bom-savings.md, checked 2026-11-01); size and mass — (measure in WP1 1.7)
NewBeeDrone BeeID v1.1 | racedayquads.com/products/newbeedrone-beeid-v1-1-m10q-gps-module-remote-id | resolves; $36.99; 22 × 15.6 × 8 mm, 5.2 g; 5 V
RadioMaster RP3 V2 | radiomasterrc.com/products/rp3-expresslrs-2-4ghz-nano-receiver | resolves; $19.99; 22 × 13 × 4 mm, 4.6 g
RadioMaster Pocket Crush | radiomasterrc.com/products/pocket-crush-radio-controller | resolves; $64.99
RMRC digital airspeed MS4525DO + pitot (replaces the Holybro MS5525DSO, BOM rev 2026-11-01) | ReadyMadeRC (readymaderc.com; product URL —) | $59.99, in stock (docs/research/bom-savings.md, checked 2026-11-01); I²C 0x28, ARSPD_TYPE 1; board size —; the MS5525 CSB-strap datasheet row is no longer needed
LANRC BLHeli_S 45A ESC 4-pack (replaces SoloGood 45A) | amazon.com/dp/B0D2HS4Y4J | $30.00 per 4-pack; 45 A cont / 55 A 10 s, 2–6S, DShot600, 6.6 g (docs/research/bom-savings.md, checked 2026-11-01)
Amass AS150U set (replaces XT90-S) | neuracing.us/product/as150u | $17.26 per set (C0_BOM.csv, checked 2026-11-01); 70 A cont / 140 A 1 min on 10 AWG (Amass AS150U-F sheet via docs/research/propulsion-margin-data.md; DESIGN-BASIS R20)
Harbor Freight ammo can 63750 | harborfreight.com/50-caliber-metal-ammo-can-63750.html | resolves; $19.99
Polymaker PA6-CF20 (West3D) | west3d.com/products/polymaker-fiberon-engineering-filament-pa6-cf20 | resolves; $39.99; hardened nozzle, dryer, anneal
PA6-CF20 TDS v1.1 | fiberon.polymaker.com/wp-content/uploads/TDS_FIBERON-PA6-CF20_V1.1_EN.pdf | PDF read: 280–300 / 40–50 °C, fan off, dry 100 °C 10 h, anneal 100 °C 16 h
Prusament PETG TDS (PETG reference) | 3dprintergear.com.au/assets/files/technical-data-sheet%20(1).pdf | PDF read: 250 ± 10 / 80 ± 10 °C, fan 50 %, 1.27 g/cm³, HDT 68 °C
ArduPilot QuadPlane frame setup (motor order) | ardupilot.org/plane/docs/quadplane-frame-setup.html | resolves; Quad X: M1 FR CCW, M2 RL CCW, M3 FL CW, M4 RR CW
CNC Kitchen heat-set insert guide | cnckitchen.com/blog/how-to-use-our-threaded-insert-removal-tool | resolves; iron 10–20 °C above print temperature
Harvard GSD hot-wire SOP | fablab.gsd.harvard.edu/health-and-safety/standard-operating-procedure-sop/hot-wire-foam-cutting-eps-and-xps | resolves; local exhaust, PPE, XPS/EPS only
Bolt Depot (14 fastener lines; BD-5 now 6385 M3 × 30) | boltdepot.com/Product-Details?product=6379 (and 6381, 6382, 6383, 6385, 6386, 6387, 7219, 6635, 6365, 4792, 4794, 7362, 4513) | HTTP 403 to the fetch tool today; pages read by browser for hardware-spec; 6385 price EST $0.10 (not verified)
OnlineMetals 1.000 × 0.035 / 0.058, 0.875 × 0.058 | onlinemetals.com/en/buy/aluminum/1-od-x-0-035-wall-x-0-93-id-aluminum-round-tube-6061-t6-drawn/pid/1211 ; pid/4342 ; pid/6891 | HTTP 403 today; prices from budget-airframe (2026-10-13)
Home Depot FOAMULAR NGX F-250 2 in / F-150 1 in | homedepot.com/s/foamular%20150 ; homedepot.com/p/100320352 | HTTP 403 today; prices from budget-airframe (2026-10-13)
Amazon lines (ELEGOO PETG B0D41Y3WWZ, ruthex B08BCRZZS3, JeeFly B0FJ21V736, HTRC C150 B0H4QLJYHY, Ovonic B09CTRKLM4, Loctite B000I1RSNS, Scotch tape B000087KUA, horns B0B58ZSC8J, Du-Bro B0006O8TAI, foam glue B0FRM9N2CS, UBEC B0CQ1R55BV, 10 AWG B0D968WN4W, XT60H B0DPBP1N59, servo leads B0FYCJLY1V) | amazon.com/dp/<ASIN>; | all resolve to the product (titles confirmed) but return Amazon's fallback page without prices; prices from the research files (2026-10-13 / 2026-10-21)

## Appendix A. Resolved in Rev B, and open inconsistencies

### 8.1 Resolved in Rev B (Rev A items closed by the v0.4 / rev B work)

1. Boom cut lengths: BOM, cad/params.txt and analysis/results.json now agree at 960.8 + 485.9 mm, butt-spliced (Rev A item 1).
2. Hardware kit: BOM v0.4 carries the Bolt Depot / ruthex / Loctite lines; Mywish kit and generic inserts gone (item 2).
3. Wing bolt: CAD is M5 × 20 with the 8.5 deep nut pocket (item 3).
4. Output map: review §[controls] is superseded by firmware/README.md §4.4 / docs/research/firmware.md §4; manual and wiring.csv follow the firmware (item 4).
5. Airspeed: firmware/vtol_c0.param keeps the BOM's MS5525DSO at ARSPD_TYPE 5 (0x77) with the CSB strap; docs/research/firmware.md now exists (item 5). Remains an M-item (M9), not an inconsistency. (Superseded 2026-11-01: the BOM now carries the RMRC MS4525DO at 0x28, ARSPD_TYPE 1, no strap; M9 closed.)
6. Transport envelope: the joiner is a slip fit (FT06 rev B) and slides out, so the pod piece is 0.85 × 0.16 × 0.16 (item 6). A residual note on the joiner-in-panel option is in 8.2.
7. Servo count: results.json cg.items now "Servos (5)" with the tail-weighted arm (item 7); review's "M4 clamp through-bolts" superseded by hardware-spec J04 friction + witness lines.
8. Rudders: CAD fins carry 30 % chord rudders from 22 mm above the root (item 8).
9. Pusher adapter screws: modelled as F13 M3 × 8 EST, supplied with the motor (item 9) — length still to be confirmed on receipt (WP1 1.5).
10. Review §10 print count: replaced by this manual's 29-type print list (item 11).
11. Servo-lead shortfall (Rev A Gap G2): two more packs are in BOM v0.4.
12. Hinge tape: removed from the BOM; hinges are the tape skin (hardware-spec §7); steps 5.4 and 6.5 rewritten.

### 8.2 Open (genuine) inconsistencies and gaps found while writing Rev B

1. cad/hardware.json general_tolerances.cut_tubes still lists "boom front 925.5" while cad/params.txt segF, cad/verification.txt and the BOM say 960.8; hardware.json meta.design still says "v0.3.1". Regenerate or edit the JSON. (2026-10-25: still open — cad/hardware.json lists "boom front 960.8" and meta.design "CAD rev B" while cad/params.txt segF is now 965.7 at CAD rev C.) (2026-10-25, stall-target re-base: still open — cad/hardware.json lists "boom front 965.7" and meta.design "CAD rev C"; cad/params.txt segF is now 991.0 at CAD rev D.) (2026-11-02: still open — cad/hardware.json lists "boom front 991.0" while cad/params.txt segF is 1045.4.)
2. analysis/results.json "generated" still reads 2026-10-13 although its content is the 2026-10-21 v0.4 sizing (chord 0.2632, MTOW 6.43). (2026-10-25: still reads 2026-10-13 after the R11 re-size, chord 0.2666, MTOW 6.45.) (2026-10-25, stall-target re-base: resolved — generated 2026-10-25 matches the content, chord 0.2842, MTOW 6.55.)
3. firmware/vtol_c0.param comments quote hover 37.5 A and transition 74.4 A (v0.3.1); v0.4 results.json gives 40.0 A and 73.0 A. The parameter values (Q_M_BAT_CURR_MAX 85, TKOFF_THR_MAX 75) still hold; only the comments are stale. (2026-10-25: the comments still say 40.0 A / 73.0 A; the re-sized results.json gives 40.2 A / 73.5 A.) (2026-10-25, stall-target re-base: the comments now say 40.2 A / 73.5 A and the header MTOW 6.45 kg with hover throttle ~0.52 = 1612.6 g; results.json gives 41.1 A / 68.4 A, MTOW 6.55 kg, 1637.9 g (still ~0.52). Values still hold; comments stale; the param file is not edited by this re-base.) (2026-11-02: comments updated to the 2026-11-01 sizing — MTOW 7.44 kg, hover 51.0 A, transition 82.0 A EST, hover throttle ≈ 0.59 = 1858.9 g / 3130 g, LANRC ESC, RMRC GPS; values unchanged; see item 16.)
4. Pushrod lengths: cad/README.md says ailerons 39 / elevator 21 / rudders 96 mm; cad/mesh/meta.json says "cut to 44 / 32 / 100". The manual uses the meta.json cut lengths and treats the README values as pivot-to-pivot (EST). (2026-10-25: resolved — cad/README.md and cad/mesh/meta.json now both give the cut lengths 45 / 33 / 100 mm, cad/params.txt rodAileron / rodElevator / rodRudder.) (2026-10-25, stall-target re-base: open again — cad/params.txt gives 48.4 / 39.6 / 102.4 and cad/mesh/meta.json 48 / 40 / 102 mm at CAD rev D, but cad/README.md controls still says 45 / 33 / 100. The manual uses meta.json / params.txt.) (2026-11-02: resolved — cad/README.md, cad/mesh/meta.json and cad/params.txt agree at 56 / 55 / 107 mm.) (2026-11-03: the rudder rods are 88 mm after the clevis fix, cad/params.txt rodRudder 88.4 and cad/README.md controls; the manual uses 56 / 55 / 88.)
5. APC pusher hub: CAD models 8 mm EST; APC lists 0.44 in = 11.2 mm (apcprop.com, checked 2026-10-21). The adapter thread (14 mm) still covers 11.2 + washer 2.5 = 13.7 mm (calc); confirm the bullet nut engages ≥ 3 threads on receipt.
6. Joiner in transport: resolved. Rule: the joiner always travels loose in its own sleeve (WP14). Left in a panel it would protrude 460 mm (760 − 300 stop depth) and make a 1.58 m piece, over the R4 1.5 m estimate.
7. PA6-CF quantity: one 500 g spool against ≈ 400 g of PA6-CF parts + coupon leaves no spare motor mount (second spool $39.99 not added; R7 decision).
8. Pod internal structure (frames, rails, bay walls) is undefined in the CAD (one solid); WP8 is a method EST and the pod mass (sizing 0.60 kg EST; CAD foam alone 0.305 kg) is unverified until WP8.
9. Servo tab pattern (46 × 10) and FC hole pattern (45 × 25) are EST in the CAD (cad/mesh/meta.json); P17/P18 wait for M6.
10. Bolt Depot 6385 (M3 × 30) price and product number are EST (hardware-spec CAD notes J07); verify at checkout.
11. Pusher-cup slots (2026-10-25, thermal): resolved. Not cut at build: the re-run with the X4110S pusher (docs/research/thermal.md §6.3) shows the prediction is set by the loss estimate, not by the cup, and slots inside the tail-ring bore would vent into foam. The decision moves to the G03/F08 measurement (step 2.7).
12. Disc clearance (2026-10-25): cad/README.md "Disc clearance" still says 70 mm; cad/verification.txt and cad/params.txt discClear give 79.0 mm at CAD rev D. The manual uses 79.0. (2026-11-02: cad/params.txt discClear 106.1 mm and boom segF 1045.4 mm, but cad/verification.txt (built 21:38, before the 22:15 params.txt update) prints 105.0 mm and a boom cut of 1043.7 mm. The manual uses params.txt; rebuild the CAD to close.)
13. Longest piece (2026-10-25): the boom unit (front boom + stub, shop-spliced) is 1.48 m (calc: 991.0 + 485.9 mm), while analysis/results.json geo.longestPiece says 1.2 m (TEST-PLAN R4/S08 use 1.2). The boom unit is inside the R4 1.5 m estimate by 20 mm; S08 should measure it. (2026-11-02: now over — the boom unit is 1.53 m (calc: 1045.4 + 485.9 mm), 31 mm over the R4 1.5 m working estimate, and geo.longestPiece still reports 1.2 m because analysis/sizing.mjs takes the longest single segment (geo.segs 1.0454) or the half-span, not the spliced unit. Open: measure the real car (M11) or make the splice a field joint.)
14. Airspeed and GPS documents (2026-11-02): firmware/README.md §4.3 and the CSB-strap text in other documents may still describe the Holybro MS5525DSO; this manual, firmware/vtol_c0.param (ARSPD_TYPE 1) and the BOM use the RMRC MS4525DO at 0x28. Check firmware/README.md, firmware/peripherals.md and docs/research/firmware.md (not edited here).
15. Drawing set (resolved 2026-11-03): rev F prints title-block rev F / 2026-11-03 and GA note 4 "no payload, no ballast" (R12); the 23 layout overlaps are cleared (cad/drawings/layout-check.txt 0). cad/mesh/meta.json Elevator says the horn is at z +40 while cad/params.txt comp Control_Horn places it at z +21.1; the manual uses params.txt.
16. Firmware values to review (2026-11-02, values not changed): BATT_LOW_MAH 1950 (30 % left) is above the planned 27.4 % landing state (calc: 1 − 99.51 / 0.95 / 144.3), so the low-battery RTL can fire before a full mission ends; Q_M_BAT_CURR_MAX 85 sits only 3 A above the 82.0 A transition estimate (EST), so the lift motors may be throttled in a hard transition; Q_M_THST_HOVER 0.25 is the first-flight value with a learned value expected near 0.59. Decide after the C07/C11 bench data.
17. Thermal basis (2026-11-02): cad/sim/results.txt motor_T_steady 185.6 °C is at the cad/Sim.cs 35 °C ambient (steady upper bound); the design-ambient transients (25 °C, R21) are in cad/sim/thermal/results.txt. The P03 pusher measurement thresholds (2.7) still come from the 2026-10-25 model.
18. Battery access (resolved in the CAD 2026-11-03, team cross-check X1): before this change the battery bay was sealed. There was 35 mm of foam between the bay ceiling (y −0.020) and the canopy pocket floor (y +0.015) over the whole pack, so the pack could not be loaded or swapped (ray cast through cad/mesh/Fuselage_Pod.STL; docs/research/team-crosscheck.md §2.1). The bay was also only 165 mm long for the 155 mm pack, so the pack could slide only ± 5 mm against the ± 30 mm the 12.2 CG trim assumes. The CAD now has (cad/BuildVtol.cs, cad/params.mjs):
  - a 165 × 52 access well from the bay ceiling into the canopy pocket. The pack (48 mm wide) lifts out through the hatch with about 2.5 mm a side at the rear end of the canopy opening (calc);
  - a bay 225 mm long (pack + 2 × (30 + 5) mm) and a 220 mm tray P21;
  - the FC tray moved forward from x +0.375 to +0.4075, so it sits on foam 10 mm ahead of the bay. Check in 8.5: the pack lifts out and goes back in with the hatch off and the straps undone, in under 60 s (EST), and it slides to both ± 30 mm marks. Slide it back to the centre mark before lifting it out: at ± 30 mm one end is under the foam.
19. Servo rail stall current (2026-11-03, X2): the ES3005HV draws 2.5 A stalled at 6 V (vendor), so five stalled draw 12.5 A against the FC servo BEC's 8 A continuous / 14 A peak (docs/build/wiring.csv A06 corrected from 1.5 A per servo). Bench test in WP10: clamp meter on the rail, hold each surface at its stop, then all five. Pass: < 8 A sustained, no FC brownout. Fail: add a separate 6 V servo UBEC.
20. Per-motor current (2026-11-03, X3): one X4110S reaches 27.7 A at full throttle (budget-lift A3) against its "26A / 30S" rating (ReadyMadeRC, checked 2026-11-03). Q_M_BAT_CURR_MAX caps only the total. On the thrust stand, record the throttle at 26 A on a full pack and set Q_M_SPIN_MAX to it if below 0.95; record the thrust lost.
21. Clamp re-torque (2026-11-03, X4): PETG clamp preload relaxes about 12 % in a day and 30 % in a week (EST, creep model in the team's DBF-VTOL tolerance analysis). Re-torque every printed-clamp screw 24 h after first assembly, then check the witness marks before each flight day and after any hot-car transport. A screw that turns more than about 30° to return to torque twice → move that clamp to PA6-CF.

End of DBF-MAN-001 Rev B (re-based 2026-11-02).
