davinciucberkeley-collab/DillonVTOL/docs/validation/proofs/README.md

# Proof sheets

One page per claim: the calculation re-run with its numbers, every input and where it comes from, the independent check, and the claims it feeds.

| Claim | Status | Re-run | Statement |
|---|---|---|---|
| [MFG-11](MFG-11.md) | Unverified | evidence | All foam bonds use "foam-safe glue" and small structural parts 5-min epoxy. |
| [AERO-12](AERO-12.md) | Partially Verified | evidence | Zero-lift drag: sizing CD0 0.0425 (0.0266 clean + 0.0159 stopped rotors, booms and gear); component build-up 0.0375. |
| [AERO-13](AERO-13.md) | Partially Verified | ✓ | Cruise L/D is 8.71 (sizing polar) / 9.97 (component build-up) at 18 m/s. |
| [AERO-19](AERO-19.md) | Partially Verified | ✓ | Transition: 2 x 20 s at P_hover + 2 P_cruise = 1723 W, 82.1 A at 21.0 V (EST power model); with a pack at the C11 limit (6.0 mOhm/cell) at 50 % SOC the cells stay at 3.31 V, above the C11 3.2 V/cell transition-sag criterion. |
| [AERO-22](AERO-22.md) | Partially Verified | ✓ | MTOW closes at 7.438 kg (sizing calibrated to the CAD roll-up); the bottom-up CAD/vendor roll-up gives 7.416 kg. Not weighed. Below the 8-15 kg working target of R2, under the 25 kg cap. |
| [AERO-24](AERO-24.md) | Partially Verified | evidence | CG at 28 % MAC with the battery at x = +0.255 m; the forward battery limit 0.339 m leaves 84 mm of travel (about 2.9 % MAC of CG adjustment). No payload (R12), so the no-payload CG is the same. |
| [AERO-26](AERO-26.md) | Partially Verified | ✓ | Static margin 10.4 % MAC at the 28 % CG (AVL NP); 9.4-11.4 % for the battery moved +/-30 mm; the same with no payload. |
| [AERO-31](AERO-31.md) | Partially Verified | evidence | C0 committed spend is $1,854.55 (goods $1,598.69 x 1.1025 tax + $91.99 shipping), leaving a $145.45 crash reserve under the $2,000 cap (R7 target >= $100). |
| [CFD-02](CFD-02.md) | Partially Verified | evidence | Grid convergence at alpha 4 deg (L2-L3-L4): CL 0.4941 / 0.5104 / 0.5229 on 3,957,746 / 9,271,143 / 23,261,119 tetrahedra. |
| [CFD-08](CFD-08.md) | Partially Verified | evidence | Induced drag from the Trefftz plane CDi 0.0115 at alpha 4 deg. |
| [CFD-11](CFD-11.md) | Partially Verified | evidence | Wall Cp above the incompressible stagnation bound (Cp = 1) is a local numerical overshoot: it covers under 1 % of wall nodes in every case and its share falls 6-fold from L1 to L4 but not on every step, so it is a discretisation artefact, not a physical pressure. |
| [MFG-10](MFG-10.md) | Partially Verified | evidence | Every fastener type in cad/hardware.json (13) has a torque (0.15-1.0 N m), applied by hanging a known mass from the hex key (T = m g L; 0.5 N m = 0.85 kg at 60 mm). 11 of the 13 are estimates gated on the insert torque-out coupon (C02) and the motor-floor relaxation test (C04). |
| [MFG-12](MFG-12.md) | Partially Verified | evidence | Bottom-up mass 7.416 kg (analysis/mass/mass_budget.json: CAD geometry x sourced densities + vendor masses + wiring) agrees with the sizing MTOW 7.438 kg (-0.30 %); 1.155 kg (16 %) of it is printed-part and avionics estimates not yet weighed. |
| [AERO-10](AERO-10.md) | Verified | evidence | Lift-curve slopes: wing VLM 4.55 /rad (analysis/aero.json), aircraft AVL 4.87 (no pod) / 5.04 (pod). |
| [AERO-11](AERO-11.md) | Verified | ✓ | Sizing Oswald e 0.80 is at or below Raymer's estimate 0.826 for AR 7.45 (conservative); AVL inviscid 0.947, build-up fit 0.876. |
| [AERO-25](AERO-25.md) | Verified | evidence | Neutral point 38.4 % MAC (AVL with pod); AeroSandbox VLM 39.9 %, sizing estimate 38.2 %. |
| [AERO-29](AERO-29.md) | Verified | ✓ | Best-L/D speed on the sizing polar is V* 13.1 m/s (CL* 0.89); the 18 m/s cruise is the R11 lower bound, 1.37 V*. |
| [AERO-30](AERO-30.md) | Verified | evidence | The generated 'Design outcomes' block of docs/DESIGN-BASIS.md and the status block of docs/research/stall-margin.md quote the current results.json values (18 of 18 numbers match to the printed precision). |
| [CFD-01](CFD-01.md) | Verified | evidence | 8 of 8 full-aircraft cruise cases ran to completion in SU2. |
| [CFD-03](CFD-03.md) | Verified | evidence | SU2's reported forces equal an independent pressure integration over the same wall triangles. |
| [CFD-04](CFD-04.md) | Verified | evidence | Boundary conditions behave: no flow through the symmetry plane; free stream recovered at the far field. |
| [CFD-05](CFD-05.md) | Verified | evidence | Whole-aircraft lift-curve slope 4.67 /rad (alpha 0-6 deg, elevator 0). |
| [CFD-06](CFD-06.md) | Verified | evidence | CL 0.523 at alpha 4 deg, elevator 0, V 18 m/s (finest mesh). |
| [CFD-10](CFD-10.md) | Verified | evidence | The inviscid solver's surface CD (0.0345) is not a drag prediction: the part above the induced drag is numerical, and it falls with every mesh refinement. |
| [MFG-01](MFG-01.md) | Verified | evidence | Analysis inputs and the CAD follow the frozen design exactly: cad/params.txt and cad/params.built.txt (the copy the CAD model and drawings were built from, BuildVtol 2026-11-02 09:52) both equal analysis/results.json on chord, MTOW, boom arm, root moment, tip mass, tip force and motor heat (max difference 0.000 %). Of 151 numeric parameters only feaWingForce differs (an FEA load that only cad/Sim.cs reads; corrected after the build). |
| [MFG-02](MFG-02.md) | Verified | evidence | Interference check (CAD rebuilt 2026-11-03): 263 interferences = 189 intended heat-set insert press fits (1423.0 mm3) + 74 others (244.0 mm3), and every one of the 74 has a model-artefact disposition: horn screws and backplates through surfaces drilled on assembly, nylock-pocket corner slivers, F07 screw tips, foam pockets cut to fit, and < 1 mm3 numerical slivers on coincident faces (largest 18.25 mm3, Elevator x F11 horn screw). No entry is unexplained. The 31 unexplained entries of 2026-11-02 (392.8 mm3) were real model errors and are fixed: canopy flange/tongue 5 mm longer than the pod slots and a spline dome bulging past the pocket; rudder clevis fork turned 90 deg to the horn and the right rudder rod built at the left rod's 107 mm; component positions written at 5 decimals (4 um offsets at the spar socket and spar collar). |
| [MFG-03](MFG-03.md) | Verified | evidence | Drawing DBF-DRW-001 rev F (9 sheets, generated from the CAD by cad/Drawings.cs on 2026-11-03 from the current params) carries fits and tolerances from params.txt and hardware.json, including a hot-wired foam tolerance row (+-0.5 EST) and a joiner-bore coaxiality callout (diameter 0.4 to the spar sockets, sheet 4 note 7, EST); its layout self-check logs 0 label/view overlaps. |
| [MFG-04](MFG-04.md) | Verified | evidence | The fastener order (docs/research/hardware-spec.md section 6 and the BOM line bought from it) matches cad/hardware.json and cad/params.txt: every Bolt Depot part number orders the thread size and length the joints need. |
| [AERO-03](AERO-03.md) | Partially Verified | evidence | SU2 2-D RANS (SA, fully turbulent) NACA 2415 at Re 3.50e5 (run 2026-10-26 for the previous chord; equal to the current 16 m/s transition-speed Re): cd 0.0155 at alpha 2 deg; XFOIL transitional at the current cruise Re 3.97e5: cd 0.0087. |
| [AERO-05](AERO-05.md) | Partially Verified | evidence | Adopted 2-D CL_max of the NACA 2415 is 1.30 (wind-tunnel abstract, Genc, Lock, Kaynak 2008, Re 2e5); it lies inside the spread of the three repo solvers at the stall Re (XFOIL 1.36, NeuralFoil 1.27, SU2 SA 1.19). |
| [AERO-06](AERO-06.md) | Partially Verified | evidence | Trimmed 3-D CL_max is 1.115 (critical-section method on AVL strip loads, tail download included); Raymer's 0.9 x 1.30 gives 1.17. |
| [AERO-07](AERO-07.md) | Partially Verified | ✓ | Stall speed at MTOW 7.438 kg is 11.75 m/s, meeting R11 (<= 12 m/s) with a 4.1 % CL_max margin (R11 is lost below CL_max 1.069 or above 7.758 kg). |
| [MFG-05](MFG-05.md) | Partially Verified | ✓ | Joiner is a slip fit in the spar sockets (FT01): diametral clearance 0.229 mm nominal, -0.076 / +0.534 mm worst case; measure on receipt and lap (tight) or shim (> 0.30 mm). |
| [MFG-06](MFG-06.md) | Partially Verified | evidence | Spar sockets bonded in hot-wired channels (FT05, 26.0 +-0.5 mm) can tilt up to 1.50 mrad (WC) while curing, more than the joiner's own 0.76 mrad free tilt in the socket. The panel then follows the joiner: up to 0.09 deg panel angle error, a 0.48 mm gap across the root face and 1.7 mm at the tip (WC). The joiner still slides in because the panel is free until J10 is tightened. |
| [STR-07](STR-07.md) | Partially Verified | ✓ | Joiner 0.875 x 0.058 in at the centreline, ultimate load with the Schrenk design moment 91.0 N m: 194.7 MPa, reserve factor 1.23 on the 240 MPa minimum yield (1.41 on the 275 MPa library value, results.json struct.MS_J). With the AVL moment 89.5 N m: 191.4 MPa, RF 1.25. |
| [STR-13](STR-13.md) | Partially Verified | evidence | Wing retention bolt J10 (one M5 per side at 70 % chord) carries only panel torsion: about 20.5 N at ultimate (0.3 % of M5 shear capacity; 0.64 MPa bearing on the 6.4 mm PETG tongue, RF about 61 on a 39 MPa PETG proxy yield). The 0.5 N m EST torque puts about 13 MPa under the head (0.34 of that yield). |
| [AERO-01](AERO-01.md) | Verified | ✓ | Cruise chord Reynolds number is 3.97e5 at 18 m/s on the chord 0.3223 m (aero package and sizing agree since 2026-11-02); stall 2.65e5 at 12 m/s. |
| [AERO-02](AERO-02.md) | Verified | evidence | XFOIL 6.99, NACA 2415 at the cruise Re 3.97e5 (Ncrit 9): cl_alpha 6.81 /rad, alpha_0L -2.00 deg, Cm_c/4 -0.0529, cd_min 0.0080. |
| [AERO-04](AERO-04.md) | Verified | evidence | SU2 2-D mesh study at alpha 10 deg (Re 3.50e5): GCI_fine 22.5 % on CL (observed order p 0.61, actual refinement ratios 1.43 / 1.50), so the SU2 CL near stall is not mesh-converged; it is not used for sizing. |
| [AERO-08](AERO-08.md) | Verified | ✓ | Wing: S 0.774 m2, chord 0.322 m, AR 7.45 on a 2.4 m span. |
| [AERO-09](AERO-09.md) | Verified | ✓ | Cruise CL is 0.475 at 18 m/s. |
| [AERO-23](AERO-23.md) | Verified | ✓ | The sizing's wing mass 1.835 kg (foam + tape skins + 0.675 kg spar/joiner + 0.253 kg printed hardware) agrees with the CAD bottom-up wing group (1.809 kg). Not weighed. |
| [CFD-09](CFD-09.md) | Verified | ✓ | Cruise chord Reynolds number 3.92e+05: attached, lift-dominated flow, so inviscid CFD is admissible for lift and moment at alpha <= 8 deg. |
| [CFD-12](CFD-12.md) | Verified | evidence | At the 3-D meshes' lifting-surface spacing (mesh rev 2: L2, L3, L4), the SU2 scheme matches XFOIL's inviscid section lift at 4 deg within 5 % and its lift slope within 8 %, approaching XFOIL as the spacing is refined. |
| [MFG-09](MFG-09.md) | Verified | evidence | Wing bolt J10 (rev E): an M5 x 25 with a 2.0 mm spot-face and a 11.0 mm nut pocket puts the screw end 3.51 mm past the nylock nominal and at least 1.61 mm (two 0.8 mm pitches = 1.6 mm) in the worst case, and keeps it 1.09 mm inside the lower skin in the worst case. Valid only with M5 x 25 screws (MFG-04). |
| [STR-06](STR-06.md) | Verified | ✓ | Wing root bending moment at ultimate load (n 4.5 = 3.0 x 1.5, MTOW 7.438 kg, no inertia relief) is 89.5 N m with the AVL span loading of this wing. Sizing and FEA use the Schrenk loading since 2026-11-02: 91.0 N m (+1.7 % vs AVL, conservative); the former elliptic value 83.6 N m was 6.6 % low. Crediting the boom-mounted mass (inertia relief) would lower it to 65.3 N m. |
| [STR-08](STR-08.md) | Verified | evidence | The SOLIDWORKS spar + joiner model (joiner modelled at the socket ID 22.454 mm and bonded, centreline fixed, Schrenk root moment 91.03 N m) reproduces beam theory on its own geometry: 181.2 MPa (3 mm mesh) vs 179.4 MPa hand at the centreline (+1.0 %); field within 2.8 % at 6 stations. The 2 mm-mesh peak 191.2 MPa (+6.6 %) is the fixed-face singularity. The modelled joiner is 9.6 % stiffer than the real one, so the real-joiner stress is STR-07. |
| [STR-09](STR-09.md) | Verified | evidence | Spar tip deflection at ultimate on the FEA geometry (rigid centreline, bonded joiner, spar end at 0.88 m): 28.7 mm FEA vs 28.6 mm by double integration of M/EI (+0.4 %). The real wingtip deflects more; S01 measures it at limit load (pass <= 120 mm). |
| [AERO-28](AERO-28.md) | Partially Verified | evidence | Cruise trim at alpha 4.14 deg with elevator -4.00 deg (AVL, with pod); stall trim (CL 1.07) elevator -7.8 deg. |
| [AERO-27](AERO-27.md) | Verified | ✓ | Tail volumes are V_h 0.35 and V_v 0.030 (sizing targets; S_h 0.1084 m2, S_v 0.0692 m2, l_h 0.805 m), 30 % and 25 % below Raymer's homebuilt typical values. |
| [CFD-07](CFD-07.md) | Verified | evidence | Neutral point 39.7 % MAC from the CFD moment slope (static margin 11.7 % at the 28 % CG). |
| [MFG-08](MFG-08.md) | Partially Verified | evidence | Splice plug (FT04, 23.2 +-0.2 mm in the 23.622 +-0.203 mm tube ID) aligns the tubes; cross-bolts carry the load. Clearance 0.422 mm nominal, 0.019-0.825 mm WC: up to 1.2 deg free tilt (0.6 deg nominal) of the rear stub before the bolts take over. |
| [STR-10](STR-10.md) | Partially Verified | evidence | Boom-to-wing clamps: one front motor at maximum thrust puts 96.1 N tension into the rear clamp (48.0 N per M3 screw, 2 % of the A2-70 M3 yield load) and 126.8 N into the front clamp. The M3 insert pull-out (C03, pass >= 300 N in PETG) and the rear-hardpoint foam bond are not yet measured. |
| [STR-12](STR-12.md) | Partially Verified | evidence | Boom splice J04 (printed plug + 2 x M3 cross-bolts at the rear motor): at n 4.5 the tail-side inertia gives 102 N per bolt (2.4 % of the A2-70 M3 double-shear capacity, 19 MPa bearing on the 0.89 mm wall). Strength is ample; stiffness is not controlled: hole and plug clearance allow up to 1.3 deg free rotation before the bolts bear. |
| [STR-14](STR-14.md) | Partially Verified | evidence | Clamp friction (4 x M3 at 0.5 N m, mu 0.3 EST) holds the boom against rotation: 7.3 N m with dry threads (15.9 N m if lubricated), 11 x the EST maximum motor reaction torque 0.66 N m, so no cross-bolts are needed at the clamps. |
| [MFG-07](MFG-07.md) | Verified | evidence | Split clamps (bore 25.6 +-0.2 mm, 1.2 mm split gap) always grip the 1.000 in tube before the halves touch: worst-case clearance 0.502 mm, 0.70 mm short of the gap. |
| [STR-01](STR-01.md) | Verified | ✓ | Front boom arm (1.000 x 0.035 in 6061-T6, 488 mm from the front clamp to the motor) at one lift unit's maximum thrust 30.69 N: root stress 37.0 MPa by beam theory (SOLIDWORKS 35.4 MPa on the 3 mm mesh, 38.6 MPa on the 1.5 mm mesh at the fixed face); reserve factor 6.5 on the 240 MPa minimum yield. |
| [STR-02](STR-02.md) | Verified | evidence | Away from the fixed root face the boom FEA stress field matches beam theory within 1.7 % at 4 stations (50-300 mm). The root peak grows 9.0 % on halving the mesh (35.4 -> 38.6 MPa): it is the restraint singularity, not a converged value, so the design stress is the beam value of STR-01. |
| [STR-03](STR-03.md) | Verified | ✓ | Boom tip deflection at maximum thrust with a rigid root: 3.16 mm FEA vs 3.09 mm hand with the same load position (+2.0 %). The repo hand value 3.35 mm puts the load at the tube end. The real printed clamp adds root rotation; S02 measures it. |
| [STR-04](STR-04.md) | Verified | ✓ | Boom first bending mode with the 0.3255 kg lift unit and a rigid root: 27.7 Hz FEA vs 27.9 Hz hand with the tip mass at the same position (-0.8 %). The EST hover rotor frequency (1P) 91 Hz is 3.3 x higher; a compliant root only lowers f1, away from 1P. |
| [XT-01](XT-01.md) | Verified | evidence | The SOLIDWORKS boom study (cad/Sim.cs Boom) is reproduced by an independent mesher and solver. |
| [AERO-16](AERO-16.md) | Partially Verified | ✓ | Hover electrical power is 1132 W (283 W per motor at 1,859 gf thrust) at 7.438 kg with 4 x X4110S + 17 in props. |
| [AERO-32](AERO-32.md) | Partially Verified | evidence | Hover T/W at mid-pack under load is about 1.45 (pack at the C11 limit 6.0 mOhm/cell, 3.80 V/cell rest), just above the 1.43 that ArduPilot's 70 % hover-throttle limit implies: a marginal pass. |
| [THM-02](THM-02.md) | Partially Verified | evidence | Film coefficient on the lift motor: 44.6 W/m2K in hover wash (momentum-theory v_i 7.13 m/s, Hilpert); Churchill-Bernstein gives 45.1 (+1.1 %). At 18 m/s cruise the two correlations give 84.5 and 78.8 W/m2K (-6.7 %), a gap that does not change the lift-motor mission peak (< 0.5 K). |
| [THM-03](THM-03.md) | Partially Verified | ✓ | Lift motor heat in hover 56.6 W (20 % of the 283.0 W input, EST) is an upper estimate: the maker's phase resistance 107 mOhm and no-load current 0.6 A give 27.6 W (19.4 W copper + 8.2 W no-load, EST), so every lift-unit temperature built on the 20 % rule is conservative. |
| [THM-04](THM-04.md) | Partially Verified | evidence | Lift motor can at the 25 C design ambient: 59.2 C after a 60 s hover, 72.8 C at 90 s, mission peak 75.2 C (FEA) against the 80 C EST limit. A lumped model of the motor alone (no mount) peaks at 80.6 C, an upper bound. |
| [THM-05](THM-05.md) | Partially Verified | evidence | Lift ESC on the boom at the 25 C design ambient: 50.3 C after a 60 s hover, mission peak 61.7 C (limit 70 C EST); lumped check 49.9 C at 60 s. |
| [AERO-18](AERO-18.md) | Verified | ✓ | Hover T/W is 1.68 at MTOW 7.438 kg on the maker's 22.2 V thrust table (4 x 3,130 gf, 17x5.8 prop), meeting R13 (>= 1.6 on that table); R13 holds up to 7.825 kg. |
| [STR-05](STR-05.md) | Verified | ✓ | Lift-unit (boom tip) mass is 0.3255 kg (motor 165 g + ESC 25 g EST + prop 32 g + motor mount and prop plate 103.5 g from the CAD calibration); the FEA, modal study and sizing all use it. The CAD part roll-up gives 0.3305 kg (+1.5 %). |
| [THM-01](THM-01.md) | Verified | ✓ | Lift motor alone, steady state (an upper bound never reached in flight, tau about 206 s vs 60-90 s hovers): 178.2 C FEA vs 175.0 C hand at the 25 C design ambient (+2.1 % of the rise), and 185.6 vs 185.0 C (+0.4 %) in the Sim.cs solver-validation case (fixed 35 C test ambient), for the EST inputs Q 56.6 W (THM-03) and h 44.6 W/m2K (THM-02). |
| [AERO-14](AERO-14.md) | Partially Verified | ✓ | Cruise electrical power is 296 W (13.3 A at 22.2 V) at 18 m/s, computed with etaProp 0.60 (conservative, AERO-15) and etaMEc 0.85 (EST); with the APC maker efficiency 0.737 it would be 241 W. |
| [THM-08](THM-08.md) | Partially Verified | evidence | Pusher motor in the PA6-CF cup at the 25 C design ambient: 76.0 C after 600 s cruise and 77.3 C in steady state, both below the 80 C EST limit; a fully exposed can (lower bound) gives 67.4 C. The cup floor reaches 76.1 C against the PA6-CF HDT of 173 C. |
| [AERO-15](AERO-15.md) | Verified | ✓ | The pusher efficiency 0.60 used in sizing (X4110S + APC 14x8.5EP) is conservative: it is at or below the APC maker value 0.737 at the 18 m/s cruise point (6000 rpm, 8.43 N thrust vs 8.38 N drag). |
| [AERO-17](AERO-17.md) | Partially Verified | ✓ | Hover current is 51.0 A at the 22.2 V nominal pack voltage (53.9 A at the 21.0 V loaded voltage the sizing assumes); per ESC about 13 A against the 45 A rating. |
| [AERO-20](AERO-20.md) | Partially Verified | ✓ | Cruise time available is 12.05 min after 120 s hover + 40 s transition with the 20 % reserve (R10 needs 10 min; design margin 11.5 min); conservative, as the maker prop efficiency would give 14.8 min. |
| [THM-06](THM-06.md) | Partially Verified | evidence | Battery pack in the sealed bay ends the mission at 53.2 C (FEA) against the 60 C limit, for a pack that passes the C11 acceptance limit (<= 6.0 mOhm/cell) flown at <= 25 C ambient (DESIGN-BASIS R21); the adiabatic hand bound is 53.9 C. |
| [AERO-21](AERO-21.md) | Verified | ✓ | Flight pack Ovonic 6S 6500 mAh 100C: 144.3 Wh nameplate (6.5 Ah x 22.2 V) and 0.82 kg, matching the maker listing (825 +/- 20 g). |
| [STR-11](STR-11.md) | Partially Verified | evidence | Vertical landing at the flight software's touchdown speed (Q_LAND_FINAL_SPD 0.3 m/s): boom stress at the clamp 73 MPa front / 79 MPa rear (RF 3.3 / 3.0 on minimum yield); hard case at 0.6 m/s: 123 / 146 MPa (RF 1.96 / 1.65). Requirement change: the old 0.30 m drop (2.43 m/s, 8-32 g) had no source and would yield the booms; the design case is now 2 x Q_LAND_FINAL_SPD. |
| [THM-07](THM-07.md) | Partially Verified | evidence | Flight controller in the closed pod bay reaches 60.3 C (FEA) / 56.0 C (lumped) at the end of a 760 s mission at 25 C, below the 85 C STM32F405 rating. Its steady state (89.7 C) would pass 85 C after about 45-51 min powered (EST), so ground time with the FC powered must be limited. |
