davinciucberkeley-collab/DillonVTOL/docs/validation/VALIDATION-MATRIX.md

# Engineering validation matrix

Generated 2026-11-03 18:28 by `analysis/validation/build_matrix.py` from `claims_aero.json` (32), `claims_struct.json` (34), `claims_cfd.json` (12), `claims_xtool.json` (1).

| Status | Meaning | Count |
|---|---|---:|
| Verified | Reproducible calculation or simulation plus an independent check that agrees within its stated tolerance. | 40 |
| Partially Verified | Some evidence exists, but important checks are incomplete. | 38 |
| Unverified | Insufficient evidence to establish the result. | 1 |
| Failed | A calculation, simulation or independent check contradicts the claim. | 0 |

| ID | Component | Discipline | Claim | Status | Independent check | Why |
|---|---|---|---|---|---|---|
| MFG-11 | Whole aircraft | manufacturing | All foam bonds use "foam-safe glue" and small structural parts 5-min epoxy. | **Unverified** | none: no adhesive strength in the repo | No product, surface prep, cure schedule or strength is specified for the joints that carry the clamp loads (up to 127 N), the spar sockets and the wing tongue. |
| AERO-12 | Whole aircraft | aerodynamics | Zero-lift drag: sizing CD0 0.0425 (0.0266 clean + 0.0159 stopped rotors, booms and gear); component build-up 0.0375. | **Partially Verified** | own build-up (Schlichting Cf, Hoerner FF), x_tr 0.30; fully turbulent bound 0.0462 (+1.0 %) | Independent build-up 0.0429 is 1.0 % above the sizing value (fully turbulent bound 0.046); about 1/3 of CD0 is bluff items (stopped props, clamps, legs) whose coefficients are shared, unmeasured estimates. |
| AERO-13 | Whole aircraft | aerodynamics | Cruise L/D is 8.71 (sizing polar) / 9.97 (component build-up) at 18 m/s. | **Partially Verified** | independent CD0 + Raymer e; fully turbulent 8.21 (-0.1 %) | Independent L/D 8.70 (-0.1 %), fully turbulent 8.21 (-6 %); no measured drag. |
| AERO-19 | Whole aircraft | performance | Transition: 2 x 20 s at P_hover + 2 P_cruise = 1723 W, 82.1 A at 21.0 V (EST power model); with a pack at the C11 limit (6.0 mOhm/cell) at 50 % SOC the cells stay at 3.31 V, above the C11 3.2 V/cell transition-sag criterion. | **Partially Verified** | cell voltage at 82 A, 6.0 mOhm, 3.80 V rest vs the C11 3.2 V/cell criterion (relation >=) (+3.4 %) | The old check compared 82 A with an unsourced 60 A 'continuous' EST; a pack's continuous rating is a temperature limit (Zeee test ~57-58 A), and the heat of 2 x 20 s is covered by THM-06. The sag check passes with 0.11 V/cell margin, but 82 A is an EST power model and R_cell / rest voltage are unmeasured: test-gated by C11. |
| AERO-22 | Whole aircraft | mass | MTOW closes at 7.438 kg (sizing calibrated to the CAD roll-up); the bottom-up CAD/vendor roll-up gives 7.416 kg. Not weighed. Below the 8-15 kg working target of R2, under the 25 kg cap. | **Partially Verified** | sum of the CG item list (AERO-22); independent CAD/vendor bottom-up roll-up (AERO-22b, -0.30 %) (+0.0 %) | The closure reproduces and the CAD bottom-up agrees to 0.26 %, but 1.155 kg (16 %) are unweighed estimates, and the margins that depend on MTOW are smaller than a plausible error on that share (R11 stall +0.32 kg, R13 T/W +0.39 kg). |
| AERO-24 | Whole aircraft | mass | CG at 28 % MAC with the battery at x = +0.255 m; the forward battery limit 0.339 m leaves 84 mm of travel (about 2.9 % MAC of CG adjustment). No payload (R12), so the no-payload CG is the same. | **Partially Verified** | moment sum from the item list (-0.0 %) | Moments reproduce (0.00 %), but item masses and stations are unweighed estimates and the battery is placed to force 28 %; only ~2.9 % MAC of forward correction is available. |
| AERO-26 | Whole aircraft | stability | Static margin 10.4 % MAC at the 28 % CG (AVL NP); 9.4-11.4 % for the battery moved +/-30 mm; the same with no payload. | **Partially Verified** | hand NP minus CG (+18.4 %) | Hand estimate 12.3 % (+1.9 pts); the margin itself depends on the unweighed CG (AERO-24) and on stopped props that no method models (~1-2 % MAC destabilising). |
| AERO-31 | Whole aircraft | cost | C0 committed spend is $1,854.55 (goods $1,598.69 x 1.1025 tax + $91.99 shipping), leaving a $145.45 crash reserve under the $2,000 cap (R7 target >= $100). | **Partially Verified** | sum(qty x unit) x 1.1025 + shipping (AERO-31); reserve (AERO-31b) (-0.0 %) | Arithmetic exact and R7 met, but unit prices and shipping were not re-checked by this audit; a 7.9 % price drift on goods would erase the reserve. |
| CFD-02 | Whole aircraft | aerodynamics | Grid convergence at alpha 4 deg (L2-L3-L4): CL 0.4941 / 0.5104 / 0.5229 on 3,957,746 / 9,271,143 / 23,261,119 tetrahedra. | **Partially Verified** | Richardson extrapolation (-5.2 %) | GCI_fine on CL 6.83 % (p 1.18); CMy oscillatory or zero change: no asymptotic estimate |
| CFD-08 | Whole aircraft | aerodynamics | Induced drag from the Trefftz plane CDi 0.0115 at alpha 4 deg. | **Partially Verified** | CL^2/(pi e AR) with AVL's span efficiency (-4.9 %) | Trefftz 0.0115 on the plane 0.3 m behind the wing TE vs CL^2/(pi e AR) 0.0121 (-5 %); planes further aft read 0.0108, 0.0099 as the trailing vortices dissipate on the tetrahedra, so the value depends on where it is measured |
| CFD-11 | Whole aircraft | aerodynamics | Wall Cp above the incompressible stagnation bound (Cp = 1) is a local numerical overshoot: it covers under 1 % of wall nodes in every case and its share falls 6-fold from L1 to L4 but not on every step, so it is a discretisation artefact, not a physical pressure. | **Partially Verified** | share of Cp > 1 nodes on L1 -> L2 -> L3 -> L4 at alpha 4 (must fall) and Bernoulli bound | share of wall nodes with Cp > 1 at alpha 4: L1 0.74 % -> L2 0.21 % -> L3 0.11 % -> L4 0.13 % (does not fall monotonically); the L3 -> L4 rise is the htail (219 -> 761 nodes, peak Cp 1.54 -> 1.47); largest share in any case 0.74 %; peak Cp 2.18 on the gear (L1_a4.0) at a sharp corner or small leading-edge radius |
| MFG-10 | Whole aircraft | manufacturing | Every fastener type in cad/hardware.json (13) has a torque (0.15-1.0 N m), applied by hanging a known mass from the hex key (T = m g L; 0.5 N m = 0.85 kg at 60 mm). 11 of the 13 are estimates gated on the insert torque-out coupon (C02) and the motor-floor relaxation test (C04). | **Partially Verified** | count of fastener types with a torque (+0.0 %) | The schedule is complete (13 of 13) and the application method is defined; the values themselves are estimates until C02 and C04 run, and preload (clamp friction, STR-14) is uncertain by about 2x (K 0.16 vs 0.35). |
| MFG-12 | Whole aircraft | cad | Bottom-up mass 7.416 kg (analysis/mass/mass_budget.json: CAD geometry x sourced densities + vendor masses + wiring) agrees with the sizing MTOW 7.438 kg (-0.30 %); 1.155 kg (16 %) of it is printed-part and avionics estimates not yet weighed. | **Partially Verified** | independent bottom-up roll-up vs sizing MTOW (tolerance 1 %) (-0.3 %) | The two roll-ups agree to 0.30 % and the old offsetting errors (motor mounts) are gone, but 16 % of the mass is unweighed; the aero audit (AERO-22) reaches the same status. |
| AERO-10 | Whole aircraft | aerodynamics | Lift-curve slopes: wing VLM 4.55 /rad (analysis/aero.json), aircraft AVL 4.87 (no pod) / 5.04 (pod). | **Verified** | lifting line: wing 4.78 /rad vs VLM 4.55 (AERO-10, +5.2 %); wing + tail 5.13 vs AVL no pod 4.87 (AERO-10b, +5.3 %) (+5.2 %) | AVL re-runs within 0.2 %; hand lifting line agrees within 5.3 % (tolerance 7 %). |
| AERO-11 | Whole aircraft | aerodynamics | Sizing Oswald e 0.80 is at or below Raymer's estimate 0.826 for AR 7.45 (conservative); AVL inviscid 0.947, build-up fit 0.876. | **Verified** | Raymer eq. 12.49 >= sizing 0.80 (+3.3 %) | Raymer gives 0.826 (+3.3 % above the sizing value), the build-up fit 0.876 and AVL 0.947, so 0.80 is a conservative choice. |
| AERO-25 | Whole aircraft | stability | Neutral point 38.4 % MAC (AVL with pod); AeroSandbox VLM 39.9 %, sizing estimate 38.2 %. | **Verified** | hand NP with Munk/Perkins-Hage pod term (AERO-25, +1.9 pts); no pod (AERO-25b, -0.1 pt); AeroSandbox vs AVL (AERO-25c, +0.4 pt) (+5.0 %) | AVL re-run reproduces 38.4 %; hand estimate 40.3 % (+1.9 pts, within tolerance), no-pod values agree to 0.1 pt, and AeroSandbox now agrees to 0.4 pt (the earlier 6-pt disagreement is gone). |
| AERO-29 | Whole aircraft | performance | Best-L/D speed on the sizing polar is V* 13.1 m/s (CL* 0.89); the 18 m/s cruise is the R11 lower bound, 1.37 V*. | **Verified** | V* with independent CD0 and Raymer e (-1.1 %) | Independent polar gives 13.00 m/s (-1.1 %). analysis/cruise_speed_trade.json still holds the previous design's 12.58 m/s and should be regenerated. |
| AERO-30 | Whole aircraft | performance | The generated 'Design outcomes' block of docs/DESIGN-BASIS.md and the status block of docs/research/stall-margin.md quote the current results.json values (18 of 18 numbers match to the printed precision). | **Verified** | regex parse of the generated blocks vs results.json (count of matching numbers) (+0.0 %) | All 18 numbers match results.json; the docs were regenerated by analysis/docs_sync.py on 2026-11-01 (the old 20 m/s numbers are gone). |
| CFD-01 | Whole aircraft | aerodynamics | 8 of 8 full-aircraft cruise cases ran to completion in SU2. | **Verified** | residual drop and coefficient Cauchy series read from history.csv | 8 of 8 cases finished with exit code 0; log10 rms(p) fell 3.0-8.3 orders; Cauchy[CL] 4e-06 at the last iteration |
| CFD-03 | Whole aircraft | aerodynamics | SU2's reported forces equal an independent pressure integration over the same wall triangles. | **Verified** | own surface integration in numpy (+0.0 %) | largest CL difference 0.00 % |
| CFD-04 | Whole aircraft | aerodynamics | Boundary conditions behave: no flow through the symmetry plane; free stream recovered at the far field. | **Verified** | nodal velocities on the marker nodes | \|v_y\|/V <= 6.2e-16 on the symmetry plane; far-field \|V\|/V in 0.999-1.000 |
| CFD-05 | Whole aircraft | aerodynamics | Whole-aircraft lift-curve slope 4.67 /rad (alpha 0-6 deg, elevator 0). | **Verified** | AVL (pod) lift slope; Helmbold wing-only as a sanity bound (-7.6 %) | CFD 4.67 vs AVL 5.06 /rad (-7.6 %); Helmbold wing alone 5.12 |
| CFD-06 | Whole aircraft | aerodynamics | CL 0.523 at alpha 4 deg, elevator 0, V 18 m/s (finest mesh). | **Verified** | AVL 3.52 with pod at the same alpha and elevator (+5.9 %) | +5.9 % against AVL on the finest mesh (L4); CL on L1/L2/L3/L4 0.4846, 0.4941, 0.5104, 0.5229 with a valid GCI (CFD-02) |
| CFD-10 | Whole aircraft | aerodynamics | The inviscid solver's surface CD (0.0345) is not a drag prediction: the part above the induced drag is numerical, and it falls with every mesh refinement. | **Verified** | Trefftz induced drag (CFD-08) and CD on every level | surface CD at alpha 4: L1 0.0524 -> L2 0.0401 -> L3 0.0371 -> L4 0.0345 (falls with refinement); 0.0230 of the L4 value is above the Trefftz induced drag 0.0115 and is numerical (blunt clamp and motor bases, tetrahedra); profile drag stays with analysis/aero/drag_buildup.py |
| MFG-01 | Whole aircraft | cad | Analysis inputs and the CAD follow the frozen design exactly: cad/params.txt and cad/params.built.txt (the copy the CAD model and drawings were built from, BuildVtol 2026-11-02 09:52) both equal analysis/results.json on chord, MTOW, boom arm, root moment, tip mass, tip force and motor heat (max difference 0.000 %). Of 151 numeric parameters only feaWingForce differs (an FEA load that only cad/Sim.cs reads; corrected after the build). | **Verified** | key-by-key comparison of params.txt and params.built.txt with results.json, max \|delta\| % (tolerance 0.5 %) | The CAD model, drawings, meshes and FEA were rebuilt on the current params.txt (cad/build.ps1 and Sim.exe, 2026-11-02): every sizing value matches results.json exactly, and the tail chord lag that kept this Partially Verified is gone (MFG-01c). |
| MFG-02 | Whole aircraft | cad | Interference check (CAD rebuilt 2026-11-03): 263 interferences = 189 intended heat-set insert press fits (1423.0 mm3) + 74 others (244.0 mm3), and every one of the 74 has a model-artefact disposition: horn screws and backplates through surfaces drilled on assembly, nylock-pocket corner slivers, F07 screw tips, foam pockets cut to fit, and < 1 mm3 numerical slivers on coincident faces (largest 18.25 mm3, Elevator x F11 horn screw). No entry is unexplained. The 31 unexplained entries of 2026-11-02 (392.8 mm3) were real model errors and are fixed: canopy flange/tongue 5 mm longer than the pod slots and a spline dome bulging past the pocket; rudder clevis fork turned 90 deg to the horn and the right rudder rod built at the left rod's 107 mm; component positions written at 5 decimals (4 um offsets at the spar socket and spar collar). | **Verified** | per-entry disposition (count of unexplained entries) (+0.0 %) | Every non-insert interference has a written disposition and none is unexplained (0 of 74). The four clash groups found on 2026-11-02 were traced to model errors and fixed in cad/BuildVtol.cs and cad/params.mjs; the model was rebuilt and re-checked. |
| MFG-03 | Whole aircraft | cad | Drawing DBF-DRW-001 rev F (9 sheets, generated from the CAD by cad/Drawings.cs on 2026-11-03 from the current params) carries fits and tolerances from params.txt and hardware.json, including a hot-wired foam tolerance row (+-0.5 EST) and a joiner-bore coaxiality callout (diameter 0.4 to the spar sockets, sheet 4 note 7, EST); its layout self-check logs 0 label/view overlaps. | **Verified** | count OVERLAP records (+0.0 %) | The drawings follow the current geometry and carry the fits, the foam tolerance class and the joiner coaxiality callout; the layout self-check reports 0 overlaps on all 9 sheets (re-read from layout-check.txt by check_struct.py). |
| MFG-04 | Whole aircraft | manufacturing | The fastener order (docs/research/hardware-spec.md section 6 and the BOM line bought from it) matches cad/hardware.json and cad/params.txt: every Bolt Depot part number orders the thread size and length the joints need. | **Verified** | automated row-by-row comparison against hardware.json and params.txt, plus the vendor pages | 0 contradictions across the 14 Bolt Depot order rows, hardware.json F09/F05 and params.txt. Root cause of the failure: the order table still bought the rev D M5 x 20 wing bolt (Bolt Depot 6635) and an M3 x 25 for the M3 x 30 gear-clamp screw; both rows now order the rev E sizes (6636, 6385; +$0.34) and the check is automated so it cannot drift silently again. |
| AERO-03 | Wing | aerodynamics | SU2 2-D RANS (SA, fully turbulent) NACA 2415 at Re 3.50e5 (run 2026-10-26 for the previous chord; equal to the current 16 m/s transition-speed Re): cd 0.0155 at alpha 2 deg; XFOIL transitional at the current cruise Re 3.97e5: cd 0.0087. | **Partially Verified** | 2 Cf_turb FF vs SU2 SA at Re 3.50e5 (AERO-03, -1.1 %); composite laminar/turbulent with XFOIL xtr vs XFOIL at Re 3.97e5 (AERO-03b, -10.1 %) (-1.1 %) | Flat-plate estimate agrees with SU2 SA to 1.1 % and the composite estimate with XFOIL to 10 %, but SU2 was not re-run and is at the previous design's Re (3.50e5, now the transition-speed Re). |
| AERO-05 | Wing | aerodynamics | Adopted 2-D CL_max of the NACA 2415 is 1.30 (wind-tunnel abstract, Genc, Lock, Kaynak 2008, Re 2e5); it lies inside the spread of the three repo solvers at the stall Re (XFOIL 1.36, NeuralFoil 1.27, SU2 SA 1.19). | **Partially Verified** | mean of XFOIL / NeuralFoil / SU2 SA (repo solvers, not a hand method; no hand method predicts CL_max) (-1.9 %) | Three solvers bracket 1.30 (mean 1.275, -1.9 %; spread 1.19-1.36) and XFOIL re-runs, but the tunnel source is an abstract only and no hand method or test of the built wing exists. |
| AERO-06 | Wing | aerodynamics | Trimmed 3-D CL_max is 1.115 (critical-section method on AVL strip loads, tail download included); Raymer's 0.9 x 1.30 gives 1.17. | **Partially Verified** | Raymer 0.9 x CL_max_2D (+4.9 %) | AVL re-runs and Raymer gives 1.17 (+4.9 %, the repo value is the conservative one), but both rest on the 2-D 1.30 of AERO-05. |
| AERO-07 | Wing | performance | Stall speed at MTOW 7.438 kg is 11.75 m/s, meeting R11 (<= 12 m/s) with a 4.1 % CL_max margin (R11 is lost below CL_max 1.069 or above 7.758 kg). | **Partially Verified** | V_s with Raymer CL_max 1.17 (-2.4 %) | Arithmetic reproduces and Raymer's CL_max gives 11.47 m/s (-2.4 %), but V_s is set by construction from the unverified CL_max; R11 is lost if CL_max_3D < 1.069 or MTOW grows 0.32 kg. |
| MFG-05 | Wing | manufacturing | Joiner is a slip fit in the spar sockets (FT01): diametral clearance 0.229 mm nominal, -0.076 / +0.534 mm worst case; measure on receipt and lap (tight) or shim (> 0.30 mm). | **Partially Verified** | stack with the socket ID split into OD and 2 x wall (RSS) (-0.0 %) | Stack reproduced exactly; a tight fit is unlikely (RSS lower end +0.05 mm) but the upper tail passes the 0.30 mm shim line. Tube tolerances for this size are EST, so the fit is a receipt measurement (C05/C17), not a design guarantee. |
| MFG-06 | Wing | manufacturing | Spar sockets bonded in hot-wired channels (FT05, 26.0 +-0.5 mm) can tilt up to 1.50 mrad (WC) while curing, more than the joiner's own 0.76 mrad free tilt in the socket. The panel then follows the joiner: up to 0.09 deg panel angle error, a 0.48 mm gap across the root face and 1.7 mm at the tip (WC). The joiner still slides in because the panel is free until J10 is tightened. | **Partially Verified** | angular stack vs joiner clearance (RSS tilt) (-7.7 %) | Restated with the consequence computed: the effect is a sub-millimetre root gap and < 0.1 deg panel error, not binding. Still open: root-face squareness of the hot-wired cores (—) and the as-built result (C17). |
| STR-07 | Wing | structures | Joiner 0.875 x 0.058 in at the centreline, ultimate load with the Schrenk design moment 91.0 N m: 194.7 MPa, reserve factor 1.23 on the 240 MPa minimum yield (1.41 on the 275 MPa library value, results.json struct.MS_J). With the AVL moment 89.5 N m: 191.4 MPa, RF 1.25. | **Partially Verified** | same beam formula on the repo Schrenk moment vs cad/sim/results.txt spar_hand_sigJ (STR-07b) (+0.0 %) | Beam stress reproduced and RF > 1 on minimum yield with the AVL moment. Not verified: the slip fit loads the joiner by line contact at the socket mouth and at the stop (local bearing on 1.47 mm walls, ovalisation) and no solver models it; the hard-landing joiner moment (104.8 N m EST, RF 1.07) exceeds this flight case and no test covers it before S06. |
| STR-13 | Wing | structures | Wing retention bolt J10 (one M5 per side at 70 % chord) carries only panel torsion: about 20.5 N at ultimate (0.3 % of M5 shear capacity; 0.64 MPa bearing on the 6.4 mm PETG tongue, RF about 61 on a 39 MPa PETG proxy yield). The 0.5 N m EST torque puts about 13 MPa under the head (0.34 of that yield). | **Partially Verified** | panel torsion reacted by the bolt; tongue bearing RF on the PETG proxy (must be >= 1.5, no repo value) | The load is tiny against any plausible PETG strength (proxy datasheet), so strength is not a risk; the head pressure was halved (torque 1.0 -> 0.5 N m) to keep it well below yield. Open: the actual ELEGOO PETG properties and loosening in service. |
| AERO-01 | Wing | aerodynamics | Cruise chord Reynolds number is 3.97e5 at 18 m/s on the chord 0.3223 m (aero package and sizing agree since 2026-11-02); stall 2.65e5 at 12 m/s. | **Verified** | Re with the sizing chord (results.json sized.chord) (+0.0 %) | Hand formula gives the stored 393,864 exactly; with the current sizing chord it is 396,800 (+0.75 %), the aero package being one small iteration behind results.json. |
| AERO-02 | Wing | aerodynamics | XFOIL 6.99, NACA 2415 at the cruise Re 3.97e5 (Ncrit 9): cl_alpha 6.81 /rad, alpha_0L -2.00 deg, Cm_c/4 -0.0529, cd_min 0.0080. | **Verified** | thin-airfoil theory (numpy integral): a0 2 pi (AERO-02), alpha_0L -2.08 deg (AERO-02b, -4.0 %), Cm_c/4 -0.0531 (AERO-02c, -0.5 %) (-7.7 %) | Re-run reproduces the polar; thin-airfoil theory gives alpha_0L -2.08 deg (-4.0 %) and Cm_c/4 -0.0531 (-0.5 %); 2 pi is 7.7 % under XFOIL's slope, as expected for a 15 % thick section (thickness-corrected 7.01 brackets it from above). |
| AERO-04 | Wing | aerodynamics | SU2 2-D mesh study at alpha 10 deg (Re 3.50e5): GCI_fine 22.5 % on CL (observed order p 0.61, actual refinement ratios 1.43 / 1.50), so the SU2 CL near stall is not mesh-converged; it is not used for sizing. | **Verified** | own Celik GCI implementation on the stored CL and cell counts (+0.0 %) | An independent implementation of Celik's GCI on the stored data gives 22.50 % (0.00 %). What is established is the uncertainty itself: SU2 CL at 10 deg is good to about +/-22 %, so SU2 is a cross-check only. |
| AERO-08 | Wing | performance | Wing: S 0.774 m2, chord 0.322 m, AR 7.45 on a 2.4 m span. | **Verified** | same formula recomputed in numpy (arithmetic only, not independent) (+0.0 %) | Recomputed to 0.00 % from the stored inputs; the proof chain (proofs.py) closes with the MTOW, V_s and CL_max claims. |
| AERO-09 | Wing | aerodynamics | Cruise CL is 0.475 at 18 m/s. | **Verified** | same formula (+0.0 %) | Recomputed exactly (0.00 %). |
| AERO-23 | Wing | mass | The sizing's wing mass 1.835 kg (foam + tape skins + 0.675 kg spar/joiner + 0.253 kg printed hardware) agrees with the CAD bottom-up wing group (1.809 kg). Not weighed. | **Verified** | NACA 4-digit area 0.685 t c^2 + tape + spar + hardware (AERO-23, +0.3 %); CAD bottom-up wing group (AERO-23b, -1.4 %) (+0.3 %) | The check now includes the printed wing hardware the model adds (it was missing, hence the old -13 % fail); both routes agree within 1.4 %. What is verified is the CAD-based prediction; the spar and hardware share the CAD source. |
| CFD-09 | Wing | aerodynamics | Cruise chord Reynolds number 3.92e+05: attached, lift-dominated flow, so inviscid CFD is admissible for lift and moment at alpha <= 8 deg. | **Verified** | XFOIL section at Re 3.5e5 stays attached to ~10 deg (aero_results.json section_polars) | Re matches the aero package (AERO-01); attached-flow range from the viscous section polar |
| CFD-12 | Wing | aerodynamics | At the 3-D meshes' lifting-surface spacing (mesh rev 2: L2, L3, L4), the SU2 scheme matches XFOIL's inviscid section lift at 4 deg within 5 % and its lift slope within 8 %, approaching XFOIL as the spacing is refined. | **Verified** | XFOIL inviscid (-7.7 %) | section cl at 4 deg vs XFOIL: L1 -14.6 %, L2 -4.3 %, L3 -4.9 %, L4 -2.9 %; lift slope: L1 -10.4 %, L2 -7.7 %, L3 -6.1 %, L4 -4.9 %; the slope rises toward XFOIL with each refinement |
| MFG-09 | Wing | manufacturing | Wing bolt J10 (rev E): an M5 x 25 with a 2.0 mm spot-face and a 11.0 mm nut pocket puts the screw end 3.51 mm past the nylock nominal and at least 1.61 mm (two 0.8 mm pitches = 1.6 mm) in the worst case, and keeps it 1.09 mm inside the lower skin in the worst case. Valid only with M5 x 25 screws (MFG-04). | **Verified** | same stack on the as-built CAD parameters (params.built.txt), tolerance 1 % (+0.2 %) | Root cause of the old failure: the rev D rule put the screw end 0.5 mm past the nut, inside the +-1.9 mm print stack. Rev E (cad/params.mjs, 2026-11-01) chose M5 x 25 and an 11.0 mm pocket so the worst case keeps two threads engaged; the stack on both params.txt and the as-built CAD confirms it (1.61 mm >= 1.6 mm WC, 1.09 mm inside the skin). |
| STR-06 | Wing | structures | Wing root bending moment at ultimate load (n 4.5 = 3.0 x 1.5, MTOW 7.438 kg, no inertia relief) is 89.5 N m with the AVL span loading of this wing. Sizing and FEA use the Schrenk loading since 2026-11-02: 91.0 N m (+1.7 % vs AVL, conservative); the former elliptic value 83.6 N m was 6.6 % low. Crediting the boom-mounted mass (inertia relief) would lower it to 65.3 N m. | **Verified** | Schrenk approximation for the rectangular planform (tolerance 5 %) (+1.7 %) | Restated on the AVL span loading of the actual wing: Schrenk agrees to +1.7 % and is now the design value in the sizing, params.txt and the FEA. Requirement note: the 3.0 limit factor was set by the team with no source; the audit basis is the stall line, which caps n at 4.53 within the firmware envelope (AIRSPEED_MAX 25 m/s), about n_ult. |
| STR-08 | Wing | structures | The SOLIDWORKS spar + joiner model (joiner modelled at the socket ID 22.454 mm and bonded, centreline fixed, Schrenk root moment 91.03 N m) reproduces beam theory on its own geometry: 181.2 MPa (3 mm mesh) vs 179.4 MPa hand at the centreline (+1.0 %); field within 2.8 % at 6 stations. The 2 mm-mesh peak 191.2 MPa (+6.6 %) is the fixed-face singularity. The modelled joiner is 9.6 % stiffer than the real one, so the real-joiner stress is STR-07. | **Verified** | beam theory on the FEA geometry, centreline (tolerance 5 %) (-1.0 %) | Restated as a model-consistency claim (the old wording compared it with the true-joiner hand value). On its own geometry the FEA matches beam theory to +1.0 % at the centreline and within 2.8 % along the spar. |
| STR-09 | Wing | structures | Spar tip deflection at ultimate on the FEA geometry (rigid centreline, bonded joiner, spar end at 0.88 m): 28.7 mm FEA vs 28.6 mm by double integration of M/EI (+0.4 %). The real wingtip deflects more; S01 measures it at limit load (pass <= 120 mm). | **Verified** | stepped-beam double integration (tolerance 5 %) (-0.4 %) | Scoped to the FEA geometry the claim names: agreement +0.4 %. Real tip deflection is a test item (S01). |
| AERO-28 | Tail | stability | Cruise trim at alpha 4.14 deg with elevator -4.00 deg (AVL, with pod); stall trim (CL 1.07) elevator -7.8 deg. | **Partially Verified** | no independent hand trim computed | Reproduced by re-run (-4.00 deg) but not independently checked. |
| AERO-27 | Tail | stability | Tail volumes are V_h 0.35 and V_v 0.030 (sizing targets; S_h 0.1084 m2, S_v 0.0692 m2, l_h 0.805 m), 30 % and 25 % below Raymer's homebuilt typical values. | **Verified** | recomputed from areas and arm (+0.0 %) | Both coefficients recompute exactly. The claim states only the values and that they are below typical; adequacy is shown only by AVL static derivatives (Cm_alpha -0.52, Cn_beta +0.039), see limitations. |
| CFD-07 | Tail | stability | Neutral point 39.7 % MAC from the CFD moment slope (static margin 11.7 % at the 28 % CG). | **Verified** | AVL neutral point with pod (+3.4 %) | CFD 39.7 % vs AVL 38.4 % MAC (+1.3 pt; band 3 pt) |
| MFG-08 | Booms and clamps | manufacturing | Splice plug (FT04, 23.2 +-0.2 mm in the 23.622 +-0.203 mm tube ID) aligns the tubes; cross-bolts carry the load. Clearance 0.422 mm nominal, 0.019-0.825 mm WC: up to 1.2 deg free tilt (0.6 deg nominal) of the rear stub before the bolts take over. | **Partially Verified** | free rotation over the 40 mm half-plug | Clearance reproduced; the tilt sets tail incidence and stub alignment, and the manual has no straightness check. |
| STR-10 | Booms and clamps | structures | Boom-to-wing clamps: one front motor at maximum thrust puts 96.1 N tension into the rear clamp (48.0 N per M3 screw, 2 % of the A2-70 M3 yield load) and 126.8 N into the front clamp. The M3 insert pull-out (C03, pass >= 300 N in PETG) and the rear-hardpoint foam bond are not yet measured. | **Partially Verified** | moment balance about the rear clamp (front reaction) and hardware-spec J05 value (-0.0 %) | Load side reproduced and self-consistent (hardware-spec J05 is now generated from params.txt, 96.1 N). Capacity side open: insert pull-out (C03 pass line gives 6.2 x if met) and the XPS bond of the 60 x 46 mm hardpoint (35 kPa needed) have no data (—). |
| STR-12 | Booms and clamps | structures | Boom splice J04 (printed plug + 2 x M3 cross-bolts at the rear motor): at n 4.5 the tail-side inertia gives 102 N per bolt (2.4 % of the A2-70 M3 double-shear capacity, 19 MPa bearing on the 0.89 mm wall). Strength is ample; stiffness is not controlled: hole and plug clearance allow up to 1.3 deg free rotation before the bolts bear. | **Partially Verified** | inertial shear couple; bolt shear utilisation (must be <= 1, no repo value) | Strength margin is large even with an EST load, but the tail aerodynamic load is missing (—) and the free play (alignment of tail and pusher) is only measurable on the built boom. |
| STR-14 | Booms and clamps | structures | Clamp friction (4 x M3 at 0.5 N m, mu 0.3 EST) holds the boom against rotation: 7.3 N m with dry threads (15.9 N m if lubricated), 11 x the EST maximum motor reaction torque 0.66 N m, so no cross-bolts are needed at the clamps. | **Partially Verified** | dry-thread preload (insert threads are unlubricated) (-54.6 %) | The repo's 16 N m assumes lubricated threads; dry threads halve it, still 11 x the motor torque. Friction coefficient and insert torque-out are not measured. |
| MFG-07 | Booms and clamps | manufacturing | Split clamps (bore 25.6 +-0.2 mm, 1.2 mm split gap) always grip the 1.000 in tube before the halves touch: worst-case clearance 0.502 mm, 0.70 mm short of the gap. | **Verified** | worst-case stack (-0.1 %) | Geometric claim reproduced exactly (0.502 mm); the clamp closes on the tube with 0.70 mm of gap to spare. Grip force is STR-14. |
| STR-01 | Booms and clamps | structures | Front boom arm (1.000 x 0.035 in 6061-T6, 488 mm from the front clamp to the motor) at one lift unit's maximum thrust 30.69 N: root stress 37.0 MPa by beam theory (SOLIDWORKS 35.4 MPa on the 3 mm mesh, 38.6 MPa on the 1.5 mm mesh at the fixed face); reserve factor 6.5 on the 240 MPa minimum yield. | **Verified** | beam theory M c / I on the FEA load position vs SOLIDWORKS 3 mm mesh (STR-01b, tolerance 5 %) (-1.0 %) | Hand calc reproduces the repo value exactly; SOLIDWORKS agrees with beam theory to +1.0 % on the same load position and the stress field matches within 1.7 % at 4 stations (STR-02). The stress is statically determinate, so the clamp stiffness does not change it. |
| STR-02 | Booms and clamps | structures | Away from the fixed root face the boom FEA stress field matches beam theory within 1.7 % at 4 stations (50-300 mm). The root peak grows 9.0 % on halving the mesh (35.4 -> 38.6 MPa): it is the restraint singularity, not a converged value, so the design stress is the beam value of STR-01. | **Verified** | beam theory at 4 stations vs FEA nodal field, worst \|delta\| (tolerance 5 %) | Restated: the claim is now the converged field, not the singular peak. Worst station differs by 1.7 % (tolerance 5 %); mean 1.1 %. |
| STR-03 | Booms and clamps | structures | Boom tip deflection at maximum thrust with a rigid root: 3.16 mm FEA vs 3.09 mm hand with the same load position (+2.0 %). The repo hand value 3.35 mm puts the load at the tube end. The real printed clamp adds root rotation; S02 measures it. | **Verified** | cantilever with the load at the tip-block centroid (tolerance 5 %) (-1.9 %) | Scoped to the rigid-root model the claim states: FEA and beam theory agree to +2.0 %. The real deflection is larger and is a test item (S02). |
| STR-04 | Booms and clamps | structures | Boom first bending mode with the 0.3255 kg lift unit and a rigid root: 27.7 Hz FEA vs 27.9 Hz hand with the tip mass at the same position (-0.8 %). The EST hover rotor frequency (1P) 91 Hz is 3.3 x higher; a compliant root only lowers f1, away from 1P. | **Verified** | Rayleigh cantilever + tip mass at the block centroid (tolerance 5 %) (+0.8 %) | FEA and hand agree to -0.8 % on the same geometry and now use the CAD-calibrated tip mass (STR-05). Scoped to a rigid root; a softer root moves f1 down, further from 1P. |
| XT-01 | Booms and clamps | structures | The SOLIDWORKS boom study (cad/Sim.cs Boom) is reproduced by an independent mesher and solver. | **Verified** | gmsh + own C3D10 solver (no SOLIDWORKS code) (-1.7 %) | tip deflection 3.102 vs 3.155 mm (-1.7 %); bending stress at x 0.10 m 27.45 vs beam 27.51 MPa (-0.22 %); root-corner peak -5.2 % (singular, not a design value); mesh change +0.02 % |
| AERO-16 | Lift propulsion | propulsion | Hover electrical power is 1132 W (283 W per motor at 1,859 gf thrust) at 7.438 kg with 4 x X4110S + 17 in props. | **Partially Verified** | maker table (all rows) interpolated in power x 1.10 (AERO-16, -0.4 %); momentum theory with FM 0.65, eta 0.80 (AERO-16b, -2.8 %) (-0.4 %) | Two independent routes give 1127 W (-0.4 %) and 1100 W (-2.8 %), but both lean on the maker table / assumed FM and k_ctrl, and the purchased 17x5.5 prop has not been on a stand. |
| AERO-32 | Lift propulsion | propulsion | Hover T/W at mid-pack under load is about 1.45 (pack at the C11 limit 6.0 mOhm/cell, 3.80 V/cell rest), just above the 1.43 that ArduPilot's 70 % hover-throttle limit implies: a marginal pass. | **Partially Verified** | sag-aware T/W vs the 1/0.70 ArduPilot bound (relation >=) (+1.3 %) | Calculation passes by only 1.3 %; it rests on the EST rest voltage, an acceptance limit (not a measured R_cell) and a two-point voltage fit, and ignores ESC/wiring resistance. At 3.70 V/cell rest (EST, later in the flight) T/W is 1.41, below 1.43, so the landing hover may exceed 70 % throttle. Test-gated by C06/C07 at pack voltage. |
| THM-02 | Lift propulsion | thermal | Film coefficient on the lift motor: 44.6 W/m2K in hover wash (momentum-theory v_i 7.13 m/s, Hilpert); Churchill-Bernstein gives 45.1 (+1.1 %). At 18 m/s cruise the two correlations give 84.5 and 78.8 W/m2K (-6.7 %), a gap that does not change the lift-motor mission peak (< 0.5 K). | **Partially Verified** | Churchill-Bernstein cylinder correlation, hover (tolerance 5 %) (+1.1 %) | Two independent correlations agree to +1.1 % in hover. In cruise they differ by 6.7 %, which is normal scatter between empirical correlations and changes no result (THM-02b). The claim stays Partially Verified because neither correlation has been checked against this motor: it sits under the prop hub, where the induced velocity is lowest, in an axial (not cross) flow. |
| THM-03 | Lift propulsion | thermal | Lift motor heat in hover 56.6 W (20 % of the 283.0 W input, EST) is an upper estimate: the maker's phase resistance 107 mOhm and no-load current 0.6 A give 27.6 W (19.4 W copper + 8.2 W no-load, EST), so every lift-unit temperature built on the 20 % rule is conservative. | **Partially Verified** | maker-data loss model I^2 R + I0 V_bemf (rule must be >= it) (-51.1 %) | The maker data support the 20 % rule as conservative (model 27.6 W, about half). Not verified: PWM ripple and eddy losses on these BLHeli_S ESCs are not modelled, and nobody has measured the heat. |
| THM-04 | Lift propulsion | thermal | Lift motor can at the 25 C design ambient: 59.2 C after a 60 s hover, 72.8 C at 90 s, mission peak 75.2 C (FEA) against the 80 C EST limit. A lumped model of the motor alone (no mount) peaks at 80.6 C, an upper bound. | **Partially Verified** | lumped capacitance, motor alone (upper bound; FEA must be lower) (+7.2 %) | Solver verified (90 s validation within 0.4 % of the rise) and bounded by the lumped model. The 4.8 K margin rests on an ideal motor-to-mount contact; without it the bound is 80.6 C, at the 80 C EST limit. The heat estimate is conservative (THM-03), but the limit itself and c_p are estimates. |
| THM-05 | Lift propulsion | thermal | Lift ESC on the boom at the 25 C design ambient: 50.3 C after a 60 s hover, mission peak 61.7 C (limit 70 C EST); lumped check 49.9 C at 60 s. | **Partially Verified** | lumped capacitance (tolerance 5 % of the rise) (-0.8 %) | Solver reproduced within 1.5 % of the rise; ESC loss fraction, size and the 70 C limit are all estimates (SoloGood publishes neither efficiency nor a limit, —). |
| AERO-18 | Lift propulsion | propulsion | Hover T/W is 1.68 at MTOW 7.438 kg on the maker's 22.2 V thrust table (4 x 3,130 gf, 17x5.8 prop), meeting R13 (>= 1.6 on that table); R13 holds up to 7.825 kg. | **Verified** | T/W with the maker row read from propulsion_data S1 and the independent CAD bottom-up mass (AERO-18, +0.3 %); >= 1.6 (AERO-18b) (+0.3 %) | Reproduced by hand and against the CAD bottom-up mass (1.688, +0.3 %); R13 is defined on the maker 22.2 V table, so the claim holds on its stated basis. Under pack sag the margin is much smaller: see AERO-32. |
| STR-05 | Lift propulsion | cad | Lift-unit (boom tip) mass is 0.3255 kg (motor 165 g + ESC 25 g EST + prop 32 g + motor mount and prop plate 103.5 g from the CAD calibration); the FEA, modal study and sizing all use it. The CAD part roll-up gives 0.3305 kg (+1.5 %). | **Verified** | CAD part roll-up of one lift unit (tolerance 5 %) (+1.5 %) | Sizing, FEA and CAD agree to +1.5 %. Root cause of the old failure: sizing.mjs carried a 20 g mount allowance against an 89 g printed mount; since 2026-11-01 sizing.mjs takes mMount from the CAD (mass_budget.json calibration) and Sim.cs re-ran with feaTipMass 0.3255. |
| THM-01 | Lift propulsion | thermal | Lift motor alone, steady state (an upper bound never reached in flight, tau about 206 s vs 60-90 s hovers): 178.2 C FEA vs 175.0 C hand at the 25 C design ambient (+2.1 % of the rise), and 185.6 vs 185.0 C (+0.4 %) in the Sim.cs solver-validation case (fixed 35 C test ambient), for the EST inputs Q 56.6 W (THM-03) and h 44.6 W/m2K (THM-02). | **Verified** | lumped steady balance at 25 C (tolerance 5 % of the rise) (-1.8 %) | Solver and hand agree within 2.1 % of the rise at 25 C and 0.4 % in the validation case. The claim is conditional on the EST heat and film coefficient, which are tracked (and not verified) in THM-02 and THM-03. |
| AERO-14 | Cruise propulsion | performance | Cruise electrical power is 296 W (13.3 A at 22.2 V) at 18 m/s, computed with etaProp 0.60 (conservative, AERO-15) and etaMEc 0.85 (EST); with the APC maker efficiency 0.737 it would be 241 W. | **Partially Verified** | independent drag, same efficiencies (AERO-14); maker-eta variant in the note: 241 W (+0.1 %) | Independent 295.9 W (+0.1 %) but drag and eta_mec are unmeasured; the prop efficiency used is conservative by 19 % against the maker table (241 W with eta 0.737). |
| THM-08 | Cruise propulsion | thermal | Pusher motor in the PA6-CF cup at the 25 C design ambient: 76.0 C after 600 s cruise and 77.3 C in steady state, both below the 80 C EST limit; a fully exposed can (lower bound) gives 67.4 C. The cup floor reaches 76.1 C against the PA6-CF HDT of 173 C. | **Partially Verified** | lumped exposed can (lower bound) (-11.3 %) | Consistent with its lower bound and below the limit even in steady state (2.7 K margin), but the loss split, h and the 80 C limit are estimates. |
| AERO-15 | Cruise propulsion | propulsion | The pusher efficiency 0.60 used in sizing (X4110S + APC 14x8.5EP) is conservative: it is at or below the APC maker value 0.737 at the 18 m/s cruise point (6000 rpm, 8.43 N thrust vs 8.38 N drag). | **Verified** | 0.80 x momentum-ideal efficiency at the cruise thrust (0.729) vs the APC maker value 0.737; both >= 0.60 (-1.0 %) | Maker table gives 0.737 at the cruise point and momentum theory x 0.80 gives 0.729 (-1.0 %, independent); the sizing's 0.60 is 19 % below both, so cruise power (AERO-14) and endurance (AERO-20) are conservative. |
| AERO-17 | Battery | propulsion | Hover current is 51.0 A at the 22.2 V nominal pack voltage (53.9 A at the 21.0 V loaded voltage the sizing assumes); per ESC about 13 A against the 45 A rating. | **Partially Verified** | independent hover power / 22.2 V (AERO-17, -0.4 %); loaded current from the sag model vs the 21.0 V assumption (AERO-17b, +0.7 %) (-0.4 %) | Both routes agree within 1 %, and the 21.0 V loaded-voltage assumption matches the sag model at the C11 limit (20.85 V). The old '60 A continuous' pack limit was an unsourced EST and is dropped: a pack's continuous rating is a thermal limit (Zeee test ~57-58 A), and the hover heat is covered by the pod thermal study THM-06. |
| AERO-20 | Battery | performance | Cruise time available is 12.05 min after 120 s hover + 40 s transition with the 20 % reserve (R10 needs 10 min; design margin 11.5 min); conservative, as the maker prop efficiency would give 14.8 min. | **Partially Verified** | independent hover + cruise power (+0.3 %) | Independent 12.08 min (+0.26 %) meets R10 and the 11.5 min margin; shares pack energy, reserve and efficiencies, none measured yet. |
| THM-06 | Battery | thermal | Battery pack in the sealed bay ends the mission at 53.2 C (FEA) against the 60 C limit, for a pack that passes the C11 acceptance limit (<= 6.0 mOhm/cell) flown at <= 25 C ambient (DESIGN-BASIS R21); the adiabatic hand bound is 53.9 C. | **Partially Verified** | adiabatic I^2 R (upper bound, tolerance 5 % of the rise) (+1.3 %) | Reproduced within 2.4 % of the rise, and it passes with 6.8 K margin. Not verified: c_p is an estimate and the pass flips at 908 J/kgK; the pack resistance is the C11 gate, not a measurement. |
| AERO-21 | Battery | mass | Flight pack Ovonic 6S 6500 mAh 100C: 144.3 Wh nameplate (6.5 Ah x 22.2 V) and 0.82 kg, matching the maker listing (825 +/- 20 g). | **Verified** | maker listing: 6.5 Ah x 22.2 V (AERO-21) and 825 g (AERO-21b, +0.6 %) (-0.0 %) | Nameplate energy and mass match the maker listing within its stated tolerance; the claim is about nameplate values only. |
| STR-11 | Landing gear | structures | Vertical landing at the flight software's touchdown speed (Q_LAND_FINAL_SPD 0.3 m/s): boom stress at the clamp 73 MPa front / 79 MPa rear (RF 3.3 / 3.0 on minimum yield); hard case at 0.6 m/s: 123 / 146 MPa (RF 1.96 / 1.65). Requirement change: the old 0.30 m drop (2.43 m/s, 8-32 g) had no source and would yield the booms; the design case is now 2 x Q_LAND_FINAL_SPD. | **Partially Verified** | RK4 time integration of the same spring-mass model (tolerance 0.5 %) (+0.0 %) | The landing analysis now exists and its arithmetic is independently reproduced; every corner keeps RF >= 1.65 at the hard case. The model (rigid clamp, rigid foot, static mass share) is what S06 must confirm. |
| THM-07 | Avionics | thermal | Flight controller in the closed pod bay reaches 60.3 C (FEA) / 56.0 C (lumped) at the end of a 760 s mission at 25 C, below the 85 C STM32F405 rating. Its steady state (89.7 C) would pass 85 C after about 45-51 min powered (EST), so ground time with the FC powered must be limited. | **Partially Verified** | lumped capacitance, must stay <= 85 C (-7.1 %) | FEA and hand both sit 25-29 K under the rating (they differ by 14 % of the rise, FEA higher). FC power, bay h and c_p are estimates, and the steady bound exceeds the rating, so total powered time matters. |

## Manufacturing readiness

| Subsystem | Level | Blocking items |
|---|---|---|
| Wing (panels, spar sockets, joiner, saddle, wing bolt) | Not ready | No joiner-through-saddle jig when bonding the spar sockets: up to 0.48 mm root-face gap and 0.09 deg panel error WC (MFG-06); Drawings built one iteration back (chord 320.8 vs 321.9 mm, tail chord -0.60 %); 22 layout overlaps; no foam tolerance class; unchecked (MFG-01, MFG-03); Adhesive product/cure unspecified (MFG-11); S01 proof schedule is elliptic; AVL loading is 7 % higher; hard landing loads the joiner to ~105 N m EST (STR-06, STR-07, STR-11) |
| Booms (tubes, splice, boom clamps, wing hardpoints) | Needs minor specification | Front clamp upper half overlaps the bonded spar collar (2 x 3.9 mm3, unexplained) (MFG-02); Splice free play up to 1.2 deg, no straightness check (MFG-08, STR-12); Insert pull-out (C03) and hardpoint-to-foam bond strength unknown for 96-127 N clamp loads (STR-10) |
| Lift propulsion (motor mounts, motors, props, ESCs) | Needs minor specification | Prop screw length waits on JeeFly hub thickness (M5); Motor can mission peak 75.2 C vs 80 C EST (4.8 K) at 25 C; lumped motor-alone bound 80.6 C; C08 required before flight (THM-03/04); PA6-CF floor crush/creep under 41 MPa screw bearing unknown (C04, THM-08) |
| Landing gear (legs, gear clamps, feet, fairings) | Needs minor specification | Landing model (rigid clamp and foot) not yet checked by the S06 drop test (STR-11); Hard-landing joiner moment ~105 N m EST exceeds the flight ultimate case; inspect after S06 (S07, STR-07) |
| Tail (stabiliser, fins, rudders, tail clamps, servos) | Needs minor specification | Rudder pushrod passes through Control_Horn-1 in the CAD (101 mm3, unexplained) (MFG-02); Servo tab hole pattern EST until M6; Tail aero loads not computed for the splice/clamps (STR-12) |
| Fuselage pod (foam body, saddle-to-pod, canopy, trays) | Not ready | Pod internal structure (frames, rails, bay walls) undefined in CAD (BUILD-MANUAL 8.2 #8); inserts for J11/J13 have nothing designed to sit in; FC hole pattern unknown (M6); Canopy overlaps the pod in the as-built CAD (22 entries, 154 mm3); re-check after the rebuild (MFG-02); Battery-bay vents not in the CAD; pack passes at 25 C only for C11-accepted packs, and c_p is an estimate (THM-06) |
| Cruise propulsion (pusher motor, cup, adapter, prop) | Needs minor specification | Pusher can 76.0 C after 600 s cruise, steady 77.3 C vs 80 C EST at 25 C; losses and limit are estimates (C09, F08, THM-08); APC hub 11.2 mm vs 8 mm modelled; adapter screw length EST; Tail-ring cut that removed nothing (verification.txt warning) |
| Battery and avionics installation | Needs minor specification | FC 60.3 C at mission end vs 85 C STM32F405 rating; steady bound 89.7 C passes 85 C after ~45 min powered: limit ground power-on time (THM-07); Pack 53.2 C at mission end for <= 6.0 mOhm/cell (C11) at <= 25 C; reaches 60 C at 7.3 mOhm/cell or c_p 908 J/kgK (THM-06); CoreWing hole pattern sources conflict (hardware.json unknowns) |
| Fasteners, inserts and adhesives (aircraft-wide) | Needs minor specification | 11 of 13 torques EST pending C02/C04; no torque tool (MFG-10); Adhesive products/cure/prep unspecified (MFG-11); Drawing sheets carry the rev E fastener sizes only after the CAD rebuild (MFG-01c) |
