davinciucberkeley-collab/DillonVTOL/docs/validation/proofs/AERO-10.md

# AERO-10: Lift-curve slopes: wing VLM 4.55 /rad (analysis/aero.json), aircraft AVL 4.87 (no pod) / 5.04 (pod).

**Status: Verified.** AVL re-runs within 0.2 %; hand lifting line agrees within 5.3 % (tolerance 7 %).

## Evidence

No closed-form arithmetic to re-run; the proof is the evidence and the independent check.

Equations used: `a = a0 / (1 + a0 (1+tau) / (pi AR))`; `CL_a = a_w + eta a_t (S_h/S)(1 - de/da)`; `de/da = 2 a_w / (pi AR)`

- `analysis/aero/out/avl/st_pod_trim.txt`: stability derivatives (CLa 5.034 at trim)
- `analysis/aero/aero_results.json`: lift_curve.CL_alpha_per_rad
- `analysis/aero.json`: wing_CLa_per_rad 4.54544 (AR 7.44571)

## Independent check

lifting line: wing 4.78 /rad vs VLM 4.55 (AERO-10, +5.2 %); wing + tail 5.13 vs AVL no pod 4.87 (AERO-10b, +5.3 %) (difference +5.2 %), `analysis/validation/check_aero.py#AERO-10,AERO-10b`

## External sources

- **SRC-22** [not_fetchable]: Anderson, Fundamentals of Aerodynamics (ch. 4 thin-airfoil a0 = 2 pi; Helmbold lift slope), checked 2026-11-01

---
Generated by `py tools/vtol.py prove AERO-10` from `analysis/validation/proofs.json` (2026-11-03 18:28) and `analysis/validation/claims_aero.json`. Every input is read from the file it names when `proofs.py` runs.
