davinciucberkeley-collab/DillonVTOL/docs/validation/proofs/AERO-15.md

# AERO-15: The pusher efficiency 0.60 used in sizing (X4110S + APC 14x8.5EP) is conservative: it is at or below the APC maker value 0.737 at the 18 m/s cruise point (6000 rpm, 8.43 N thrust vs 8.38 N drag).

**Status: Verified.** Maker table gives 0.737 at the cruise point and momentum theory x 0.80 gives 0.729 (-1.0 %, independent); the sizing's 0.60 is 19 % below both, so cruise power (AERO-14) and endurance (AERO-20) are conservative.

**✓ re-runs to 0.9117 -** against the claim's 0.6 - (difference +51.95 %).

## Calculation

1. dynamic pressure

$$q = \tfrac12 \rho V^2$$

$$=  \tfrac12 \times 1.225 \times 18^2 = 198.5\ \text{Pa}$$

2. disc area

$$A = \pi D_p^2/4$$

$$=  \pi 0.3556^2/4 = 0.09931\ \text{m²}$$

3. momentum-theory upper bound on propeller efficiency

$$\eta_{ideal} = \frac{2}{1 + \sqrt{1 + T/(qA)}}$$

$$=  \frac{2}{1 + \sqrt{1 + 8.376/(qA)}} = 0.9117$$

## Inputs

| Symbol | Value | Meaning | Comes from |
|---|---|---|---|
| $\rho$ | 1.225 kg/m³ | air density (ISA sea level) | ISA sea-level density; SRC-19 [not_fetchable] International Standard Atmosphere, sea level (via Anderson,  |
| $V$ | 18 m/s | cruise speed | analysis/results.json#concepts.C0.params.Vc |
| $T$ | 8.376 N | cruise thrust = drag (analysis/results.json sized.D_cruise) | analysis/results.json#concepts.C0.sized.D_cruise |
| $D_p$ | 0.3556 m | pusher propeller diameter (14 in) | cad/params.txt:33; SRC-14 [confirmed] APC Propellers 14x8.5EP (LP14085EP) |

*The claim's 0.60 is an assumed efficiency; it must not exceed the ideal (momentum-theory) value. The APC maker value at the cruise point (0.737, check_aero.py AERO-15b) is the tighter bound.*

## Independent check

0.80 x momentum-ideal efficiency at the cruise thrust (0.729) vs the APC maker value 0.737; both >= 0.60 (difference -1.0 %), `analysis/validation/check_aero.py#AERO-15c,AERO-15,AERO-15b`

## Links

Uses: —

Used by: [AERO-14](AERO-14.md)

## External sources

- **SRC-14** [confirmed]: [APC Propellers 14x8.5EP (LP14085EP)](https://www.apcprop.com/product/14x8-5ep/), checked 2026-11-01

---
Generated by `py tools/vtol.py prove AERO-15` from `analysis/validation/proofs.json` (2026-11-03 12:21) and `analysis/validation/claims_aero.json`. Every input is read from the file it names when `proofs.py` runs.
