davinciucberkeley-collab/DillonVTOL/docs/validation/proofs/MFG-02.md

# MFG-02: Interference check (CAD rebuilt 2026-11-03): 263 interferences = 189 intended heat-set insert press fits (1423.0 mm3) + 74 others (244.0 mm3), and every one of the 74 has a model-artefact disposition: horn screws and backplates through surfaces drilled on assembly, nylock-pocket corner slivers, F07 screw tips, foam pockets cut to fit, and < 1 mm3 numerical slivers on coincident faces (largest 18.25 mm3, Elevator x F11 horn screw). No entry is unexplained. The 31 unexplained entries of 2026-11-02 (392.8 mm3) were real model errors and are fixed: canopy flange/tongue 5 mm longer than the pod slots and a spline dome bulging past the pocket; rudder clevis fork turned 90 deg to the horn and the right rudder rod built at the left rod's 107 mm; component positions written at 5 decimals (4 um offsets at the spar socket and spar collar).

**Status: Verified.** Every non-insert interference has a written disposition and none is unexplained (0 of 74). The four clash groups found on 2026-11-02 were traced to model errors and fixed in cad/BuildVtol.cs and cad/params.mjs; the model was rebuilt and re-checked.

## Evidence

No closed-form arithmetic to re-run; the proof is the evidence and the independent check.

Equations used: `crescent volume of an offset coaxial cut ~ 2 R e L (R 12.7 mm, e 4 um, L 0.8 m -> ~81 mm3 per socket before the fix, calc)`; `rod length = |pin - arm| (cad/params.mjs; both rudders 88.4 mm after the left servo moved 2 x shaftX = 19 mm aft)`

- `cad/verification.txt`: Interference detection section

## Independent check

per-entry disposition (count of unexplained entries) (difference +0.0 %), `analysis/validation/check_struct.py#MFG-INTF`

---
Generated by `py tools/vtol.py prove MFG-02` from `analysis/validation/proofs.json` (2026-11-03 12:21) and `analysis/validation/claims_struct.json`. Every input is read from the file it names when `proofs.py` runs.
