davinciucberkeley-collab/DillonVTOL/docs/validation/proofs/MFG-03.md

# MFG-03: Drawing DBF-DRW-001 rev F (9 sheets, generated from the CAD by cad/Drawings.cs on 2026-11-03 from the current params) carries fits and tolerances from params.txt and hardware.json, including a hot-wired foam tolerance row (+-0.5 EST) and a joiner-bore coaxiality callout (diameter 0.4 to the spar sockets, sheet 4 note 7, EST); its layout self-check logs 0 label/view overlaps.

**Status: Verified.** The drawings follow the current geometry and carry the fits, the foam tolerance class and the joiner coaxiality callout; the layout self-check reports 0 overlaps on all 9 sheets (re-read from layout-check.txt by check_struct.py).

## Evidence

No closed-form arithmetic to re-run; the proof is the evidence and the independent check.

Equations used: `coaxiality allowance <= FT01 + FT06 nominal diametral clearance = (22.454 - 22.225) + (22.455 - 22.225) = 0.46 mm (calc, cad/hardware.json); 0.4 adopted (EST)`

- `cad/drawings/layout-check.txt`: 0 OVERLAP lines; every sheet "0 layout problems"
- `cad/Drawings.cs`: REV "F"; tolerance-table row HOT-WIRED FOAM; sheet 4 note 7 and callout COAXIAL Ø0.4; put("CheckedBy", "—")
- `cad/hardware.json`: general_tolerances.hot_wired_foam; fits FT01, FT05, FT06

## Independent check

count OVERLAP records (difference +0.0 %), `analysis/validation/check_struct.py#MFG-03`

---
Generated by `py tools/vtol.py prove MFG-03` from `analysis/validation/proofs.json` (2026-11-03 12:21) and `analysis/validation/claims_struct.json`. Every input is read from the file it names when `proofs.py` runs.
