davinciucberkeley-collab/DillonVTOL/docs/validation/proofs/MFG-05.md

# MFG-05: Joiner is a slip fit in the spar sockets (FT01): diametral clearance 0.229 mm nominal, -0.076 / +0.534 mm worst case; measure on receipt and lap (tight) or shim (> 0.30 mm).

**Status: Partially Verified.** Stack reproduced exactly; a tight fit is unlikely (RSS lower end +0.05 mm) but the upper tail passes the 0.30 mm shim line. Tube tolerances for this size are EST, so the fit is a receipt measurement (C05/C17), not a design guarantee.

**✓ re-runs to 0.229 mm** against the claim's 0.229 mm nominal diametral clearance (difference 0.00 %).

## Calculation

1. nominal diametral clearance

$$c = ID_{socket} - OD_{joiner}$$

$$=  22.45 - 22.23 = 0.229\ \text{mm}$$

## Inputs

| Symbol | Value | Meaning | Comes from |
|---|---|---|---|
| $ID_{socket}$ | 22.45 mm | spar socket ID | cad/params.txt:13 |
| $OD_{joiner}$ | 22.23 mm | joiner OD | cad/params.txt:16 |

## Independent check

stack with the socket ID split into OD and 2 x wall (RSS) (difference -0.0 %), `analysis/validation/check_struct.py#MFG-STACKS`

## External sources

- **SRC-11** [not_fetchable]: Zoro listing, 1.000 x 0.035 in 6061-T6 drawn tube (OD/wall tolerance), checked 2026-11-01
- **SRC-12** [confirmed]: [Alcobra Metals, 6061-T6 drawn round tube tolerances](https://alcobrametals.com/?p=91925), checked 2026-11-01

---
Generated by `py tools/vtol.py prove MFG-05` from `analysis/validation/proofs.json` (2026-11-03 12:21) and `analysis/validation/claims_struct.json`. Every input is read from the file it names when `proofs.py` runs.
