davinciucberkeley-collab/DillonVTOL/docs/validation/proofs/STR-01.md

# STR-01: Front boom arm (1.000 x 0.035 in 6061-T6, 488 mm from the front clamp to the motor) at one lift unit's maximum thrust 30.69 N: root stress 37.0 MPa by beam theory (SOLIDWORKS 35.4 MPa on the 3 mm mesh, 38.6 MPa on the 1.5 mm mesh at the fixed face); reserve factor 6.5 on the 240 MPa minimum yield.

**Status: Verified.** Hand calc reproduces the repo value exactly; SOLIDWORKS agrees with beam theory to +1.0 % on the same load position and the stress field matches within 1.7 % at 4 stations (STR-02). The stress is statically determinate, so the clamp stiffness does not change it.

**✓ re-runs to 36.98 MPa** against the claim's 36.96 MPa (difference +0.06 %).

## Calculation

1. second moment of area

$$I = \frac{\pi}{64}(D^4 - d^4)$$

$$=  \frac{\pi}{64}(0.0254^4 - 0.02362^4) = 5.15\times 10^{-9}\ \text{m⁴}$$

2. root bending stress, beam theory

$$\sigma = \frac{P L\,(D/2)}{I}$$

$$=  \frac{30.69 \times 0.4883\,(0.0254/2)}{5.15\times 10^{-9}} = 36.98\ \text{MPa}$$

## Inputs

| Symbol | Value | Meaning | Comes from |
|---|---|---|---|
| $P$ | 30.69 N | maximum thrust of one lift unit (maker 3.13 kgf, results.json struct.Tmax) | cad/params.txt:52 |
| $L$ | 0.4883 m | boom cantilever length | cad/params.txt:51 |
| $D$ | 0.0254 m | boom OD (1.000 in) | cad/params.txt:19 |
| $d$ | 0.02362 m | boom ID | cad/params.txt:20 |

*Beam theory at the clamp; the claim value is this beam stress (the FEA peak at the fixed face is a singularity, STR-02).*

## Independent check

beam theory M c / I on the FEA load position vs SOLIDWORKS 3 mm mesh (STR-01b, tolerance 5 %) (difference -1.0 %), `analysis/validation/check_struct.py#STR-01`

## External sources

- **SRC-01** [confirmed]: [SunnySky X4110S motors (maker/US store page), KV400 thrust table](https://sunnyskyusa.com/collections/multirotor-motors/products/sunnysky-x4110s-motors), checked 2026-11-01
- **SRC-10** [not_fetchable]: SOLIDWORKS material library "6061-T6 (SS)", checked 2026-11-01

---
Generated by `py tools/vtol.py prove STR-01` from `analysis/validation/proofs.json` (2026-11-03 12:21) and `analysis/validation/claims_struct.json`. Every input is read from the file it names when `proofs.py` runs.
