davinciucberkeley-collab/DillonVTOL/docs/validation/proofs/STR-03.md

# STR-03: Boom tip deflection at maximum thrust with a rigid root: 3.16 mm FEA vs 3.09 mm hand with the same load position (+2.0 %). The repo hand value 3.35 mm puts the load at the tube end. The real printed clamp adds root rotation; S02 measures it.

**Status: Verified.** Scoped to the rigid-root model the claim states: FEA and beam theory agree to +2.0 %. The real deflection is larger and is a test item (S02).

**✓ re-runs to 3.354 mm** against the claim's 3.155 mm (difference +6.31 %).

## Calculation

1. Step

$$I = \frac{\pi}{64}(D^4 - d^4)$$

$$=  \frac{\pi}{64}(0.0254^4 - 0.02362^4) = 5.15\times 10^{-9}\ \text{m⁴}$$

2. tip deflection, cantilever

$$\delta = \frac{P L^3}{3EI}$$

$$=  \frac{30.69 \times 0.4883^3}{3EI} = 3.354\ \text{mm}$$

## Inputs

| Symbol | Value | Meaning | Comes from |
|---|---|---|---|
| $P$ | 30.69 N | maximum thrust of one lift unit | cad/params.txt:52 |
| $L$ | 0.4883 m | boom length | cad/params.txt:51 |
| $D$ | 0.0254 m | boom OD | cad/params.txt:19 |
| $d$ | 0.02362 m | boom ID | cad/params.txt:20 |
| $E$ | 6.900e+10 Pa | Young's modulus, 6061-T6 | cad/params.txt:66; SRC-09 [confirmed] Wikipedia, "6061 aluminium alloy" |

*Full-length cantilever; the FEA clamps over the block, so it is a little stiffer.*

## Independent check

cantilever with the load at the tip-block centroid (tolerance 5 %) (difference -1.9 %), `analysis/validation/check_struct.py#STR-03`

## External sources

- **SRC-01** [confirmed]: [SunnySky X4110S motors (maker/US store page), KV400 thrust table](https://sunnyskyusa.com/collections/multirotor-motors/products/sunnysky-x4110s-motors), checked 2026-11-01
- **SRC-10** [not_fetchable]: SOLIDWORKS material library "6061-T6 (SS)", checked 2026-11-01

---
Generated by `py tools/vtol.py prove STR-03` from `analysis/validation/proofs.json` (2026-11-03 12:21) and `analysis/validation/claims_struct.json`. Every input is read from the file it names when `proofs.py` runs.
