davinciucberkeley-collab/DillonVTOL/docs/validation/proofs/STR-04.md

# STR-04: Boom first bending mode with the 0.3255 kg lift unit and a rigid root: 27.7 Hz FEA vs 27.9 Hz hand with the tip mass at the same position (-0.8 %). The EST hover rotor frequency (1P) 91 Hz is 3.3 x higher; a compliant root only lowers f1, away from 1P.

**Status: Verified.** FEA and hand agree to -0.8 % on the same geometry and now use the CAD-calibrated tip mass (STR-05). Scoped to a rigid root; a softer root moves f1 down, further from 1P.

**✓ re-runs to 25.84 Hz** against the claim's 27.73 Hz (difference -6.80 %).

## Calculation

1. Step

$$I = \frac{\pi}{64}(D^4 - d^4)$$

$$=  \frac{\pi}{64}(0.0254^4 - 0.02362^4) = 5.15\times 10^{-9}\ \text{m⁴}$$

2. boom mass

$$m_b = \rho_{Al}\frac{\pi}{4}(D^2 - d^2)L$$

$$=  2700\frac{\pi}{4}(0.0254^2 - 0.02362^2)\times 0.4883 = 0.09026\ \text{kg}$$

3. first bending mode, cantilever with tip mass (Rayleigh)

$$f_1 = \frac{1}{2\pi}\sqrt{\frac{3EI}{(m_{tip} + 0.24\,m_b)L^3}}$$

$$=  \frac{1}{2\pi}\sqrt{\frac{3EI}{(0.3255 + 0.24\,\times 0.09026)\times 0.4883^3}} = 25.84\ \text{Hz}$$

## Inputs

| Symbol | Value | Meaning | Comes from |
|---|---|---|---|
| $m_{tip}$ | 0.3255 kg | lift-unit mass at the tip | result of [STR-05](STR-05.md); cad/params.txt:53 |
| $L$ | 0.4883 m | boom length | cad/params.txt:51 |
| $D$ | 0.0254 m | OD | cad/params.txt:19 |
| $d$ | 0.02362 m | ID | cad/params.txt:20 |
| $E$ | 6.900e+10 Pa | Young's modulus, 6061-T6 | cad/params.txt:66; SRC-09 [confirmed] Wikipedia, "6061 aluminium alloy" |
| $\rho_{Al}$ | 2700 kg/m³ | 6061 density | cad/params.txt:68; SRC-09 [confirmed] Wikipedia, "6061 aluminium alloy" |

## Independent check

Rayleigh cantilever + tip mass at the block centroid (tolerance 5 %) (difference +0.8 %), `analysis/validation/check_struct.py#STR-04`

## Links

Uses: [STR-05](STR-05.md)

Used by: —

## External sources

- **SRC-01** [confirmed]: [SunnySky X4110S motors (maker/US store page), KV400 thrust table](https://sunnyskyusa.com/collections/multirotor-motors/products/sunnysky-x4110s-motors), checked 2026-11-01
- **SRC-09** [confirmed]: [Wikipedia, "6061 aluminium alloy"](https://en.wikipedia.org/wiki/6061_aluminium_alloy), checked 2026-11-01
- **SRC-10** [not_fetchable]: SOLIDWORKS material library "6061-T6 (SS)", checked 2026-11-01

---
Generated by `py tools/vtol.py prove STR-04` from `analysis/validation/proofs.json` (2026-11-03 12:21) and `analysis/validation/claims_struct.json`. Every input is read from the file it names when `proofs.py` runs.
