davinciucberkeley-collab/DillonVTOL/docs/validation/proofs/STR-06.md

# STR-06: Wing root bending moment at ultimate load (n 4.5 = 3.0 x 1.5, MTOW 7.438 kg, no inertia relief) is 89.5 N m with the AVL span loading of this wing. Sizing and FEA use the Schrenk loading since 2026-11-02: 91.0 N m (+1.7 % vs AVL, conservative); the former elliptic value 83.6 N m was 6.6 % low. Crediting the boom-mounted mass (inertia relief) would lower it to 65.3 N m.

**Status: Verified.** Restated on the AVL span loading of the actual wing: Schrenk agrees to +1.7 % and is now the design value in the sizing, params.txt and the FEA. Requirement note: the 3.0 limit factor was set by the team with no source; the audit basis is the stall line, which caps n at 4.53 within the firmware envelope (AIRSPEED_MAX 25 m/s), about n_ult.

**✓ re-runs to 89.47 N·m** against the claim's 89.5 N m (difference -0.03 %).

## Calculation

1. lift on one wing

$$L_{half} = \frac{m g\, n_{ult}}{2}$$

$$=  \frac{7.438 \times 9.807\, \times 4.5}{2} = 164.1\ \text{N}$$

2. root moment, AVL span loading

$$M_{root} = L_{half}\,\bar{y}$$

$$=  164.1\,\times 0.5452 = 89.47\ \text{N·m}$$

## Inputs

| Symbol | Value | Meaning | Comes from |
|---|---|---|---|
| $m$ | 7.438 kg | MTOW in cad/params.txt | result of [AERO-22](AERO-22.md); cad/params.txt:141 |
| $g$ | 9.807 m/s² | gravitational acceleration | standard gravity, CGPM 1901 / ISO 80000-3 |
| $n_{ult}$ | 4.5  | ultimate load factor (3 x 1.5, team-set estimate) | cad/params.txt:54 |
| $\bar{y}$ | 0.5452 m | spanwise centre of lift from the AVL strip loads (analysis/aero/out/avl/fs_pod_trim.txt, integrated by check_struct.py) | analysis/validation/checks_struct.json#checks.STR-06.ybar_avl_m |

*The sizing uses elliptic lift (centre of lift 4 (b/2) / 3 pi = 0.509 m); the AVL centre of lift is 7 % further out.*

## Independent check

Schrenk approximation for the rectangular planform (tolerance 5 %) (difference +1.7 %), `analysis/validation/check_struct.py#STR-06`

## Links

Uses: [AERO-22](AERO-22.md)

Used by: [STR-07](STR-07.md)

---
Generated by `py tools/vtol.py prove STR-06` from `analysis/validation/proofs.json` (2026-11-03 12:21) and `analysis/validation/claims_struct.json`. Every input is read from the file it names when `proofs.py` runs.
