davinciucberkeley-collab/DillonVTOL/docs/validation/proofs/STR-07.md

# STR-07: Joiner 0.875 x 0.058 in at the centreline, ultimate load with the Schrenk design moment 91.0 N m: 194.7 MPa, reserve factor 1.23 on the 240 MPa minimum yield (1.41 on the 275 MPa library value, results.json struct.MS_J). With the AVL moment 89.5 N m: 191.4 MPa, RF 1.25.

**Status: Partially Verified.** Beam stress reproduced and RF > 1 on minimum yield with the AVL moment. Not verified: the slip fit loads the joiner by line contact at the socket mouth and at the stop (local bearing on 1.47 mm walls, ovalisation) and no solver models it; the hard-landing joiner moment (104.8 N m EST, RF 1.07) exceeds this flight case and no test covers it before S06.

**✓ re-runs to 191.4 MPa** against the claim's 191.4 MPa (difference 0.00 %).

## Calculation

1. Step

$$I = \frac{\pi}{64}(D^4 - d^4)$$

$$=  \frac{\pi}{64}(0.02223^4 - 0.01928^4) = 5.2\times 10^{-9}\ \text{m⁴}$$

2. joiner bending stress at the centreline

$$\sigma = \frac{M (D/2)}{I}$$

$$=  \frac{89.5 (0.02223/2)}{5.2\times 10^{-9}} = 191.4\ \text{MPa}$$

## Inputs

| Symbol | Value | Meaning | Comes from |
|---|---|---|---|
| $M$ | 89.5 N·m | root moment at ultimate, AVL span loading | result of [STR-06](STR-06.md); analysis/validation/checks_struct.json#checks.STR-06.M_avl_Nm |
| $D$ | 0.02223 m | joiner OD (0.875 in) | cad/params.txt:16 |
| $d$ | 0.01928 m | joiner ID | cad/params.txt:17 |

## Independent check

same beam formula on the repo Schrenk moment vs cad/sim/results.txt spar_hand_sigJ (STR-07b) (difference +0.0 %), `analysis/validation/check_struct.py#STR-07`

## Links

Uses: [STR-06](STR-06.md)

Used by: —

## External sources

- **SRC-10** [not_fetchable]: SOLIDWORKS material library "6061-T6 (SS)", checked 2026-11-01

---
Generated by `py tools/vtol.py prove STR-07` from `analysis/validation/proofs.json` (2026-11-03 12:21) and `analysis/validation/claims_struct.json`. Every input is read from the file it names when `proofs.py` runs.
