davinciucberkeley-collab/DillonVTOL/docs/validation/proofs/THM-01.md

# THM-01: Lift motor alone, steady state (an upper bound never reached in flight, tau about 206 s vs 60-90 s hovers): 178.2 C FEA vs 175.0 C hand at the 25 C design ambient (+2.1 % of the rise), and 185.6 vs 185.0 C (+0.4 %) in the Sim.cs solver-validation case (fixed 35 C test ambient), for the EST inputs Q 56.6 W (THM-03) and h 44.6 W/m2K (THM-02).

**Status: Verified.** Solver and hand agree within 2.1 % of the rise at 25 C and 0.4 % in the validation case. The claim is conditional on the EST heat and film coefficient, which are tracked (and not verified) in THM-02 and THM-03.

**✓ re-runs to 175.1 °C** against the claim's 178.2 deg C (difference -1.74 %).

## Calculation

1. motor outer area

$$A = \pi D H + 2\frac{\pi D^2}{4}$$

$$=  \pi 0.048 \times 0.032 + 2\frac{\pi 0.048^2}{4} = 0.008445\ \text{m²}$$

2. steady temperature, lumped

$$T = T_{amb} + \frac{Q}{hA}$$

$$=  25 + \frac{56.6}{hA} = 175.1\ \text{°C}$$

## Inputs

| Symbol | Value | Meaning | Comes from |
|---|---|---|---|
| $T_{amb}$ | 25 °C | design ambient 25 °C (DESIGN-BASIS R21) | analysis/thermal/thermal_inputs.json#ambient.hot_C |
| $Q$ | 56.6 W | heat into the motor | result of [THM-03](THM-03.md); cad/params.txt:61 |
| $h$ | 44.65 W/m²K | convection coefficient (estimate) | result of [THM-02](THM-02.md); cad/params.txt:62 |
| $D$ | 0.048 m | motor diameter | cad/params.txt:26 |
| $H$ | 0.032 m | motor height | cad/params.txt:27 |

## Independent check

lumped steady balance at 25 C (tolerance 5 % of the rise) (difference -1.8 %), `analysis/validation/check_struct.py#THM-01`

## Links

Uses: [THM-02](THM-02.md), [THM-03](THM-03.md)

Used by: —

## External sources

- **SRC-01** [confirmed]: [SunnySky X4110S motors (maker/US store page), KV400 thrust table](https://sunnyskyusa.com/collections/multirotor-motors/products/sunnysky-x4110s-motors), checked 2026-11-01
- **SRC-20** [not_fetchable]: Incropera & DeWitt, Fundamentals of Heat and Mass Transfer, 6th ed. (Table A.4, eq. 7.52 + Table 7.2 Hilpert, eq. 7.30/7.38, Table 1.1), checked 2026-11-01

---
Generated by `py tools/vtol.py prove THM-01` from `analysis/validation/proofs.json` (2026-11-03 12:21) and `analysis/validation/claims_struct.json`. Every input is read from the file it names when `proofs.py` runs.
