davinciucberkeley-collab/DillonVTOL/docs/test/cards/DS-C06-C07.md

# Data sheet DS-C06 / DS-C07 — Thrust-stand calibration and motor thrust curves
DBF-TP-001 rev C data sheet · Test C06 / C07 · Date ____ · Operator ____ · Witness ____ · Article/serials ____

Stand: pivot ratio ____ (1:1 target) · load cell 20 kg + HX711 + Nano · watt meter in the pack lead · ESC: LANRC BLHeli_S 45A s/n ____ · protocol: DShot150 / PWM · ambient ____ °C · pressure ____ hPa (for ρ).

## C06 calibration (water jugs weighed on the kitchen scale)
Pass: ≤ 2 % of reading 0.5–5 kg; hysteresis ≤ 1 %; drift ≤ 20 g / 10 min.

| Applied (kg) | Reading up (kg) | Reading down (kg) | Error up (%) | Error down (%) |
|---|---|---|---|---|
| 0 | | | | |
| 0.5 | | | | |
| 1.0 | | | | |
| 2.0 | | | | |
| 3.0 | | | | |
| 5.0 | | | | |
| 10.0 | | | | |

Drift after 10 min powered: ____ g · Tare with motor + prop: ____ kg

## C07 thrust curve (one table per motor; copy for motors M1–M5). Motor s/n ____ · prop JeeFly 1755 s/n ____ · pack start V ____
Pass: max ≥ 2.98 kgf at 22.2 V (R13 = 1.6 × 7.438 kg / 4 = 2.975, results.json sized.m; the review's 2.4 kgf is superseded); P_elec at 1,859 g ≤ 339 W (TEST-PLAN.md C07, calc at 18 m/s cruise); Imax ≤ 36 A EST. Predicted (budget-lift A3, 17×5.8): 1,500 g / 8.1 A / 180 W; 3,130 g / 27.7 A / 615 W; hover 1,859 g at 283.0 W (results.json sized).

| Throttle (%) | Thrust (g) | V (V) | I (A) | P (W) | g/W | Can °C after |
|---|---|---|---|---|---|---|
| 20 | | | | | | |
| 30 | | | | | | |
| 40 | | | | | | |
| 50 | | | | | | |
| 60 | | | | | | |
| 70 | | | | | | |
| 80 | | | | | | |
| 90 | | | | | | |
| 100 (10 s) | | | | | | |
| 100 at 22.2 V | | | | | | |

Save as CSV `throttle_pct,thrust_g,volt_V,curr_A` → `docs/test/analysis/thrust_stand.py <file>` gives hover throttle, FM·η (sizing 0.505), Q_M_THST_EXPO.
Hover throttle (1,859 g; expected ~59 %): ____ % · P_elec at hover: ____ W · FM·η: ____ · Max thrust: ____ g at ____ A

## Result
PASS / FAIL · Deviations: ____ · Signed (TD) ______ Date ______
