davinciucberkeley-collab/DillonVTOL/docs/test/cards/FTC-F08.md

# Flight test card FTC-F08 — Airspeed calibration and cruise performance

DBF-TP-001 rev C · Test F08 · Review step: F6 follow-on; review 10 M1, 4 M2 · Requirements: R10, R11

**Prerequisites (signed in test-matrix.csv):** F07 passed twice

**Configuration:** As F07. Flight 1: ARSPD_AUTOCAL 1 (set to 0 after landing). Flight 2: ARSPD_AUTOCAL 0 with the new ARSPD_RATIO.

**Weather limits:** Steady <= 5 m/s, gusts <= 8 m/s; calm air preferred for the power legs (still-air drag back-out, review 4 M2).

**Predicted:** at 18 m/s, P_cruise 296 W / 13.3 A (results.json sized, 2026-11-01) or 258 W / 11.6 A (aero_results mission); CD0 0.0425 / 0.0375; L/D 8.7 / 10.0; drag 8.4 / 7.3 N. Cruise available 12.0 min (sizing) / 13.8 min (aero). Pusher can 76 degC after 600 s of cruise at 25 degC in the closed PA6-CF cup, 4 K under its 80 degC EST limit (docs/research/thermal.md 6.3, estimated 33.2 W loss); model rise over ambient 17 / 28 K after 60 / 120 s.

**Crew:** TD, SO, PIC, GCS · **Duration:** 1 session (2 flights), 2 packs

## Pre-flight (every flight)
- [ ] Flight request approved for today and site (R19); Remote ID powered, broadcast seen (E12); registration mark on the pod; PIC TRUST/AMA documents on site (R18).
- [ ] Weather recorded at the field: wind steady ____ m/s, gusts ____ m/s (limit on this card), air temp ____ degC (F06-F13: <= 25 degC, DESIGN-BASIS R21 / TEST-PLAN.md s4 rule 9), visibility >= 3 sm, no precipitation.
- [ ] Weight and CG per G01: take-off mass ____ kg (<= 7.82 kg = 4 x 3.130 / 1.6, R13), CG ____ % MAC (28 +-2, never aft of 30.5), pack at its mark (G09); no ballast, nothing in the bay (R12): Y / N; leg fairings on: Y / N.
- [ ] Props: correct rotation, screws witness-marked, no nicks; pusher spin check.
- [ ] Witness lines on boom clamps, gear clamps, wing bolts unmoved.
- [ ] Packs >= 4.15 V/cell; pack strapped (J18); plugged in LAST through the AS150U.
- [ ] GCS: firmware hash ____; parameters checked with check_params.py; FENCE_ALT_MAX = site ceiling; FENCE_RADIUS = ____ m; EKF/GPS ok (sats >= 10, HDOP <= 1.5); compass consistent; airspeed 0 +-1 m/s, blow test >= 6 m/s.
- [ ] RC: arm switch CH5 off, mode CH6 in slot for this card, E-stop CH7 off, Q_ASSIST CH8 auto, RTL CH9 off; LQ >= 90 %.
- [ ] Range: crew line 30 m crosswind of the take-off point, clear of the transition run (TEST-PLAN §4 rule 6), fire bag + extinguisher + first aid at the line, spectators behind, no people downrange, sky scan.
- [ ] Crew brief: TD states the build-up points, abort word "ABORT", who calls what. Timer ready.

## Hover limits on this aircraft (R14 accepted limitation, DESIGN-BASIS.md)
Hover-only flights: <= 5 m AGL and <= 60 s per hover; cool motors < 45 degC between hovers. C0 cannot survive a lift-motor failure in hover.

## Transition rule (firmware/README.md 9.6; SITL finding)
Start every transition at the upwind field edge and turn as soon as 'Transition done' appears: a straight transition reached the 300 m fence circle ~6 s after transition end in SITL. Telemetry: CRSF on the handset (or the ELRS MAVLink overlay); no separate radio.

## Back-transition watch (C0 SITL model; firmware/sitl/README.md 'Gains' item 1)
In the C0 airframe model the back-transition airbrake pitches the nose to the 30 deg VTOL angle limit with the lift motors near idle, which briefly stalls the wing (alpha_stall ~11 deg); position2 then recovers with a -18/+33 deg pitch swing and a 79 A peak; altitude loss stayed under 2 m (0 m in scenario A of the 2026-10-27 run at 18 m/s, 1.7 m in the 20 m/s run; firmware/sitl/results_c0.json). Back-transition only at >= 30 m AGL, wings level, into wind. Watch for pitch-up past 30 deg, a wing drop, sink > 2 m or current > 85 A. If seen: land, review ATT / QTUN / BAT, and lower Q_TRANS_DECEL first (2.0 now; a gentler, longer stop: v^2 / 2a = 108 m at 1.5 m/s2 from 18 m/s, calc) before Q_ANGLE_MAX or any attitude gain.

## Build-up points (in order; stop and review the log between points when the card says so)
1. [ ] Flight 1: transition, climb to 60 m, fly repeated circuits/LOITER for ~5 min with ARSPD_AUTOCAL 1 (ArduPilot: values save every 2 min when changed > 5 %). Land; set ARSPD_AUTOCAL 0; read ARSPD_RATIO.
2. [ ] Flight 2: transition; reciprocal legs at 18 m/s indicated (cruise) at 60 m AGL (CRUISE), each pass ≥ 15 s steady (about 270 m; a 60 s leg is 1,080 m and does not fit inside the 250 m fence-abort ring), repeated until each heading has ≥ 60 s in total; then the same at 20 m/s and at 22 m/s. Record current and throttle on each leg.
3. [ ] Back-transition, QLAND.

## Abort criteria (card-specific items first, then the universal list)
- ARSPD_RATIO outside 1.5-3.0 during flight 1 (GCS reads it): land and check for leaks (ArduPilot airspeed calibration page).
- Cruise current > 22 A sustained EST at 20 m/s (pack endurance at risk; pass is 16.0 A).
- Aircraft within 50 m of the 300 m fence in fixed-wing flight.
Universal (TEST-PLAN.md s5): VIBE > 30 m/s2 or rising clipping; attitude error > 15 deg; any oscillation; sag-compensated voltage < 21.0 V or < 1,625 mAh remaining (firmware low-battery RTL point; critical 19.8 V / 1,300 mAh -> QLAND); motor can > 80 degC EST after landing; wind above the card limit; LQ < 70 % EST or any failsafe message; EKF/GPS/compass warning; people or animals inside the range; manned aircraft converging.

## Data to record
ARSP.Airspeed, ARSP.Ratio; GPS.Spd per leg (mean of reciprocal legs removes wind); BAT.Curr and Volt mean per leg; CTUN.ThrOut; reduce with log_summary.py.

## Pass criteria
- [ ] ARSPD_RATIO 1.5-3.0 (ardupilot.org calibrating-an-airspeed-sensor, checked 2026-10-21) and airspeed vs reciprocal-leg GPS mean error <= 10 % (review 10 M1).
- [ ] Cruise at 18 m/s (design cruise): electrical power <= 356 W = 16.0 A at 22.2 V (calc in TEST-PLAN.md R10 line) so R10 holds on the selected pack; implied CD0 <= 0.0425 x 1.2 EST (sizing CD0 0.0425, aero 0.0377).
- [ ] Pusher can by IR within 30 s of landing after the reciprocal legs <= 80 degC EST (docs/research/thermal.md 6.3-6.4 item 6: > 80 degC after a cruise leg means the closed cup floor must become an open spider).
- [ ] Trimmed level flight achievable at 18, 20 and 22 m/s (R11 band).

## Run log

| Run | Time | Pack V/cell start | Wind | Point reached | Result | Notes |
|---|---|---|---|---|---|---|
| 1 | | | | | | |
| 2 | | | | | | |
| 3 | | | | | | |

## Post-flight (every flight)
- [ ] IR temperatures within 30 s: M1 ____ M2 ____ M3 ____ M4 ____ pusher ____ ESC max ____ pack ____ degC (any unit 15 degC hotter than its neighbours or pack > 60 degC EST grounds the aircraft).
- [ ] Pack: resting V/cell ____; mAh returned on charge ____.
- [ ] Airframe walk-round: witness lines, prop nicks, foam skin, gear.
- [ ] Log copied from the SD card and named `YYYY-MM-DD_F08_r<n>_C0.bin`; run `docs/test/analysis/log_summary.py` on it.
- [ ] Post-flight report filed within 3 business days for on-campus flights (R19).
- [ ] Result: PASS / PASS WITH LIMITS / FAIL. TD ______ SO ______ PIC ______ Date ______
