davinciucberkeley-collab/DillonVTOL/analysis/cfd3d/out/cases/L2_a2.0/history.csv

Time_Iter | Outer_Iter | Inner_Iter | "rms[P]" | "rms[U]" | "rms[V]" | "rms[W]" | "RefForce" | "CD" | "CL" | "CSF" | "CMx" | "CMy" | "CMz" | "CFx" | "CFy" | "CFz" | "CEff" | "Cauchy[CL]" | "Cauchy[CD]" | "Cauchy[CMy]"
0 | 0 | 0 | -1.549153129 | -0.285828344 | -1.11290447 | 0.2465603129 | 76.66699005 | 0.02284410934 | 0.4951498274 | 0.01681964165 | 0.8445953459 | -0.07230865453 | -0.03679090683 | 0.005549713559 | 0.01681964165 | 0.4956454434 | 21.67516448 | 1 | 1 | 1
0 | 0 | 1 | -1.689966173 | -0.4288239032 | -1.269475248 | 0.1046192423 | 76.66699005 | 0.0228441049 | 0.4951499345 | 0.01681964984 | 0.8445954669 | -0.07230892382 | -0.0367908943 | 0.005549705384 | 0.01681964984 | 0.4956455503 | 21.67517338 | 1.081273964e-09 | 2.220140714e-10 | 1.346444971e-08
0 | 0 | 2 | -1.773133746 | -0.5106509409 | -1.199076227 | 0.02468719421 | 76.66699005 | 0.0228441062 | 0.4951498843 | 0.01681965671 | 0.844595406 | -0.07230881107 | -0.03679089843 | 0.005549708437 | 0.01681965671 | 0.4956455002 | 21.67516995 | 1.587292428e-09 | 2.872504037e-10 | 1.910188185e-08
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
