davinciucberkeley-collab/DillonVTOL/analysis/cfd3d/out/cases/L2_a8.0/history.csv

Time_Iter | Outer_Iter | Inner_Iter | "rms[P]" | "rms[U]" | "rms[V]" | "rms[W]" | "RefForce" | "CD" | "CL" | "CSF" | "CMx" | "CMy" | "CMz" | "CFx" | "CFy" | "CFz" | "CEff" | "Cauchy[CL]" | "Cauchy[CD]" | "Cauchy[CMy]"
0 | 0 | 0 | -1.248046331 | 0.02839499764 | -0.8185035557 | 0.5454229071 | 76.66699005 | 0.07447621746 | 0.4900494852 | 0.01681964165 | 0.8445953459 | -0.07230865453 | -0.03679090683 | 0.005549713559 | 0.01681964165 | 0.4956454434 | 6.579945946 | 1 | 1 | 1
0 | 0 | 1 | -1.389031379 | -0.117430844 | -0.9779881517 | 0.4026331529 | 76.66699005 | 0.07447622424 | 0.4900495921 | 0.01681964984 | 0.8445954669 | -0.07230892382 | -0.0367908943 | 0.005549705384 | 0.01681964984 | 0.4956455503 | 6.579946783 | 1.09127898e-09 | 3.388405743e-10 | 1.34644542e-08
0 | 0 | 2 | -1.471785798 | -0.197439174 | -0.8953812463 | 0.3240112559 | 76.66699005 | 0.0744762203 | 0.4900495422 | 0.01681965672 | 0.844595406 | -0.07230881107 | -0.03679089843 | 0.005549708437 | 0.01681965672 | 0.4956455002 | 6.579946461 | 1.601154727e-09 | 5.358630137e-10 | 1.910188783e-08
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
