davinciucberkeley-collab/DillonVTOL/analysis/cfd3d/out_rev1/cases/L2_a0.0/history.csv

Time_Iter | Outer_Iter | Inner_Iter | "rms[P]" | "rms[U]" | "rms[V]" | "rms[W]" | "RefForce" | "CD" | "CL" | "CSF" | "CMx" | "CMy" | "CMz" | "CFx" | "CFy" | "CFz" | "CEff" | "Cauchy[CL]" | "Cauchy[CD]" | "Cauchy[CMy]"
0 | 0 | 0 | -1.632007509 | -0.3704406453 | -0.9833376389 | 0.1233825855 | 67.67363295 | 0.009802926701 | 0.4512863072 | 0.02022827159 | 0.8759253149 | -0.05783205969 | -0.03769829841 | 0.009802926701 | 0.02022827159 | 0.4512863072 | 46.03587489 | 1 | 1 | 1
0 | 0 | 1 | -1.784370139 | -0.5290229351 | -1.227083402 | -0.02187827511 | 67.67363295 | 0.009802922184 | 0.4512864023 | 0.02022827752 | 0.8759253014 | -0.05783232745 | -0.03769827654 | 0.009802922184 | 0.02022827752 | 0.4512864023 | 46.0359058 | 1.053481848e-09 | 2.258846792e-10 | 1.338768134e-08
0 | 0 | 2 | -1.887902548 | -0.6293763818 | -1.116608631 | -0.1029922155 | 67.67363295 | 0.009802933613 | 0.4512865408 | 0.0202282658 | 0.8759252902 | -0.05783271017 | -0.0376983048 | 0.009802933613 | 0.0202282658 | 0.4512865408 | 46.03586626 | 2.588441385e-09 | 7.973566704e-10 | 3.252397644e-08
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
