davinciucberkeley-collab/DillonVTOL/analysis/cfd3d/out_rev1/cases/L2_a2.0/history.csv

Time_Iter | Outer_Iter | Inner_Iter | "rms[P]" | "rms[U]" | "rms[V]" | "rms[W]" | "RefForce" | "CD" | "CL" | "CSF" | "CMx" | "CMy" | "CMz" | "CFx" | "CFy" | "CFz" | "CEff" | "Cauchy[CL]" | "Cauchy[CD]" | "Cauchy[CMy]"
0 | 0 | 0 | -1.933004515 | -0.6697561338 | -1.286461165 | -0.1778063046 | 67.67363295 | 0.02554662001 | 0.4506692785 | 0.02022827159 | 0.8759253149 | -0.05783205969 | -0.03769829841 | 0.009802926701 | 0.02022827159 | 0.4512863072 | 17.64105304 | 1 | 1 | 1
0 | 0 | 1 | -2.085467311 | -0.8287007172 | -1.521998075 | -0.3226159492 | 67.67363295 | 0.02554661881 | 0.4506693737 | 0.02022827752 | 0.8759253014 | -0.05783232745 | -0.03769827654 | 0.009802922184 | 0.02022827752 | 0.4512864023 | 17.64105759 | 1.056035065e-09 | 5.983139852e-11 | 1.338771995e-08
0 | 0 | 2 | -2.18988261 | -0.9297253911 | -1.416488204 | -0.4049807057 | 67.67363295 | 0.02554663507 | 0.4506695118 | 0.0202282658 | 0.8759252902 | -0.05783271017 | -0.0376983048 | 0.009802933614 | 0.0202282658 | 0.4512865408 | 17.64105177 | 2.587775102e-09 | 8.727601088e-10 | 3.25239053e-08
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
