davinciucberkeley-collab/DillonVTOL/analysis/cfd3d/out_rev1/cases/L2_a4.0/history.csv

Time_Iter | Outer_Iter | Inner_Iter | "rms[P]" | "rms[U]" | "rms[V]" | "rms[W]" | "RefForce" | "CD" | "CL" | "CSF" | "CMx" | "CMy" | "CMz" | "CFx" | "CFy" | "CFz" | "CEff" | "Cauchy[CL]" | "Cauchy[CD]" | "Cauchy[CMy]"
0 | 0 | 0 | -8.920021546 | -7.230253882 | -7.341896517 | -7.26650601 | 67.67363295 | 0.04125937835 | 0.4495032577 | 0.02022866282 | 0.8759254723 | -0.05783220483 | -0.03769797836 | 0.009803110378 | 0.02022866282 | 0.4512863991 | 10.89457175 | 1 | 1 | 1
0 | 0 | 1 | -8.902714265 | -7.216723754 | -7.318112169 | -7.238315808 | 67.67363295 | 0.04125942131 | 0.4495032039 | 0.02022874594 | 0.8759254087 | -0.05783215721 | -0.037698203 | 0.009803156993 | 0.02022874594 | 0.4512863484 | 10.8945591 | 5.986692247e-10 | 2.14828865e-09 | 2.381209085e-09
0 | 0 | 2 | -8.864778392 | -7.200002718 | -7.293912148 | -7.217523355 | 67.67363295 | 0.04125947071 | 0.4495032802 | 0.02022882159 | 0.8759253506 | -0.05783243519 | -0.03769846671 | 0.009803200955 | 0.02022882159 | 0.451286428 | 10.8945479 | 1.446898532e-09 | 4.618350345e-09 | 1.628042204e-08
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
