davinciucberkeley-collab/DillonVTOL/analysis/cfd3d/out_rev1/cases/L2_a4.0/history_leg1.csv

Time_Iter | Outer_Iter | Inner_Iter | "rms[P]" | "rms[U]" | "rms[V]" | "rms[W]" | "RefForce" | "CD" | "CL" | "CSF" | "CMx" | "CMy" | "CMz" | "CFx" | "CFy" | "CFz" | "CEff" | "Cauchy[CL]" | "Cauchy[CD]" | "Cauchy[CMy]"
0 | 0 | 0 | -4.236363622 | -3.104199038 | -3.779365678 | -3.629599035 | 67.67363295 | 0.6579632646 | 0.4998994612 | -0.009047288446 | 0.9973065798 | -0.3702849772 | -0.9141670831 | 0.6214892755 | -0.009047288446 | 0.5445789284 | 0.7597680419 | 1 | 1 | 1
0 | 0 | 1 | -4.188355857 | -2.747262775 | -2.990323286 | -2.781073921 | 67.67363295 | 0.7472359273 | 0.6663357707 | -0.01140188061 | 1.323887692 | -0.4781109348 | -1.021320684 | 0.6989344644 | -0.01140188061 | 0.7168371536 | 0.8917341183 | 0.001248892202 | 0.0005973525857 | 0.001127624885
0 | 0 | 2 | -4.279933584 | -2.813152145 | -3.01355966 | -2.801063192 | 67.67363295 | 0.7684816636 | 0.7394529743 | -0.0159220147 | 1.468583325 | -0.5172157545 | -1.056492102 | 0.7150280489 | -0.0159220147 | 0.791258275 | 0.9622259182 | 0.001743292834 | 0.0007355844872 | 0.00150565687
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
