davinciucberkeley-collab/DillonVTOL/analysis/cfd3d/out/scheme2d/3D-L1/a0/history.csv

Time_Iter | Outer_Iter | Inner_Iter | "rms[P]" | "rms[U]" | "rms[V]" | "RefForce" | "CD" | "CL" | "CSF" | "CMx" | "CMy" | "CMz" | "CFx" | "CFy" | "CFz" | "CEff" | "Cauchy[CL]" | "Cauchy[CD]" | "Cauchy[CMz]"
0 | 0 | 0 | -2.343798759 | -1.256047497 | -1.558394073 | 63.88919145 | 0.3782914199 | 0.02398250537 | 0 | 0 | 0 | 0.09301747941 | 0.3782914199 | 0.02398250537 | 0 | 0.06339690544 | 1 | 1 | 1
0 | 0 | 1 | -2.41451006 | -1.154216107 | -0.9611031505 | 63.88919145 | 0.3703631151 | 0.03861348596 | 0 | 0 | 0 | 0.1075208452 | 0.3703631151 | 0.03861348596 | 0 | 0.1042584544 | 0.0007315490295 | 0.0001070342114 | 0.000674444371
0 | 0 | 2 | -2.612221207 | -1.342272715 | -1.106603815 | 63.88919145 | 0.3460311653 | 0.03471943869 | 0 | 0 | 0 | 0.1035565953 | 0.3460311653 | 0.03471943869 | 0 | 0.1003361609 | 0.0009262513934 | 0.0004586203154 | 0.000865849362
0 | 0 | 3 | -2.665788832 | -1.382058898 | -1.148550823 | 63.88919145 | 0.3052633341 | 0.0315225084 | 0 | 0 | 0 | 0.0953779253 | 0.3052633341 | 0.0315225084 | 0 | 0.10326333 | 0.001086097908 | 0.001126368889 | 0.001274782864
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
