davinciucberkeley-collab/DillonVTOL/analysis/cfd3d/out/scheme2d/3D-L1/a4/history.csv

Time_Iter | Outer_Iter | Inner_Iter | "rms[P]" | "rms[U]" | "rms[V]" | "RefForce" | "CD" | "CL" | "CSF" | "CMx" | "CMy" | "CMz" | "CFx" | "CFy" | "CFz" | "CEff" | "Cauchy[CL]" | "Cauchy[CD]" | "Cauchy[CMz]"
0 | 0 | 0 | -2.322103237 | -1.214124795 | -1.555590118 | 63.88919145 | 0.4189284929 | 0.5538454985 | 0 | 0 | 0 | 0.233555475 | 0.3792736951 | 0.5817193331 | 0 | 1.322052589 | 1 | 1 | 1
0 | 0 | 1 | -2.405270332 | -1.124542411 | -0.9350502888 | 63.88919145 | 0.4221341216 | 0.6639508731 | 0 | 0 | 0 | 0.2765461396 | 0.3747909524 | 0.6917801099 | 0 | 1.572843414 | 0.0008291680835 | 3.796931513e-05 | 0.0007772783349
0 | 0 | 2 | -2.586738784 | -1.290173867 | -1.066105428 | 63.88919145 | 0.3958274037 | 0.6508526334 | 0 | 0 | 0 | 0.2666422604 | 0.3494620034 | 0.676878713 | 0 | 1.644283916 | 0.0009297917804 | 0.0003702696773 | 0.0009629930663
0 | 0 | 3 | -2.646272819 | -1.342279369 | -1.116685738 | 63.88919145 | 0.3498519992 | 0.6050661724 | 0 | 0 | 0 | 0.2449019075 | 0.3067924947 | 0.6279967034 | 0 | 1.729491825 | 0.001308150902 | 0.001027339018 | 0.001406851451
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
