davinciucberkeley-collab/DillonVTOL/analysis/cfd3d/out/scheme2d/3D-L2/a0/history.csv

Time_Iter | Outer_Iter | Inner_Iter | "rms[P]" | "rms[U]" | "rms[V]" | "RefForce" | "CD" | "CL" | "CSF" | "CMx" | "CMy" | "CMz" | "CFx" | "CFy" | "CFz" | "CEff" | "Cauchy[CL]" | "Cauchy[CD]" | "Cauchy[CMz]"
0 | 0 | 0 | -2.505572684 | -1.417351434 | -1.719672826 | 63.88919145 | 0.385812853 | 0.02124714166 | 0 | 0 | 0 | 0.09200479369 | 0.385812853 | 0.02124714166 | 0 | 0.05507110894 | 1 | 1 | 1
0 | 0 | 1 | -2.572110255 | -1.314604011 | -1.13623184 | 63.88919145 | 0.3864177208 | 0.03771741351 | 0 | 0 | 0 | 0.1085705512 | 0.3864177208 | 0.03771741351 | 0 | 0.0976078774 | 0.0008235135929 | 7.826605177e-06 | 0.0007629028935
0 | 0 | 2 | -2.778903558 | -1.521345298 | -1.276372478 | 63.88919145 | 0.3704315566 | 0.03652628234 | 0 | 0 | 0 | 0.1065031363 | 0.3704315566 | 0.03652628234 | 0 | 0.09860467257 | 0.0008830701513 | 0.0002236041749 | 0.0008599617677
0 | 0 | 3 | -2.833662539 | -1.573827416 | -1.330096598 | 63.88919145 | 0.3365524317 | 0.03612214473 | 0 | 0 | 0 | 0.09959954556 | 0.3365524317 | 0.03612214473 | 0 | 0.1073299175 | 0.0009032770322 | 0.0007269302795 | 0.001205141306
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
