davinciucberkeley-collab/DillonVTOL/analysis/cfd3d/out/scheme2d/3D-L2/a4/history.csv

Time_Iter | Outer_Iter | Inner_Iter | "rms[P]" | "rms[U]" | "rms[V]" | "RefForce" | "CD" | "CL" | "CSF" | "CMx" | "CMy" | "CMz" | "CFx" | "CFy" | "CFz" | "CEff" | "Cauchy[CL]" | "Cauchy[CD]" | "Cauchy[CMz]"
0 | 0 | 0 | -2.483846228 | -1.375397012 | -1.716839276 | 63.88919145 | 0.426295125 | 0.5530162764 | 0 | 0 | 0 | 0.2333781193 | 0.3866802262 | 0.5814060012 | 0 | 1.297261554 | 1 | 1 | 1
0 | 0 | 1 | -2.561616507 | -1.28261081 | -1.110083867 | 63.88919145 | 0.4382019472 | 0.6664661896 | 0 | 0 | 0 | 0.2779634206 | 0.390644178 | 0.6954101341 | 0 | 1.520911064 | 0.0008511302977 | 0.0001358599873 | 0.0008019994352
0 | 0 | 2 | -2.752838267 | -1.466248473 | -1.235845296 | 63.88919145 | 0.4209404382 | 0.65717457 | 0 | 0 | 0 | 0.2715061443 | 0.3740728678 | 0.6849370464 | 0 | 1.561205601 | 0.0009218239919 | 0.0003408950403 | 0.0009209152745
0 | 0 | 3 | -2.814348477 | -1.53099199 | -1.296542664 | 63.88919145 | 0.3822114315 | 0.6140294767 | 0 | 0 | 0 | 0.2516712243 | 0.3384478526 | 0.6391954535 | 0 | 1.606517822 | 0.001273151533 | 0.0008475387912 | 0.001314979398
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
