davinciucberkeley-collab/DillonVTOL/analysis/cfd3d/out/scheme2d/fine/a4/history.csv

Time_Iter | Outer_Iter | Inner_Iter | "rms[P]" | "rms[U]" | "rms[V]" | "RefForce" | "CD" | "CL" | "CSF" | "CMx" | "CMy" | "CMz" | "CFx" | "CFy" | "CFz" | "CEff" | "Cauchy[CL]" | "Cauchy[CD]" | "Cauchy[CMz]"
0 | 0 | 0 | -2.530513611 | -1.422825896 | -1.762206057 | 63.88919145 | 0.4357833499 | 0.5756089601 | 0 | 0 | 0 | 0.2405931648 | 0.3945693522 | 0.6046055154 | 0 | 1.320860378 | 1 | 1 | 1
0 | 0 | 1 | -2.614537184 | -1.365451778 | -1.155899558 | 63.88919145 | 0.4530512035 | 0.6775939071 | 0 | 0 | 0 | 0.284647827 | 0.4046810319 | 0.7075465768 | 0 | 1.495623236 | 0.0007525521259 | 0.0001905728701 | 0.0007738450467
0 | 0 | 2 | -2.802598205 | -1.533573481 | -1.281493461 | 63.88919145 | 0.4349758226 | 0.6600767394 | 0 | 0 | 0 | 0.2755521704 | 0.3878716176 | 0.6888112052 | 0 | 1.517502135 | 0.0008852425139 | 0.0003983474168 | 0.000938889231
0 | 0 | 3 | -2.858932804 | -1.59013518 | -1.339981444 | 63.88919145 | 0.3944221701 | 0.6149540844 | 0 | 0 | 0 | 0.2547211147 | 0.3505643491 | 0.6409695869 | 0 | 1.559126568 | 0.001252120758 | 0.0009124368313 | 0.001347788503
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
