davinciucberkeley-collab/DillonVTOL/analysis/cfd3d/out/scheme2d/finest/a0/history.csv

Time_Iter | Outer_Iter | Inner_Iter | "rms[P]" | "rms[U]" | "rms[V]" | "RefForce" | "CD" | "CL" | "CSF" | "CMx" | "CMy" | "CMz" | "CFx" | "CFy" | "CFz" | "CEff" | "Cauchy[CL]" | "Cauchy[CD]" | "Cauchy[CMz]"
0 | 0 | 0 | -2.878293246 | -1.790527266 | -2.091110856 | 63.88919145 | 0.4063846026 | 0.03081879231 | 0 | 0 | 0 | 0.09454591313 | 0.4063846026 | 0.03081879231 | 0 | 0.07583651573 | 1 | 1 | 1
0 | 0 | 1 | -2.948546155 | -1.722089203 | -1.520108794 | 63.88919145 | 0.4254417731 | 0.04415912276 | 0 | 0 | 0 | 0.1115793468 | 0.4254417731 | 0.04415912276 | 0 | 0.1037959259 | 0.0006670165229 | 0.0002239691976 | 0.0007632879254
0 | 0 | 2 | -3.147567861 | -1.8940737 | -1.652517256 | 63.88919145 | 0.414913387 | 0.03905543458 | 0 | 0 | 0 | 0.1091785075 | 0.414913387 | 0.03905543458 | 0 | 0.09412912624 | 0.0009222009319 | 0.0003508437022 | 0.0008732381015
0 | 0 | 3 | -3.213358783 | -1.967845247 | -1.726959674 | 63.88919145 | 0.3814629236 | 0.03555049733 | 0 | 0 | 0 | 0.1017290914 | 0.3814629236 | 0.03555049733 | 0 | 0.09319515771 | 0.001097447794 | 0.0007892934345 | 0.001239378017
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
