davinciucberkeley-collab/DillonVTOL/analysis/thermal/img/lift_unit_hover_history.png

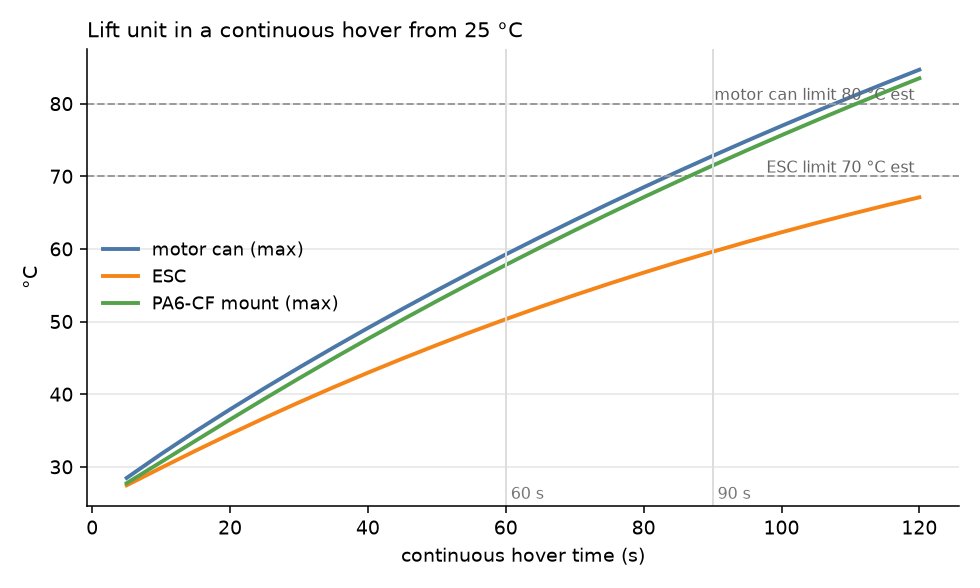
analysis/thermal/img/lift_unit_hover_history.png
