davinciucberkeley-collab/DillonVTOL/cad/params.built.txt

foil=-0.322367,0.000507;-0.321494,0.000720;-0.318885,0.001351;-0.314565,0.002382;-0.308578,0.003778;-0.300986,0.005496;-0.291867,0.007486;-0.281315,0.009690;-0.269442,0.012049;-0.256372,0.014498;-0.242245,0.016977;-0.227212,0.019420;-0.211436,0.021766;-0.195089,0.023952;-0.178350,0.025916;-0.161404,0.027597;-0.144440,0.028938;-0.127635,0.029886;-0.111036,0.030328;-0.094990,0.030189;-0.079686,0.029462;-0.065309,0.028159;-0.052030,0.026313;-0.040005,0.023975;-0.029372,0.021211;-0.020250,0.018098;-0.012738,0.014718;-0.006913,0.011152;-0.002829,0.007473;-0.000520,0.003742;0.000000,0.000000;-0.001246,-0.003566;-0.004215,-0.006779;-0.008863,-0.009622;-0.015129,-0.012082;-0.022934,-0.014141;-0.032188,-0.015790;-0.042788,-0.017025;-0.054620,-0.017853;-0.067561,-0.018295;-0.081480,-0.018381;-0.096239,-0.018157;-0.111690,-0.017674;-0.127681,-0.016994;-0.144201,-0.016126;-0.160930,-0.015062;-0.177677,-0.013853;-0.194261,-0.012549;-0.210504,-0.011193;-0.226226,-0.009823;-0.241255,-0.008471;-0.255424,-0.007162;-0.268574,-0.005919;-0.280558,-0.004762;-0.291239,-0.003709;-0.300496,-0.002778;-0.308221,-0.001987;-0.314326,-0.001352;-0.318738,-0.000886;-0.321406,-0.000602;-0.322299,-0.000507
foilWing=NACA 2415|m=0.02|p=0.4
foilTail=NACA 0009|m=0|p=0|t=0.09
foilTE=cad=-0.1015|aero=-0.1036
podProfile=ellipse-parallel-smoothstep|noseX=0.6|noseA=0.22|parallelTo=0.65
chord=0.322333
panelLen=1.120000
tc=0.150000
sparXfrac=0.300000
sparX=-0.096700
sparY=0.006044
sparOD=0.025400
sparID=0.022454
sparLen=0.800000
sparChanD=0.026000
joinOD=0.022225
joinID=0.019279
joinLen=0.760000
boomOD=0.025400
boomID=0.023622
segF=1.045960
segR=0.485900
fusL=1.000000
fusR=0.080000
tailR=0.030000
motorD=0.048000
motorH=0.032000
liftProp=0.431800
propW=0.035000
propT=0.008000
pushMotorD=0.048000
pushMotorL=0.032000
pushProp=0.355600
hC=0.125020
hSpan=0.917400
vH=0.207979
vC=0.166383
elevSpan=0.845800
battL=0.155000
battH=0.050000
battW=0.048000
legOD=0.025400
legID=0.022454
legLen=0.205000
pitotD=0.006000
pitotL=0.250000
xFront=0.407727
xRear=-0.588233
xStub0=-1.074133
yIn=0.433700
feaBoomL=0.488310
feaTipForce=30.694814
feaTipMass=0.325500
feaNult=4.500000
feaWingForce=189.642390
feaRootMomentTarget=91.028347
feaHandSigJ=194677730.000000
feaHandSigB=36978442.000000
feaHandDefl=0.003354
feaHandFn=25.853421
thermQ=56.596860
thermH=44.647127
thermAmbK=308.150000
thermTime=90.000000
matLib=6061-T6 (SS)
matE=69000000000.000000
matNu=0.330000
matRho=2700.000000
matSig=275000000.000000
motorMass=0.165000
motorCp=896.000000
gearClampBot=-0.028700
legSocketDepth=0.014000
legBoltY=-0.021700
fairBore=0.025600
fairWall=0.000800
fairChord=0.081600
fairLen=0.170000
fairY0=0.020000
clampTopF=0.014800
clampTopR=0.025951
yB=-0.032938
tailT=0.011252
yMotor=-0.011938
yProp=0.024062
yGround=-0.252638
xFinLE=-0.854133
yStabBot=-0.017238
yStabTop=-0.005986
yFin=-0.002986
xTC=-0.888033
finRootBlock=0.021000
rudderY0=0.022000
shoeWall=0.020000
shoeFloor=0.003000
shoeFlangeX=0.032000
boltZ=0.065000
boltX=-0.225633
yU70=0.019597
yL70=-0.009927
yMid70=0.004835
zBoomPanel=0.353700
yL30=-0.018138
yL80=-0.006987
yL55=-0.013910
yL78=-0.007590
yL21=-0.018343
zHornPanel=0.596400
zServoPanel=0.556500
xServo=-0.177283
yServo=-0.001910
servoL=0.038600
servoW=0.018800
servoH=0.034900
servoTabZ=0.024000
servoTabT=0.002500
servoTabX=0.023000
servoTabY=0.005000
servoShaftX=0.009500
servoArmLen=0.020000
trayBodyY=-0.010900
trayPlateZ=0.021000
trayPlateT=0.003000
pitotX=-0.050000
pitotY=-0.027843
pitotZ=-1.000000
hornHpX=-0.241750
tailX=-0.400000
yPod=-0.030000
battX=0.255000
battY=-0.052000
bayX0=0.300000
bayX1=0.450000
bayY0=-0.020000
bayY1=0.015000
bayZ=0.040000
canopyX0=0.157500
canopyX1=0.480000
canopyR=0.055000
canopyY=0.015000
mtow=7.437998
ailFrac=0.550000
ailSpan=0.616000
thick30=0.048364
pillarH=0.029525
pillarD=0.016000
pillarBoreD=0.016400
pillarNutDepth=0.011100
pillarSpot=0.002000
pillarSlotFloor=0.011362
wingBoltL=0.025000
joinBoreD=0.022455
legStock=2.438400
fast_F01=F01_M3x8_SHCS|SHCS|3|8|5.68|3|2.5|A2 (18-8) stainless|ISO 4762 M3x0.5 x 8 A2 (18-8) stainless: Motor to motor plate (4 lift + pusher), from below through the PA6-CF floor into the motor base
fast_F02=F02_M3x16_SHCS|SHCS|3|16|5.68|3|2.5|A2 (18-8) stainless|ISO 4762 M3x0.5 x 16 A2 (18-8) stainless: Split-clamp screws (motor mounts, tail clamps), stabiliser/fin shoe screws, provisional lift-prop screws
fast_F03=F03_M3x20_SHCS|SHCS|3|20|5.68|3|2.5|A2 (18-8) stainless|ISO 4762 M3x0.5 x 20 A2 (18-8) stainless: Gear clamp split screws
fast_F04=F04_M3x40_SHCS|SHCS|3|40|5.68|3|2.5|A2 (18-8) stainless|ISO 4762 M3x0.5 x 40 A2 (18-8) stainless: Boom splice cross-bolts (rear motor mount) and rear boom-clamp bolts to the wing hardpoint
fast_F05=F05_M3x30_SHCS|SHCS|3|30|5.68|3|2.5|A2 (18-8) stainless|ISO 4762 M3x0.5 x 30 A2 (18-8) stainless: Landing-leg retaining cross-bolt through gear clamp and leg
fast_F06=F06_M3x35_SHCS|SHCS|3|35|5.68|3|2.5|A2 (18-8) stainless|ISO 4762 M3x0.5 x 35 A2 (18-8) stainless: Front boom clamp bolts to the spar-collar hardpoint in the wing
fast_F07=F07_M3x8_BHCS|BHCS|3|8|5.7|1.65|2|A2 (18-8) stainless|ISO 7380-1 button head M3x0.5 x 8 A2 (18-8) stainless: Light-duty screws into inserts: pusher cup radial screws, canopy hatch, pitot clamp, FC tray (provisional)
fast_F08=F08_M3x12_SHCS|SHCS|3|12|5.68|3|2.5|A2 (18-8) stainless|ISO 4762 M3x0.5 x 12 A2 (18-8) stainless: Wing saddle to pod frame
fast_F09=F09_M5x25_BHCS|BHCS|5|25|9.5|2.75|3|A2 (18-8) stainless|ISO 7380-1 button head M5x0.8 x 25 A2 (18-8) stainless: Wing panel retention bolt (one per side, 70 % chord, through the saddle bolt pillar and the panel root tongue)
fast_F10=F10_M2x10_SHCS|SHCS|2|10|3.98|2|1.5|A2 (18-8) stainless|ISO 4762 M2x0.4 x 10 A2 (18-8) stainless: Servo mounting screws (provisional: servo tab hole size and spacing not published)
fast_F11=F11_M2x14_PAN|PAN|2|14|3.8|1.5|0|—|— M2x0.4 x 14 —: Control-horn screws (supplied with the horn kit, kit item 7)
fast_F13=F13_M3x8_SHCS|SHCS|3|8|5.68|3|2.5|— (supplied)|— M3x0.5 x 8 — (supplied): Pusher M6 bolt-on adapter to the X4110S hub: 4 screws supplied with the motor (maker drawing View A-A, dia 3.2 / dia 5.7 counterbores on dia 12). Length not published: 8 mm EST in the CAD (flange 5.0 EST, counterbore 3.0, engagement 6.0 < 8.0 limit)
fast_N01=N01_M3_Nylock|NYLOCK|3|4|5.5|0|0|A2 (18-8) stainless|DIN 985 nylon-insert lock nut M3x0.5, s 5.5 h 4
fast_N02=N02_M5_Nylock|NYLOCK|5|5|8|0|0|A2 (18-8) stainless|DIN 985 nylon-insert lock nut M5x0.8, s 8 h 5
fast_N03=N03_M2_Hex_Nut|HEXNUT|2|1.6|4|0|0|A2 (18-8) stainless|DIN 934 hex nut M2x0.4, s 4 h 1.6
fast_N04=N04_M6_Bullet_Nut|BULLET|6|19.5|10|12|0|steel (supplied with motor)|M6 x 1.0 bullet prop nut, supplied with the X4110S (height 19.5 from the maker drawing; across-flats EST 10)
fast_W01=W01_M3_Washer|WASHER|3.2|0.5|7|0|0|A2 (18-8) stainless|DIN 125 (vendor) M3 flat washer OD 7 ID 3.2 t 0.5
fast_I01=I01_M3_Insert|INSERT|3|5.7|4.6|0|0|brass, lead free|ruthex RX-M3x5.7 heat-set insert OD 4.6 x 5.7, hole 4 (knurl shown as two bands)
sched_F01=F01|ISO 4762 (DIN 912)|M3x0.5 x 8|20|30|J01 lift motor to motor plate (x4 motors, 4 each); J12 pusher motor to cup (4)|0.6|Loctite 242, one drop on the last 2-3 threads only; keep off the PA6-CF (TDS: not for thermoplastics)|Bolt Depot|6379|0.06
sched_F02=F02|ISO 4762 (DIN 912)|M3x0.5 x 16|36|50|J02 motor mount upper/lower clamp (4 per mount x4); J08 tail clamp to rear stub (4 per side); J09 fin shoe + stabiliser to tail clamp (2 per side); J03 lift prop plate to motor hub (2 per motor, provisional)|0.5|none (brass insert in plastic); witness mark|Bolt Depot|6382|0.06
sched_F03=F03|ISO 4762 (DIN 912)|M3x0.5 x 20|16|24|J06 gear clamp halves on boom (4 per clamp x4)|0.5|none|Bolt Depot|6383|0.07
sched_F04=F04|ISO 4762 (DIN 912)|M3x0.5 x 40|8|12|J04 boom splice at rear motor mount (2 per side); J05b rear boom clamp to wing hardpoint (2 per side)|0.5|none (nylock)|Bolt Depot|6387|0.15
sched_F05=F05|ISO 4762 (DIN 912)|M3x0.5 x 30|4|8|J07 landing leg in gear clamp socket (1 per leg)|0.5|none (nylock)|Bolt Depot|6385|0.1
sched_F06=F06|ISO 4762 (DIN 912)|M3x0.5 x 35|4|8|J05a front boom clamp to wing spar collar (2 per side)|0.5|none|Bolt Depot|6386|0.15
sched_F07=F07|ISO 7380-1 button head (vendor lists no standard; dims match)|M3x0.5 x 8|11|20|J12 pusher cup to pod tail ring; J13 canopy hatch to pod frame; J16 pitot clamp; J15 FC to tray (provisional)|0.4|none|Bolt Depot|7219|0.06
sched_F08=F08|ISO 4762 (DIN 912)|M3x0.5 x 12|4|12|J11 wing saddle root-plate flange to pod frame (4)|0.5|none|Bolt Depot|6381|0.06
sched_F09=F09|ISO 7380-1 button head (vendor lists no standard; dims match)|M5x0.8 x 25|2|6|J10 wing panel to saddle (1 per side)|0.5|none (nylock)|Bolt Depot|6636|0.21
sched_F10=F10|ISO 4762 (DIN 912)|M2x0.4 x 10|20|30|J14 servo to printed servo tray (4 per servo x5)|0.15|none|Bolt Depot|6365|0.12
sched_F11=F11|— (supplier states M2x14 only)|M2x0.4 x 14|10|0|J17 horn to aileron hardpoint (2 per horn x2); J17 horn through elevator and rudders with kit backplate (2 per horn x3)|0.15|none (nylon horn)|Amazon (kit item 7)|B0B58ZSC8J|0
sched_F12=F12|ISO 4762 (DIN 912)|M3x0.5 x 16|8|0|J03 JeeFly 1755 prop to X4110S hub (2 of the 4 M3 holes on the 12 mm circle)|0.8|Loctite 242 on the screw tip (metal into motor hub)|Bolt Depot (from F02 or F08 stock)|6382 / 6381|0
sched_F13=F13|— (supplied; ISO 4762 geometry assumed in the CAD)|M3x0.5 x 8|4|0|J03b adapter to pusher hub (4)|0.8|Loctite 242 (metal to metal)|SunnySky (in motor box)|—|0
sched_N01=N01|DIN 985 nylon-insert lock nut (vendor: hex nylon insert lock nut)|M3x0.5 x 4|8|16|J04 splice cross-bolts (4); J07 leg cross-bolts (4)|—|—|Bolt Depot|4792|0.07
sched_N02=N02|DIN 985 nylon-insert lock nut|M5x0.8 x 5|2|6|J10 wing bolts|—|—|Bolt Depot|4794|0.09
sched_N03=N03|DIN 934 hex nut|M2x0.4 x 1.6|30|100|J14 servo screws (20); J17 horn screws (10)|—|—|Bolt Depot|7362|0.0221
sched_N04=N04|M6x1.0 bullet (acorn) prop nut, supplied with motor|M6x1.0 x 19.5|1|0|J03b pusher prop on M6 adapter|—|—|SunnySky (in motor box)|—|0
sched_W01=W01|DIN 125 (vendor)|M3 7 x 0.5|28|100|J01/J12 motor screws (20); J04/J07 cross-bolt heads (8)|—|—|Bolt Depot|4513|0.0145
sched_I01=I01|ruthex RX-M3x5.7|M3 x 5.7|67|100||—|—|Amazon (ruthex)|B08BCRZZS3|0.0999
rodRudder=0.088354
rodAileron=0.056016
rodElevator=0.055594
discClear=0.106409
pushX=-0.441000
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
xcomp=Pitot_Tube|-0.050000|-0.027843|-1.300000|1,0,0,0,1,0,0,0,1
xcomp=Pitot_Clamp|-0.050000|-0.018343|-1.300000|1,0,0,0,1,0,0,0,1
xcomp=F07_M3x8_BHCS|-0.050000|-0.089843|-1.300000|1,0,0,0,-1,0,0,0,-1
xcomp=I01_M3_Insert|-0.050000|0.010657|-1.300000|1,0,0,0,-1,0,0,0,-1
