davinciucberkeley-collab/DillonVTOL/docs/figures/render_scenes.py

"""Photoreal renders of the test set-ups and the aircraft, built in Blender from the real CAD meshes.

Run with Blender 4.2 (Cycles, GPU when available):
    blender -b --factory-startup -P docs/figures/render_scenes.py -- [scene ...]
Scenes: studio, cg_weigh, tethered, thrust_stand, car_roof, proof_load (default: all).

Geometry: every part from cad/mesh/*.STL (metres, part frame), placed by its comp= record in cad/params.txt
(x, y, z and a 3 x 3 rotation, SOLIDWORKS frame: X forward, Y up, Z right) - the same data the review's 3-D viewer
uses, so the renders always match the model. Fixtures (scales, stand, stakes, sandbags, car roof) are simple modelled
props, sized from the test plan; they are illustrations, not designs.
Output: docs/figures/renders/<scene>.png and <scene>.json, the pixel position of each labelled feature, which
docs/figures/make_figures.py uses to place callouts on the render.
"""
import json, math, os, sys
import bpy
from mathutils import Matrix, Vector
from bpy_extras.object_utils import world_to_camera_view

ROOT = os.path.dirname(os.path.dirname(os.path.dirname(os.path.abspath(__file__))))
MESH = os.path.join(ROOT, 'cad', 'mesh')
OUT = os.path.join(ROOT, 'docs', 'figures', 'renders')
W, H = 1600, 1000
META = json.load(open(os.path.join(MESH, 'meta.json'), encoding='utf-8'))
# SOLIDWORKS Y-up to Blender Z-up: (x, y, z)_sw -> (x, -z, y)_blender
SW2B = Matrix(((1, 0, 0, 0), (0, 0, -1, 0), (0, 1, 0, 0), (0, 0, 0, 1)))


def comps():
    out = []
    for line in open(os.path.join(ROOT, 'cad', 'params.txt'), encoding='utf-8'):
        if not line.startswith('comp='): continue
        f = line.strip()[5:].split('|')
        r = [float(v) for v in f[4].split(',')]
        out.append((f[0], Vector((float(f[1]), float(f[2]), float(f[3]))), Matrix(((r[0], r[1], r[2]), (r[3], r[4], r[5]), (r[6], r[7], r[8])))))
    return out


# ---------------------------------------------------------------- scene set-up
def reset():
    bpy.ops.wm.read_factory_settings(use_empty=True)
    sc = bpy.context.scene
    sc.render.engine = 'CYCLES'
    try:
        prefs = bpy.context.preferences.addons['cycles'].preferences
        prefs.compute_device_type = 'OPTIX'; prefs.get_devices()
        for d in prefs.devices: d.use = True
        sc.cycles.device = 'GPU'
    except Exception:
        sc.cycles.device = 'CPU'
    sc.cycles.samples = 160; sc.cycles.use_denoising = True
    sc.render.resolution_x, sc.render.resolution_y = W, H
    sc.render.film_transparent = False
    sc.view_settings.view_transform = 'AgX'; sc.view_settings.look = 'AgX - Medium High Contrast'
    world = bpy.data.worlds.new('w'); sc.world = world; world.use_nodes = True
    bg = world.node_tree.nodes['Background']; bg.inputs[0].default_value = (0.30, 0.32, 0.35, 1); bg.inputs[1].default_value = 0.35
    sc.view_settings.exposure = -0.3
    return sc


_mats = {}
def mat(name, color, rough=0.45, metal=0.0, coat=0.0, alpha=1.0):
    key = (name, tuple(round(c, 3) for c in color), rough, metal, alpha)
    if key in _mats: return _mats[key]
    m = bpy.data.materials.new(name); m.use_nodes = True
    p = m.node_tree.nodes['Principled BSDF']
    p.inputs['Base Color'].default_value = (*color, 1); p.inputs['Roughness'].default_value = rough
    p.inputs['Metallic'].default_value = metal
    if coat: p.inputs['Coat Weight'].default_value = coat
    if alpha < 1:
        p.inputs['Alpha'].default_value = alpha; m.blend_method = 'BLEND'
    _mats[key] = m
    return m


def part_material(part):
    n = part
    if n.startswith(('Wing_Panel', 'Aileron', 'H_Tail', 'Elevator', 'Fin', 'Rudder', 'Fuselage_Pod', 'Wing_Saddle')):
        return mat('foam skin', (0.72, 0.74, 0.77), 0.35, coat=0.4)
    if n == 'Canopy': return mat('canopy', (0.05, 0.08, 0.13), 0.08, coat=1.0)
    if n.startswith(('Boom_Front', 'Boom_Rear', 'Spar_Tube', 'Wing_Joiner', 'Landing_Leg', 'Pitot_Tube')):
        return mat('6061 aluminium', (0.80, 0.81, 0.83), 0.28, metal=1.0)
    if n.startswith(('Lift_Prop', 'Pusher_Prop')): return mat('carbon prop', (0.03, 0.03, 0.035), 0.3, coat=0.6)
    if n.startswith(('Lift_Motor', 'Pusher_Motor')): return mat('motor', (0.09, 0.09, 0.1), 0.35, metal=0.8)
    if n.startswith(('Motor_Mount', 'Pusher_Cup')): return mat('PA6-CF', (0.13, 0.13, 0.14), 0.6)
    if n.startswith('Battery_6S'): return mat('battery', (0.12, 0.25, 0.55), 0.5)
    if n.startswith(('Flight_Controller', 'ESC', 'Receiver', 'GPS')): return mat('circuit board', (0.05, 0.22, 0.12), 0.4)   # electronics read as boards, not as printed parts
    if n[:1] in 'FNWI' and n[1:3].isdigit(): return mat('steel', (0.62, 0.63, 0.65), 0.3, metal=1.0)
    c = META.get(n, {}).get('c', [0.55, 0.57, 0.6])
    return mat('PETG ' + n, tuple(c), 0.5)


def crisp(me, angle=35):
    """smooth shading across shallow angles only, so machined edges stay sharp (CAD meshes are faceted)"""
    try:
        me.shade_smooth(); me.set_sharp_from_angle(angle=math.radians(angle))
    except AttributeError:
        for poly in me.polygons: poly.use_smooth = True
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
