davinciucberkeley-collab/DillonVTOL/(commit log)

2026-10-27 Cruise at 18 m/s, full re-analysis, step-by-step figures, 3-D results explorer
    - Cruise moved from 20 to 18 m/s (R11 lower bound) after benchmarking against
    22 published VTOLs and 37 literature values: aero package with SU2 re-run
    (239 W aero / 262 W sizing cruise, 17.3 / 15.8 min available), C0 SITL
    re-run 7/7, SOLIDWORKS thermal re-run (battery 64 -> 59 C, pusher 91 -> 80 C);
    docs, cards, test matrix and README carried to the new numbers.
    - 82 Blender step and test-setup figures with numbered callouts, 18 flight and
    procedure diagrams, wiring-step highlights; companion pages get
    tap-to-enlarge and the SVG data-URI type fix.
    - Review: sources register with link health, benchmark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
    [C0_BOM.csv, THERM_Lift_Unit.SLDPRT, THERM_Motor_Only.SLDPRT, THERM_Pod.SLDPRT, THERM_Pusher.SLDPRT, aircraft.csv, case.cfg, literature.csv]
2026-10-27 Whole-aircraft FEA and heat explorer, 18 m/s flow views, condensed simulation tabs
    - 3-D results explorer shows the whole aircraft: each SOLIDWORKS study field
    placed at its true location (boom arm at both front arms, spar/joiner at
    both roots, lift unit at all four motors, pod, pusher); other parts grey.
    - Pod thermal model: foam cylinder now runs aft from the pod nose (it was
    centred on it); re-run gives the same battery and FC temperatures.
    - "How the air moves over the wing" re-run at 18 m/s (SU2 2-D, VLM 3-D);
    aerodynamics.md section 11 updated.
    - Simulation and verification: 7 tabs condensed to 4; tab bars show a thin
    scrollbar when they overflow.
    - Figures: phone prop visibl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
    [THERM_Pod.SLDPRT]
2026-10-29 Full-aircraft 3-D CFD, validation matrix and claims map, cross-tool boom FEA, agent CLI
    - analysis/cfd3d: CAD-derived outer mould line, three gmsh half-model meshes
    (0.6/1.8/4.6 M tets), SU2 8.5 INC_EULER at 18 m/s (L2 alpha 0-8, L1/L3 alpha 4),
    independent post-processing (own force integration, Trefftz CDi, symmetry and
    far-field checks), 2-D scheme check against XFOIL inviscid, CFD claims.
    Meshes and flow fields are git-ignored (regenerable); configs, logs,
    histories, stats and results are kept.
    - Review: Aerodynamics "Whole aircraft: 3-D CFD" viewer (Cp/speed, streamlines,
    wake planes, symmetry slice, real mesh and volume cut, residual histories);
    new Validation chapter wit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
    [case.cfg, history.csv, history_leg1.csv]
2026-11-02 Proof chains, source and mesh audits, continuous 3-D CFD slice, 12-chapter site, CLI menu
    - analysis/validation/proofs.py: every claim split into equations, variables and
    sources; 29 claims re-run from the files they cite (28 reproduce, STR-05 does
    not); 33 claim-to-claim hand-offs value-checked (THM-01 h = 50 is stale against
    THM-02 42.9). source_audit.json (23 external sources checked value by value)
    and link_check.py (628 URLs).
    - analysis/cfd3d/mesh_audit.py: the three CFD meshes measured and scored against
    AIAA DPW-4/DPW-8, Celik 2008 and NPARC (10 pass, 29 fail, 15 n/a).
    - Review: Proof and validation chapter with proof cards (equations as MathML,
    substituted numbers, sourc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
    [build_matrix.py, link_check.py]
2026-11-02 2-D CFD tab: wing section only; vortex lattice becomes a cross-check line
    The flow view in the 2-D CFD tab also offered a "Whole aircraft, 3-D" view that
    was a vortex-lattice model, not CFD. That view is removed (its streamline data is
    no longer embedded); the vortex-lattice CL and induced drag now appear as a
    cross-check beside the full-aircraft CFD results.
2026-11-02 Claims re-audit: 37 Verified, 0 Failed; thermal at 25 C design ambient, CFD mesh rev 2
    - Thermal: design ambient 25 C (new R21), battery acceptance 6.0 mOhm/cell,
    FC heat 2.0 W with an 85 C limit; hand checks no longer hard-code 35 C.
    - CFD mesh rev 2 (L1-L3 re-run, rev 1 kept in out_rev1/): 2-D scheme check
    within 5 % of XFOIL; GCI reported as pre-asymptotic instead of a false band.
    - Fasteners: wing bolts M5 x 25 (Bolt Depot 6636), gear clamp M3 x 30 (6385);
    automated MFG-04 order-table check. BOM $1,854.55, reserve $145.45.
    - Firmware: BATT_LOW_MAH 1625 (25 %); MS4525DO airspeed, ARSPD_TYPE 1.
    - Structures: landing analysis, claims rewritten with reproduce-yourself steps.
    - Docs, te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
    [Aileron_L.SLDPRT, Aileron_L.STL, Aileron_R.SLDPRT, Aileron_R.STL, Battery_6S_LiPo.SLDPRT, Battery_Tray.SLDPRT, Bolt_Pillar.SLDPRT, Bolt_Pillar.STL]
2026-11-03 CFD level 4, Schrenk-moment FEA, CAD rebuild, claims synced to the resize
    - CFD L4 (23.3 M tets) converged at it 2517 after a warm restart; L2-L3-L4 GCI on CL 6.8 %
    - verify_cfd: CFD-07 reads the AVL neutral point from aero_results.json (was hard-coded);
    CFD-02 next step and limits; CFD-11 names the H-tail LE as where the overshoot grew
    - mesh_audit, scheme_check_2d, postprocess, viewer and site extended to four levels
    - FEA re-run on the Schrenk root moment; S01 proof schedule updated
    - CAD and drawings rebuilt on the current sizing; docs synced (322.3 mm chord, 7.438 kg)
    - 34 stale claims synced to the resize; AERO-31 BOM total 1854.55
    - Claims: 38 Verified / 40 Partially / 1 Unverified;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
    [Aileron_L.SLDPRT, Aileron_L.STL, Aileron_R.SLDPRT, Aileron_R.STL, Battery_6S_LiPo.SLDPRT, Battery_Tray.SLDPRT, Bolt_Pillar.SLDPRT, Bolt_Pillar.STL]
2026-11-03 CAD: 0 unexplained interferences, 0 drawing overlaps; MFG-02 and MFG-03 Verified
    - the four clash groups from 2026-11-02 fixed in the model or given a written disposition
    (was 31 unexplained, 393 mm3); modelled mass 6.688 -> 6.686 kg
    - drawing set rev F: layout fixes (was 23 overlaps), foam tolerance class and
    joiner coaxiality callouts
    - proofs, claims and site rebuilt; build log cad/build_2026-11-03.log
    [Aileron_L.SLDPRT, Aileron_R.SLDPRT, Battery_6S_LiPo.SLDPRT, Battery_Tray.SLDPRT, Bolt_Pillar.SLDPRT, Boom_Clamp_F_Lower.SLDPRT, Boom_Clamp_F_Upper.SLDPRT, Boom_Clamp_R_Lower.SLDPRT]
2026-11-03 cad/README: GA note 4 and title block are current (rev F, no ballast)
2026-11-03 Typeset claim equations; claims-map labels follow the selected component
    - analysis/validation/equations_tex.json: TeX form of all 159 plain-text claim equations
    (descriptions stay as text); proofs.py copies it into proofs.json and lists any gap
    - proofs.js: TeX subset gains \text, \mathrm, \left...\right (stretchy), \int, \le, \infty,
    ln/exp/cos, \bar, \quad; equation lists on proof cards and the claims map are typeset
    - style: formulas use a math font (Cambria Math, STIX Two Math fallback) so brackets stretch
    - claimsmap.js: choosing a component shows one label per claim on its parts;
    more than 10 labels are stacked in edge columns so none overlap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
2026-11-03 Viewable online: GitHub Pages entry, README with current numbers and links
    - index.html forwards to VTOL-Review.html; .nojekyll serves the files as they are
    - README: "View online" links for every document (GitHub's file view cannot show the
    29 MB review), and the current design numbers (chord 322.3 mm, MTOW 7.438 kg,
    issue 6, drawing rev F, budget $1,854.55, CFD and validation rows) with sources
    - docpage.mjs: "../" links from sources one folder down now resolve at the root
    (flight-software.html -> docs/research/firmware.md)
2026-11-03 Build manual and test plan: CAD clash fixes and drawing rev F
    - build manual: rudder rods 88 mm (were 107), left rudder servo 19 mm aft (x -0.899),
    pod hatch slots 30 mm, joiner coaxiality check (sheet 4 note 7), drawing rev F rows,
    open item 15 resolved, baseline CAD rebuilt 2026-11-03
    - test plan: R1 and the printer-offset test on rev F, open item 21 resolved,
    static margin 10.4 % (AVL)
2026-11-04 Team cross-check with DBF-VTOL; CAD rev G battery access
    Read the groupmate repo davinciucberkeley-collab/DBF-VTOL (77913e9, v0.3.1)
    and re-checked each finding against v0.4.0 (docs/research/team-crosscheck.md):
    - X1 battery sealed in the pod under 35 mm of foam, bay allowed only
    +-5 mm CG slide. CAD rev G: access well into the canopy pocket, 225 mm bay
    for the +-30 mm slide, 220 mm tray, FC tray forward to x +0.4075.
    Interferences unchanged, 0 drawing overlaps, dCG +0.12 mm (calc).
    - X2 ES3005HV stall 2.5 A at 6 V: five stalled 12.5 A vs the 8 A servo BEC;
    wiring.csv corrected, bench test added.
    - X3 X4110S 26 A / 30 s vs 27.7 A full throttle: set Q_M_SPIN_MAX from the
    thrust stan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
    [Aileron_L.SLDPRT, Aileron_R.SLDPRT, Battery_6S_LiPo.SLDPRT, Battery_Tray.SLDPRT, Battery_Tray.STL, Bolt_Pillar.SLDPRT, Boom_Clamp_F_Lower.SLDPRT, Boom_Clamp_F_Upper.SLDPRT]
2026-11-04 CI regenerate check: trade study follows the 2026-11-01 BOM; refresh aero.json
    tradestudy.mjs edited BOM lines that no longer exist: the SoloGood 45A ESC
    (now LANRC BLHeli_S 45A 4-pack, docs/research/bom-savings.md) and the
    X4110S spare motor (dropped to reserve cash in sizing.mjs). TR-tri keeps one
    4-pack (3 rotors + 1 spare); TR-bi and TS-duo remove the pack.
    Regenerated with the CI pipeline (sizing -> export_bom -> vlm -> verify ->
    tradestudy -> review build) on an LF checkout; results.json unchanged.
    - tradestudy.json: now closes on the 7.438 kg C0 (was 6.538 kg); C0 reserve
    $145.45 matches results.json. Feasible-R1 winner stays C0-b3.0; overall
    #1 stays TS-quad; TS-duo 7th -> 2nd.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
2026-11-04 Regenerate the review page after merging main (CAD rev G)
    main's copy of review/vtol-review.html and VTOL-Review.html carried the old
    trade-study and aero.json data; rebuilt with node review/build.mjs on an LF
    checkout so the CI regenerate check stays clean.
2026-11-04 AERO-10 proof follows the regenerated aero.json; validation refreshed
    The CI fix regenerated analysis/aero.json (wing CLa 4.54695 -> 4.54544 /rad,
    AR 7.45479 -> 7.44571). claims_aero.json AERO-10 quoted the old values;
    updated with a history entry (check +5.14 -> +5.18 %, still Verified within
    7 %). Re-ran check_aero/check_struct/verify_cfd/build_matrix/proofs:
    79 claims, 0 failed; 29/29 arithmetic re-runs and 33/33 hand-offs match.
    Review page re-embeds the validation data. CI pipeline replayed locally:
    analysis outputs match the committed ones, verify.py none failed.
